Skh4rf/satNOGS/README.md

# satNOGS
Contains the project files of our diploma thesis on the development and implementation of a satellite ground station based on the satNOGS open source hardware platform.
