Skh4rf/satNOGS/doc/documentation-files/Hauptteil.tex

\chapter{Hauptteil}
\section{Antennen}
\subsection{1. Antenne: Dipol}

\subsection{2. Antenne: QFH (Quadrifilar Helical Antenna)}
Die Quadrifilar Helical Antenna ist eine zirkular polarisierte, omnidirektionale Antenne, welche oft für Satellitenanwendungen verwendet wird.\\

Anhand des Abstrahldiagramms lässt sich erkennen, dass diese 

\subsection{3. Antenne: Helix-Antenne}
Direktional, hoher Richtfaktor

\input{Hauptteil-CCSDS}
