Skh4rf/satNOGS/doc/documentation-files/frontbackmatter/abkürzungen+hinweise.tex

\section*{Abkürzungen \& Hinweise}
\begin{singlespace}
	\begin{tabular}{ll}
		DA     & Diplomarbeit \\
		CAD    & Computer-aided design \\
		SI     & Internationales Einheitensystem \\
		CCW	   & counter-clockwise \\
		CW     & clockwise \\
		ADC	   & Analog-Digital-Converter \\
		GPIO   & General-Purpose Input Output \\
		PCB	   & Printed Circuit Board \\
		DC     & Direct Current \\
		LNA    & Low Noise Amplifier \\
		Schuko & Schutzkontakt \\
		LED	   & Light Emitting Diodes \\
		SDR    & Software Defined Radio \\
		SSH    & Secure Shell oder auch Secure Socket Shell \\
		API    & Application Programming Interface \\
		HTL    & Höhere technische Bundeslehr- und Versuchsanstalt \\
		ID     & Identifier \\
		QHA    & Quadrifilare Helixantenne \\
		UV     & Ultraviolettstrahlung \\
		PVC    & Polyvinylchlorid \\
		UTC    & Universal Time Coordinated \\
		TU     & Technische Universität \\
		VGA    & Variable Gain Adjustment \\
		LEO:   & Low-Earth-Orbit \\
		AHS:   & Allgemeinbildende Höhere Schule \\
		BHS:   & Berufsbildende Höhere Schule \\
	\end{tabular}
\end{singlespace}

\pagebreak
