Skh4rf/satNOGS/doc/documentation-files/frontbackmatter/bibliography.tex

\chapter{Literaturverzeichnis}
\vspace{1cm}

\printbibliography[heading=none]
