Skh4rf/satNOGS/doc/documentation-files/frontbackmatter/documentation-de.tex

\addcontentsline{toc}{section}{Diplomarbeit Dokumentation}
\section *{Diplomarbeit Dokumentation}

\begin{tabular}{@{}p{5cm}p{8cm}}
	Name der Verfasser & Ritter Gabriel, Metzler Jakob \\ & \\
	
	Jahrgang ~\textbar~ Schuljahr & 5AHEL ~\textbar~ 2023/24\\ & \\
	
	Thema der Diplomarbeit & Empfangsstation für globales Satellitenbodenstationsnetzwerk SatNOGS \\ & \\
	
	Kooperationspartner & TU Wien Space Team \cite{noauthor_sts1_nodate} \\ & \\
	
	Aufgabenstellung & Ziel der Diplomarbeit ist das Errichten einer Empfangsstation für den Empfang von Daten wissenschaftlicher Satelliten, sowie die dafür notwendige Konstruktion zweier Antennen. \\ & \\
\end{tabular}

\pagebreak

\subsection *{Individuelle Themenstellung im Rahmen des Gesamtprojektes}
\begin{tabular}{@{}p{5cm}p{8cm}}
	
	Ritter Gabriel & Es soll die für das Verständnis der Diplomarbeit benötigte Antennentheorie dokumentiert werden. Es soll ein Helix-Antennenarray mit vier Elementen berechnet, konstruiert und real aufgebaut werden. \\ & \\
	
	Metzler Jakob & Entwicklung, Konstruktion und Aufbau einer quadrifilaren Helixantennen, der Empfangsstation, der Rotor-Steuerung für die Nachführung des Helix-Antennenarrays und die Durchführung des Projektmanagements.  \\ & \\
	
	Realisierung & Realisiert an einer im Rahmen der Diplomarbeit entwickelten Empfangsstation mithilfe des SatNOGS-Netzwerkes \cite{noauthor_satnogshomepage_nodate}. \\ & \\
	
	Ergebnisse & Empfang von Daten wissenschaftlicher Satelliten.\\ & \\
	
	Einsichtnahmen & Archiv der HTL Rankweil, \newline www.diplomarbeiten.berufsbildendeschulen.at \\
\end{tabular}
