Skh4rf/satNOGS/doc/documentation-files/mainmatter/introduction.tex

\chapter{Einführung}

\label{chap:Einführung}
In diesem Kapitel werden die theoretischen Grundlagen der Antennen-und Leitertheorie gelegt sowie das SatNOGS Netzwerk näher erläutert.

\input{mainmatter/Theory/satnogs.tex}
\input{mainmatter/Theory/antenna-theory.tex}
\input{mainmatter/Theory/qha-theory.tex}
\input{mainmatter/Theory/helix-theory.tex}
