Skh4rf/satNOGS/doc/documentation-files/frontbackmatter/quotes.tex

\vspace*{4cm}

\begin{figure}[H]
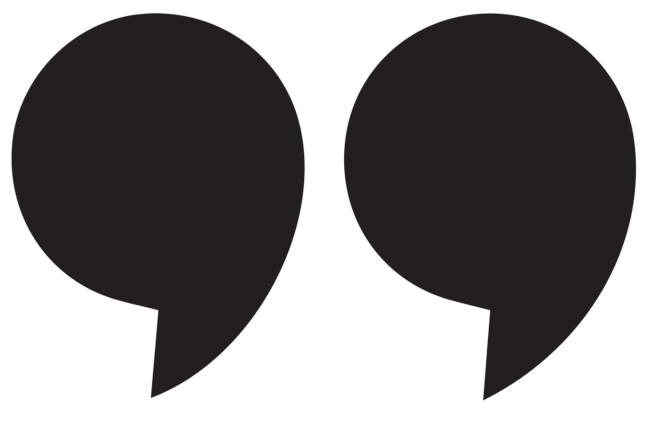
[picture p68: doc/documentation-files/figures/upper-quote-marks.png]
	
\end{figure}

\textit{$"$In der Welt der drahtlosen Kommunikation sind Antennen die Stimme, die ohne Worte spricht, aber dennoch eine universelle Sprache vermittelt."} \\

\rightline{Unbekannt}
\vspace{2cm}

\textit{"Von Anfang an übertraf Maxwells Theorie alle anderen an Eleganz und an der Vielzahl der Beziehungen zwischen den verschiedenen Phänomenen, die sie einschloss."}\\

\rightline{Heinrich Hertz}
\vspace{1cm}

\begin{figure}[H]
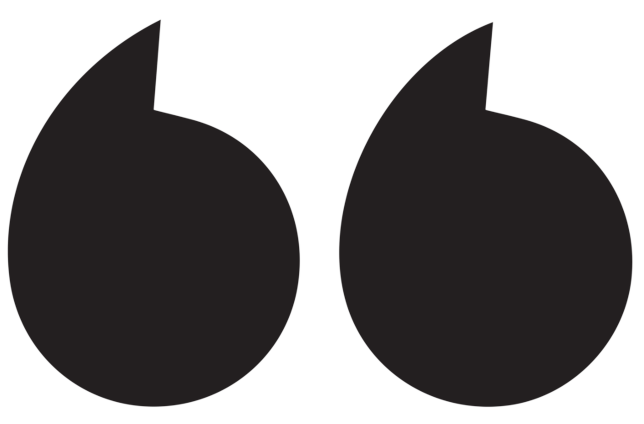
[picture p69: doc/documentation-files/figures/lower-quote-marks.png]
	
\end{figure}
