Skh4rf/satNOGS/doc/general-files/Ergebnisse der Anpassung.docx

# Antenne 3:

## SWR: 1.14

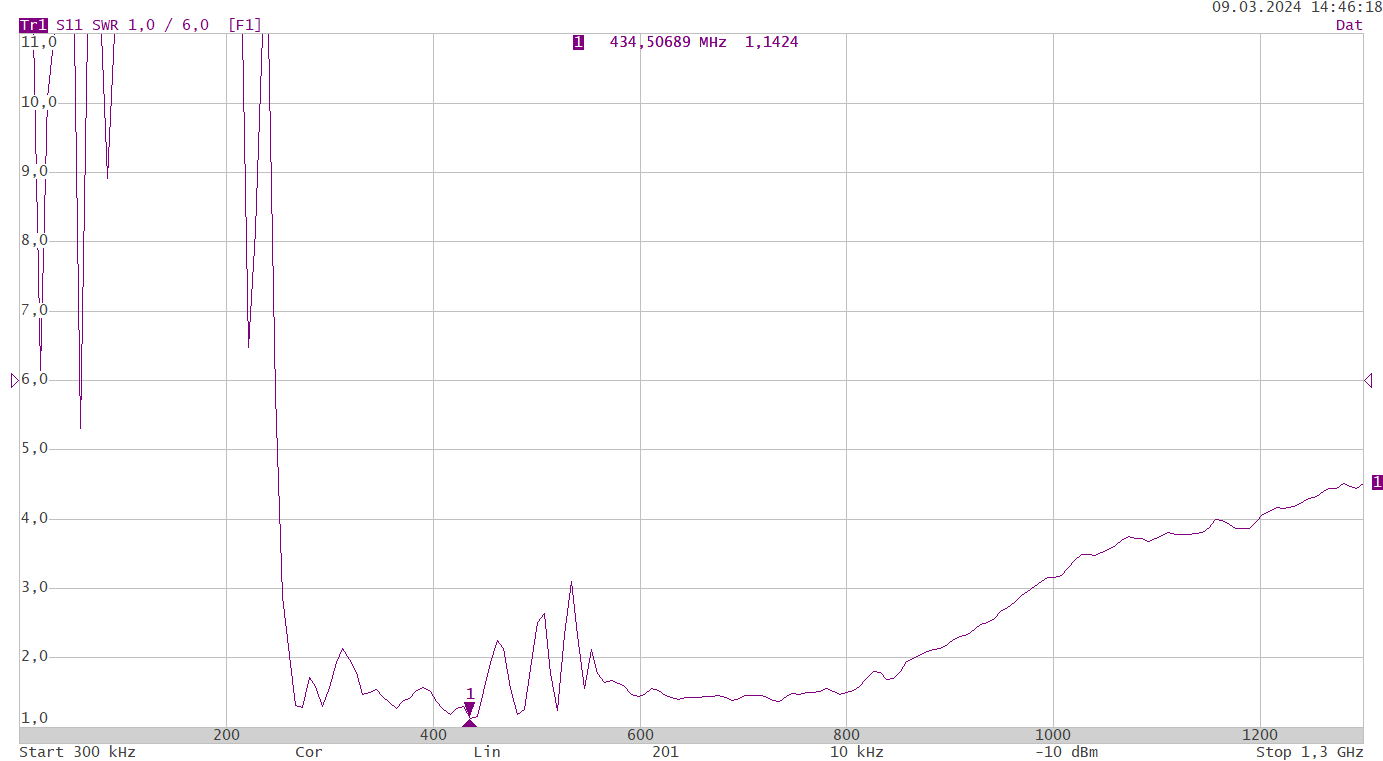
[picture p76: figure]

## S11: -24,6dB

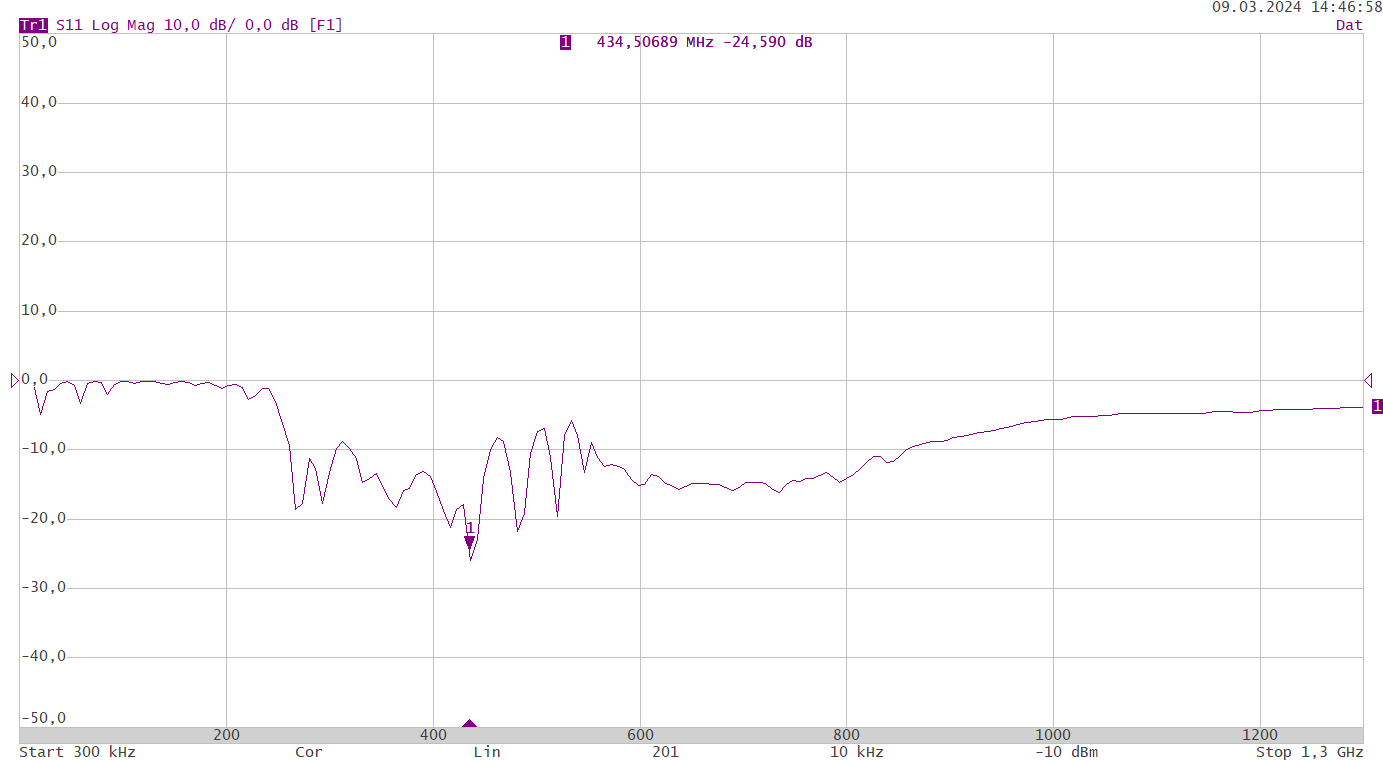
[picture p77: figure]

### Smith: 47, j*5,3Ohm

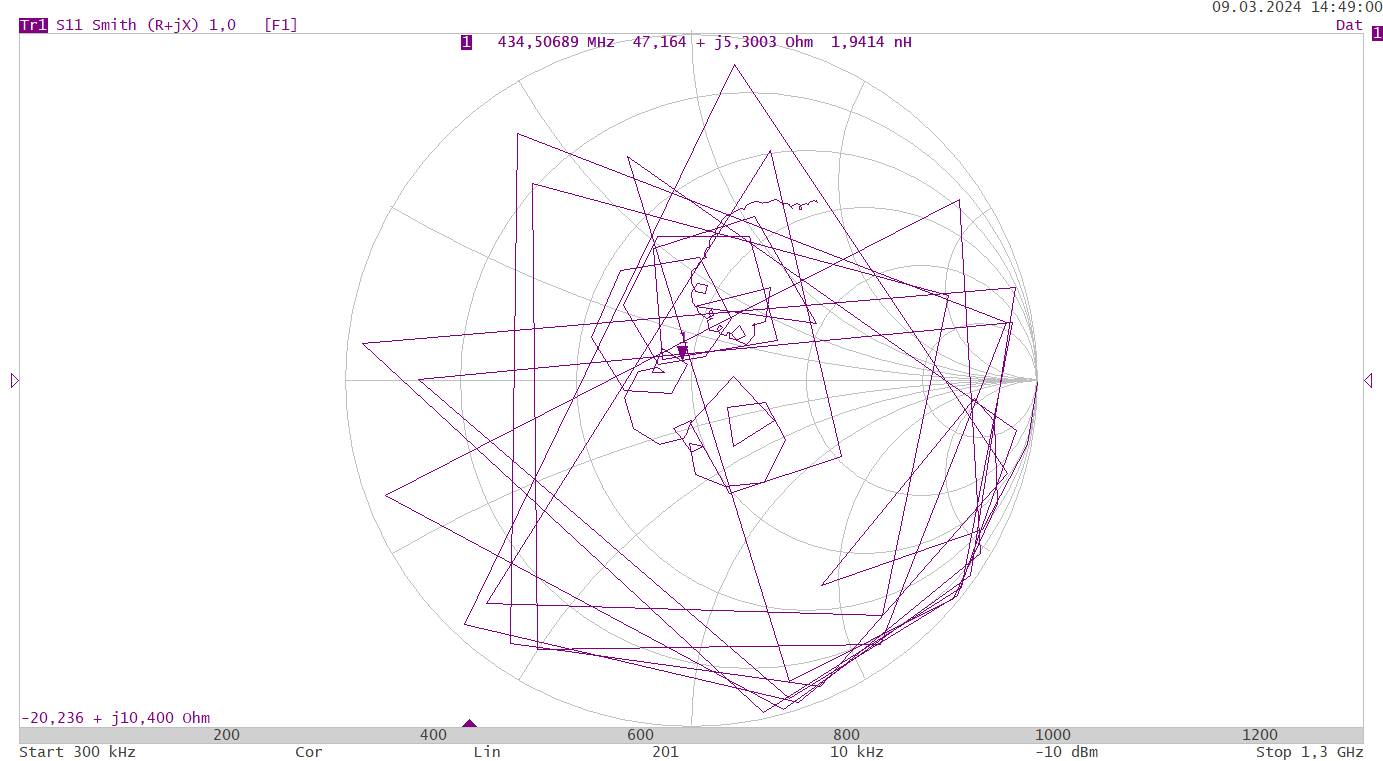
[picture p78: figure]

## Antenne 1

### S11: -21.5dB

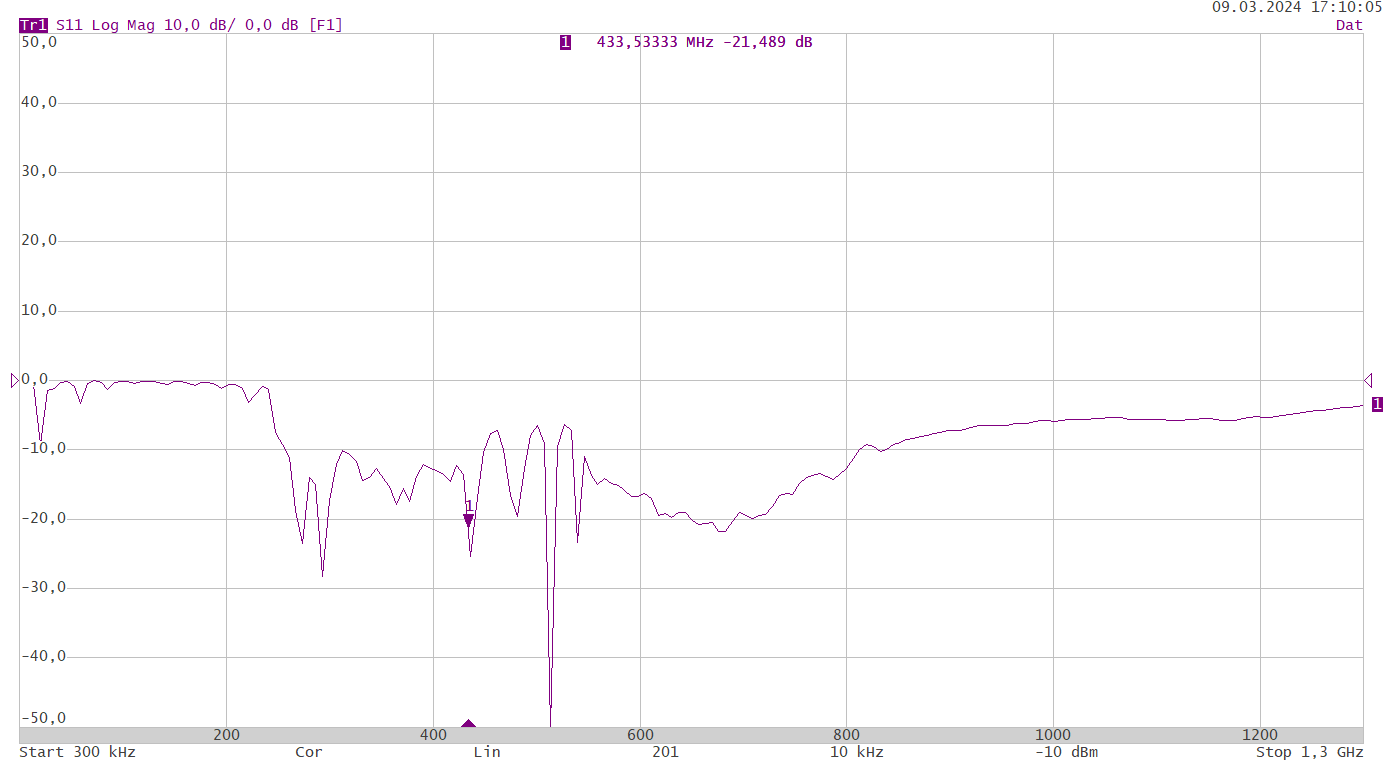
[picture p79: figure]

### SWR: 1.25

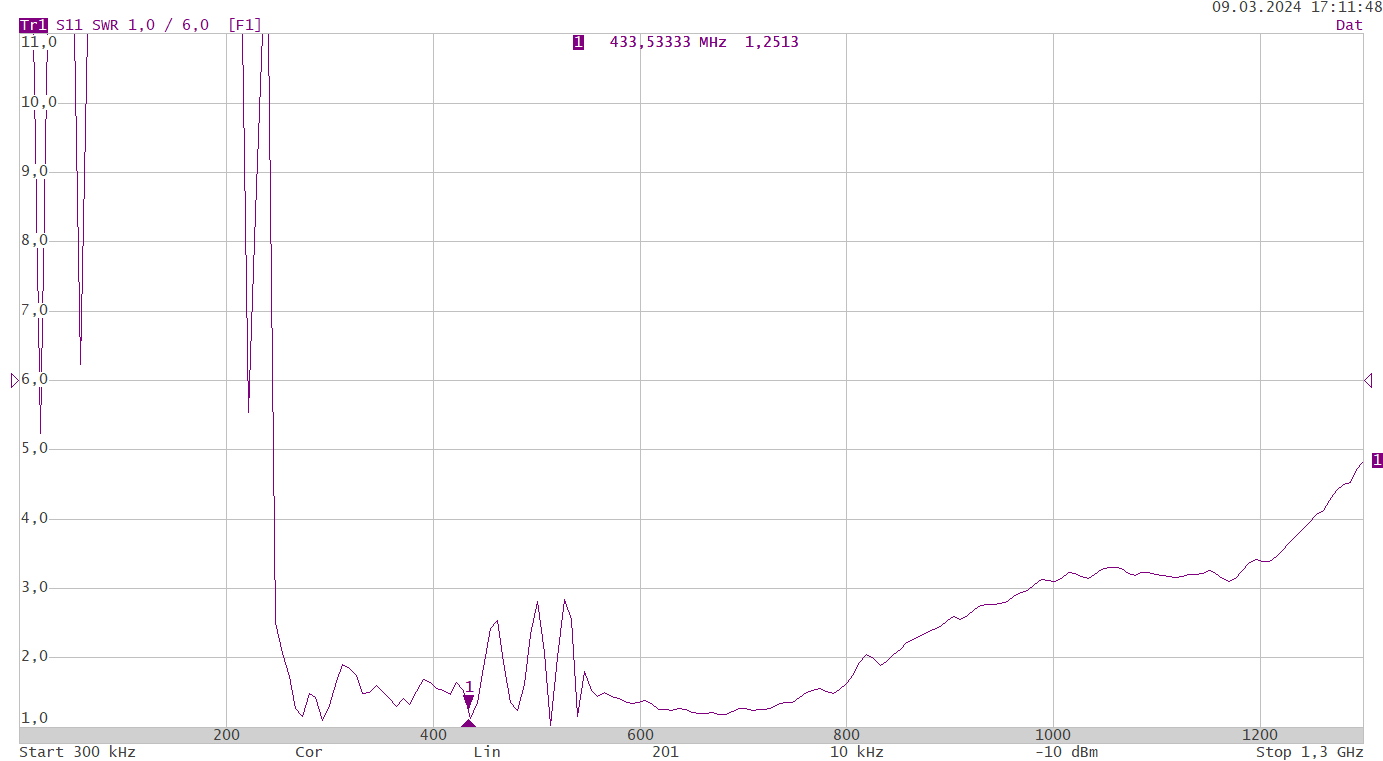
[picture p80: figure]

### Smith: 47.57 + j*10.031Ohm

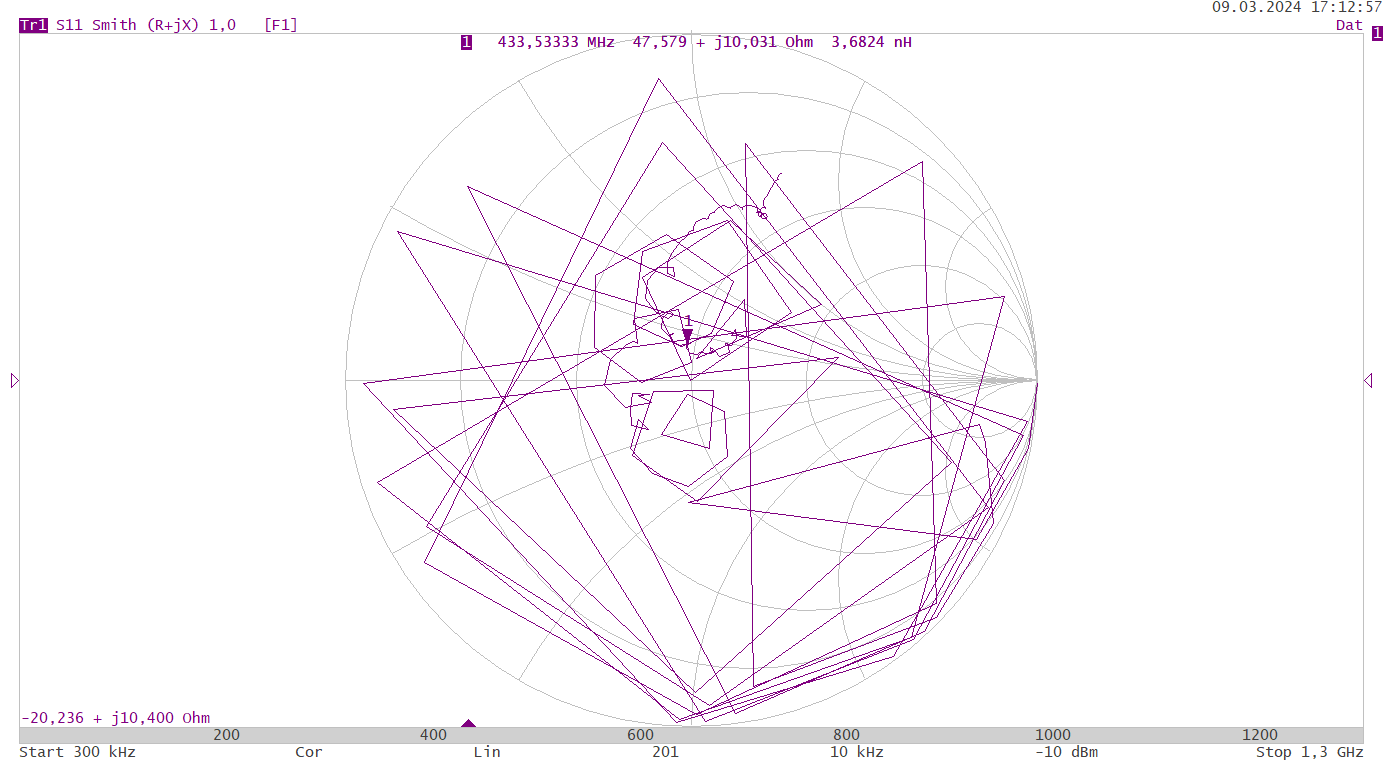
[picture p81: figure]

## Antenne 4

### SWR: 1.1

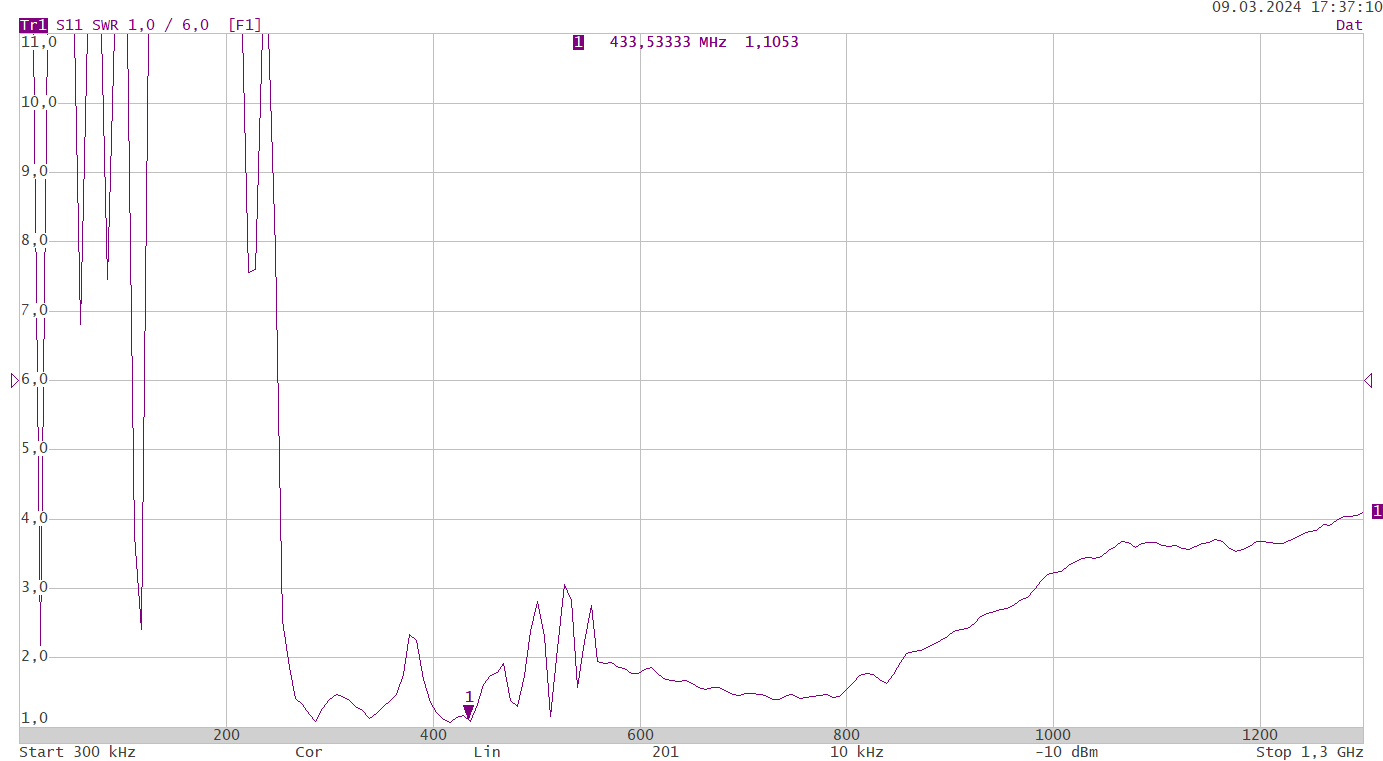
[picture p82: figure]

### S11: -26.7dB

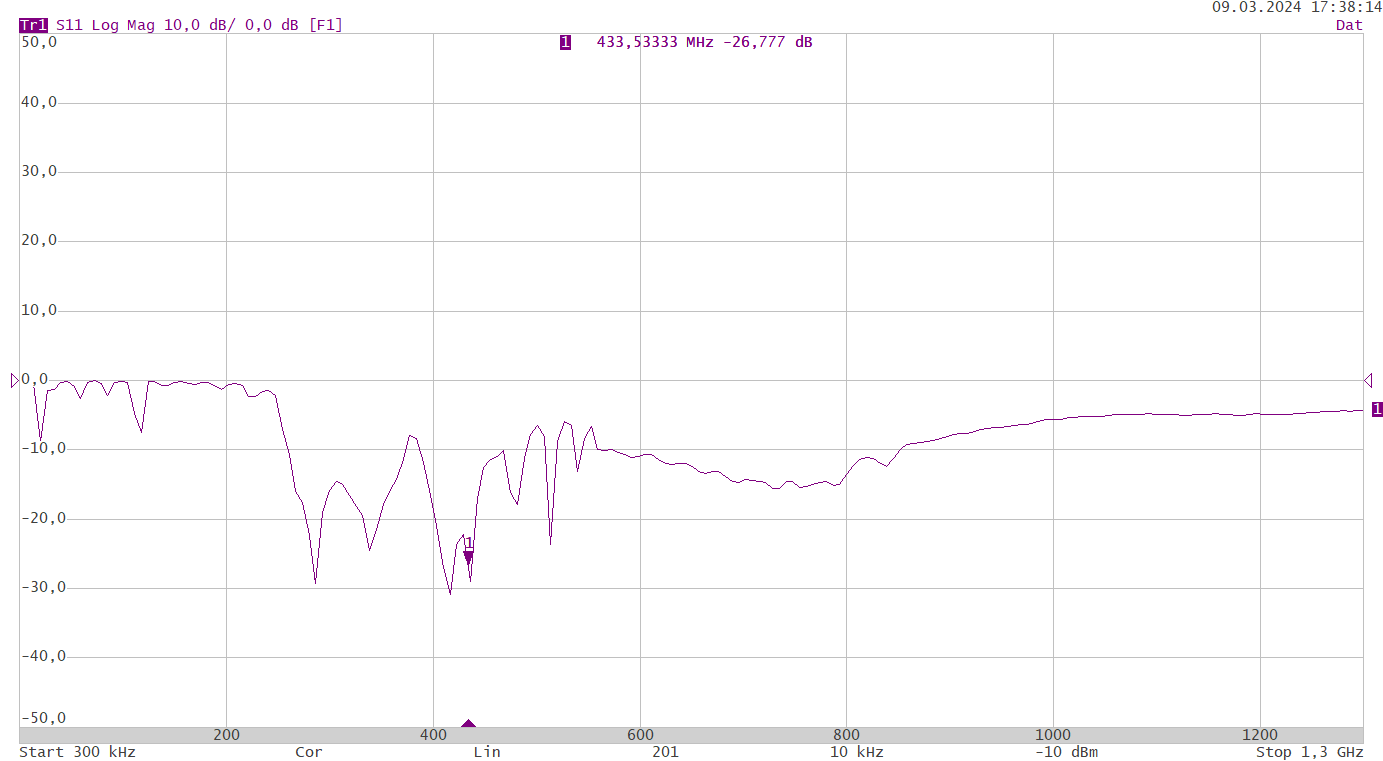
[picture p83: figure]

### Smith: 46 + 3.3Ohm

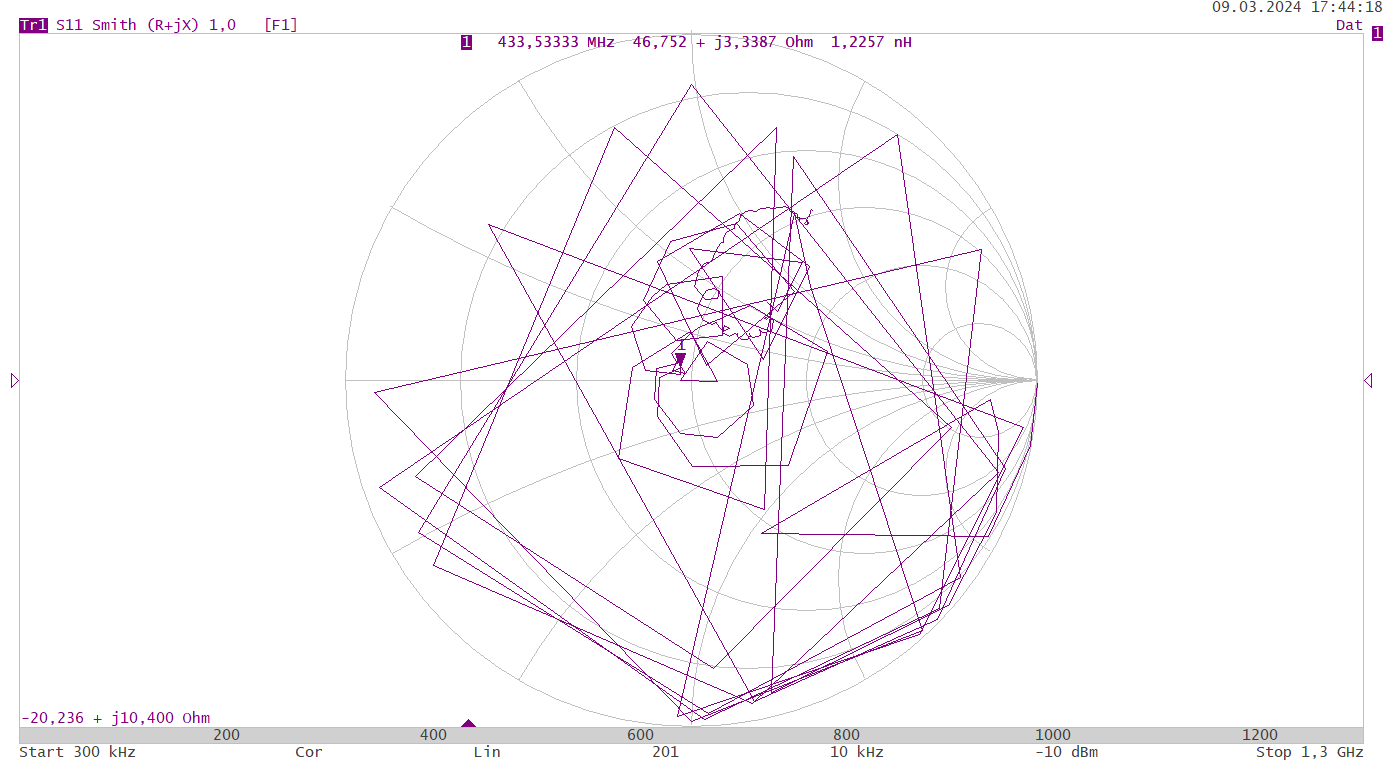
[picture p84: figure]
