Skh4rf/satNOGS/doc/general-files/Sts1PddSystemArchitecture_4.2.pdf

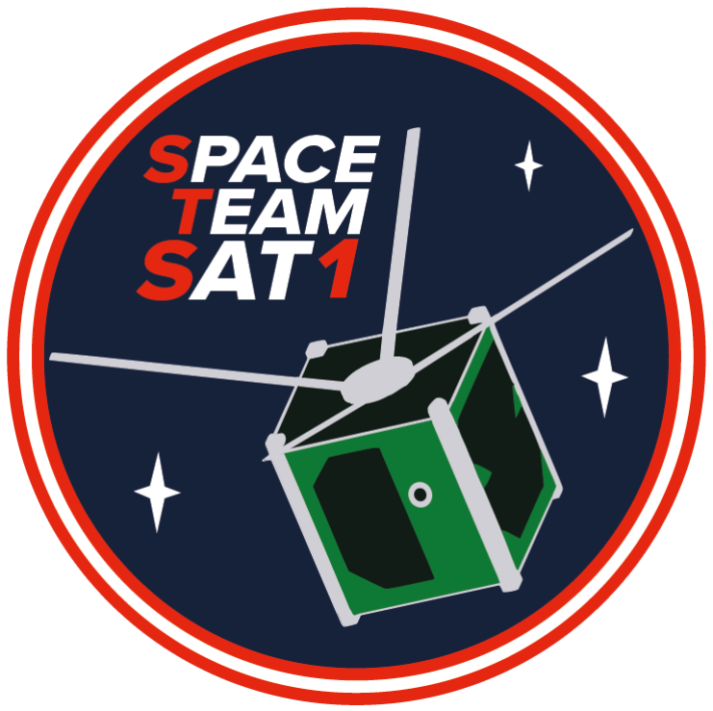
[picture p91: figure]

# SpaceTeamSat1 Preliminary Design Document System Architecture

03.04.2023

### Version 4.2

# Revision History

Revision | Date | Author(s) | Description
1.0 | 27.09.2020 | SpaceTeamSat1 | First draft: internal PDR
2.0 | 10.10.2020 | SpaceTeamSat1 | Implementations after internal PDR. Version sent to external reviewer.
2.1 | 17.10.2020 | SpaceTeamSat1 | Implementations before external PDR. EDU µC concept finished (but old EDU Reqs.). OBC not finished.
3.0 | 20.01.2021 | SpaceTeamSat1 | New mission design → Raspberry Pi approach.
3.1 | 07.02.2021 | SpaceTeamSat1 | Minor changes after PDR I: System Architecture.
4.0 | 21.08.2021 | SpaceTeamSat1 | Rework document in accordance to “Dataflow Game”.
4.1 | 14.04.2022 | SpaceTeamSat1 | Added system requirement 9.
4.2 | 03.04.2023 | SpaceTeamSat1 | Modify requirements 3.1, 5.3, 7.1, 7.2, 10.5 and 11.3 to fit with V1.0 of STS1 PDD: COBC SW. Improve citations.

ii

# Review History

The Preliminary Design Review (PDR) consists of two parts: First, this document itself and second, a review meeting in which the topics are discussed in person. In the following table the invited reviewers are listed. Additionally, it is stated if feedback to the document was received (DOC) as well as if the person participated in the PDR meeting (PDR).
Time and place of PDR: 28.01.2021 19:00 online
Contribution | Reviewer | Email | Justification
Current measurement is not use-ful. Always test like the CubeSat is in space. Antenna deployment shall not lead to a deadlock. | Dominik Kohl | dominik.kohl@schiebel.net | Pegasus/former TUST president
Prioritize on the first tasks. Al-ways have two firmware images on the CubeSat. | Lars Mehnen | lars.mehnen@technikum-wien.at | SSETI Ex-press/RF special-ist

iii

# Authors

Contribution | Name | Email
Project lead, COBC | Raphael Böckle | raphael.boeckle@spaceteam.at
Co-project lead, System Architecture | David Wagner | david.wagner@spaceteam.at
System Architecture, COBC | Jakob Riepler | jakob.riepler@spaceteam.at
System Architecture, COBC | Thomas Hirschbüchler | thomas.hirschbuechler@spaceteam.at
System Architecture | Patrick Kappl | patrick.kappl@spaceteam.at
System Architecture | Daniel Schloms | daniel.schloms@spaceteam.at
System Architecture | Paul Schmitt | paul.schmitt@spaceteam.at
EPS | David Freismuth | david.freismuth@spaceteam.at
EPS | Nikolas Thiel | nikolas.thiel@spaceteam.at
EDU | Jan Pac | jan.pac@spaceteam.at

iv

# Contents

1. Introduction | 1
2. System Requirements | 4
3. System Architecture | 12
A. Appendix | 34
Bibliography | 39

v

# List of Acronyms

1U | One-Unit CubeSat (10 × 10 × 10 cm³ and max. 1.33 kg)
ACK | Acknowledgment (signal)
ADCS | Attitude Determination and Control System
AHS | Allgemeinbildende Höhere Schule
ANT | Antenna System
AX.25 | A data link layer protocol
BHS | Berufsbildende Höhere Schule
CAM | Camera module
CCSDS A file transfer protocol
CDR | Critical Design Review
COM | Communication module
COTS | Commercial Off-The-Shelf
COBC | Communication Module and On-board Computer
CSI | Camera Serial Interface
DS | Deployment Switch
DT | Deployment Timer
EDU | Education module
eMMC | Embedded MultiMediaCard
EPS | Electrical Power System
ESA | European Space Agency
ESERO European Space Education
| Resource Office[1]
FEC | Forward Error Correction
FFG | Österreichische Forschungsförderungsgesellschaft (Austrian Research Promotion Agency) [2]
FRAM | Ferroelectric Random Access Memory
FRR | Flight Readiness Review
FX.25 | Protocol extension to AX.25
FYS | Fly Your Satellite! programme of ESA [3]
GNSS | Global Navigation Satellite System
GS | Ground Station
HAF | High-altitude flight
ISS | International Space Station
LEO | Low Earth Orbit
MCU | Microcontroller Unit
MOSFET Metal Oxide Semiconductor Field
| Effect Transistor
MPPT | Maximum Power Point Tracking
OBC | On-Board Computer
PCB | Printed Circuit Board
PD | Preliminary Design
PDR | Preliminary Design Review
SC | Solar Cells
RBF | Remove Before Flight pin
RF | Radio Frequency
RTC | Real-Time Clock
SatNOGS Satellite Networked Open Ground
| Station
SRAM | Static Random Access Memory
STS1 | SpaceTeamSat1 – name of CubeSat mission and CubeSat platform
SW | Software
UCI | Umbilical Cord Interface

vi

# 1. Introduction

This document serves as the system architecture Preliminary Design (PD) for the CubeSat mission SpaceTeamSat1 (STS1), which is designed by the TU Wien Space Team [4]. It describes the system architecture and presents the basic concepts of the key components of the CubeSat mission. From a functional point of view, the Electrical Power System (EPS) and the Communication Module and On-board Computer (COBC) are the most important components of the CubeSat. Therefore, the main focus lies on these components as well as the dataflow of the complete CubeSat mission – including the Ground Station (GS) infrastructure. More details regarding the dataflow were developed within the Dataflow Game, which is separately documented [5]. Since this document only serves as a PD for the system architecture, any solutions are subject to change once the design matures and test data is acquired. It needs to be considered that this CubeSat mission is divided into various milestones and that the space flight part is not defined in detail yet:
- Definition of System Architecture (PDR I)
- Definition of subsystems (EPS, COBC and EDU) (individual PDRs)
- Development of subsystems (individual Critical Design Reviews (CDRs))
- Definition of High-altitude flight (HAF) challenges
- HAF to verify CubeSat platform (Flight Readiness Review (FRR))
- Implementation of insights of high-altitude flight
- Preparation of the CubeSat mission for space flight
In Section 1.1 and Section 1.2, the mission statement and the main objectives, on which the CubeSat mission is based on, are presented. In Chapter 2, the top high-level requirements and most relevant system requirements of the mission are stated and described in more detail. These requirements are based on the mission objectives and build the base for the mission concept and the design of the CubeSat. In Chapter 3, an overview of the CubeSat system architecture and its subsystems is given. First, the dataflow from the Earth-based infrastructure to the CubeSat is evaluated for up- and down-link. This information is then used to derive the basic concepts of the subsystems. Note that a profound analysis of the dataflow was extracted by executing the Dataflow Game, which is documented in Ref. [5].

1. Introduction
Main properties of the CubeSat mission SpaceTeamSat1
- Mission and CubeSat name: SpaceTeamSat1 (short: STS1)
- 1U (10 × 10 × 10 cm³ and max. 1.33 kg) CubeSat platform
- STS1 shall operate in Low Earth Orbit (LEO) (350 km–500 km)
- STS1 shall be a lab for students of AHS and BHS
- STS1 shall enable access to the amateur radio community for students
- Educational mission objective:
– Student teams compete in a space-related coding competition.
– Python code which runs on the educational payload of the CubeSat (Raspberry Pi) platform. – Many possible software scenarios are possible. Therefore, various sensors are available for read-out.
– Gathered data is handed over to participating students for further evaluation of the received data.
– Student teams shall present their acquired results and therefore gain important insights into space-related technologies.
- The education module (EDU) with its sensors is the educational payload of the CubeSat:
– Temperature sensor
– Magnetometers
– Accelerometers
– Gyroscopes
– Dosimeter
– GNSS module
– Strain gauges
– Brightness sensors
– Cameras

1. Introduction

## 1.1. Mission Statement

Excitement and enthusiasm for engineering and science are important features of a progressive society. They are a consequence of the urge to explore the universe, which is deeply rooted in human nature. Nowadays, space technologies enable humankind to satisfy this urge and reach out further than ever before. However, even though space technologies are deeply ingrained within pop culture and organizations like NASA, ESA, or SpaceX successfully conduct widely publicized missions, a hands-on approach to these topics seems out of reach for most people. Therefore, we want to provide an entry point into space technologies for students of secondary schools by giving them the opportunity to run their own software experiments on our self-developed CubeSat platform, which is “Made in Austria”. We hope that this will broaden their educational horizon and thus inspire the next generation of space and science enthusiasts.

## 1.2. Mission Objectives

The mission objectives build the base for any space-related project as they give reasons why certain tasks need to be executed in space, which are mostly complex and costly. They state the relevance of the mission as well as its importance and allow the derivation of requirements and, later on, the design and operation of the CubeSat. The mission objectives for STS1 are separated into primary and secondary mission objectives, which indicate the relevance of the individual objectives.
Primary objectives:
1. To develop and build a working satellite
2. To operate our self-developed CubeSat
3. To give students a platform to run their self-developed software on a CubeSat
4. To inspire students to be part of a space project
Secondary objectives:
5. To take an image from space
6. To make the gathered data and insights available to the public and especially other CubeSat missions

# 2. System Requirements

The mission objectives build the base of any CubeSat mission, as described in Chapter 1, and are therefore used for the definition of the system requirements. The presented system requirements in this PD are high-level requirements with the goal of determining necessary subsystems which build the base of the CubeSat platform. All requirements shall be measurable and verifiable. Furthermore, requirements shall answer the “Why?” by specifying the “What?” and not addressing the “How?”. For nomenclature reasons, we use the same wording to formulate requirements as in the Fly Your Satellite! (FYS) design specification [3] by ESA:
- The word “shall” is used to express requirements that have to be met.
- The word “should” is used to express recommendations.
- The word “may” is used to express permissions.
Furthermore, we use the following to specify where a requirement is fulfilled:
- The quote “Fulfilled by” is used to express that a requirement is fulfilled by other sub requirements.
- The quote “Fulfilled in” is used to express that a requirement is fulfilled in a section within the same document.
The following mission requirements are derived from the mission objectives:
1 The CubeSat shall have a system to generate power and distribute it to all other subsystems. Note: It shall be possible that the CubeSat can be powered solely by the solar cells, solely by the batteries, respectively both. The power distribution is only active in the operation phase of the CubeSat mission.
Fulfilled: By 1.1, 1.2, 1.3, 1.4
2 The CubeSat shall automatically charge the batteries as long as there is excess energy available. Note: Excess energy is the difference between the power provided by the solar cells and the power needed to power the subsystems of the CubeSat.
Fulfilled: By 2.1
3 The CubeSat shall automatically transmit a beacon at least once every 30 seconds.
Note: Obviously, this can only be done if enough power is provided.
Fulfilled: By 3.1
4 The CubeSat shall be able to receive commands, when not transmitting data.
Note: The CubeSat shall portion large amounts of data before transmission. After a certain amount of transmitted data the CubeSat has a transmission dead-time, which can be used to receive commands.
Fulfilled: By 4.1

2. System Requirements
5 The CubeSat shall have a compact and interchangeable electronic stack.
Note: This should allow for easy interchangeability of different subsystems or a different payload in a possible future scenario.
Fulfilled: By 5.1, 5.2, 5.3, 5.4, 5.5
6 The CubeSat shall operate according to a predefined state chart.
Note: Special attention needs to be paid for the launch phase.
7 The CubeSat shall have a single master, which is the COBC.
Note: The master is the only subsystem that is able to initiate active communication with other subsystems on the CubeSat platform.
Fulfilled: By 7.1, 7.2
8 The primary ground station shall be able to send data and commands to the CubeSat. The primary ground station shall also be able to receive data from the CubeSat.
Note: The communication capabilities shall be verified by a HAF, where the CubeSat shall be placed in a weather balloon. Additional GSs should be able to receive data from the CubeSat. Fulfilled: By 8.1, 8.2, 8.3, 8.4, 8.5, 8.6
9 The EDU module shall be operable for at least 10 % of the mission duration. The maximum continuous uptime of the EDU shall be at least 3 h.
Fulfilled: By 9.1
10 The CubeSat shall be able to execute Python code, written by high school students. Fulfilled: By 10.1, 10.2, 10.3, 10.4, 10.5, 10.6, 10.7, 10.8, 10.9
11 STS1 shall comply with the FYS Requirements [3] where it makes sense.
Note: Where it makes sense and where it does not make sense will be noted in the lower level requirements.
Fulfilled: By 11.1, 11.2, 11.3 11.4

2. System Requirements
The following system requirements are deduced from mission requirement 1:
1.1 STS1 shall power all systems, via the CSBI, if enough energy comes from the SCs and once it reached the operational phase.
Fulfilled: By ?? [6]
1.2 STS1 shall have a mechanism in place to power all systems, via the CSBI, if there is enough energy in the batteries and once it reached the operational phase.
Fulfilled: By ?? [6]
1.3 Each Subsystem of STS1 shall be powered, via the CSBI, by a voltage level between 5 V and
8.4 V.
Note: This means that each subsystem is responsible for generating its own voltage levels, e.g. constant 5 V or 3.3 V.
Fulfilled: By 1.3.COBC.1 [7], 1.3.EPS.9 [6], 1.3.EDU.1 [8]
1.4 The power generating subsystem of STS1 shall provide a voltage level with a ripple lower than
100 mV.
Note: This means that each subsystem is responsible for generating its own voltage levels, e.g. constant 5 V or 3.3 V
Fulfilled: By 1.4.COBC.1 [7], 1.4.EPS.10 [6], 1.4.EDU.1 [8]
The following system requirements are deduced from mission requirement 2:
2.1 The CubeSat shall automatically recharge the batteries when there is spare energy. (TODO: make note)
Fulfilled: By ?? [6]
The following system requirements are deduced from mission requirement 3:
3.1 The CubeSat shall automatically send out a beacon at least once every 30 seconds, with a tolerance of ±5 s.
Note: Only if it has power.
Fulfilled: By 3.1.COBC.1 [7], 3.1.COBC_SW.1 [9]
The following system requirements are deduced from mission requirement 4:
4.1 The CubeSat shall always be able to receive a command in an acceptable amount of send time. Note: This means that the continuous sending is not allowed to take longer than about ten seconds. After this sending, the CubeSat must switch to a receive state where it waits for at least one second to receive a command.
Fulfilled: By 4.1.COBC_SW.1 [9]
The following system requirements are deduced from mission requirement 5:
5.1 The CubeSat shall have two bus connectors, which ensure communication between all the subsystems.
Note: Those bus connectors shall be located on opposite sides of the PCBs. This should allow for easier electric wiring on the PCBs.
Fulfilled: By 5.1.COBC.1 [7], ?? [6], 5.1.EDU.1 [8]

2. System Requirements
5.2 The CubeSat shall have a reusable satellite framework.
Note: This means that the hardware of the subsystems COM, EPS, and OBC shall work independently of the science payload (here: EDU module). However, software dependency is not prohibited.
Fulfilled: By 5.2.COBC.1 to 5.2.COBC.4 [7], ?? [6]
5.3 No subsystem that needs the CSBI X+ shall be located above the science payload PCB(s) (here: EDU module) in the electronic stack.
Fulfilled: In 3.1
5.4 The CubeSat shall have all subsystem PCBs which are not specifically needed for the science payload (here: EDU module) grouped together in the electronic stack.
Note: This does not include the possible side PCBs which are located on each side of STS1. Fulfilled: In ??
5.5 The CubeSat shall have an antenna release mechanism. The mechanism shall be controlled via the master and powered via the EPS.
Fulfilled: By 5.5.COBC.1 [7], ?? [6]
The following system requirements are deduced from mission requirement 7:
7.1 The CubeSat shall be able to deactivate all systems not necessary for communication once a command is received to do so.
Note: All subsystems for communication are EPS and COBC. (TODO: Communication –> GS to COM; Downstream/Upstream)
Fulfilled: In 3.1 and by 7.1.COBC_SW.1 to 7.1.COBC_SW.3[9], 7.1.EDU.1 [8]
7.2 The CubeSat should have a central processing unit (here: COBC) which deactivates the EDU, if it is not used in the next couple of minutes.
Fulfilled: In 3.1 and by 7.2.COBC_SW.1 to 7.2.COBC_SW.2[9]
The following system requirements are deduced from mission requirement 8:
8.1 The CubeSat shall be able to receive one full program code at least once every 24 hours. Note: One full program code stands for the maximum possible code size that can be flashed on the EDU µC, which is 1 MiB.
Fulfilled: By 8.1.COBC_SW.1 [9]
8.2 The GS shall be able to automatically send operation commands to the CubeSat.
Note: “Automatically” means that a program runs on a PC or µC.
Fulfilled: In ??
8.3 The GS shall be able to automatically upload data to the CubeSat.
Note: “Automatically” means that a program runs on a PC/µC. Fulfilled: In ??

2. System Requirements
8.4 The GS shall be able to automatically download data from the CubeSat and store it locally within the GS infrastructure.
Note: “Automatically” means that a program runs on a PC or µC.
Fulfilled: In ??
8.5 The GS shall be able to run autonomously for at least seven days.
Note: “Autonomously” means that it does not require any human action.
Fulfilled: In ??
8.6 STS1 shall be able to download the entire generated data of one student code at least once every 48 hours.
Note: The entire generated data is equivalent to the maximum data one student code generates during its whole run time, this is equivalent to the memory size in which the student code stores its data. This restricts the maximum amount of data and the number of photos a student code can produce, which is 1 MiB.
Fulfilled: In ?? and by 8.6.COBC.1 [7], ?? [6], 8.6.COBC_SW.1 [9]
The following system requirements are deduced from mission requirement 9:
9.1 The CubeSat shall have a higher average power input, measured over one full orbiting cycle, than the maximum average power drain from all the subsystems, also measured over one full orbiting cycle.
Note: For the rotation the worst expected rotation shall be used, after the detumbling phase. Maximum average refers to the maximum power drain a subsystem can have measured over one full orbiting cycle, e.g., the GS is below the CubeSat in the used cycle for the power drain calculation for the COM module. The detumbling phase ends when the change of rotation of the CubeSat falls below 1 %, measured over one orbiting cycle.
Fulfilled: By ?? [6]
The following system requirements are deduced from mission requirement 10:
10.1 The CubeSat shall have several sensors integrated within the CubeSat.
Note: This should attract more attention and make the mission more interesting for the students to participate in.
Fulfilled: By 10.1.EDU.1 [8]
10.2 The CubeSat shall have multiple cameras which are suitable for an operation in space.
Note: This shall allow the CubeSat to take images of Earth in all possible orientations. Fulfilled: By 10.2.EDU.1 [8]
10.3 The EDU should be able to recover from a small number of cosmic bit flips. Fulfilled: By ?? [8]
10.4 The EDU shall be able to gracefully handle errors.
Fulfilled: By ?? [8]
Note: Gracefully in this context means, that the system is able to forward recover from a wide range of errors and stay operational. In the worst case it may turn itself off and leave recovery to the COBC.

2. System Requirements
10.5 The EDU shall be controlled by commands from the COBC.
Note: When supplied with power, the EDU shall boot into an operational state and then wait for commands sent by the COBC. Communication follows a strict master–slave relationship between COBC and EDU.
Fulfilled: By 10.5.COBC_SW.1 to 10.5.COBC_SW.3 [9], ?? [8]
10.6 The EDU shall be able to deal with being turned off mid-operation.
Note: The EDU may be turned off any time if power gets low.
Fulfilled: By ?? [8]
10.7 The CubeSat team of the TU Wien Space Team shall be able to verify the student code, which was developed by the students on a Dev-Kit.
Note: This ensures that only fully functional code is executed on the CubeSat platform in Space. The Dev-Kit is a development environment, which contains the same sensors as mounted on the EDU module within the CubeSat. ”Same sensors” does not mean the same physical implementation. On the Dev-Kit, also virtual sensors can be used (e.g. libraries of the individual sensors, which behave equally). The Dev-Kit allows the student teams to develop and test their code on Earth.
Fulfilled: In ??
10.8 The student teams shall be tasked with one main objective, which their proposed code shall fulfill.

Note: By establishing co-operations with acknowledged institutions in Austria (e.g. ESERO) the school outreach is done to advertise the project so that student teams can participate in this space rallye.
Fulfilled: In ??
10.9 The CubeSat shall be in orbit for at least six months which include January 1st and June 30th, not dependent on the year and not dependent on the launch date.
Note: This range is chosen as it includes the second half of a school year in Austria. This allows us to gradually build up the knowledge of the students over the first half of a school year and run the student codes in the second half of the school year.
Fulfilled: In ??
The following system requirements are deduced from mission requirement 11:
11.1 The CubeSat shall comply with the mechanical FYS Requirements [3] where it makes sense. Note: Where it makes sense and where it does not make sense will be noted in the lower level requirements. This system requirements include
a) Physical Requirements,
b) Environmental Requirements
Fulfilled: By 11.1.COBC.1 to 11.1.COBC.2 [7], ?? [6], 11.1.EDU.1 to 11.1.EDU.2 [8]
11.2 The CubeSat shall comply with the electrical FYS Requirements [3] where it makes sense. Note: Where it makes sense and where it does not make sense will be noted in the lower-level requirements. This system requirements include
a) Subsystem Requirements

2. System Requirements
Fulfilled: In ?? and by ?? [6], 11.2.EDU.1 [8]
11.3 The CubeSat shall comply with the software and RF related FYS Requirements [3] where it makes sense.
Note: Where it makes sense and where it does not make sense will be noted in the lower-level requirements.
Fulfilled: By ?? [6], 11.3.COBC_SW.1 to 11.3.COBC_SW.2 [9]
11.4 The STS1 mission shall comply with the mission related FYS Requirements [3] where it makes sense.
Note: Where it makes sense and where it does not make sense will be noted in the lower level requirements. This system requirements include
a) Accessibility,
b) Configuration Control,
c) Operational Requirements,
d) Ground Processing Requirements,
e) Ground Support Equipment,
f) Space Debris Mitigation Requirements,
g) Regulatory Requirements,
h) Safety Requirements
Fulfilled: In ?? and by ?? [6], ?? [8]
See: Nextcloud/Literature/ESA FYS3/6. FYS CubeSat Requirements/FDSv3.0 - Compliance Matrix
- STS1.docx
FYS–subsystem requirements
1. During the operation phase the CubeSat should rotate slow enough, so that the cameras are able to capture sharp images of the Earth while flying over the side which gets sun exposure. Note: Sharp means that the rise distance between two distinct features (e.g. an edge between land and water) on the image shall be < 1 % of the image’s width and height resolution. EDU–subsystem requirements:
1. The evaluated data is processed by the student teams and a presentation is given. This allows to set up a space-themed competition for the participating student teams.
COBC SW–subsystem requirements:
1. The CubeSat shall be able to deactivate all systems not necessary for communication once a corresponding command is received.
Note: Relevant subsystems for communication are the EPS and the COBC.
2. The CubeSat shall be able to re-flash its own main processing unit (here: COBC). This shall be implemented without any instructions needed from the processor which gets re-flashed.
Note: This allows updating the main processing unit if the software gets destroyed in any reversible way, e.g. interference by high-energy particles.
EPS–subsystem requirements:

2. System Requirements
1. The power supply shall be able to power the CubeSat for at least 65 % of a full orbiting cycle without the need of charging, while all the subsystems consume the maximum allowed power. Note: This will provide enough power with a safety factor of roughly two. Maximum allowed power refers to the maximum expected power consumption of each subsystem, e.g., COM module flies over the GS and communicates with the GS as fast as possible.
2. The CubeSat RF design shall either have one RF inhibit and a RF power output no greater than 1.5W at the transmitter antenna’s RF input OR the CubeSat shall have a minimum of two independent RF inhibits [empty citation](CDS 3.3.9) [empty citation](ISO 5.5.6).
Note: An inhibit is considered to be a physical power interrupt device. A control for an inhibit (electrical or software) cannot be counted as an inhibit.
Note: The use of three RF independent inhibits is highly recommended as it may help to ease further discussions with the launch authority.
Note: RF inhibits may be combined with electrical inhibits.
Fulfilled: In ??

# 3. System Architecture

The following chapter discusses the basic concepts of the individual subsystems of STS1, namely the Electrical Power System (EPS), the Communication Module and On-board Computer (COBC) and the Education module (EDU). As the received and transmitted data build the base of the whole CubeSat platform, Section 3.3 describes the dataflow from the ground infrastructure to the CubeSat in more detail. In a next step the EPS – power generation and distribution – is investigated. Therefore, Section 3.4 discusses the conceptual design of the EPS in more detail. In a next step the COBC is presented in Section 3.5. The COBC is the main processing- and scheduling unit of the CubeSat and also handles the RF communication. Finally, Section 3.6 describes the concept of the EDU. This subsystem is the educational payload of the CubeSat mission and therefore executes the software experiments that are provided by the individual student teams. The EDU is equipped with multiple sensors, including two cameras (CAM), to perform various experiments.

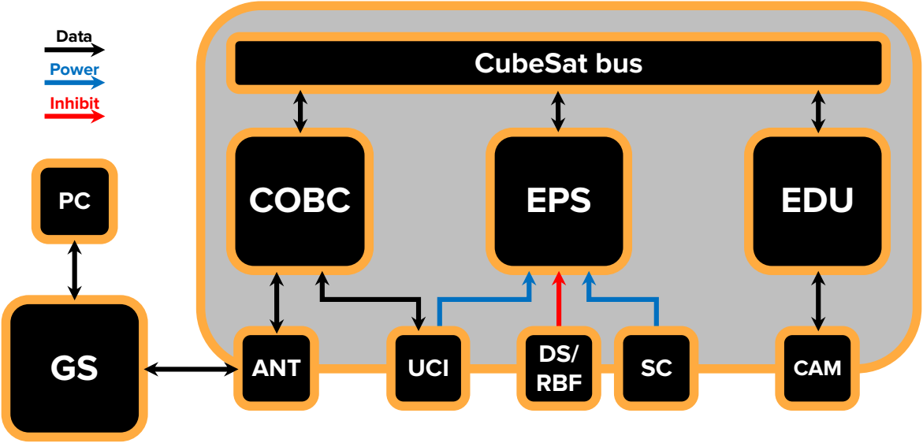
[picture p92: figure]
CubeSat bus; COBC; ANT; EPS; EDU; RBF GS; UCI; CAM; Inhibit; Power; Data

Figure 3.1.: Basic system architecture of STS1. The arrows determine the direction of data- (black), power- (blue) and inhibit-flow (red). Figure 3.1 shows the basic system architecture of the CubeSat and the associated ground infrastructure. The Antenna System (ANT) is used to communicate with the COBC, which contains the RF module for receiving and transmitting data. The Solar Cells (SC) are directly connected to the EPS and are used to harvest electrical energy. The main Ground Station (GS) can be accessed from any PC on Earth via Internet. The Umbilical Cord Interface (UCI) allows us to re-program the COBC and charge batteries, which are operated by the EPS, after assembling the CubeSat. The Deployment Switches (DS) and the Remove-Before-Flight pin (RBF) ensure that the CubeSat is not powered in the safely stored configuration (e.g. in the chassis of the carrier rocket or in the extractor of the International Space Station (ISS)). Within the EDU module, the Camera module (CAM) can receive image acquisition commands.

3. System Architecture

## 3.1. STS1 System Layout

This Chapter is still tbd, currently it contains raw information not polished in any way.
There is only one electronic stack in the CubeSat, which contains all the subsystem PCBs, excluding some special PCBs which need to be assembled to the mechanical structure and excluding the SidePCBs. Starting in positive direction of the Z-axis the stack is ordered as follows: COBC, EPS, EDU, additional PCBs for other sensors.
There is an ”EDU_EN” pin on the CSBI X- which is controlled by the COBC, this pin activates or cuts the power supply for the EDU. There is another pin ”Dosi_EN” which is on the CSBI X-, this pin activates or cuts the power supply for the Dosimeter.

## 3.2. DCDC

The dcdc converter shall convert the battery voltage to a voltage level usable for the electronics. The design of this dcdc converter is shared between the boards and each board that requires voltages other than the unregulated battery bus voltage has its own dcdc converter.

### 3.2.1. Requirements

Since the design is shared between the boards, the converter must handle all the requirements of all boards. The lowest possible battery bus voltage is given as 5V and the output voltage requirements are 5V with 3A output current.

### 3.2.2. Design

The chosen dcdc converter is the MP28167GQ by Monolithic Power Systems. This converter can supply up to 3A and has a fixed output voltage of 5V with a maximum input current of 4A. The converter is a buck boost converter so it can supply 5V even if the bus voltage drops slightly below 5V due to voltage losses in the supply lines.
The design implements a undervoltage lockout which is set to about 3.99V and a startup voltage of about 4.4V, this ensures that the input voltage is in an usable range for the converter to deliver 15W output power, however the EPS is considered to shutdown the systems on such a low bus voltage anyways. A overcurrent protection is also present which is set to 3.56A, this limits the bus and output current in case of a short circuit or other overcurrent fault and ensures that other components would still work if such a condition is present so that the other systems would be able to handle the fault. To handle spurious overvoltage situations, such as electrostatic discharges, a TVS diode is placed in the 5V rail as well as in the input rail of the dcdc converter, to protect the converter itself and also the electronic on the 5V rail. An optional snubber at the input voltage formed with a 1uF MLCC and a 100 milliohms resistor was also added to the design to suppress supply voltage ringing. This snubber is not populated in the current design, but could be populated if needed.

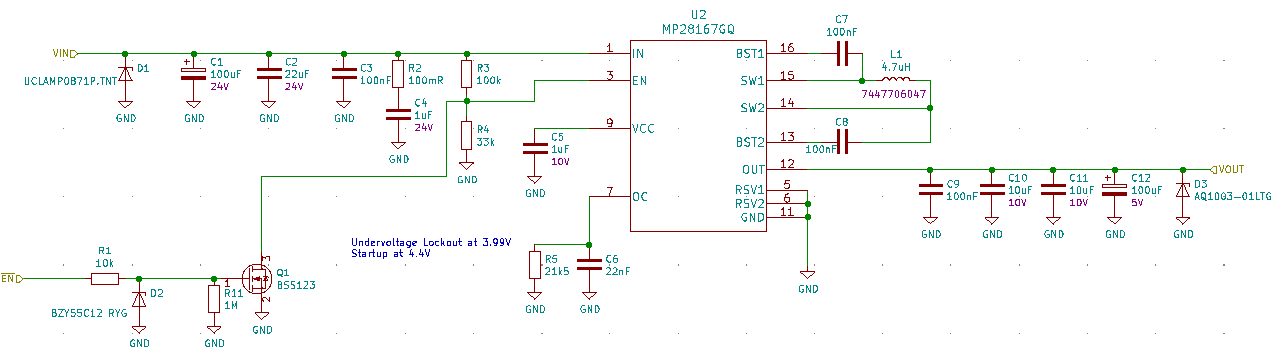
[picture p93: figure]

Figure 3.2.: Schematic of the dcdc converter

## 3.3. Dataflow

This section discusses the flow of data and commands from the ground infrastructure to the CubeSat and its internal subsystems. The main GS with the amateur radio call sign OE3HMW (operated by Dr. Lars Mehnen) is primarily used to communicate with STS1. On the GS runs CouchDB [10], which buffers all commands and data until the CubeSat can be reached and the relevant data can be transmitted to the CubeSat respectively received. Furthermore, the GS uses Gpredict [11] to determine the timeframe when a RF communication link to the CubeSat can be established.
The following subsections discuss the basic deliberations of the dataflow processes. It needs to be considered that this approach is a preliminary design and needs iterations as further definitions of the hardware and software design are done. Therefore, a dataflow scenario game will be implemented, which allows us to simulate the dataflow by a pen-and-paper game procedure. Such a tool helps us to investigate any circumstances at an early stage of the development of the mission. Note that the following subsections present a starting point for these considerations and further definitions will be implemented at upcoming stages of the mission.

### 3.3.1. Protocol

As the RF communication should attract the amateur radio community, AX.25 (FX.25) or CCSDS protocols are considered to be used for communicating with the CubeSat. Both protocols provide similar functionality and have different strengths. As both protocols do not provide an application layer protocol, custom software will be necessary for packet decoding anyways, which dampens the “well known protocol”-argument by a bit. Currently, we are still evaluating which of those two options (or a mix of them) is best suited for the STS1 mission. The final decision will be made as soon as the hardware and software topology of the COBC is defined in a more confident matter.

AX.25

The amateur radio “standard” AX.25 based protocol stack mainly provides a well-known protocol and will probably aid with adoption in the amateur radio community. However, it was not built with space links in mind, which requires special considerations to support this highly asymmetric link topology.

CCSDS

The CCSDS protocol stack on the other hand was built specifically with space links and their quirks in mind, providing convolutional channel coding and Forward Error Correction (FEC) for improved error immunity.

Interoperability, Security Measures

To prevent others from hijacking (taking control of) STS1, only packages signed by the TU Wien Space Team are accepted by the CubeSat. This means that other interested amateur radio operators could establish an uplink as well, if the signature is shared. To increase the downlink capabilities, it is considered to cooperate with SatNOGS [12]. If so, the SatNOGS stations would increase the reception area of STS1. An additional self-built SatNOGS station would furthermore allow to create an additional educational platform for students and the TU Wien Space Team. The downlink is neither signed nor encrypted¹
, enabling everyone in the amateur radio community to receive beacons and other data from STS1. This helps to increase the area of reception, which is especially useful when downloading big amounts of data. However, it needs to be considered that a proper management of the acquired data needs to be implemented.

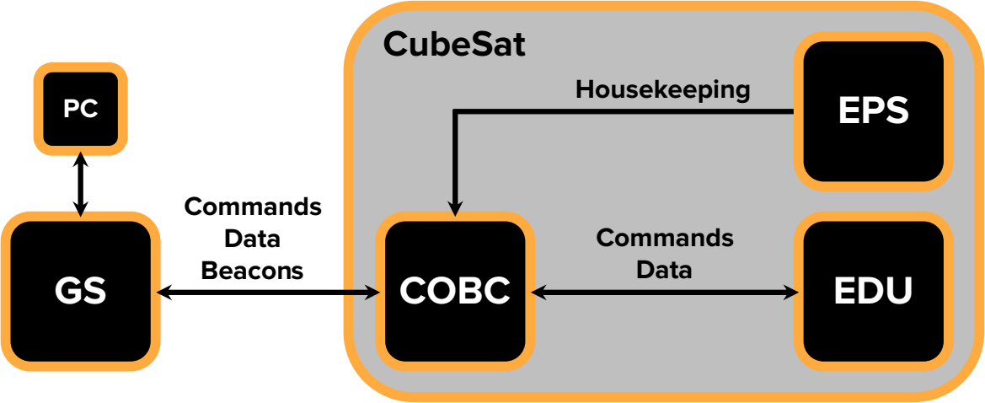
[picture p94: figure]
COBC; EDU; Commands Data Beacons; Commands Data; Housekeeping; CubeSat; EPS

Figure 3.3.: High-level dataflow diagram of STS1. Additionally, the relevant datatypes are mentioned for each data-link between subsystems.

### 3.3.2. Beacons

The CubeSat shall periodically broadcast housekeeping data (beacons) at least once a minute. However, it is targeted to increase the number of beacons per minute significantly. For this, the Microcontroller Unit (MCU) on the COBC gathers housekeeping data from sensors which are located on the EPS and on the COBC. The data is subsequently stored on the external COBC memory. Before a transmission to the GS, the COBC prepares the beacon for a broadcast by the RF module. Additionally, the beacon data will be stored in the external COBC memory over long periods of time, so that a history of beacon data can be requested by an appropriate command from the GS. Thus, history data can be obtained and evaluated easily.
These beacons can be received by any GS in range of the CubeSat at the broadcasting time. They include telemetry, housekeeping and operation status data.

### 3.3.3. Uplink

The GS can send signed commands and data via an RF uplink to the RF module of the COBC. The MCU on the COBC interprets these commands and data, and reacts accordingly. Commands will always rely on some sort of acknowledgment. Note that, e.g. CCSDS already has an ACK mechanism implemented.
In the following, the different data types which can be transmitted by the GS to the CubeSat are listed:

COBC firmware update

If a COBC firmware update is transmitted to the CubeSat, the MCU stores it in the external memory of the COBC. Afterwards, a command to the CubeSat is able to trigger a reset of the MCU and causes

1Encryption is neither necessary, nor permitted by amateur radio regulations.

it to flash the new firmware stored in the external memory. A detailed concept for managing the firmware versions on the COBC needs to be considered during the COBC development. An initial approach is described in Section 3.5.

EDU programs

If the uploaded data is a program for the EDU module (Raspberry Pi), the uploaded data is stored in the external COBC memory. Note that an additional memory block dedicated for unique program IDs is available as well. The program IDs enable us to implement a queuing mechanism, which lists the program IDs which are executed sequentially. To schedule the execution of a new EDU program, first, the EDU program file has to be transmitted to the CubeSat. Afterwards, the EDU execution queue – consisting of program IDs and additional (not yet defined) parameters (i.e. relative timing) – is transmitted to the CubeSat. As soon as a matching EDU program and program ID are available – and enough power can be provided by the EPS to run the EDU – the COBC initiates the execution of the EDU program. The program ID list is executed sequentially till there are no more operation commands available.

EDU execution queue

If the uploaded data is an execution queue for the EDU programs, this data is stored on the external memory of the COBC. As described in the previous paragraph, this execution queue contains the information in which order to execute the EDU programs. The only possibility to modify the EDU queue from the GS is to overwrite it. Additionally, commands will be implemented to delete this execution queue. More detailed information is given in Section 3.5.2.

### 3.3.4. Downlink

All data generated by the CubeSat is stored on the external memory managed by the COBC. As outlined in section 3.3.2, the MCU automatically downlinks beacon data periodically, which can be captured by the amateur radio community all over the globe. All other data, including data generated by the EDU module will merely be downlinked after an appropriate command is sent to the CubeSat. As no dedicated details regarding the communication link is defined yet, no further processing steps from the GS to an individual PC can be given. However, this topic needs to be considered in the further development of the COBC and the satellite communication.

### 3.3.5. Execution of EDU programs

As mentioned previously, the execution of EDU programs depend on the EDU execution queue. For the execution of a EDU program, the program ID of the execution queue and the EDU program need to be compatible, i.e. the unique program ID can be “1a” and “1b”, for example, to be able to execute EDU program “1” two times. Additionally, the EPS needs to be able to provide enough power, which is signaled to the COBC by the EPS itself.
As soon as the program ID within the EDU execution queue and the EDU program are compatible and the power level provided by the EPS is within limits, the COBC starts the Raspberry Pi and transfers the correct EDU program to the Raspberry Pi for execution. The Raspberry Pi on the EDU module will merely execute one EDU program at a time. Therefore, no parallel executions will be possible. While the code is running, the Raspberry Pi has access to several sensors and two cameras to gather data. This data can be processed on the Raspberry Pi’s CPU and GPU. The (processed) data is temporarily stored on the Raspberry Pi’s internal memory. Note that basic limitations within the EDU execution queue need to be set to prevent infinity runs of EDU programs.
For permanent storage and transmission to ground, the data on the Raspberry Pi is transmitted to the external memory of the COBC. Within this operation, it needs to be ensured that the COBC still remains the master of the CubeSat platform. Therefore, the Raspberry Pi shall not send any commands to the MCU, rather an approach to save data to the external memory could be (similar to) the following: After a certain time (parameter given in the EDU queue), the COBC directly pulls data from the Raspberry Pi to its external memory. As this document only acts as PD, no further details are given here. A dataflow scenario games, as mentioned in the introduction of this Section, will help to further develop a reliable saving mechanism. Details regarding this topic will be given in upcoming reviews.

## 3.4. EPS – Electrical Power System

The Electrical Power System (EPS) is responsible for the continuous generation and provision of electrical power at a single, unregulated voltage level. Energy is harvested solely through solar cells. Excess energy is stored in batteries, in order to continue to power the satellite in orbit sections without light incidence. The EPS also contains system level safety features, like the Remove-Before-Flight pin (RBF), the Deployment Switches (DS) and a Deployment Timer (DT). All of these features shall prevent a premature activation, while the CubeSat is still mounted onto the launch vehicle. Housekeeping data like battery voltage, battery temperature, etc. is collected by the EPS, and made available to the COBC subsystem through a housekeeping data interface.
The following sections lay out state of the art of commercial EPS’ (Section 3.4.1), the architecture of the proposed concept (Section 3.4.2) and the interfaces (Section 3.4.3) of the EPS.

### 3.4.1. State of the Art

As virtually any CubeSat hardware relies on electrical power, many commercial providers have gone through the effort of developing a ready-to-use Commercial Off-The-Shelf (COTS) EPS. In Table 3.1 a comparison of a selection of providers and the estimated STS1 requirements are listed. It can be seen that the commercial products are over-engineered in the majority of aspects. Especially when compared to the selection of available voltage rails and the capacity.
It has been decided to not implement a COTS EPS and rather develop the EPS in house for the following reasons:
1. Building and sharing of know-how
2. Reduction of mission cost
3. Experiences from previous CubeSat missions suggest, that the EPS should be as simple as possible, should contain as few features as possible and should not contain any microcontrollers. This circumstance is not applicable to most available COTS EPS.

3. System Architecture NanoAvionics[13] EnduroSat[14] ISISpace[15] Required for STS¹ Voltage Rails BAT,
Price On Request 2.500€ 3.300€ - Table 3.1.: Comparison of the EPS’ of a selection of providers and the estimated requirements of STS1. See Appendix A.1 for the source of the

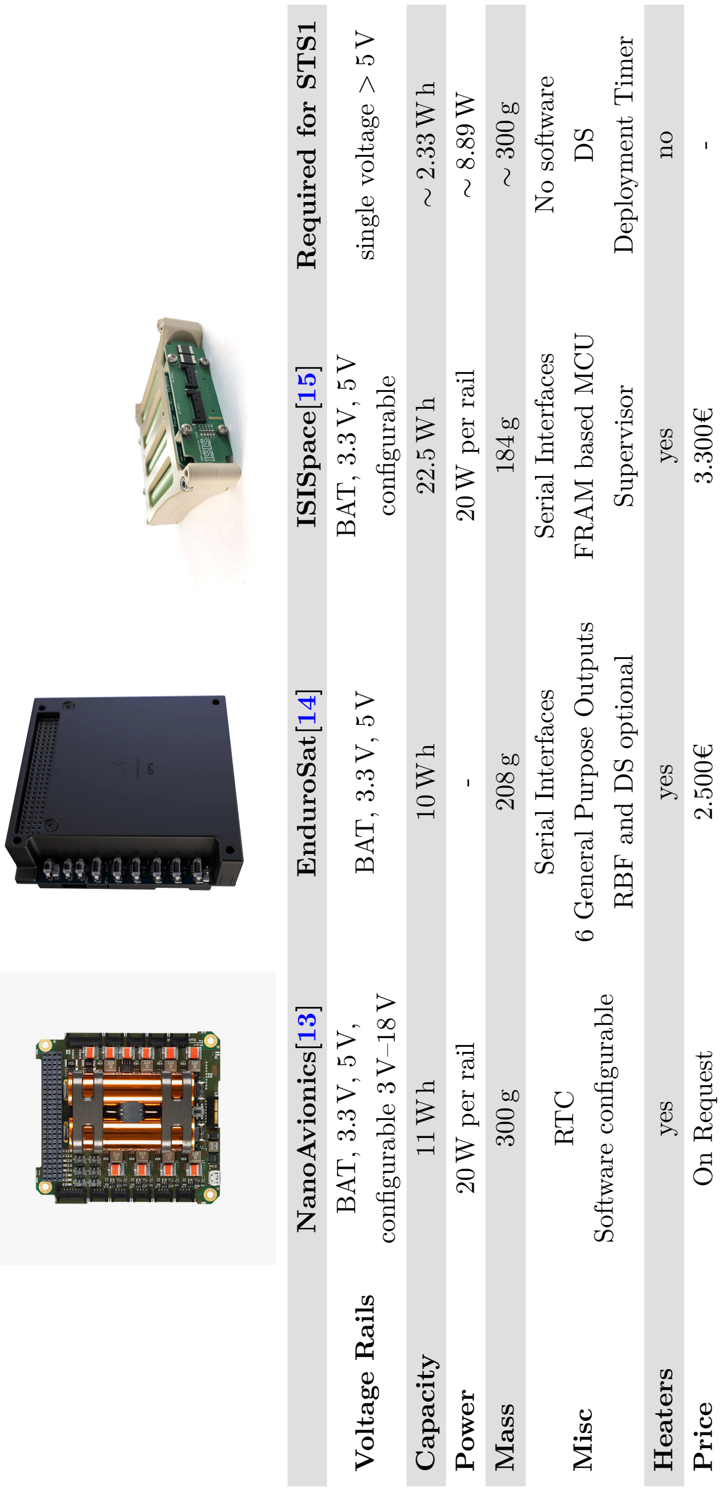
[picture p95: figure]
configurable; V BAT,; 3.3 V, 5 V BAT,; configurable single voltage; Capacity 11W h 10W h 22.5W h; Power 20W per rail - 20W per rail; Mass 300; Misc RTC; Software configurable; Serial Interfaces; 6 General Purpose Outputs; RBF and DS optional; FRAM based MCU; Supervisor; No software; Deployment Timer; Heaters yes yes yes no

estimations.

### 3.4.2. Architecture

The system requirements 1 and 2, stated in Chapter 2, allow the deduction of the architecture depicted in Figure 3.5. The components and their functions are elaborated upon in the following list:
1. External Charger: Connects to the Umbilical Cord Interface (UCI) of the satellite and allows charging of the CubeSat batteries on the ground. It is possible to charge the batteries, even when the safety features of the CubeSat (i.e. DS, DT and RBF) are in effect. However, it is not possible to power other satellite subsystems via the external charger, while the safety features are in effect.
2. Bus Gate: Switch, that permanently connects the EPS-internal power bus to the system bus interface, once the deployment timer signal has been received.
3. Battery Pack: Contains battery cells that store excess energy generated by the solar cells. Allows operation of the satellite, when no energy is harvested by the solar cells.
4. Temperature Sensor: Measures the temperature of the battery pack, and distributes this information to the housekeeping block and to the battery controller.
5. Solar Cell: Allows generation of electrical energy in orbit.
6. Deployment Switch: Switches that are actuated, when the satellite is inserted in the launch device. When actuated, the power flow of solar cells and battery is interrupted.
7. Remove Before Flight Pin: While this pin is inserted into the satellite, power flow of battery and solar cells is interrupted.
8. Voltage and Current Sensor: Measures voltage and current readings. This information is collected by the housekeeping block. During the development it will be evaluated in detail which parameters are required.
9. Battery Controller: Controls charge- and discharge-rate of the battery pack. Monitors battery voltage level and temperature. Provides the “Battery OK” signal to the CubeSat Bus Interface.
10. MPPT Controller: Keeps the connected solar cell at its maximum point of power by utilizing a Maximum Point of Power Tracking mechanism (MPPT), in order to optimize energy generation. Provides a regulated voltage at its output.
11. Deployment Timer: Timer that is started once all DS are no longer actuated and the RBF has been removed. After expiration of the timer, an electrical signal is emitted.
12. Housekeeping: Collects data of the sensors on the EPS and provides this data via an interface.
13. Umbilical Cord Interface (UCI): Interface to the umbilical cord connector. This connector allows ground based debugging and battery charging after assembly of the CubeSat.
14. CubeSat Bus Interface: Interface to the CubeSat system bus.
System requirement 1 demands, that either the solar cells or the battery must be able to drive the power bus, if the respective other part is currently not able to provide power. This circumstance implies four states of operation. These states and the respective conditions of battery and solar cells are depicted in Table 3.2. The battery state operable and not operable refer to the ability of the battery to provide electrical power. The state not operable could be caused by a low charge level. In this case, this state is temporary, until the charge level is high enough again. Another reason for the not operable state is an internal short of the battery. This fault implies, that the battery is stuck in the not operable state, and can not recover.

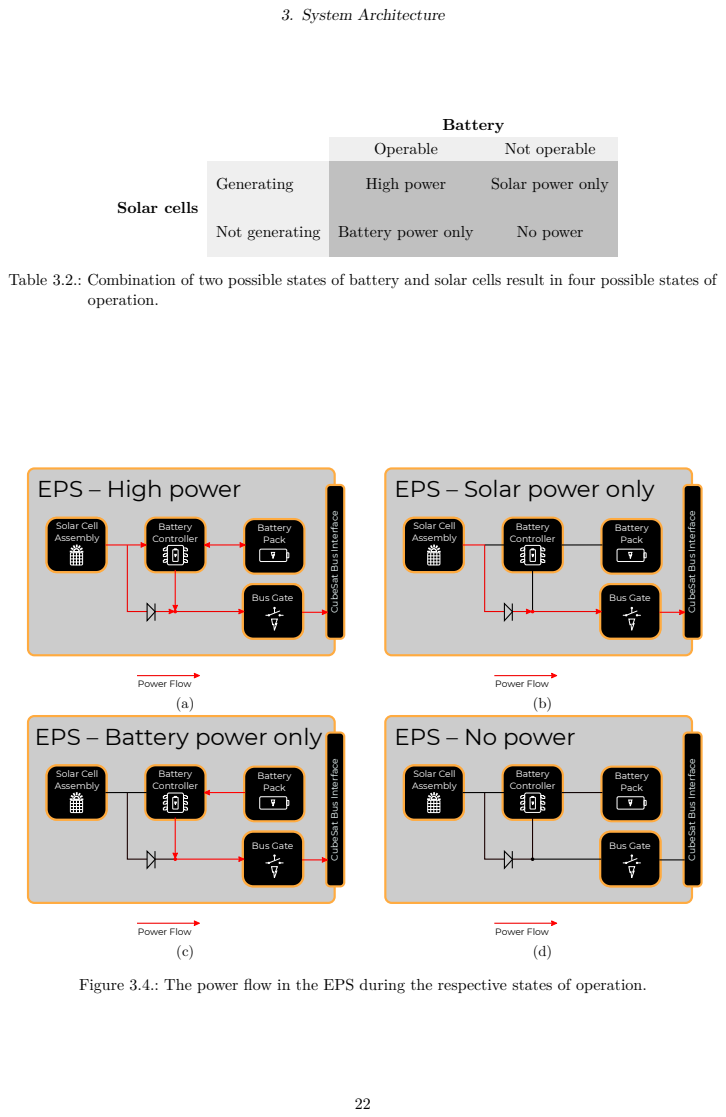
[picture p96: page 28]
Battery; Operable; Not operable; Generating; High power; Solar power only; Solar cells; Not generating Battery power only; No power; operation.; Battery Controller; Power Flow; Battery Pack

Table 3.2.: Combination of two possible states of battery and solar cells result in four possible states of

EPS – High power

EPS – Solar power only

CubeSat Bus Interface

Solar Cell Array Solar Cell
Assembly

Bus Gate

EPS – Battery power only

EPS – No power

Figure 3.4.: The power flow in the EPS during the respective states of operation.

The definition of the transition between these operation states is not within the scope of this document. It shall be specified latest in the upcoming EPS-PDR. The transition specification shall be verified by a “dataflow” game, where participants assume the role of a CubeSat subsystem. The operation of the CubeSat is then simulated by the participants (see Chapter 3 for details).

High power In this state, the solar cells generate power. The battery is operable and is being discharged or charged, depending on the current power demand of the subsystems and solar cell output. The power bus is driven by both, solar cells and battery. See Figure 3.4a for reference.

Solar power only Only the solar cells provide power. This may be caused by a low battery charge level, or a permanent battery fault. The power bus is only driven by the solar cells and the battery charger is bypassed over a diode. This means that the provided voltage on the bus may be volatile as the light incidence on the solar cells varies strongly over the orbit. The “Battery OK” signal issues this state to other systems, so they may act accordingly. See Figure 3.4b for reference.

Battery power only The solar cells do not provide any energy. This may be the case, if the CubeSat traverses the shade of the earth, or the solar cell contacts corrode. The power bus is driven by the battery charger, and in extension by the battery. This continues as long as there is charge left, or the solar cells provide power again. See Figure 3.4c for reference.

No power Solar cells and battery do not provide any power. In this state the power bus is not driven. The EPS does not provide any energy. This results in no operation of the CubeSat. See Figure 3.4d for reference.

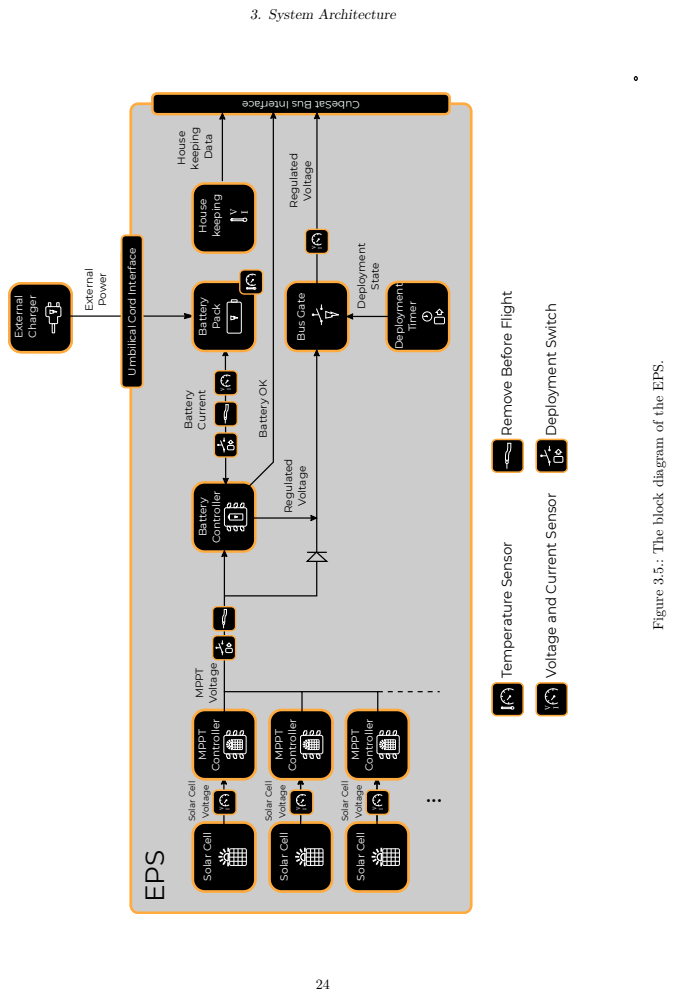
[picture p97: page 30]
Temperature Sensor; Deployment Switch; Battery; Voltage; Ground Charger; Post-Deployment; Timer; Bus Gate; Housekeeping Interface; Solar Cell; Output; Current; Regulated; Deployment State; Power; Housekeeping; Data; Controller; MPPT; Current Battery; External; Deployment; State; Charger; House; keeping; Pack; EPS

Umbilical Cord Interface

Controller Battery Pack Regulated

Remove Before Flight

Battery OK Figure 3.5.: The block diagram of the EPS.

Voltage and Current Sensor

Voltage MPPT Controller MPPT

Solar Cell Array Solar Cell

### 3.4.3. Interfaces

The EPS has an interface to the CubeSat system bus, where it provides a single power bus, a “Battery OK” signal and the housekeeping data. The EPS does not guarantee a fixed voltage level on the power bus. Other subsystems therefore have to implement additional voltage regulators to power its individual components. Furthermore, the EPS connects to the UCI. Here, the external charging port is connected. A listing of EPS in- and outputs (from an EPS point of view) can be seen in table 3.3 and table 3.4.
EPS System Bus Interface pins
| Name | Direction | Description
Power Bus | | Out | Provides power to other systems
Housekeeping data | | In/Out | Interface for a serial communication protocol that allows polling of housekeeping data
Battery OK | | Out | Signal, that indicates, whether the battery is currently able to provide power.

Table 3.3.: Pins which connect the EPS to the system bus.

EPS Umbilical Cord pins
| Name | Direction | Description
Cell X + | | In | Positive terminal of battery cell X
Cell X − | | In | Negative terminal of battery cell X
Table 3.4.: Pins which connect the EPS to the umbilical cord interface (UCI).

## 3.5. COBC – Communication Module and On-board Computer

The COBC of the CubeSat STS1 combines two classical subsystems which are key components in every satellite mission: the Communication module (COM) and the On-Board Computer (OBC). The COM is responsible for any received and transmitted data and the OBC mainly schedules any activities on the CubeSat. Additionally, the OBC acts as the master module of the CubeSat platform by managing memory access and operating the EDU. This also concludes that the COBC is always the first subsystem which is powered up if energy becomes available. Other CubeSat components (except the EPS) are then enabled sequentially by the COBC, this includes the power up of the EDU module. Figure 3.6 shows the main components of the COBC system.

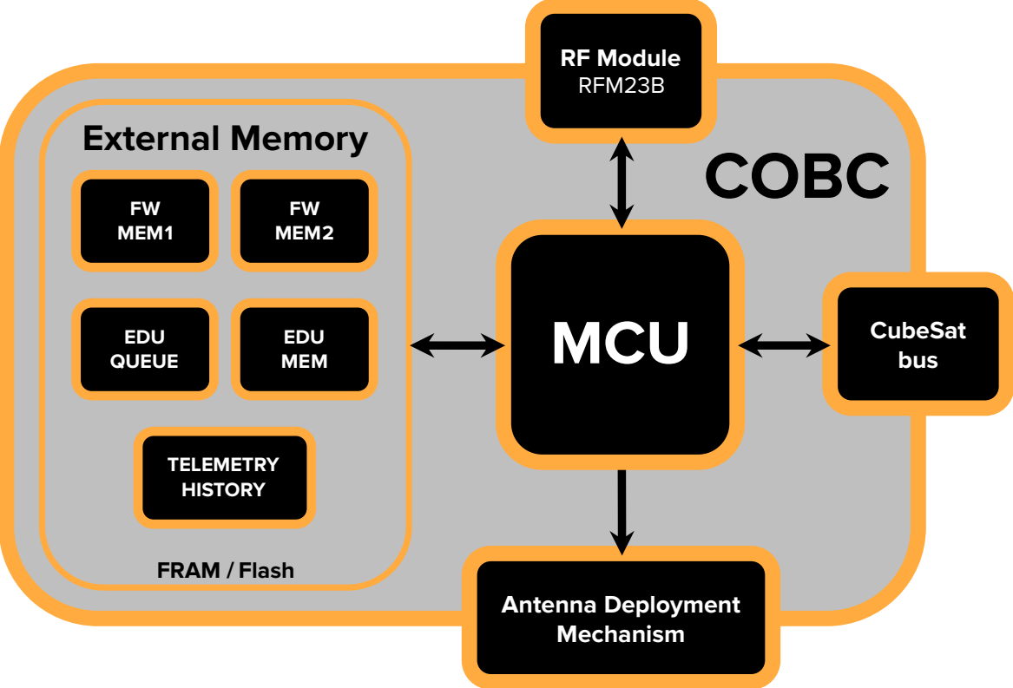
[picture p98: figure]
Antenna Deployment Mechanism; MCU; COBC; CubeSat bus; RF Module RFM23B; FRAM / Flash; External Memory; TELEMETRY HISTORY; FW MEM1; FW MEM2; EDU QUEUE; EDU MEM

Figure 3.6.: Block diagram of the COBC with its main components. Furthermore, communication links, external interfaces, and the structure of the external memory are shown.

The Microcontroller Unit (MCU) is the COBC’s core and handles the entire dataflow on board the CubeSat. This means analyzing incoming and preparing outgoing data from and to the RF module (presumably RFM23B [16]), managing all data access – read, write and erase – to the external memories – based on (proposed) FRAM and Flash – and handling data exchange with the EDU module. Details regarding the external memory on the COBC are given in Section 3.5.3. Note that the MCU also schedules the operation of the EDU module. Another important feature is that the antenna deployment mechanism is triggered by the MCU as well.
The proposed concept combines the approach of an individual COM and OBC subsystem. To determine if separate systems are necessary, the dataflow, which is described in section 3.3, was thoroughly discussed. The main argument is that the capabilities of this CubeSat mission do not require separate COM and OBC subsystems, as these functionalities can be combined on a single subsystem: the COBC. The COBC section is divided into four subsections: Section 3.5.1 describes the functionality of the RF module. Further, Section 3.5.2 gives an insight on the MCU itself, whereas the associated external memories are discussed in Section 3.5.3. Finally, Section 3.5.4 describes the concept of the antenna deployment mechanism.

### 3.5.1. RF Module

The RF module is the active part of the RF front end, which receives and transmits a binary stream from and to the GS via an RF link and forwards these data to the MCU for further processing. The RF stream is modulated onto an amateur radio frequency band (70 cm) carrier. Note that the RF link works in half-duplex operation to reduce complexity in hardware and management (software implementation). To be more explicit, this prevents any switching of antennas/transceivers and means that the CubeSat cannot receive and transmit data at the same time. A custom cross-dipole (made of metal ruler tape) will be built and tuned to catch both polarization directions (via a power combiner). Additionally, a robust impedance matching is considered between the antenna and the transceiver. As briefly introduced in Section 3.3, the whole RF link communication shall be amateur radio compliant. This means that the modulation scheme and filtering needs to be implemented according to amateur radio standards. Furthermore, it shall be possible to turn off the RF module by a command from the GS. This prevents the CubeSat from performing any further RF communication in the case that the used communication frequency is legally not usable anymore.
Although this document serves as a PD, it is considered to use the RFM23B [16], as this transceiver is already operational in Pegasus’ “Stacy” communication module, which is a part of a former CubeSat project of the TU Wien Space Team. Furthermore, another CubeSat mission [17] successfully used the proposed RFM23B module as well. Nevertheless, proper investigations are required to verify the RFM23B for the use case of this CubeSat mission.

### 3.5.2. MCU – Microcontroller Unit

The MCU is the brain of the CubeSat. It handles all telemetry and housekeeping tasks required to keep the satellite operational. The functionality can be divided into the following main categories:
- System startup/initialization
- Communication
- System health data collection
- Scheduling of the operation time of the EDU

System startup/initialization

The first task of the MCU after deployment and power recovery is to initialize the internal peripherals and all external components which are connected to the MCU. If not explicitly deactivated, the antenna deployment mechanism is triggered (details can be found in Section 3.5.4). After a successfully verified antenna deployment²
, a command can be transmitted to the CubeSat to disable the antenna deployment mechanism. This ensures reduced power consumption during the regular boot operation of the CubeSat infrastructure. The deactivation of the antenna deployment mechanism is stored as a magic value in the COBC’s external memory, including a checksum to prevent accidental deactivation due to random bit flips caused by radiation. Note that, any other execution of tasks (except the transmission of beacons) is triggered or managed from the GS, respectively. Since this document serves as a PD no dedicated assignment of data to FRAM or Flash is stated.

2Will be manually verified from the GS using metrics like signal strength.

Communication

The MCU also serves as the central communication hub of the CubeSat. It receives data from the RF and EDU modules and polls various sensor data – from sensors on the EPS and COBC – for the generation of the beacon data. The telemetry beacon is generated from said data in regular intervals (at least once a minute) and is sent to the RF module for transmission. It needs to be considered that the RF module merely receives packages and does not perform any integrity check. Therefore, the RF module just forwards the data to the COBC, where uplink data is first checked for data integrity and authenticity (Forward Error Correction (FEC) and signature) by the MCU. There are three possible types of uplink data: commands to be processed by the COBC, files (e.g. Python scripts or supporting data) meant for the EDU subsystem (including EDU execution queue files) and firmware updates for the COBC’s MCU.
Commands are processed directly on the MCU as soon as resources for processing are available and downlink data is scheduled as soon as a command is successfully received. The scheduled downlink data is either a simple ACK or a response which in turn can require an ACK from the ground station to signal successful reception depending on the exact type of command and data. As already described in Section 3.3 a mechanism needs to be implemented to prevent any loops, which might occur due to issues with any acknowledgment mechanisms.
Files for the EDU subsystem are stored on the external memory on the COBC. Note that the MCU is capable to transfer these files to the EDU for the execution on the Raspberry Pi. This also concludes that the MCU acts as master and the EDU as slave. This is of major importance to avoid any conflicts of interest between these two processing units.
Firmware updates ensure that the MCU on the COBC itself can be updated. Therefore, the firmware version on the MCU and the latest firmware version on the external memory are compared. It needs to be ensured that a reliable concept is developed to conduct these tasks. A promising procedure, which inspires us, is the implementation, which is done on the Mars Rover Curiosity [18]. If the firmware version on the MCU is not equal to the firmware version on the external memory and an according command is received, the firmware version on the external memory gets flashed onto the MCU by resetting the MCU itself. Afterwards the MCU reboots with the new firmware. The Mars Rover Curiosity has an additional firmware image of the old firmware version as a fallback. Details will be described as soon as the COBC development progresses further.
In the other direction, things work similarly as the COBC can pull data into the external memory from the Raspberry Pi memory. These data can then be transmitted to the GS via a command sent from the GS to the CubeSat. As the CubeSat does not send any data (except for beacons) without an explicit request from the GS, situations where no uplink is possible due to a saturated downlink can be avoided. Downlink packets are queued in a priority-based queue as to not block beacons and commands with less important file transfers. For further protocol information see Section 3.3.

System health data collection

The third task of the MCU is to collect and store sensor data related to overall system health. This primarily consists of data generated by the EPS (e.g. bus current and voltage, solar cell status, battery voltage, charge/discharge current, battery state, temperatures, etc.) but also locally generated statistics like uplink packet FEC and re-transmission counts as well as signal strength, to name a few examples. Depending on the historical importance of data, it is either stored in (volatile) SRAM or (nonvolatile) FRAM. Apart from the regular telemetry packets, it is possible to request current and historical data directly. Long term data can be down sampled automatically after a certain amount of time to not loose old but not yet retrieved data in case the GS is unable to reach the satellite for extended time periods.

Scheduling EDU programs by queuing

As described in Section 3.3, the external memory contains an execution queue, which determines the order of operation of individual student software experiments on the EDU module. This allows us to keep an overview of the planned and already executed Python scripts. Furthermore, an organized handling of scripts and data is ensured. In the case of a power outage, the Python script will be executed at a later time as the queue remains in the external memory until the COBC obtains data from the EDU module. A more detailed definition will be done as soon as the development of the COBC progresses further. Additionally, this ensures that the MCU does not get corrupted by any rescheduling. Note that this also increases the level of reliability by reducing the complexity of the scheduling in comparison to a time-based mechanism.

### 3.5.3. External Memory

As shown in Figure 3.6, the external memory is divided into six main blocks: The FW MEM1 and FW MEM2 contain firmware updates for the COBC itself. Two separate memory blocks are necessary to implement the proposed concept which contains new firmware updates as well as an initial firmware version as a fallback. The EDU-relevant memory cells are EDU QUEUE and EDU MEM. EDU MEM contains the uploaded EDU programs and (processed) data which was generated by the execution of EDU programs, whereas EDU QUEUE contains the queuing procedures for student software experiments stored in EDU MEM. Finally, TELEMETRY HISTORY stores the telemetry and housekeeping data which is necessary for the beacon generation. All mentioned memory blocks are realized as FRAM or Flash. Details regarding its implementation will be done as the development of the COBC progresses further.

### 3.5.4. Antenna Deployment Mechanism

In the very beginning of the mission the antennas are wrapped around the CubeSat and held in place by a plastic string. This string must be severed in order for the antennas to deploy, making the CubeSat ready for RF communication. The antenna deployment mechanism accomplishes this by running a current through a resister which heats up by resistive heating and melts the string. Supplying power from the EPS to the resistor is done by a MOSFET which was already used in previous CubeSat missions, e.g. Pegasus [19].
The detailed management – activation at startup and deactivation by a telecommand – is explained in more detail in Section 3.5.2.
The following list gives a brief overview of some relevant features of the antenna deployment mechanism:
- According to first tests – where PLA zipties were melted – approximately 8.5Ws–25Ws are required.
- MOSFET: triggered by COBC
- The Antennas will also be tested in the undeployed position. Electrically isolating them from the frame may help reduce losses in this case.

## 3.6. EDU – Education Module

The education module (EDU) is the platform on which students can run their software experiments. It consists of a Raspberry Pi which has access to various sensors, including two cameras. The generated (and processed) data will be transferred to the COBC and stored on its external memory where it can be downloaded via a command. After a successful download, the data will be processed and handed over to the student teams to analyze it. The CubeSat is designed such that the EDU module is an independent payload, i.e. the CubeSat is fully operational without the EDU module or in the case of a complete failure of the module.
The EDU section is divided into three subsections: Section 3.6.1 gives an outline how the educational aspect of the mission fits into the global and national educational landscape. In Section 3.6.2 the different components of the EDU module and the data flow between them is discussed. Finally, Section 3.6.3 gives insights into thoughts about a supporting Attitude Determination and Control System (ADCS) and any redundancy concepts of the EDU module.

### 3.6.1. Educational Importance

Due to the increasing popularity of Commercial Off-The-Shelf (COTS) components in space-related missions, the number of missions with an educational³ goal is steadily increasing. For example, in ESA’s Astro Pi Challenge [20], students are able to run their code on a Raspberry Pi computer on-board the ISS. Furthermore, several educational CubeSat missions are currently in development or already in orbit, such as SelfieSat [21] or ArduSat [22].
Even though there are already established space-related educational missions, a hands-on approach seems out of reach for most people and thus we want to further lower the entry barrier for students in Austria and offer an approachable space education mission which will hopefully inspire the next generation of space and science enthusiasts. In comparison to the above-mentioned missions, STS1 will offer students an opportunity to develop their own software in close guidance with the TU Wien Space Team and run their code on an independent spacecraft in orbit around Earth. Furthermore, their code will be able to gather data during a prolonged period of time which allows more sophisticated software experiments as in comparison to ESA’s Astro Pi Challenge where the runtime is limited to 3 hours. During the software development phase, students will be able to test their code on development kits which will further enhance their coding experience and give them the possibility of debugging their code. The supporting members of the TU Wien Space Team will be approachable during the whole development phase and can give valuable support to the students in their native language.
The EDU module of STS1 uses the popular Raspberry Pi platform [23]. This will further lower the entry barrier, both for teachers and students, as lots of resources about the platform are freely available on the Internet and some participants will already be familiar with the platform. In addition, we will try to keep the coding experience as accessible as possible by hosting workshops and providing libraries for the most common operations on the EDU module, i.e. for sensor readouts and standard commands for data processing. Furthermore, the Raspberry Pi platform will allow students to code their own software experiments in Python, which is nowadays one of the most popular [24] programming languages, especially for trending fields such as data science or machine learning. Thus, any familiarity with Python will greatly benefit the students in their later academic or professional careers.
Sensors under current consideration are: temperature sensor, magnetic field sensors, acceleration sensors, gyroscopes, GNSS receiver, cameras, strain gauges, brightness sensors and a radiation sensor. Possible student experiments with these sensors are for example mapping the radiation environment of low Earth orbit (LEO) or determining how fast the CubeSat is spinning. Students who will participate

3
In the following, every mission with a goal to spark interest in science and space is considered an ’educational’ mission.

in STS1’s educational mission will gain hands-on experience in writing actual space software, which will advance their problem solving and teamwork skills. The whole mission will be held in form of a competition, where we expect to gain the support of Austrian space companies and space celebrities for honouring the winning teams. However, we will ensure that all participating student teams, not only the winning teams, will reach their software development goals.
As our educational mission seems in line with already well-established educational organisations in Austria, such as the Österreichische Forschungsförderungsgesellschaft FFG (Austrian Research Promotion Agency) [2] or the European Space Education Resource Office (ESERO) [1], we will get in contact with these and try to establish suitable cooperations, similar to how the TU Wien Space Team is already supporting ESERO’s CanSat Challenge [25].

### 3.6.2. Architecture

Figure 3.7 shows the main components of the EDU module.

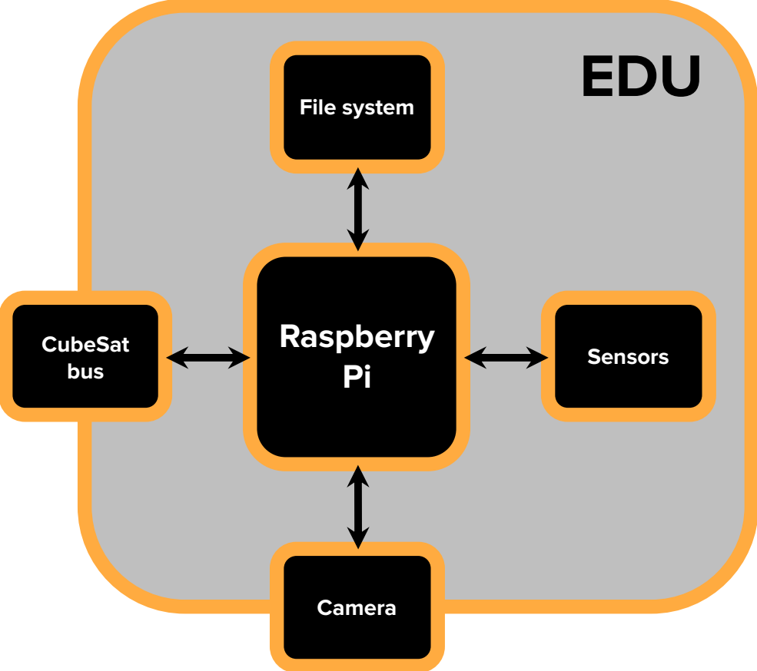
[picture p99: figure]
Camera; Raspberry Pi; EDU; Sensors; File system; CubeSat bus

Figure 3.7.: Block diagram of the EDU module with its main components. The black arrows mark data communication links.

A Raspberry Pi Compute Module 3 will be used as processing unit in the development phase due to its excellent compromise between performance, power consumption and heat generation. Moreover, the Raspberry Pi Compute Module 3 allows the connection of two Raspberry Pi camera modules V2 [26], which was already successfully used to capture images of Earth from space on-board SSTL’s DoT-1 satellite [27], via two distinct Camera Serial Interfaces (CSI). The Raspberry Pi will be equipped with an eMMC Flash memory where the operating system and the file system for storage of EDU programs and EDU data will be located. The EPS will provide power for the EDU module. The necessary voltage levels will be generated on the EDU module. The connection to various sensors and the voltage generation will be enabled by a custom-made breakout board which will host the Raspberry Pi Compute Module in the CubeSat PCB stack.
We are confident that the chosen Raspberry Pi platform will be able to successfully operate in LEO for two reasons. First, different Raspberry Pi models were already successfully operated in space [28, 29]. Second, several radiation tests [30, 31, 32] suggest that different Raspberry Pi models can operate in radiation environments similar to LEO. If problems regarding the heat generation of the Raspberry Pi Compute Module 3 occur in the development phase, a change to use a Compute Module 1 will be considered. This change should be easily implementable as the Compute Module 1 and 3 have the same form factor and connections (same pin-out).
The COBC is able to turn on/off the entire EDU module and schedule the execution of EDU programs. The uploaded EDU programs will be transferred to the file system of the Raspberry Pi where they await the execution command from the COBC. If the COBC starts the execution of an EDU program, the Raspberry Pi can gather data from the connected sensors and cameras. This data can be processed on the Raspberry Pi’s CPU and GPU. The (processed) data is temporarily stored on the Raspberry Pi’s file system. For a permanent storage, the EDU program code has to include certain save commands which will save the (processed) data on the COBC’s external memory⁴
. With this method, the EDU data downlink is independent of the operation status of the EDU module, i.e. the data can also be downlinked when the EDU module is completely turned off. For a more detailed discussion of the EDU data flow, see Section 3.3.5.

### 3.6.3. Supporting Systems and Redundancy

In the previous CubeSat project of the TU Wien Space Team, DISCO One [33], the use of an Attitude Determination and Control System (ADCS) was planned to ensure a proper orientation of the CubeSat for a stable optical communication link. The ADCS of DISCO One consisted of several magnetometers and gyroscopes to sense the orientation of the satellite and a magnetic torquer board to be able to slow down the spinning of the spacecraft after launch.
STS1 will not use an ADCS. This decision leads to less power consumption, complexity, and a shortened development and testing phase. The only component on board STS1 which would greatly benefit from an ADCS is the camera module. However, the operational CubeSat DAVE [34] was able to capture an image of Earth with a cell phone camera without the use of an ADCS. Thus, we strive to replicate this success with rigorous testing of STS1’s camera performance.
The use of two cameras, mounted on opposing sides of the CubeSat, with large field of views will give us the opportunity to image Earth in all possible orientations of the CubeSat. If STS1 is spinning after deployment, we will adjust the settings (brightness, exposure time,...) of the camera to be able to acquire a sharp image. This procedure will be extensively tested in the upcoming development phase. If the initial spinning of the CubeSat exceeds the capabilities of our camera module to acquire a sharp image, we will focus on the operation of the other systems and sensors until the satellite has slowed down its rotation by atmospheric drag. Even if the rotation speed of STS1 is too fast for a sharp image acquisition over the entire lifetime, no primary mission objective is compromised by the decision of not using an ADCS. Besides the camera, all other systems of STS1 (including the sensors of the EDU module) will be able to operate nominally without an ADCS.
Traditional space missions often use redundant components to lower the risk of failure of certain components or whole (sub)systems. However, the incorporation of redundancy always comes with

4The COBC is always the master system regarding COBC and EDU communication. This includes the above-mentioned saving operation.

an increased complexity of the entire system and thus needs significant development and testing time in order to be able to benefit from the incorporated redundancy. Thus, we decided to not integrate the EDU module in a redundant manner for two main reasons. First, STS1 is the first self-developed CubeSat mission of the TU Wien Space Team, which means that already a significant amount of development time is needed to establish a reliably working CubeSat platform – even without incorporating redundant systems. Second, in the former preliminary concept of STS1, the redundant systems were heavily criticized by external reviewers. Therefore, our goal is to develop a working CubeSat hardware early on and start with systematic (automatic) testing of the individual CubeSat subsystems and the whole CubeSat stack as early as possible.
Even though major systems will not be implemented in a redundant manner, we have concerns that the eMMC memory of the Raspberry Pi platform is vulnerable to the radiation environment in LEO. Thus, we are investigating the usage of a system that would allow the Raspberry Pi to boot from multiple eMMCs. The firmware that runs on the Raspberry Pi will not be able to receive a firmware update as the needed functionality is limited. Additionally, extensive testing of the used EDU platform will be performed on ground before launch. Therefore, the only critical error handling scheme of the EDU module is the restart via a command of the COBC and potentially a switchover to a redundant eMMC memory.

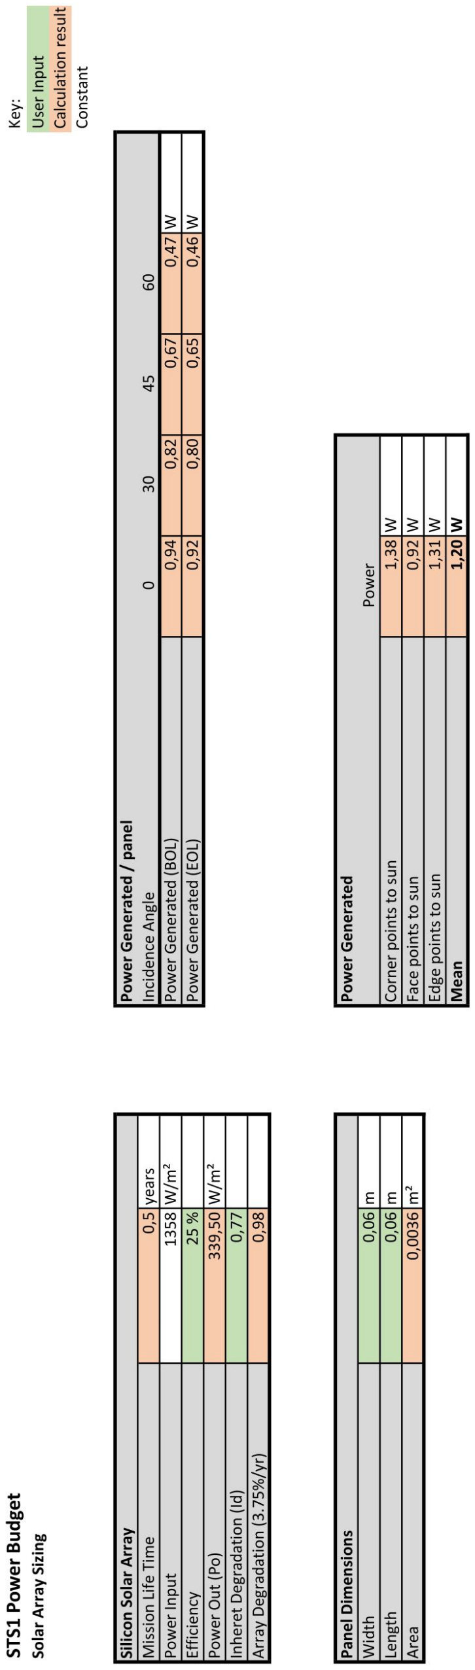
[picture p100: figure]

# A. Appendix

## A.1. Power Budget

A. Appendix

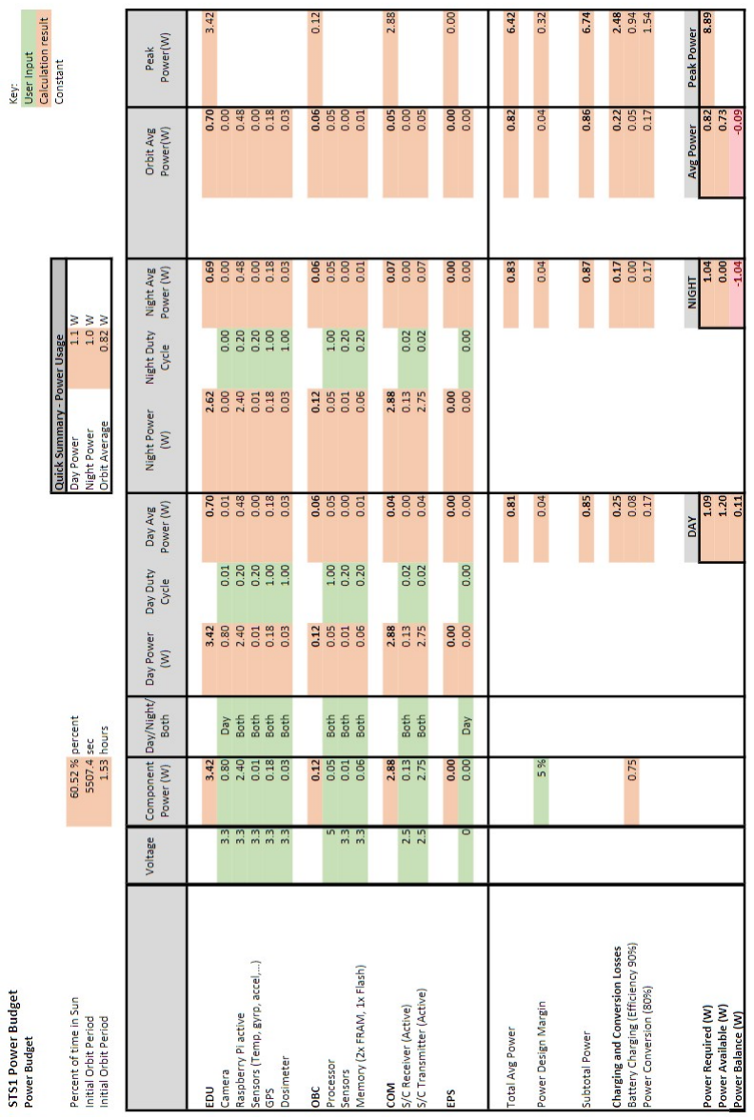
[picture p101: figure]

A. Appendix

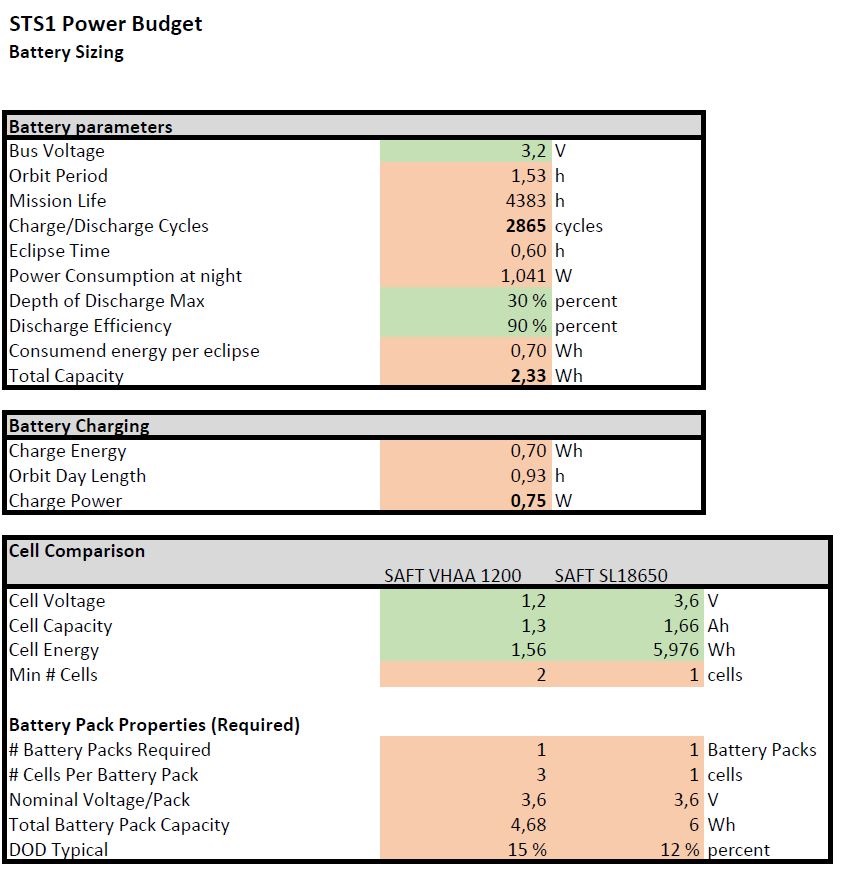
[picture p102: figure]

A. Appendix

## A.2. Project plan

Gantt
Phase 0: Mission analysis-need identification Phase A: Feasibility Phase B: Preliminary definition Phase C: FlatSat setup EPS & COBC Phase D: CubeSat field test Phase E: STS-1 High Altitude Flight | 2020 | 2021 | 2022 2023
Q1 | Q2 | Q3 | Q4 | Q1 | Q2 | Q3 | Q4 | Q1 | Q2 | Q3 | Q4 | Q1 | Q2 | Q3 | Q4

Idea creation process
State of the Art analysis
Mission Outline
Definition of Mission Objectives Review of Phase 0
Definition of primary Mission Objective Define System Requirements CubeSat structure definition (1U) Risk analysis
Review of Phase A
PDR-1
Subsystem definition
Define Subsystem Requirements Setup organizational structure Interface definitions, SatBus

PDR-2
Create budget of project
Re-Define System Requirements Re-Define Subsystem Requirements Ham Radio Requirementes Definition

Project support
Simulations subsystem support Legal clarification
AIV infrastructure setup

Groundstation
GS introcduction and checks GS SW spezification & design GS SW programming
GS Setup buildup
GS tests

FlatSat setup EPS & COM
EPS spezification & design
EPS mini-PDR
EPS manufacturing
EPS test & redesign & remanufacturing COBC spezification & design
COBC mini-PDR
COBC manufacturing
COBC SW design (exc. EDU SW)
COBC SW programming (exc. EDU SW) COBC test & redesign & remanufacturing Test sensors (inc. Camera)
EDU spezification & design
EDU SW design
EDU mini-PDR
Mechanical structure mockup spezification & design Mechanical structure mockup manufacturing

CubeSat field test
EDU manufacturing
EDU test & redesign & remanufacturing
COBC SW programming (inc. EDU SW)
COBC & EDU test & redesign & remanufacturing Mechanical structure spezification & design Mechanical structure build
Full CubeSat integration

STS-1 High Altitude Flight
Define program for schools
Students flight communication
Ham radio community flight communication Manage flight opportunity
Prepare testcode for High Altitude Flight

Data archiving

Version: 4

Figure A.1.: Gantt chart for the high-altitude flight (HAF) of STS1.

A. Appendix

## A.3. Financial budget

Name | Description | Price | Pieces | Costs
Engineering hardware | Electronic support equipment (Programmer, Debugging stuff, Analyzer) | 500.00 € | 1 | 500.00 €
| Spare/replacement components (Cables, Antennas, Connectors) | 650.00 € | 1 | 650.00 €
| | | | 1 150.00 €
EPS | Fully equipped PCBs | 500.00 € | 1 | 500.00 €
| Batteries | 250.00 € | 1 | 250.00 €
| Solar cells | 250.00 € | 8 | 2 000.00 €
| | | | 2 750.00 €
COBC | Fully equipped PCBs | 500.00 € | 1 | 500.00 €
| RF modules | 250.00 € | 1 | 250.00 €
| | | | 750.00 €
AIV | Fully equipped testing PCBs (Break-out boards for our CubeSat stack) | 500.00 € | 1 | 500.00 €
| | | | 500.00 €
| | | Sum | 5 150.00 €

CubeSat STS1 – Budget 2021

Figure A.2.: Financial budget for STS1 for 2021: HW development of the EPS, COBC and the FlatSat.

# Bibliography

[1] ESERO Austria – European Space Education Resource Office. url: https://ars.electronica.art/esero/de/ (https://ars.electronica.art/esero/de/) (visited on 16/01/2021).
[2] Österreichische Forschungsförderungsgesellschaft FFG (Austrian Research Promotion Agency). url: https://www.ffg.at/ (visited on 10/10/2020).
[3] ESA: Fly Your Satellite! programme. url: https://www.esa.int/Education/CubeSats_-_Fly_Your_Satellite/Fly_Your_Satellite!_programme (https://www.esa.int/Education/CubeSats_-_Fly_Your_Satellite/Fly_Your_Satellite!_programme) (visited on 24/09/2020).
[4] TU Wien Space Team. url: https://spaceteam.at/ (visited on 07/02/2021).
[5] Raphael Behrle et al. SpaceTeamSat1 Dataflow Game Document. Version 1.1. Apr. 2023. doi: 10.5281/zenodo.7791595. url: https://doi.org/10.5281/zenodo.7791595.
[6] David Freismuth and David Wagner. SpaceTeamSat1 Preliminary Design Document: Electric Power System. Version 0.2. Apr. 2023. doi: 10.5281/zenodo.7791655. (https://doi.org/10.5281/zenodo.7791655) url: https://doi.org/10.5281/zenodo.7791655. (https://doi.org/10.5281/zenodo.7791655)
[7] Raphael Behrle et al. SpaceTeamSat1 Preliminary Design Document: Communication and On-board Computer Hardware. Version 0.2. Apr. 2023. doi: 10.5281/zenodo.7792683. (https://doi.org/10.5281/zenodo.7792683) url: https://doi.org/10.5281/zenodo.7792683.
[8] Stefan Galavics, Florian Guggi and David Wagner. “SpaceTeamSat1 Preliminary Design Document: Educational Unit”. unpublished. doi: 10.5281/zenodo.7770145. (https://doi.org/10.5281/zenodo.7770145) url: https://doi.org/10.5281/zenodo.7770145. (https://doi.org/10.5281/zenodo.7770145)
[9] Patrick Kappl, Jerome Hue and David Wagner. SpaceTeamSat1 Preliminary Design Document: Communication and On-board Computer Software. Version 1.1. Apr. 2023. doi: 10.5281/zenodo. 7791621. url: https://doi.org/10.5281/zenodo.7791621.
[10] Apache CouchDB – A NoSQL database. url: https : / / couchdb . apache . org/ (https://couchdb.apache.org/) (visited on 18/01/2021).
[11] Gpredict – A real-time satellite tracking and orbit prediction application. url: http://gpredict.oz9aec.net/ (http://gpredict.oz9aec.net/) (visited on 15/01/2021).
[12] SatNOGS – Open Source global network of satellite ground-stations. url: https://satnogs.org/(visited on 18/01/2021).
[13] NanoAvionivcs CubeSat Electrical Power System EPS. url: https : / / nanoavionics . com / cubesat-components/cubesat-electrical-power-system-eps/ (https://nanoavionics.com/cubesat-components/cubesat-electrical-power-system-eps/) (visited on 20/01/2021).
[14] Endurosat EPS I PLUS. url: https://www.endurosat.com/cubesat-store/cubesat-power-modules/eps-power-module-i-plus/ (https://www.endurosat.com/cubesat-store/cubesat-power-modules/eps-power-module-i-plus/) (visited on 20/01/2021).
[15] ISISPACE iEPS Electrical Power System. url: https://www.isispace.nl/product/ieps-electrical-power-system/ (https://www.isispace.nl/product/ieps-electrical-power-system/) (visited on 20/01/2021).
[16] RFM23B RF module from HopeRF. url: http://www.hoperf.com/modules/rf_transceiver/RFM23BW.html (http://www.hoperf.com/modules/rf_transceiver/RFM23BW.html) (visited on 10/01/2021).
[17] S. Hansen et al. “Airglow-CubeSat with Orientation Control by Aerospike Puff-jets”. In: 2012. url: http : / / www . utahspacegrant . com / wordpress / wp - content / uploads / 2013 / 01 / 6. -Stewart-Hansen.pdf. (http://www.utahspacegrant.com/wordpress/wp-content/uploads/2013/01/6.-Stewart-Hansen.pdf)

Bibliography
[18] The Mars Rover On-board Computer. url: https://media.ccc.de/v/35c3-9783-the_mars_rover_on-board_computer (https://media.ccc.de/v/35c3-9783-the_mars_rover_on-board_computer) (visited on 05/02/2021).
[19] Pegasus – A CubeSat project by the TU Wien Space Team, FH Wiener Neustadt and the Space Tech Group. url: https://spaceteam.at/cubesats/cubesat/?lang=en (visited on 06/09/2020).
[20] Website of ESA’s Astro Pi Challenge. url: https://astro-pi.org/ (visited on 10/10/2020).
[21] The SelfieSat – Selfies From Space. A CubeSat project by students of the Norwegian University of Science and Technology (NTNU). url: https://www.orbitntnu.com/current_mission/(visited on 06/09/2020).
[22] ArduSat – Your Arduino Experiment in Space. url: https://www.kickstarter.com/projects/575960623/ardusat-your-arduino-experiment-in-space (https://www.kickstarter.com/projects/575960623/ardusat-your-arduino-experiment-in-space) (visited on 16/01/2021).
[23] Website of Raspberry Pi Computer. url: https : / / www . raspberrypi . org/ (https://www.raspberrypi.org/) (visited on 10/10/2020).
[24] TIOBE Programming Community Index. url: https://www.tiobe.com/tiobe-index// (visited on 16/01/2021).
[25] Website of ESERO’s CanSat Challenge. url: https://ars.electronica.art/esero/de/projects/cansat/ (https://ars.electronica.art/esero/de/projects/cansat/) (visited on 10/10/2020).
[26] Raspberry Pi Camera Module V2. url: https://www.raspberrypi.org/products/camera-module-v2/ (https://www.raspberrypi.org/products/camera-module-v2/) (visited on 06/09/2020).
[27] SSTL Releases Raspberry Pi Camera Image and Video. url: https://www.satellitetoday.com/imagery-and-sensing/2019/09/05/sstl-releases-raspberry-pi-camera-image-and-video/ (https://www.satellitetoday.com/imagery-and-sensing/2019/09/05/sstl-releases-raspberry-pi-camera-image-and-video/) (visited on 06/09/2020).
[28] Raspberry Pi in space! – Raspberry Pi Blog entry. url: https://www.raspberrypi.org/blog/raspberry-pi-in-space/ (https://www.raspberrypi.org/blog/raspberry-pi-in-space/) (visited on 16/01/2021).
[29] Compute Module CubeSats – Raspberry Pi Blog entry. url: https://www.raspberrypi.org/blog/compute-module-cubesats/ (https://www.raspberrypi.org/blog/compute-module-cubesats/) (visited on 16/01/2021).
[30] Decena et al. Radiation Damage Threshold of Satellite COTS Components: Raspberry Pi Zero for Opal CubeSat – Utah State University. url: https://digitalcommons.usu.edu/cgi/viewcontent.cgi?article=1851&context=researchweek (https://digitalcommons.usu.edu/cgi/viewcontent.cgi?article=1851&context=researchweek) (visited on 16/01/2021).
[31] Daniel P. Violette. Arduino/Raspberry Pi: Hobbyist Hardware and Radiation Total Dose Degrad-ation – NASA Goddard Space Flight Center (GSFC) and University of Connecticut (UCONN). url: https://nepp.nasa.gov/workshops/eeesmallmissions/talks/11%5C%20-%5C%20THUR/1430%5C%20-%5C%202014-561-%5C%20Violette-Final-Pres-EEE-TN17486%5C%20v2.pdf (https://nepp.nasa.gov/workshops/eeesmallmissions/talks/11%5C%20-%5C%20THUR/1430%5C%20-%5C%202014-561-%5C%20Violette-Final-Pres-EEE-TN17486%5C%20v2.pdf) (visited on 16/01/2021).
[32] Oscar Gutiérrez et al. “TID characterization of COTS parts using radiotherapy linear accelerators”. In: IEICE Electronics Express 16.7 (2019), pp. 20190077–20190077. doi: 10.1587/elex.16. 20190077. (https://doi.org/10.1587/elex.16.20190077)
[33] DISCO One – A CubeSat concept by the TU Wien Space Team. url: https://spaceteam.at/cubesats/disco-one-concept/?lang=en (https://spaceteam.at/cubesats/disco-one-concept/?lang=en) (visited on 06/09/2020).
[34] DAVE (Damping and Vibrations Experiment) by PolySat from California Polytechnic State University. https://calpolynews.calpoly.edu/news_releases/2018/November/CubeSat_Earth_Image (https://calpolynews.calpoly.edu/news_releases/2018/November/CubeSat_Earth_Image) and https://mustangnews.net/cubesat-dave-sends-back-first-high-res-photo-of-earth/. (https://mustangnews.net/cubesat-dave-sends-back-first-high-res-photo-of-earth/) (Visited on 02/09/2020).
