Skh4rf/satNOGS/doc/ref/PrinzipschaltbildEmpfangsstation.pdf

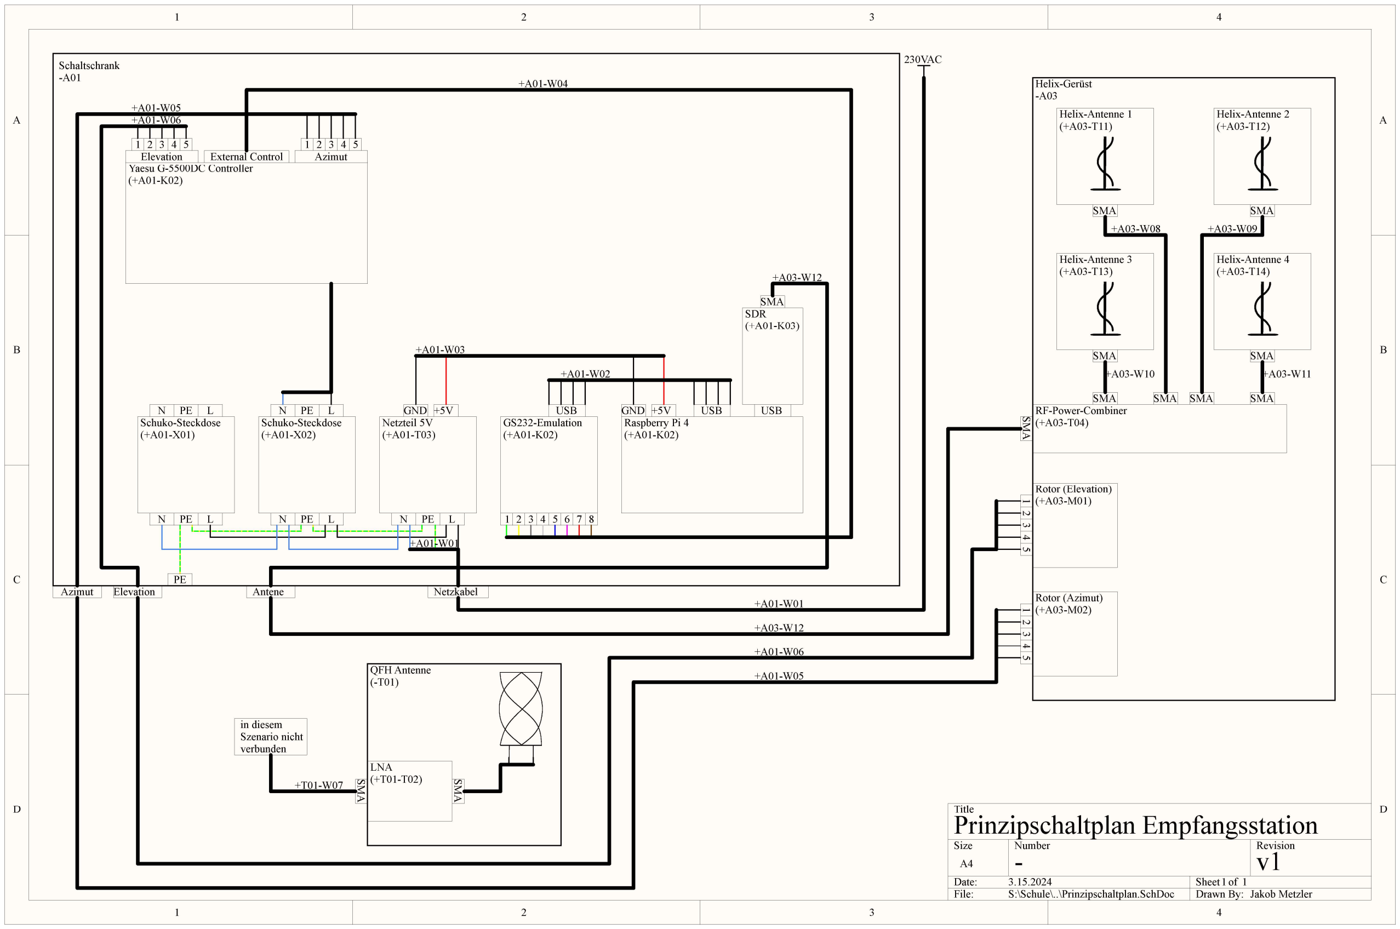
[picture p108: page 1]

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
Title

Size | Number | Revision
A4
Date: | 3.15.2024 | Sheet of
File: | S:\Schule\..\Prinzipschaltplan.SchDoc | Drawn By:

Yaesu G-5500DC Controller

Schuko-Steckdose | Schuko-Steckdose | Netzteil 5V
(+A01-X01)

(+A01-K02)

(+A01-X02) | (+A01-T03)

GS232-Emulation
(+A01-K02)

Raspberry Pi 4
(+A01-K02)

SDR
(+A01-K03)

+A01-W03

USB | USB | USB

+A01-W02

GND +5V | GND +5V

1 2 3 4 5 6 7 8

External Control

+A01-W04

N | L | N | L | N | L

230VAC Schaltschrank
-A01

Netzkabel
+A01-W01

QFH Antenne
(-T01)

LNA
(+T01-T02) SMA | SMA

Antene

SMA

+T01-W07

Helix-Antenne 1
(+A03-T11)

Helix-Antenne 2
(+A03-T12)

Helix-Antenne 4
(+A03-T14)

Helix-Antenne 3
(+A03-T13)
SMA | SMA
SMA | SMA

RF-Power-Combiner
(+A03-T04) SMA

Rotor (Elevation)
(+A03-M01)

Rotor (Azimut)
(+A03-M02)
SMA | SMA SMA | SMA
+A03-W10 | +A03-W11
+A03-W08 | +A03-W09 1 2 3 4 5 1 2 3 4 5

in diesem
Szenario nicht
verbunden
1 2 3 4 5 | 1 2 3 4 5
Elevation | Azimut
Azimut | Elevation

+A01-W06

+A01-W05

+A01-W06

+A01-W05

+A03-W12

Helix-Gerüst
-A03

+A03-W12

# Prinzipschaltplan Empfangsstation

- v1

1
Jakob Metzler

1

PE | PE | PE

PE

+A01-W01

N | L PE | N | L PE
