Skh4rf/satNOGS/doc/documentation-files/thesis.tex

%% LLT: Turn off some annoying warnings...
\RequirePackage{silence}
\RequirePackage{fancyhdr}
\WarningFilter{titlesec}{Non standard sectioning command}
\WarningFilter{scrreprt}{Usage of package}
\WarningFilter{scrreprt}{Activating an ugly workaround}

% *********************************************************
% CHOOSE THEME (ucph, sund, science, hum, samf, jura, teo)
% *********************************************************
\newcommand{\thesisTheme}{HTLR-Elektronik} % to colortheme and titlepage image

\documentclass[hidelinks,12pt,a4paper,twoside]{report}
\usepackage{Rusch-Vorlage}
\usepackage{pdfpages}

\bibliography{references.bib} %mehrsprachiges Bibliotheks(Literatur-)verzeichnis

\counterwithout{figure}{chapter} 
\counterwithout{equation}{chapter}
\counterwithout{table}{chapter}
\counterwithout{table}{section}
%TITELBLATT FÜR RUSCH
%---------------------------------------------------------
\pagestyle{fancy}
% Kopf- und Fußzeile
% ------------------
% Kopfzeile: links: Logo HTL Rankweil; mitte: Schulbezeichnung; rechts: Logo HTL
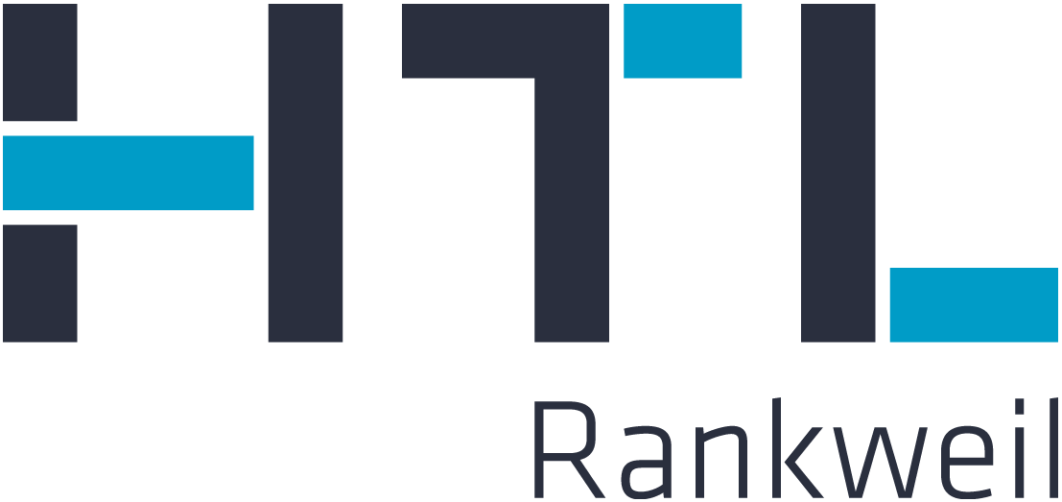
[picture p122: doc/ref/HTL_Rankweil_logo.png]
\lhead{\hspace{0.2cm} }
\chead{\textbf{HTBLuVA  Rankweil} 
	\\[0.05in]
	\footnotesize{\textit{Höhere Lehranstalt für Elektronik und Technische Informatik}}}
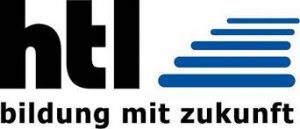
[picture p123: doc/ref/htl-logo-verdammt-alt.jpg]
\rhead{ \hspace{0.2cm}}

% Fußzeile
\fancyfoot{}
\usepackage{listings}
\usepackage{geometry}
\usepackage{listings}
\usepackage{color}
\usepackage{lscape}
\usepackage{hhline}
\usepackage{longtable}

\begin{document}

	% Titelseite
	\begin{center}
		\textbf {\huge {\uppercase {Diplomarbeit}}}
		\par \large {Gesamtprojekt}
		\par \textbf {\huge {\uppercase {Empfangsstation für globales Satellitenbodenstationsnetzwerk SatNOGS}}}
		\vspace{0.3cm}
		\linebreak
		
	\end{center}
	
	\vfill % damit der folgende am Blattende positioniert wird

	\begin{minipage}[t] {0.4\textwidth}
		\textbf{Teammitglieder:} \\
		Metzler Jakob \textbar{} 5AHEL \\
		Ritter Gabriel \textbar{} 5AHEL \\
	\end{minipage}
	\begin{minipage}[t] {0.4\textwidth}
		\textbf{Betreuer:} \\		
		\supervisor \\
	\end{minipage}
	
	\par Rankweil, am \PrintDate \\		
	
	\noindent\rule{\textwidth}{0.4pt}
	Abgabevermerk:
	\linebreak
	
	\begin{tabular}{p{7cm}C{6cm}}
		\hspace{1cm} DA original, am 28.05.2024 & ........................................ \\ 
		& \supervisor \\ [2.5em]
		
		\hspace{1cm} DA digital, am 28.05.2024 & ........................................ \\ 
		& AV Dipl.-Ing. Leopold Moosbrugger \\
	\end{tabular}

	% Leere Seite
	\newpage
	
	% ab jetzt andere Fußzeile
	%\fancyhead{}
	%\renewcommand{\headrulewidth}{0.0pt}
	\SecAuth{\emplLastA, \emplLastB} % festlegen der Verfasser dieses Kapitels
	
	\pagenumbering{Roman}
	\fancyfoot[LE,RO]{\thepage}
	\fancyfoot[LO,RE]{\DADate~\textbar~SatNOGS-Empfangsstation~\textbar ~\@SecAuth}
	\renewcommand{\footrulewidth}{0.4pt} % anzeigen Separator-Strich in der Fußzeile (standardmäßig deaktiviert)
	
	\setcounter{tocdepth}{2}		% define depth of toc

	%\AddToShipoutPicture*{\TitleBackground}     % adding background picture
	%\maketitle                                  % making the title
	%\input{frontbackmatter/titlepage.tex}
	%\clearpage
	\newpage
	
	\fancypagestyle{plain}{...} 
	\input{frontbackmatter/eidesstattliche_erklärung.tex}
	\input{frontbackmatter/abkürzungen+hinweise.tex}
	\tableofcontents				% display table of contents
	\newpage
	\pagenumbering{arabic}
	\input{frontbackmatter/documentation-de.tex}
	\newpage
	\input{frontbackmatter/documentation-en.tex}
	\newpage
	\SecAuth{\emplLastA}
	\fancyfoot[LO,RE]{\DADate~\textbar~SatNOGS-Empfangsstation~\textbar ~\@SecAuth}
	\input{frontbackmatter/summary.tex}
	\SecAuth{\emplLastA}
	\fancyfoot[LO,RE]{\DADate~\textbar~SatNOGS-Empfangsstation~\textbar ~\@SecAuth}
	\newpage
	\input{frontbackmatter/abstract.tex}      % INCLUDE Abstract
	\newpage
	
	\SecAuth{\emplLastA}
	\fancyfoot[LO,RE]{\DADate~\textbar~SatNOGS-Empfangsstation~\textbar ~\@SecAuth}
	\input{frontbackmatter/pflichtenheft.tex}
	\newpage
	
	\SecAuth{\emplLastA, \emplLastB}
	\fancyfoot[LO,RE]{\DADate~\textbar~SatNOGS-Empfangsstation~\textbar ~\@SecAuth}
	
	\input{frontbackmatter/quotes.tex}        % INCLUDE Quotes
	\newpage
	\input{frontbackmatter/utilized_software}
	\newpage
	
	% -------------------------- 
	% Main matter
	% --------------------------
	\setcounter{page}{1}			% set page counter
	%\pagestyle{maincontentstyle} 	% fancy header and footer

	\SecAuth{\emplLastB}
	\fancyfoot[LO,RE]{\DADate~\textbar~SatNOGS-Empfangsstation~\textbar ~\@SecAuth}
	\input{mainmatter/introduction.tex} % INCLUDE Introduction
	\newpage
	\SecAuth{\emplLastA}
	\fancyfoot[LO,RE]{\DADate~\textbar~SatNOGS-Empfangsstation~\textbar ~\@SecAuth}
	\input{mainmatter/gs-setup.tex}		% INCLUDE Groundstation setup
	\newpage
	\SecAuth{\emplLastA}
	\fancyfoot[LO,RE]{\DADate~\textbar~SatNOGS-Empfangsstation~\textbar ~\@SecAuth}
	\input{mainmatter/rotor.tex}
	\newpage
	\SecAuth{\emplLastA}
	\fancyfoot[LO,RE]{\DADate~\textbar~SatNOGS-Empfangsstation~\textbar ~\@SecAuth}
	\input{mainmatter/qfh-antenna.tex}
	\newpage
	\SecAuth{\emplLastB}
	\fancyfoot[LO,RE]{\DADate~\textbar~SatNOGS-Empfangsstation~\textbar ~\@SecAuth}
	\input{mainmatter/helixantenna.tex}
	\newpage
	\SecAuth{\emplLastA}
	\fancyfoot[LO,RE]{\DADate~\textbar~SatNOGS-Empfangsstation~\textbar ~\@SecAuth}
	\input{mainmatter/mechanics.tex}
	\newpage
	\SecAuth{\emplLastA}
	\fancyfoot[LO,RE]{\DADate~\textbar~SatNOGS-Empfangsstation~\textbar ~\@SecAuth}
	\input{mainmatter/projectmanagement.tex}
	\newpage
	\SecAuth{\emplLastA}
	\fancyfoot[LO,RE]{\DADate~\textbar~SatNOGS-Empfangsstation~\textbar ~\@SecAuth}
	\input{mainmatter/conclusion.tex}
	\newpage
	
	% -------------------------- 
	% Back matter
	% --------------------------
	\SecAuth{\emplLastA, \emplLastB}
	\fancyfoot[LO,RE]{\DADate~\textbar~SatNOGS-Empfangsstation~\textbar ~\@SecAuth}
	
	\input{frontbackmatter/preface.tex}
	\newpage
	\addcontentsline{toc}{chapter}{10 Abbildungsverzeichnis}
	\listoffigures
	\setcounter{chapter}{10}
	\newpage
	\input{frontbackmatter/bibliography.tex}
	\newpage
	\SecAuth{\emplLastA}
	\fancyfoot[LO,RE]{\DADate~\textbar~SatNOGS-Empfangsstation~\textbar ~\@SecAuth}
	\input{frontbackmatter/Fortschrittsbericht.tex}
	\newpage
	\SecAuth{\emplLastA, \emplLastB}
	\fancyfoot[LO,RE]{\DADate~\textbar~SatNOGS-Empfangsstation~\textbar ~\@SecAuth}
	\input{frontbackmatter/Anhang.tex}
	\input{frontbackmatter/group-protocol.tex}
	\input{frontbackmatter/project-structure.tex}
	\input{frontbackmatter/anmeldung.tex}
	
%---------------------------------------------------------

% *********************************************************
% DOCUMENT CLASS
% *********************************************************

%DOCUMENT CLASS CURRENTLY DISABLED FOR RUSCH VORLAGE
%\documentclass[%
%	paper=A4,					% paper size
%	12pt,						% font size
%	twoside=true,				% two-sided printing
%	openright,					% doublepage cleaning ends up right side
%	parskip=full,				% spacing value / method for paragraphs
%	chapterprefix=true,			% prefix for chapter marks
%	headings=normal,			% size of headings
%	bibliography=totoc,			% include bib in toc
%	listof=totoc,				% include listof entries in toc
%	titlepage=on,				% own page for each title page
%	captions=tableabove,		% display table captions above the float env
%	draft=false,				% value for draft version
%	abstract=on,                % abstract title on/off
%]{scrreprt}

\setlist{nosep}

% **************************************************
% COMMANDS FOR REUSE
% **************************************************

% Thesis
\newcommand{\thesisTitle}{Empfangsstation für globales Satellitenbodenstationsnetzwerk SatNOGS}
\newcommand{\thesisSubtitle}{}
\newcommand{\thesisName}{Ritter Gabriel und Metzler Jakob}
\newcommand{\thesisSubject}{Diplomarbeit}
\newcommand{\thesisDate}{2024}
\newcommand{\thesisVersion}{}

% Supervisors & Collaborators
\newcommand{\thesisExternalSupervisor}{}
\newcommand{\thesisInternalSupervisor}{König Christian}
\newcommand{\thesisCollab}{Technische Universität Wien}

% University of Copenhagen
\newcommand{\thesisUniversity}{\protect{Höhere Technische Bundeslehr- und Versuchsanstalt Rankweil}}
\newcommand{\thesisFaculty}{Elektronik und technische Informatik}
\newcommand{\thesisInstitute}{}
\newcommand{\thesisCity}{Rankweil}
\newcommand{\thesisAddress}{Negrellistraße 50}
\newcommand{\thesisPostal}{6830}

% External institution: University of Sussex
\newcommand{\thesisUniSus}{\protect{Technische Universität Wien}}
\newcommand{\thesisUniSusDep}{Space Team}

% *********************************************************
% PACKAGES
% *********************************************************

%modernes Layout

%\usepackage[					% UCPH thesis style
%    figuresep=colon,        
%    sansserif=false,        
%    hangfigurecaption=false,
%    hangsection=true,       
%    hangsubsection=true,    
%    colorize=full,          
%    colortheme={\thesisTheme},  % ucph, sund, science, hum, etc.?
%    
%sys=bibtex,
%    bibfile=references,       % defines your .bib file
%    bibstyle=authoryear,        % refer to https://bit.ly/2YsvIJz
%]{ucphthesis}

%\hypersetup{					% setup the hyperref-package options
%	pdftitle={\thesisTitle},	% 	- title (PDF meta)
%	pdfsubject={\thesisSubject},% 	- subject (PDF meta)
%	pdfauthor={\thesisName},	% 	- author (PDF meta)
%	plainpages=false,			% 	-
%	colorlinks=false,			% 	- colorize links
%	pdfborder={0 0 0},			% 	-
%	breaklinks=true,			% 	- allow line break inside links
%	bookmarksnumbered=true,		%
%	bookmarksopen=true			%
 %   }
    
%\addbibresource{references.bib} %Imports bibliography file

% *********************************************************
% Cover page content
% *********************************************************
%\subject{\vspace{4.5cm} \thesisSubject}
%\title{\thesisTitle}
%\subtitle{\thesisSubtitle}
%\author{\thesisName \\
%        \small{Betreuer: {\thesisInternalSupervisor}}
%    }
%\date{\thesisDate}

% ********************************************************* 
% THESIS CONTENT
% *********************************************************
%\begin{document}
% -------------------------- 
% Front matter
% --------------------------

% ********************************************************* 
% END OF THESIS
% *********************************************************
\end{document}
