Skh4rf/satNOGS/doc/documentation-files/frontbackmatter/Fortschrittsbericht.tex

\chapter{Fortschrittsbericht}

\section{Ritter Gabriel}

\begin{longtable}{|l|c|c|}
	\hline
	\textbf{Tätigkeit} & \textbf{Datum} & \textbf{Dauer} \\
	\hline
	Besprechen Diplomarbeitsantrag & 18.09.2023 & 03:40:00 \\
	\hline
	Dokumentation Grundstruktur erstellt & 25.09.2023 & 02:00:00 \\
	\hline
	Recherche QHA & 02.10.2023 & 03:40:00 \\
	\hline
	Firmenpartner anschreiben & 04.10.2023 & 01:40:00 \\
	\hline
	SatNOGS Netzwerk beschreiben & 09.10.2023 & 03:40:00 \\
	\hline
	SatNOGS Netzwerk beschreiben & 10.10.2023 & 01:00:00 \\
	\hline
	Recherche Baluns & 06.10.2023 & 01:00:00 \\
	\hline
	Antennen Funktionsweise beschreiben & 16.10.2023 & 03:40:00 \\
	\hline
	Fortführung Dokumentation & 18.12.2023 & 02:40:00 \\
	\hline
	Antennen Funktionsweise beschreiben & 23.10.2023 & 03:40:00 \\
	\hline
	Berechnung QHA & 01.11.2023 & 03:40:00 \\
	\hline
	Sponsorengespräch \& Messkammer organisieren (Omicron) & 08.11.2023 & 02:00:00 \\
	\hline
	Firmenpartner anschreiben & 23.11.2023 & 01:00:00 \\
	\hline
	Wellentheorie beschreiben & 04.12.2023 & 01:57:00 \\
	\hline
	Recherche CCSDS-Protokoll & 08.12.2023 & 01:00:00 \\
	\hline
	Recherche CCSDS-Protokoll & 09.12.2023 & 01:00:00 \\
	\hline
	Modellierung Schutzabdeckung Rotorsteuerung & 18.12.2023 & 01:00:00 \\
	\hline
	Dokumentation Vorlage erstellt & 29.12.2023 & 01:00:00 \\
	\hline
	Dokumentation Vorlage erstellt & 31.12.2023 & 01:45:00 \\
	\hline
	Dokumentation Vorlage erstellt & 01.01.2024 & 01:45:00 \\
	\hline
	Dokumentation Vorlage erstellt & 02.01.2024 & 00:55:00 \\
	\hline
	Vorwort erstellt \& Design sowie Struktur überarbeitet & 03.01.2024 & 01:00:00 \\
	\hline
	3D-Modell der Helix Antenne designt & 06.01.2024 & 04:00:00 \\
	\hline
	3d-Modell der Helix Antenne überarbeitet & 08.01.2024 & 01:30:00 \\
	\hline
	Helix-Antenne Theorie besprochen & 08.01.2024 & 03:40:00 \\
	\hline
	Schrack Vertrag ausgedruckt \& weitere Sponsoren geklärt & 12.01.2024 & 01:00:00 \\
	\hline
	Helix-Antenne überarbeitet (Aluminium + keine Kollisionen) & 13.01.2024 & 01:00:00 \\
	\hline
	Vorlage-Emails verfasst & 13.01.2024 & 01:55:00 \\
	\hline
	Präsentation SatNOGS + Helix-Antenne bearbeitet & 15.01.2024 & 04:05:00 \\
	\hline
	Präsi + Modifikationen an Helix-Antenne & 16.01.2024 & 01:00:00 \\
	\hline
	Präsentation weiter bearbeitet & 20.01.2024 & 01:00:00 \\
	\hline
	Präsentation fertiggestellt + Stichwortzettel & 21.01.2024 & 01:00:00 \\
	\hline
	Weitere Sponsoren angefragt & 23.01.2024 & 00:30:00 \\
	\hline
	Konstruktion für Helix-Antennen-Array & 23.01.2024 & 03:30:00 \\
	\hline
	Yaesu-G5500DC STL Modell zusammengefügt & 24.01.2024 & 00:30:00 \\
	\hline
	Helix-Strukturbolzen weitergearbeitet & 24.01.2024 & 01:00:00 \\
	\hline
	Helix finalisiert & 24.01.2024 & 03:30:00 \\
	\hline
	Helix Montageplatte modelliert & 25.01.2024 & 01:30:00 \\
	\hline
	QHA getestet & 25.01.2024 & 03:00:00 \\
	\hline
	Bauteile für Helix-Antenne herausgesucht & 26.01.2024 & 01:00:00 \\
	\hline
	Bauteile für Helix-Antenne herausgesucht & 26.01.2024 & 01:00:00 \\
	\hline
	Bauteile für Helix-Antenne herausgesucht & 27.01.2024 & 01:00:00 \\
	\hline
	Bauteile für Helix-Antenne herausgesucht & 27.01.2024 & 00:30:00 \\
	\hline
	Helix-Antenne weiter bearbeitet + Bauteile herausgesucht & 28.01.2024 & 02:30:00 \\
	\hline
	Weitere Sponsoren angefragt & 29.01.2024 & 01:00:00 \\
	\hline
	Helix-Antennen-Array bearbeitet & 29.01.2024 & 01:00:00 \\
	\hline
	Helix Antenne ideal rekonstruiert & 29.01.2024 & 04:12:00 \\
	\hline
	Helix-Antenne neu konstruiert & 30.01.2024 & 01:00:00 \\
	\hline
	Helix-Antenne neu konstruiert & 30.01.2024 & 01:00:00 \\
	\hline
	Helix-Antenne neu konstruiert + Leistungsanpassung informiert & 31.01.2024 & 00:45:00 \\
	\hline
	Helix-Antenne neu konstruiert & 04.02.2024 & 00:10:00 \\
	\hline
	Dokumentation weitergeführt & 10.02.2024 & 01:30:00 \\
	\hline
	Informationsbeschaffung + Materialbeschaffung & 11.02.2024 & 01:15:00 \\
	\hline
	Dokumentation weitergeführt & 11.02.2024 & 00:30:00 \\
	\hline
	Dokumentation weitergeführt & 11.02.2024 & 01:00:00 \\
	\hline
	Informationsbeschaffung zu Antennentheorie & 12.02.2024 & 00:30:00 \\
	\hline
	Informationsbeschaffung zu Antennentheorie & 15.02.2024 & 01:00:00 \\
	\hline
	Informationsbeschaffung zu Helix-Antennen & 18.02.2024 & 01:00:00 \\
	\hline
	Sponsoren vorbereitet & 19.02.2024 & 01:15:00 \\
	\hline
	QHA getestet & 19.02.2024 & 02:45:00 \\
	\hline
	Kunststoff bei SenTech für Helix-Antenne abholen & 19.02.2024 & 01:20:00 \\
	\hline
	Referenzen in Latex repariert & 19.02.2024 & 01:00:00 \\
	\hline
	Dokumentation zur Helix fertiggestellt & 20.02.2024 & 00:30:00 \\
	\hline
	Dokumentation zur Helix fertiggestellt & 20.02.2024 & 01:27:00 \\
	\hline
	Seitenelement erstellt & 21.02.2024 & 00:30:00 \\
	\hline
	Seitenelement erstellt & 21.02.2024 & 00:45:00 \\
	\hline
	Dokumentation zur Helix weitergeführt & 21.02.2024 & 00:55:00 \\
	\hline
	Dokumentation zur Helix weitergeführt & 22.02.2024 & 00:20:00 \\
	\hline
	Theorie Helix weitergeführt & 22.02.2024 & 01:00:00 \\
	\hline
	Theorie Helix weitergeführt & 22.02.2024 & 02:00:00 \\
	\hline
	Recherche Impedanzanpassung Helix & 22.02.2024 & 01:00:00 \\
	\hline
	Dokumentation weitergeführt & 23.02.2024 & 00:30:00 \\
	\hline
	Dokumentation weitergeführt & 24.02.2024 & 01:05:00 \\
	\hline
	Dokumentation weitergeführt & 24.02.2024 & 01:06:00 \\
	\hline
	Dokumentation weitergeführt & 24.02.2024 & 01:06:00 \\
	\hline
	Dokumentation weitergeführt & 25.02.2024 & 01:05:00 \\
	\hline
	Dokumentation weitergeführt & 25.02.2024 & 01:17:00 \\
	\hline
	Dokumentation weitergeführt & 25.02.2024 & 01:15:00 \\
	\hline
	Seitenelemente zugeschnitten + gedreht & 26.02.2024 & 04:00:00 \\
	\hline
	Dokumentation weitergeführt & 27.02.2024 & 01:00:00 \\
	\hline
	Dokumentation weitergeführt & 27.02.2024 & 00:30:00 \\
	\hline
	Informationssammlung Selbstphasenmodulation & 29.02.2024 & 00:30:00 \\
	\hline
	Dokumentation Theorie QHA & 01.03.2024 & 01:00:00 \\
	\hline
	Dokumentation Theorie QHA & 01.03.2024 & 00:26:00 \\
	\hline
	Informationssammlung Montage Helicalantenne & 02.03.2024 & 01:00:00 \\
	\hline
	Helixantennen-Array Montage & 02.03.2024 & 08:00:00 \\
	\hline
	Dokumentation & 03.03.2024 & 00:30:00 \\
	\hline
	Helixantennen-Array Messung und Tests & 04.03.2024 & 04:40:00 \\
	\hline
	Dokumentation & 04.03.2024 & 02:20:00 \\
	\hline
	Dokumentation & 05.03.2024 & 00:30:00 \\
	\hline
	Dokumentation & 05.03.2024 & 01:00:00 \\
	\hline
	Dokumentation & 05.03.2024 & 01:30:00 \\
	\hline
	Dokumentation + PVC Abdeckung designt & 05.03.2024 & 03:00:00 \\
	\hline
	Deckel neu designt + Dokumentation & 06.03.2024 & 00:30:00 \\
	\hline
	Helixantennen gemessen + Anpassstreifen neu dimensioniert & 06.03.2024 & 02:00:00 \\
	\hline
	Dokumentation & 06.03.2024 & 01:54:00 \\
	\hline
	Dokumentation & 07.03.2024 & 00:30:00 \\
	\hline
	Dokumentation & 07.03.2024 & 04:05:00 \\
	\hline
	Dokumentation & 08.03.2024 & 01:00:00 \\
	\hline
	Anpassung der Helix-Antennen & 09.03.2024 & 07:30:00 \\
	\hline
	Messung und finale Anpassung der Helix-Antennen & 11.03.2024 & 04:00:00 \\
	\hline
	Doku & 12.03.2024 & 01:00:00 \\
	\hline
	Dokumentation Helix & 13.03.2024 & 00:30:00 \\
	\hline
	Dokumentation Helix & 13.03.2024 & 01:40:00 \\
	\hline
	Dokumentation Helix & 14.03.2024 & 00:30:00 \\
	\hline
	Konstruktion Anpasstopf & 14.03.2024 & 03:00:00 \\
	\hline
	Konstruktion Anpasstopf + Deckeldruck + Dokumentation & 14.03.2024 & 03:04:00 \\
	\hline
	Test des Anpasstopfes & 15.03.2024 & 01:00:00 \\
	\hline
	Test des Antennenarrays & 16.03.2024 & 07:00:00 \\
	\hline
	Dokumentation & 17.03.2024 & 02:21:00 \\
	\hline
	Dokumentation & 17.03.2024 & 04:45:00 \\
	\hline
	Dokumentation & 18.03.2024 & 03:00:00 \\
	\hline
	Dokumentation & 18.03.2024 & 03:45:00 \\
	\hline
	Dokumentation & 18.03.2024 & 01:00:00 \\
	\hhline{|===|}
	\textbf{Gesamt} & \multicolumn{2}{c|}{207.42 Stunden} \\
	\hline
\end{longtable}

\section{Metzler Jakob}

\begin{longtable}{|l|c|c|}
	\hline
	\textbf{Tätigkeit} & \textbf{Datum} & \textbf{Dauer} \\
	\hline
	Besprechen Diplomarbeitsantrag & 18.09.2023 & 03:40:00 \\
	\hline
	Github Repository erstellen \& einrichten & 25.09.2023 & 00:14:00 \\
	\hline
	Kontaktieren möglicher Partner & 02.10.2023 & 00:30:00 \\
	\hline
	Monday.com einrichten & 03.10.2023 & 00:45:00 \\
	\hline
	Recherche Antennentypen & 04.10.2023 & 00:16:00 \\
	\hline
	Arbeitspakete erstellen & 04.10.2023 & 00:24:00 \\
	\hline
	Pflichtenheft erstellen & 02.10.2023 & 02:55:00 \\
	\hline
	Arbeitspakete erstellen & 06.10.2023 & 01:00:00 \\
	\hline
	Meilensteine definieren & 06.10.2023 & 00:30:00 \\
	\hline
	Arbeitspakete erstellen & 06.10.2023 & 00:28:00 \\
	\hline
	Arbeitspakete zuweisen & 06.10.2023 & 00:11:00 \\
	\hline
	Risikoplanung erstellen & 06.10.2023 & 00:25:00 \\
	\hline
	Pflichtenheft erstellen & 07.10.2023 & 00:20:00 \\
	\hline
	Pflichtenheft erstellen & 07.10.2023 & 00:55:00 \\
	\hline
	Recherche Antennentypen & 09.10.2023 & 00:46:00 \\
	\hline
	Recherche Baluns & 09.10.2023 & 02:54:00 \\
	\hline
	Recherche Baluns & 16.10.2023 & 01:30:00 \\
	\hline
	Pflichtenheft erstellen & 16.10.2023 & 01:31:00 \\
	\hline
	Recherche Antennentypen & 16.10.2023 & 00:29:00 \\
	\hline
	Recherche Baluns & 23.10.2023 & 03:25:00 \\
	\hline
	Registrierung im SatNOGS Netzwerk & 28.10.2023 & 03:41:00 \\
	\hline
	Sponsorengespräch \& Messkammer organisieren (Omicron) & 08.11.2023 & 02:00:00 \\
	\hline
	Fertigung der Antenne & 13.11.2023 & 03:40:00 \\
	\hline
	CAD-Plan für Antenne erstellen & 23.11.2023 & 01:45:00 \\
	\hline
	CAD-Plan für Antenne erstellen & 27.11.2023 & 03:40:00 \\
	\hline
	Sponsorengespräch \& Messkammer organisieren (Bachmann) & 28.11.2023 & 01:00:00 \\
	\hline
	Materialbeschaffung für Antenne & 30.11.2023 & 00:29:00 \\
	\hline
	Konzept Empfangsmodulhardware & 01.12.2023 & 01:51:00 \\
	\hline
	Materialbeschaffung für Empfangsmodulhardware & 04.12.2023 & 00:45:00 \\
	\hline
	CAD-Plan für Antenne erstellen & 04.12.2023 & 03:40:00 \\
	\hline
	Simulation \& Entwicklung QHA & 10.12.2023 & 07:08:00 \\
	\hline
	Simulation \& Entwicklung QHA & 17.12.2023 & 04:00:00 \\
	\hline
	Simulation \& Entwicklung QHA & 18.12.2023 & 02:35:00 \\
	\hline
	Materialbeschaffung für Antenne & 18.12.2023 & 01:05:00 \\
	\hline
	Assemblierung der Empfangsmodul-Hardware & 18.12.2023 & 02:20:00 \\
	\hline
	Fehlersuche Rotator & 26.12.2023 & 06:27:59 \\
	\hline
	Fehlersuche Rotator & 27.12.2023 & 01:30:00 \\
	\hline
	Fehlerbehebung Rotator \& Konfiguration & 27.12.2023 & 08:25:00 \\
	\hline
	Konfiguration Rotator & 28.12.2023 & 00:08:00 \\
	\hline
	Simulation \& Entwicklung QHA & 28.12.2023 & 02:45:00 \\
	\hline
	Assemblierung und Testen der Empfangsmodul-Hardware & 29.12.2023 & 01:33:00 \\
	\hline
	Bau der Antenne (QHA) & 07.01.2024 & 01:15:00 \\
	\hline
	Bau der Antenne (QHA) & 07.01.2024 & 04:17:00 \\
	\hline
	Bau der Antenne (QHA) & 08.01.2024 & 04:00:00 \\
	\hline
	Simulation der Helicoidal Antenne & 08.01.2024 & 01:31:00 \\
	\hline
	Bau der Antenne (QHA) & 09.01.2024 & 03:35:00 \\
	\hline
	Informations- und Teilbeschaffung für Antenna Array & 13.01.2024 & 02:44:00 \\
	\hline
	Konstruktion der Antenne + Planung Helicoidal Antenne & 15.01.2024 & 03:40:00 \\
	\hline
	Assemblierung der Hardware & 20.01.2024 & 05:15:00 \\
	\hline
	Zwischenpräsentation der Diplomarbeit & 22.01.2024 & 02:50:00 \\
	\hline
	Ausmessen der QHA & 25.01.2024 & 01:55:00 \\
	\hline
	Simulieren der Helix-Antenne & 28.01.2024 & 02:30:00 \\
	\hline
	Simlieren der Helix-Antenne & 28.01.2024 & 01:50:00 \\
	\hline
	QHA anpassen & 29.01.2024 & 04:15:00 \\
	\hline
	QHA anpassen & 05.02.2024 & 04:15:00 \\
	\hline
	Helix-Antenne simulieren & 08.02.2024 & 00:30:00 \\
	\hline
	QHA Reflexionsmessungen + Anpassen & 08.02.2024 & 05:25:00 \\
	\hline
	QHA Abdeckkappe zeichnen & 12.02.2024 & 01:00:00 \\
	\hline
	QHA Signal-Analyzer Messungen & 19.02.2024 & 02:20:00 \\
	\hline
	Kunststoff bei SenTech für Helix-Antenne abholen & 19.02.2024 & 01:20:00 \\
	\hline
	Kunstoff für Helix-Antenne bearbeiten & 27.02.2024 & 03:40:00 \\
	\hline
	Kunstoff für Helix-Antenne bearbeiten & 27.02.2024 & 01:40:00 \\
	\hline
	Dokumentation Rotor & 27.02.2024 & 01:59:59 \\
	\hline
	Dokumentation Rotor & 28.02.2024 & 00:01:00 \\
	\hline
	Dokumentation Rotor  & 28.02.2024 & 02:05:00 \\
	\hline
	Dokumentation Rotor & 29.02.2024 & 02:00:00 \\
	\hline
	Rohrklemmen bearbeiten & 29.02.2024 & 03:30:00 \\
	\hline
	Helix-Antennen Array Montage & 02.03.2024 & 09:00:00 \\
	\hline
	LNA-Gehäuse fertigen & 03.03.2024 & 00:45:00 \\
	\hline
	Helix-Antennen Array  in Transportfahrzeug laden & 03.03.2024 & 00:15:00 \\
	\hline
	Dokumentation Rotor & 03.03.2024 & 02:30:00 \\
	\hline
	Anpassung Helix-Antennen, Assemblierung Antennenmast & 04.03.2024 & 03:40:00 \\
	\hline
	Dokumentation Rotor & 04.03.2024 & 01:29:59 \\
	\hline
	Dokumentation Rotor & 05.03.2024 & 01:14:00 \\
	\hline
	Schaltung für diskreten RF-Combiner entwickeln  & 06.03.2024 & 01:35:00 \\
	\hline
	PCB für diskreten RF-Combiner erstellen \& Bauteile bestellen & 06.03.2024 & 01:14:59 \\
	\hline
	PCB für diskreten RF-Combiner erstellen \& Bauteile bestellen & 07.03.2024 & 02:20:00 \\
	\hline
	RF-Combiner bestücken & 07.03.2024 & 01:00:00 \\
	\hline
	Kabel konfektionieren, RF-Combiner testen & 11.03.2024 & 03:40:00 \\
	\hline
	Observationen mit QHA durchführen & 11.03.2024 & 03:45:00 \\
	\hline
	Dokumentation schreiben und Observationen durchführen & 12.03.2024 & 01:15:00 \\
	\hline
	Dokumentation schreiben & 12.03.2024 & 05:36:00 \\
	\hline
	Dokumentation schreiben & 12.03.2024 & 02:28:00 \\
	\hline
	Observationen planen (QHA) & 12.03.2024 & 00:20:00 \\
	\hline
	Dokumentation schreiben & 13.03.2024 & 07:23:00 \\
	\hline
	Feldmessung QHA & 14.03.2024 & 01:00:00 \\
	\hline
	Feldmessung QHA & 14.03.2024 & 03:45:00 \\
	\hline
	Dokumentation schreiben & 14.03.2024 & 05:29:59 \\
	\hline
	Dokumentation schreiben & 15.03.2024 & 03:21:00 \\
	\hline
	Dokumentation schreiben & 15.03.2024 & 04:10:00 \\
	\hline
	Dokumentation schreiben & 15.03.2024 & 04:59:59 \\
	\hline
	Dokumentation schreiben & 16.03.2024 & 03:14:00 \\
	\hline
	Helix-Array Observationen durchführen & 16.03.2024 & 07:00:00 \\
	\hline
	Dokumentation schreiben & 17.03.2024 & 03:20:00 \\
	\hline
	Dokumentation schreiben & 17.03.2024 & 07:49:59 \\
	\hline
	Dokumentation schreiben & 18.03.2024 & 02:09:00 \\
	\hline
	Dokumentation schreiben & 18.03.2024 & 08:14:59 \\
	\hline
	Dokumentation schreiben & 19.03.2024 & 03:20:00 \\
	\hline
	Dokumentation schreiben & 19.03.2024 & 09:29:59 \\
	\hline
	Dokumentation schreiben & 20.03.2024 & 04:00:00 \\
	\hhline{|===|}
	\textbf{Gesamt} & \multicolumn{2}{c|}{273.9 Stunden} \\
	\hline
\end{longtable}
