Skh4rf/satNOGS/doc/documentation-files/frontbackmatter/utilized_software.tex

\chapter{Verwendete Software und Tools}

\begin{tabular}{|c|c|}
	\hline
	\textbf{Name} & \textbf{Verwendungszweck} \\
	\hline
	Monday.com & Projektmanagement \\
	\hline
	Microsoft Excel & Stundenerfassung \\
	\hline
	GitHub Desktop & Zusammenarbeit an einem Projekt\\
	\hline
	Autodesk Fusion 360 & Konstruktion der monofilaren Helixantenne\\
	\hline
	SOLIDWORKS 2022 & Konstruktion der QHA-Antenne\\
	\hline
	Prusa Slicer & Umwandlung von Konstruktionen in g-Code\\
	\hline
	CENOS Radio Frequency & Simulation der Antennen\\
	\hline
	GeoGebra & Darstellung mathematischer Funktionen\\
	\hline
	TexStudio & Verfassung der schriftlichen Diplomarbeit\\
	\hline
	Altium Designer Professional & Design eines Arduino-Shields\\
	\hline
\end{tabular}
