Skh4rf/satNOGS/doc/documentation-files/frontbackmatter/anhang.tex

\chapter{Anhang}
\label{chap:Anhang}
	\begin{figure}[h!]
	\centering
	
	\caption{Der Bohrplan des PVC-Rohres}
	\label{fig:PVCU-Rohr-Bohrplan}
\end{figure}

	\begin{figure}[h!]
	\centering
	
	\caption{Zeichnung des Abstandhalters}
	\label{fig:Abstandhalter-Zeichnung}
\end{figure}

	\begin{figure}[h!]
	
	\caption{Zeichnung der Teflonplatte}
	\label{fig:Teflonplatte-Zeichnung}
\end{figure}

\begin{figure}[h!]
	
	\caption{Zeichnung des oberen Helixdeckels}
	\label{fig:Spirale-Deckel-oben}
\end{figure}

	\begin{figure}[h!]
	
	\caption{Zeichnung des unteren Helixdeckels}
	\label{fig:Spirale-Deckel-unten}
\end{figure}

	\begin{figure}[h!]
	
	\caption{Zeichnung der Spirale der Helixantenne}
	\label{fig:Spirale-Antenne}
\end{figure}

	\begin{figure}[h!]
	
	\caption{Zeichnung des Reflektors}
	\label{fig:Reflektor-Zeichnung}
\end{figure}

	\begin{figure}[h!]
	
	\caption{Zeichnung des Rohrschnitts des Antennen-Rohrflansches}
	\label{fig:Rohrschnitt-Rohrflansch-Antenne}
\end{figure}

\begin{figure}[h!]
	
	\caption{Zeichnung der Grundplatte des Antennen-Rohrflansches}
	\label{fig:Grundplattelatte-Rohrflansch-Antenne}
\end{figure}

\begin{figure}[h!]
	
	\caption{Zeichnung des Antennen-Rohrflansches}
	\label{fig:Rohrflansch-Antenne}
\end{figure}

\begin{figure}[h!]
	
	\caption{Zeichnung der Helixantennen Baugruppe}
	\label{fig:Zeichnung der Helixantenne}
\end{figure}

\begin{figure}[h!]
	
	\caption{Zeichnung des Antennen Booms}
	\label{fig:Zeichnung-Antennenboom}
\end{figure}

\begin{figure}[h!]
	
	\caption{Zeichnung des Vierkantrohres}
	\label{fig:Zeichnung-Vierkantrohr}
\end{figure}

\begin{figure}[h!]
	
	\caption{Zeichnung der Abdeckung des Vierkantrohres}
	\label{fig:Zeichnung-Vierkantrohr-Abdeckung}
\end{figure}

\begin{figure}[h!]
	
	\caption{Zeichnung des Rohrschnitts des Struktur-Rohrflansches}
	\label{fig:Zeichnung-Strukturrohrflansch-Rohrschnitt}
\end{figure}

\begin{figure}[h!]
	
	\caption{Zeichnung der Grundplatte des Struktur-Rohrflansches}
	\label{fig:Zeichnung-Strukturrohrflansch-Grundplatte}
\end{figure}

\begin{figure}[h!]
	
	\caption{Zeichnung des Struktur-Rohrflansches}
	\label{fig:Zeichnung-Strukturrohrflansch}
\end{figure}

\begin{figure}[h!]
	
	\caption{Zeichnung des Gerüsts}
	\label{fig:Zeichnung-Gerüst}
\end{figure}

\begin{figure}[h!]
	
	\caption{Zeichnung des Antennenarrays}
	\label{fig:Zeichnung-Antennenarray}
\end{figure}

\begin{figure}[h!]
	
	\caption{Zeichnung des Außenleiters des Anpasstopfes}
	\label{fig:Zeichnung-anpasstopf-vierkantrohr}
\end{figure}

\begin{figure}[h!]
	
	\caption{Zeichnung des Innenleiters des Anpasstopfes}
	\label{fig:Zeichnung-anpasstopf-innenleiter}
\end{figure}

\begin{figure}[h!]
	
	\caption{Zeichnung der Abdeckung des Anpasstopfes}
	\label{fig:Zeichnung-anpasstopf-Abdeckung}
\end{figure}

\begin{figure}[h!]
	
	\caption{Zeichnung des Anpasstopfes}
	\label{fig:Zeichnung-anpasstopf}
\end{figure}
