Skh4rf/satNOGS/doc/documentation-files/frontbackmatter/anmeldung.tex

\chapter{Anmeldung}
\begin{figure} [H]
	\centering
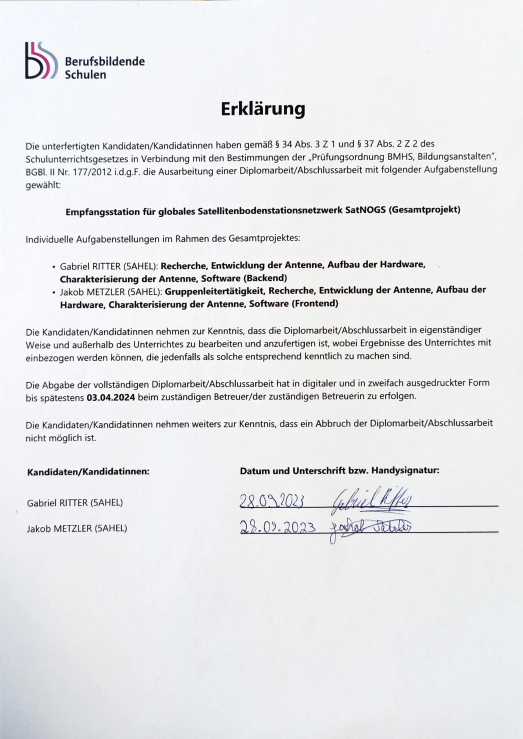
[picture p139: doc/ref/anmeldung.png]
	
	\label{fig:anmeldung}
\end{figure}
