Skh4rf/satNOGS/doc/documentation-files/frontbackmatter/group-protocol.tex

\chapter{Gruppenprotokoll}

\section*{Protokoll 1}
\begin{tabular}{p{.30\textwidth} p{.70\textwidth}}
	Datum: 18.09.2023 \\
	Gesprächspartner: & Christian König, Gabriel Ritter, Jakob Metzler \\
	Behandelter Inhalt: & Erstellung des Diplomarbeitsantrags \newline
	Gabriel Ritter: Erstellung des Diplomarbeitsantrags \newline
	Jakob Metzler: Erstellung des Diplomarbeitsantrags \newline
\end{tabular}

\section*{Protokoll 2}
\begin{tabular}{p{.30\textwidth} p{.70\textwidth}}
	Datum: 08.11.2023 \\
	Gesprächspartner: & Wilfried Häusle, Gabriel Ritter, Jakob Metzler \\
	Behandelter Inhalt: & Vorstellung des Projektes, Messzelle besprochen \newline
	Gabriel Ritter: Vorstellung der Diplomarbeit \newline
	Jakob Metzler: Vorstellung der Diplomarbeit \newline
\end{tabular}

\section*{Protokoll 3}
\begin{tabular}{p{.30\textwidth} p{.70\textwidth}}
	Datum: 07.12.2023 \\
	Gesprächspartner: & Gabriel Ritter, Raphael Behrle (TU Wien) \\
	Behandelter Inhalt: & aktueller Stand der Diplomarbeit, Fragen zum Satellit \newline
	Gabriel Ritter: Vorstellung der Diplomarbeit \newline
\end{tabular}

\section*{Protokoll 4}

\begin{tabular}{p{.30\textwidth} p{.70\textwidth}}
	Datum: 07.02.2024 \\
	Gesprächspartner: & Herr Staudinger, Gabriel Ritter, Jakob Metzler \\
	Behandelter Inhalt: & Gespräch Unterstützung Peak Technology \newline
	Gabriel Ritter: Vorstellung der Diplomarbeit \newline
	Jakob Metzler: Vorstellung der Diplomarbeit \newline
\end{tabular}
