Skh4rf/satNOGS/doc/documentation-files/frontbackmatter/eidesstattliche_erklärung.tex

\section*{Eidesstattliche Erklärung}
Ich erkläre an Eides statt, dass ich die vorliegende Diplomarbeit selbständig und ohne fremde
Hilfe verfasst, andere als die angegebenen Quellen und Hilfsmittel nicht benutzt und die den
benutzten Quellen wörtlich und inhaltlich entnommenen Stellen als solche erkenntlich
gemacht habe.

\vspace{0.3cm}
Rankweil, am 
\linebreak
\linebreak

\begin{tabular}{ll}
	& ........................................ \\
	& Gabriel Ritter  \\ [2.5em]
	& ........................................ \\
	& Jakob Metzler  \\ [2.5em]
\end{tabular}
