Skh4rf/satNOGS/doc/general-files/Infotag_SatNOGS-Netzwerk_Ritter_Metzler.pptx

Diplomarbeit

2023/24/Wintersemester/13. Schulstufe

Bau einer Empfangsstation für das SatNOGS-Netzwerk

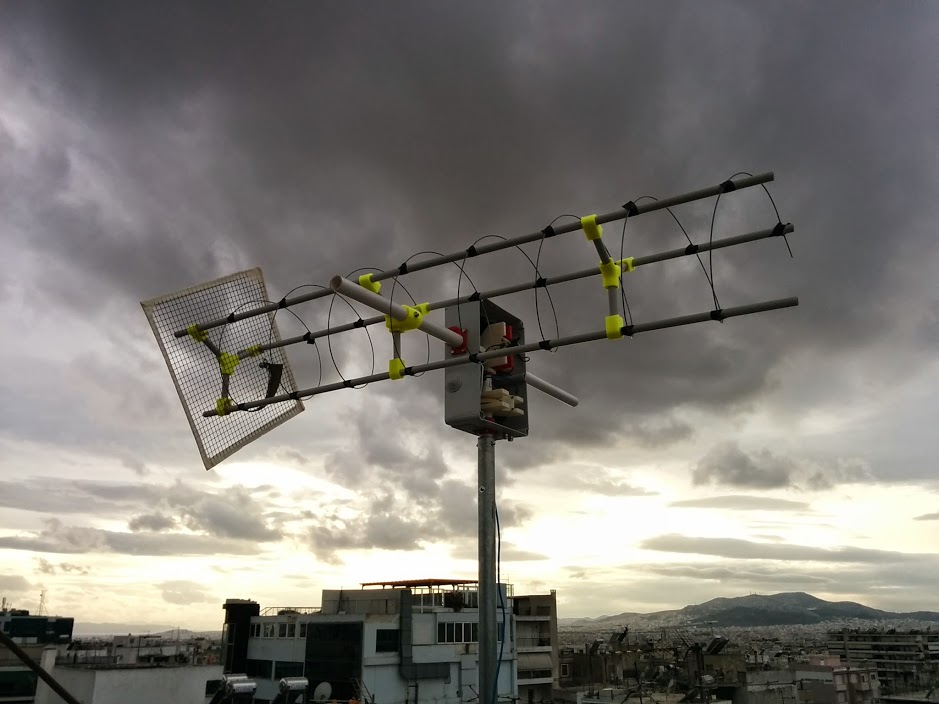
[picture p140: figure]
Projects – SatNOGS

Durch diese Bodenstationen können von vielen Satelliten Daten rund um die Uhr empfangen werden, da jeder Zugriff auf sie hat.

Das SatNOGS Netzwerk

Das SatNOGS-Netzwerk ist eine Ansammlung an freiwillig betriebenen Satelliten-Empfangsstationen um den gesamten Globus.


Links ist eine Weltkarte mit den Bodenstationen zu sehen.
grün: online
orange: wird getestet

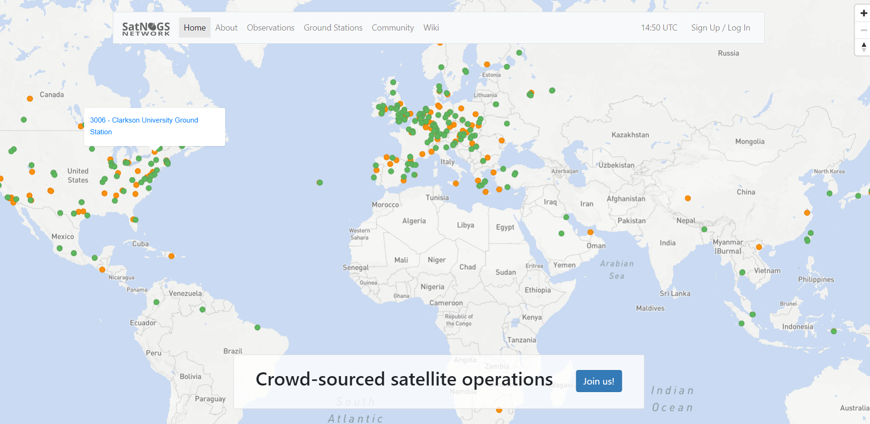
[picture p141: figure]
