Skh4rf/satNOGS/doc/documentation-files/figures/theme/HTLR-Elektronik.pdf

Höhere Technische Bundeslehr- und Versuchsanstalt Rankweil

Elektronik und technische Informatik
