Skh4rf/satNOGS/doc/documentation-files/figures/theme/HTLR_watermark.pdf

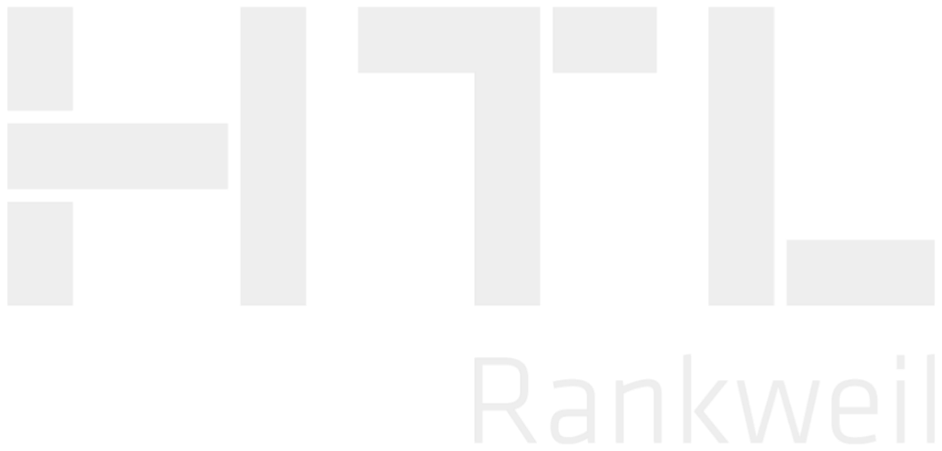
[picture p150: figure]
