Skh4rf/satNOGS/doc/documentation-files/figures/Quote-Marks.png

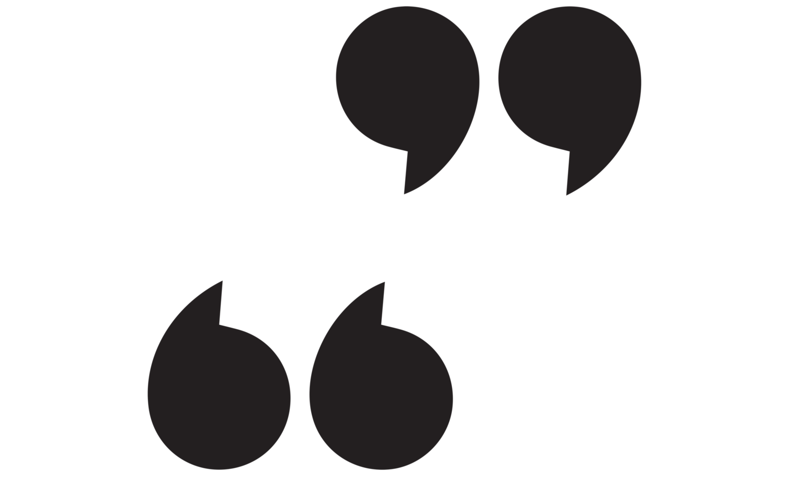
doc/documentation-files/figures/Quote-Marks.png
