Skh4rf/satNOGS/doc/ref/Abstandhalter Render.png

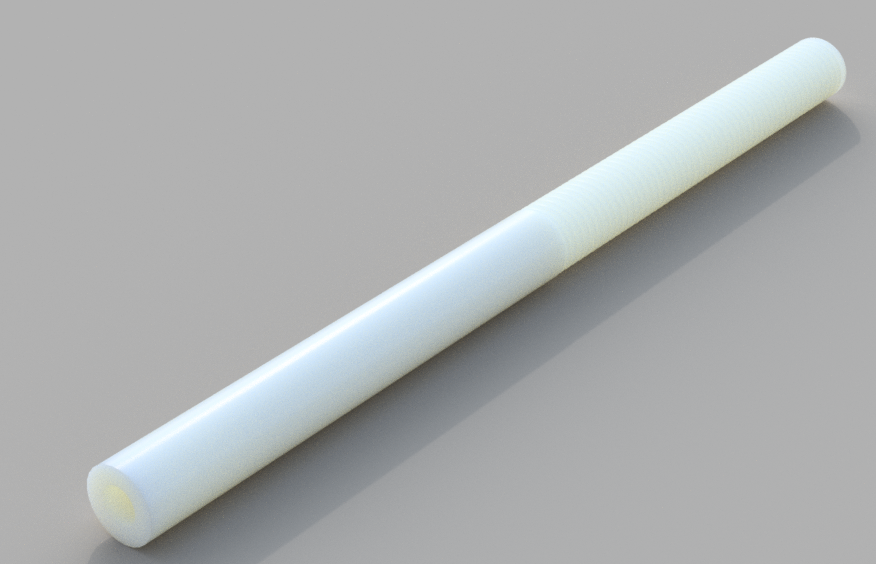
doc/ref/Abstandhalter Render.png
