Skh4rf/satNOGS/doc/ref/Antenne-Rohrflansch.jpg

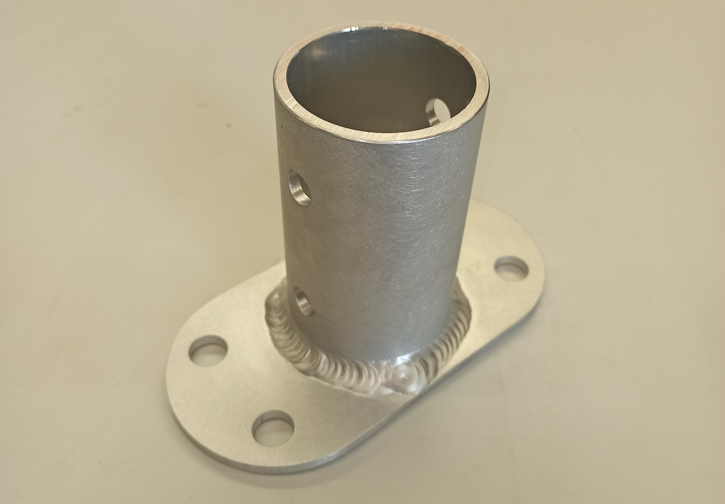
doc/ref/Antenne-Rohrflansch.jpg
