Skh4rf/satNOGS/doc/ref/Azimuth-Altitude_schematic.png

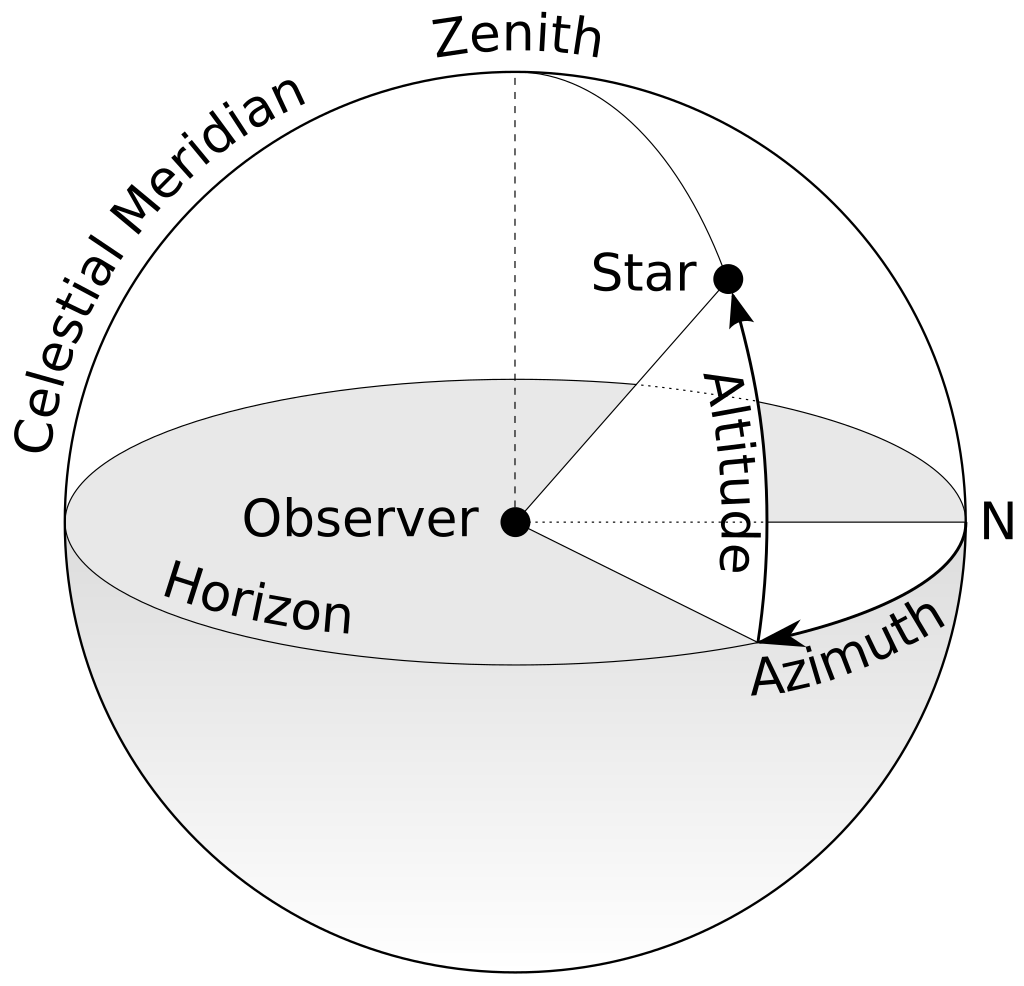
doc/ref/Azimuth-Altitude_schematic.png
