Skh4rf/satNOGS/doc/ref/Bohrungen-PVC.jpg

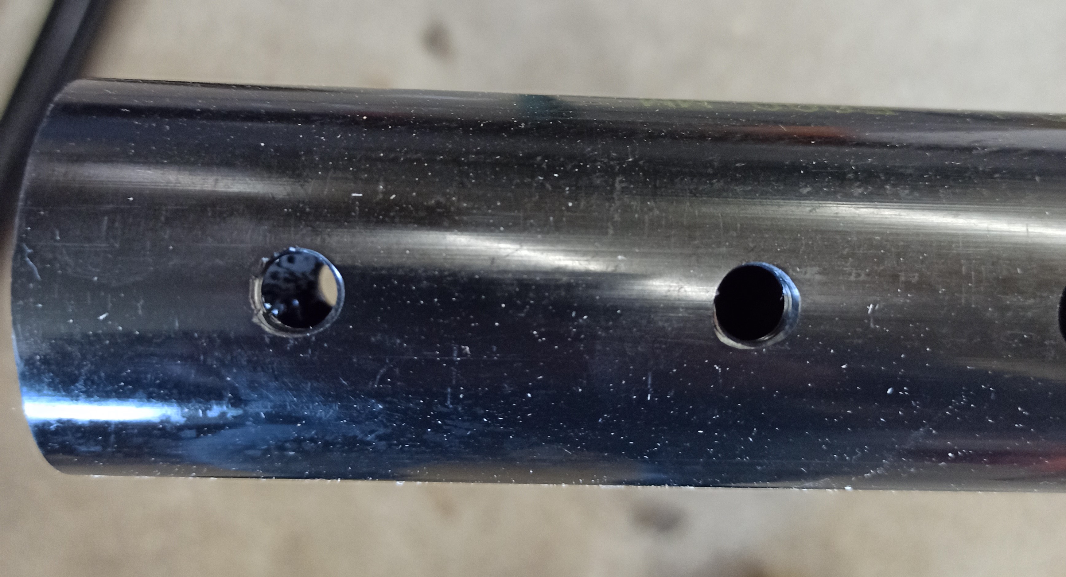
doc/ref/Bohrungen-PVC.jpg
