Skh4rf/satNOGS/doc/ref/Helix_symbol.png

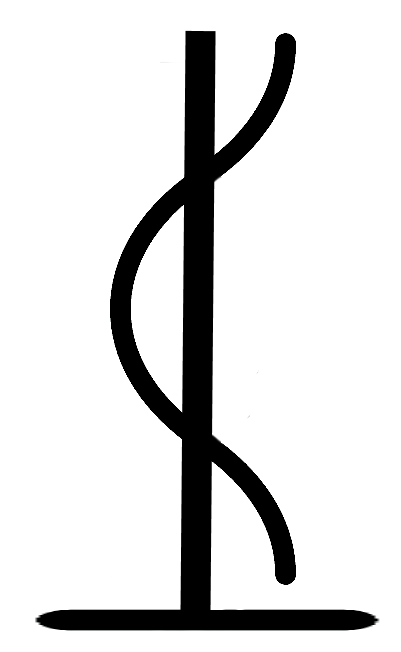
doc/ref/Helix_symbol.png
