Skh4rf/satNOGS/doc/ref/Jcoppens-helix.png

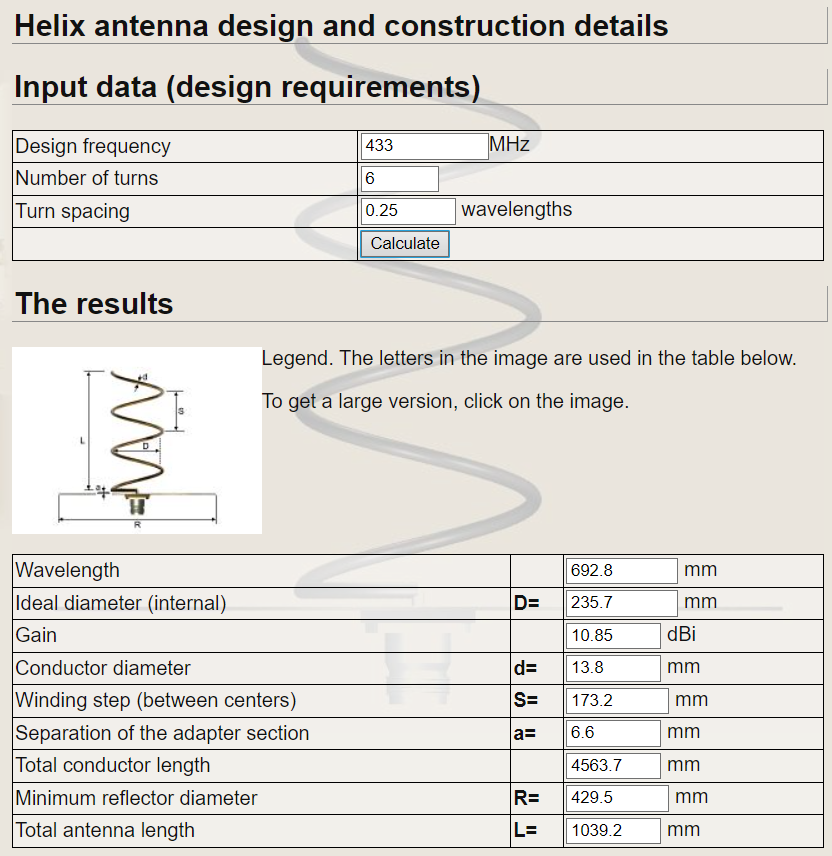
doc/ref/Jcoppens-helix.png
