Skh4rf/satNOGS/doc/ref/LNA02.jpeg

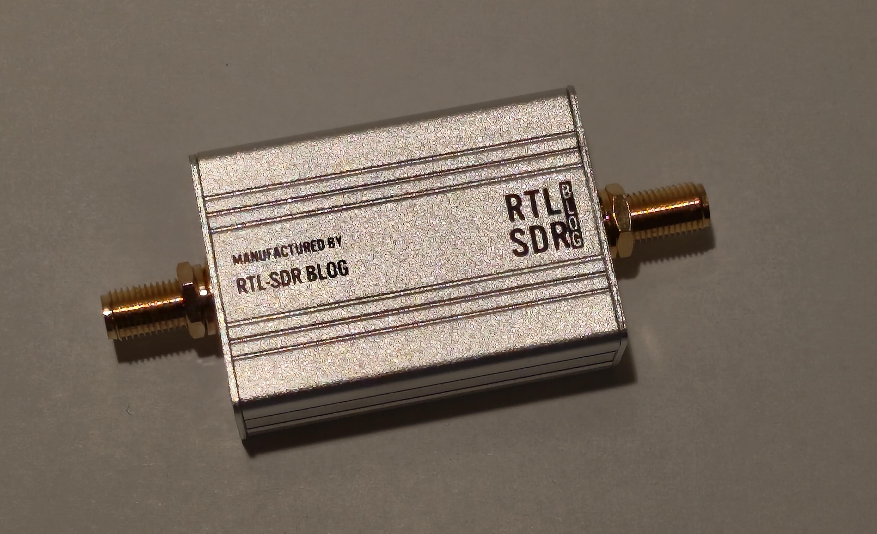
doc/ref/LNA02.jpeg
