Skh4rf/satNOGS/doc/ref/LNA03.jpeg

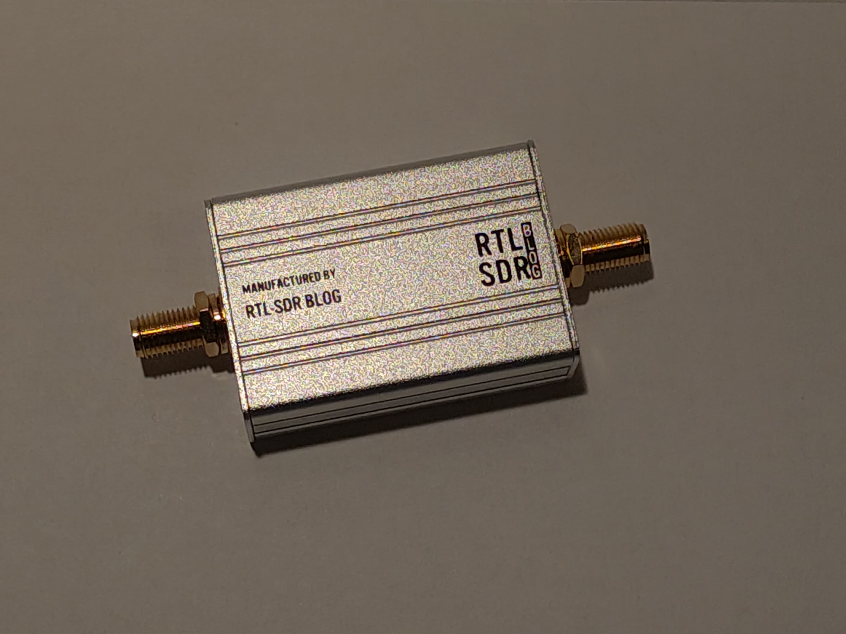
doc/ref/LNA03.jpeg
