Skh4rf/satNOGS/doc/ref/LNA_Box_Deckel.jpeg

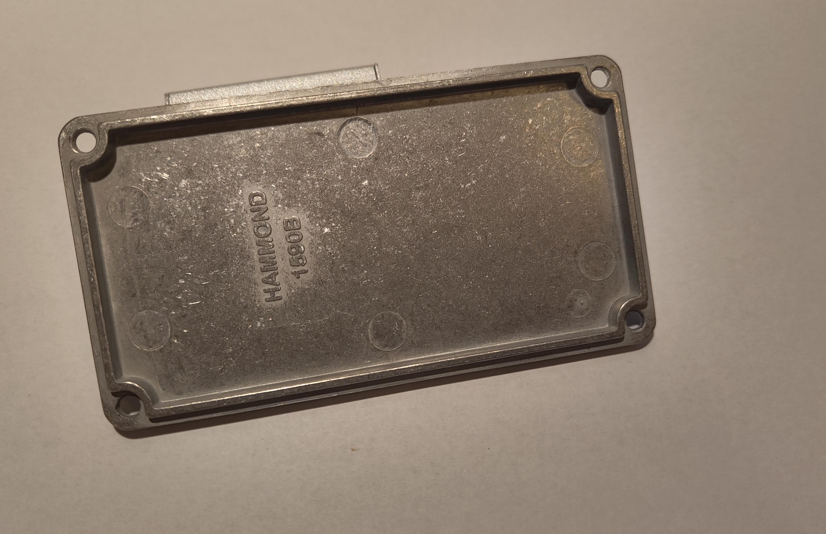
doc/ref/LNA_Box_Deckel.jpeg
