Skh4rf/satNOGS/doc/ref/LNA_Box_Dichtung.jpeg

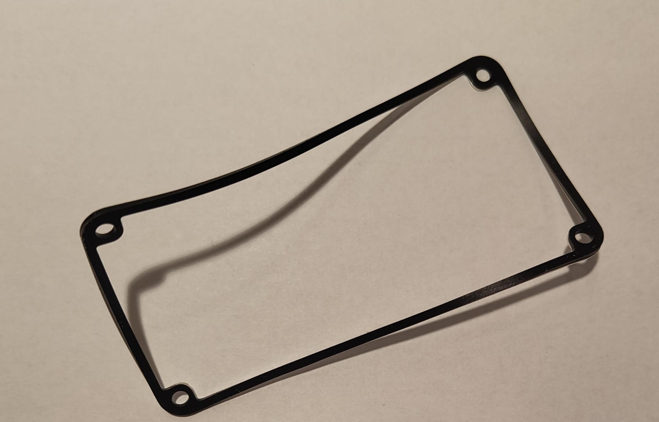
doc/ref/LNA_Box_Dichtung.jpeg
