Skh4rf/satNOGS/doc/ref/LNA_Box_offen.jpeg

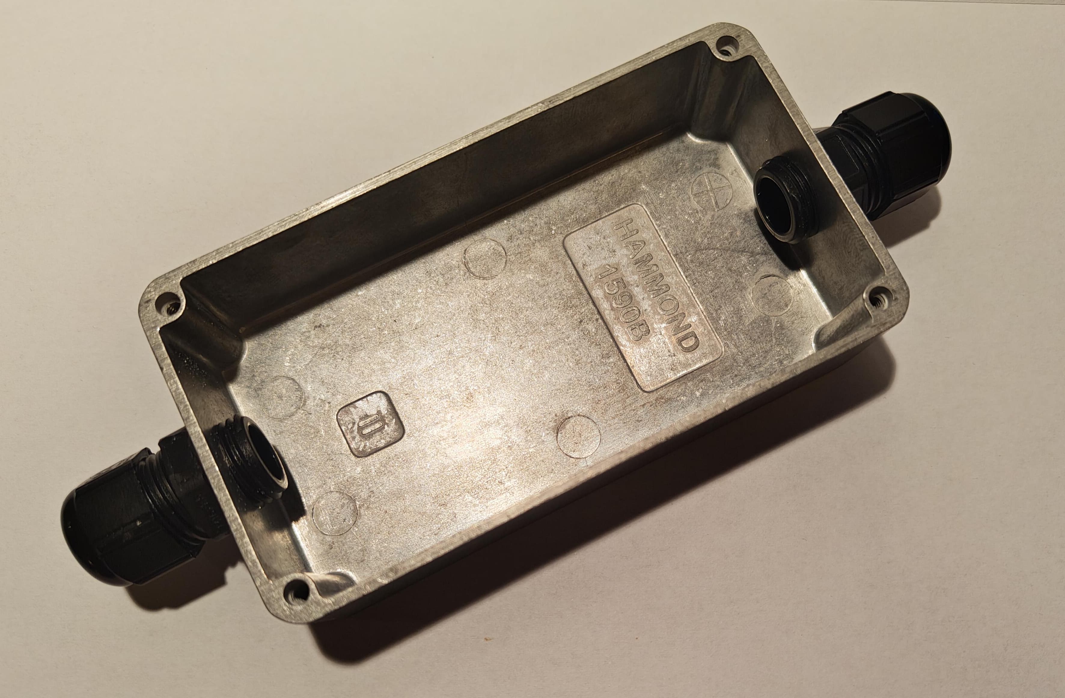
doc/ref/LNA_Box_offen.jpeg
