Skh4rf/satNOGS/doc/ref/LNA_Box_Schraube.jpeg

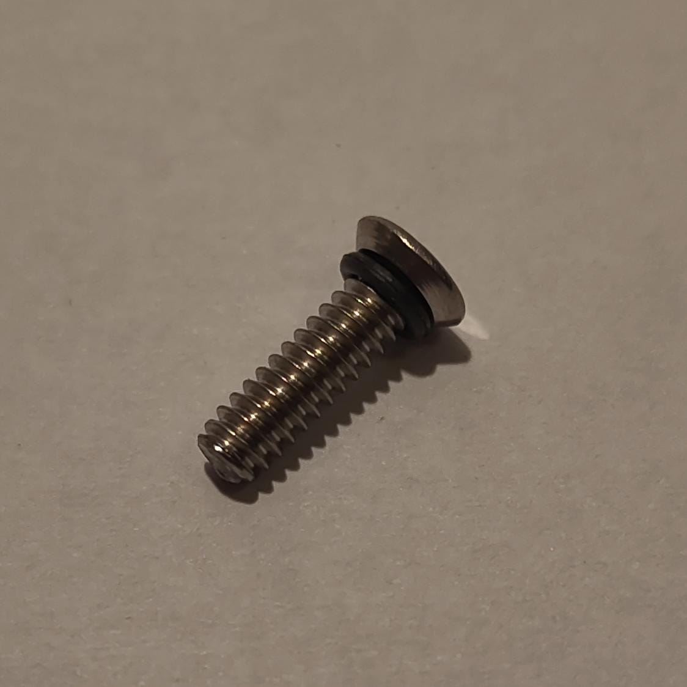
doc/ref/LNA_Box_Schraube.jpeg
