Skh4rf/satNOGS/doc/ref/LNA_Box_Schraube_02.jpeg

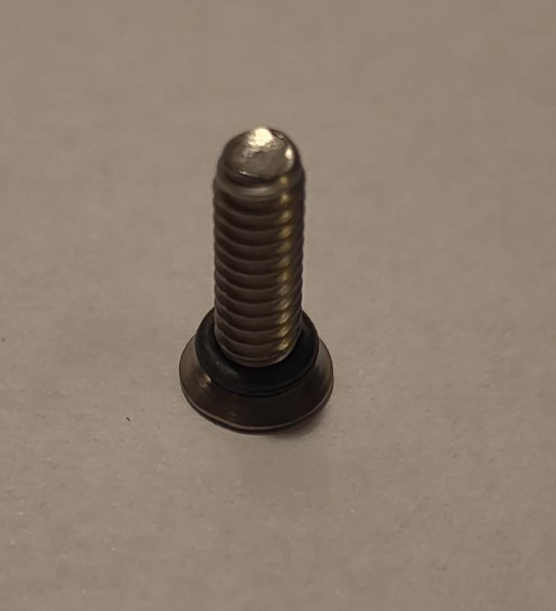
doc/ref/LNA_Box_Schraube_02.jpeg
