Skh4rf/satNOGS/doc/ref/PCB_Oben_01_GS232.jpeg

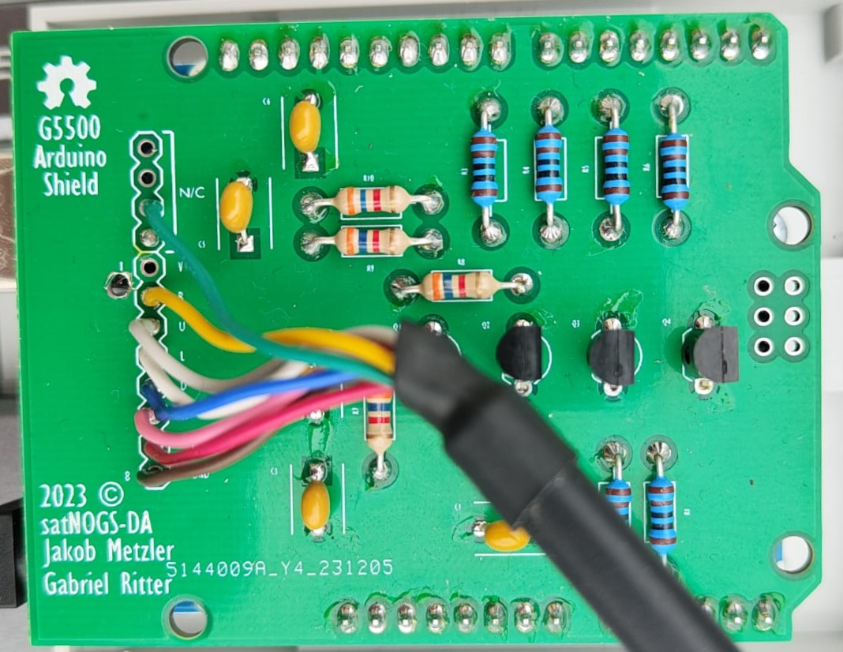
doc/ref/PCB_Oben_01_GS232.jpeg
