Skh4rf/satNOGS/doc/ref/PVC-Rohr.jpg

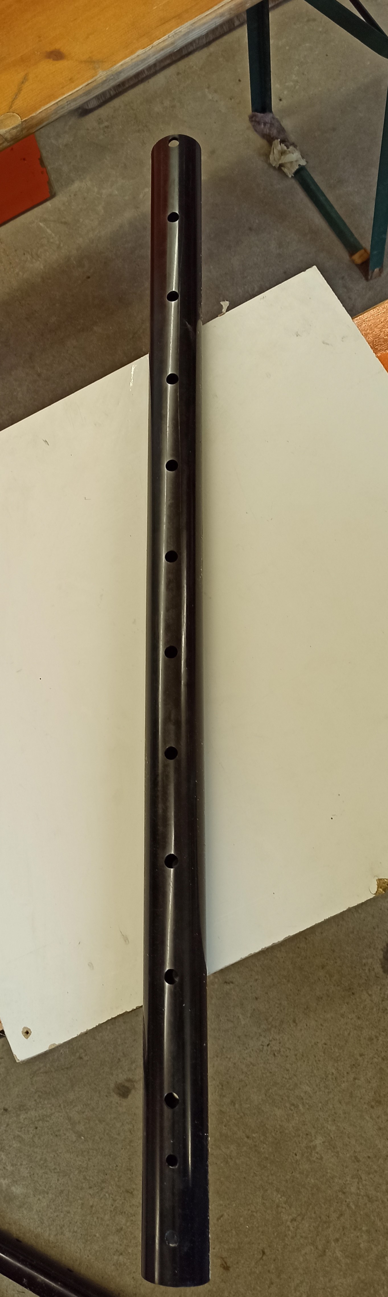
doc/ref/PVC-Rohr.jpg
