Skh4rf/satNOGS/doc/ref/QFH.jpg

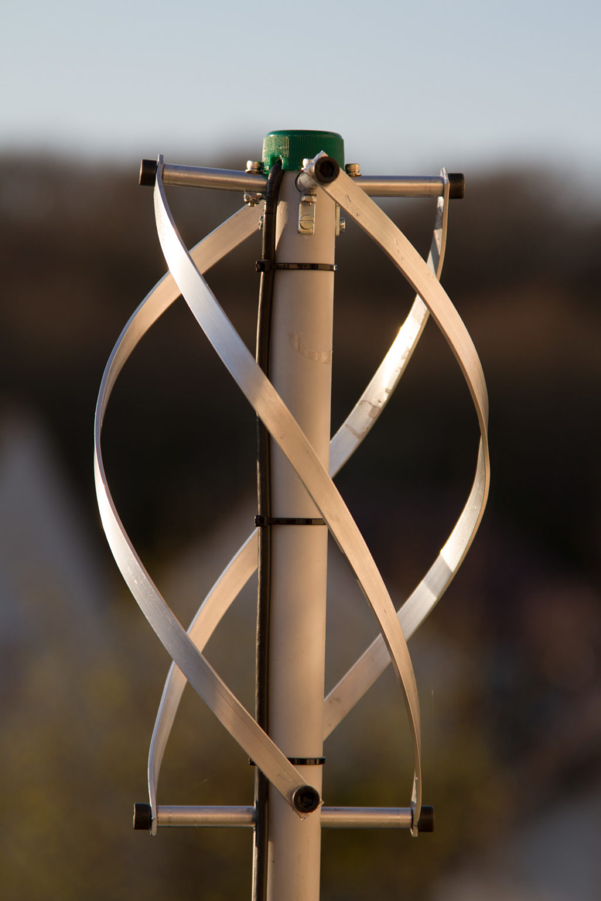
doc/ref/QFH.jpg
