Skh4rf/satNOGS/doc/ref/QFH_symbol.png

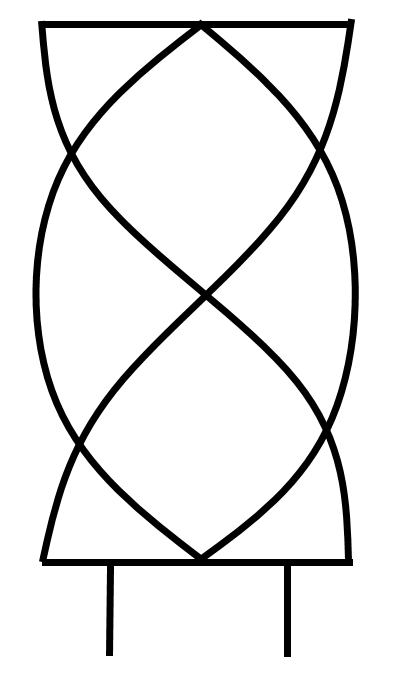
doc/ref/QFH_symbol.png
