Skh4rf/satNOGS/doc/ref/QFHHelix_vIZY67y.png

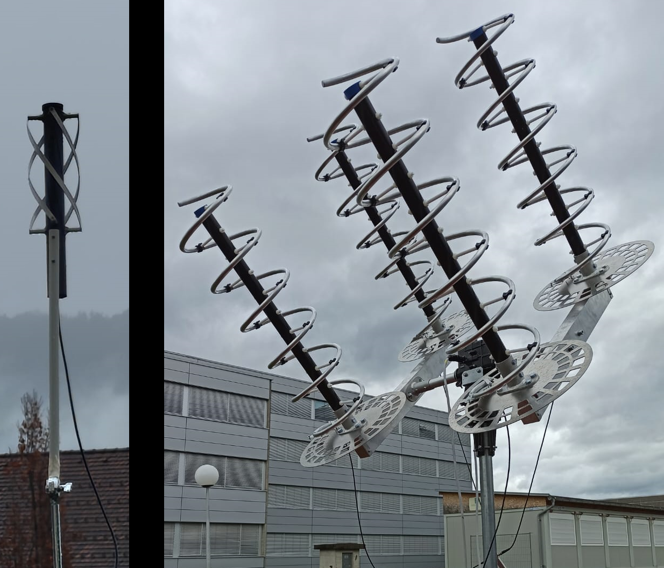
doc/ref/QFHHelix_vIZY67y.png
