Skh4rf/satNOGS/doc/ref/Rohrschelle.jpg

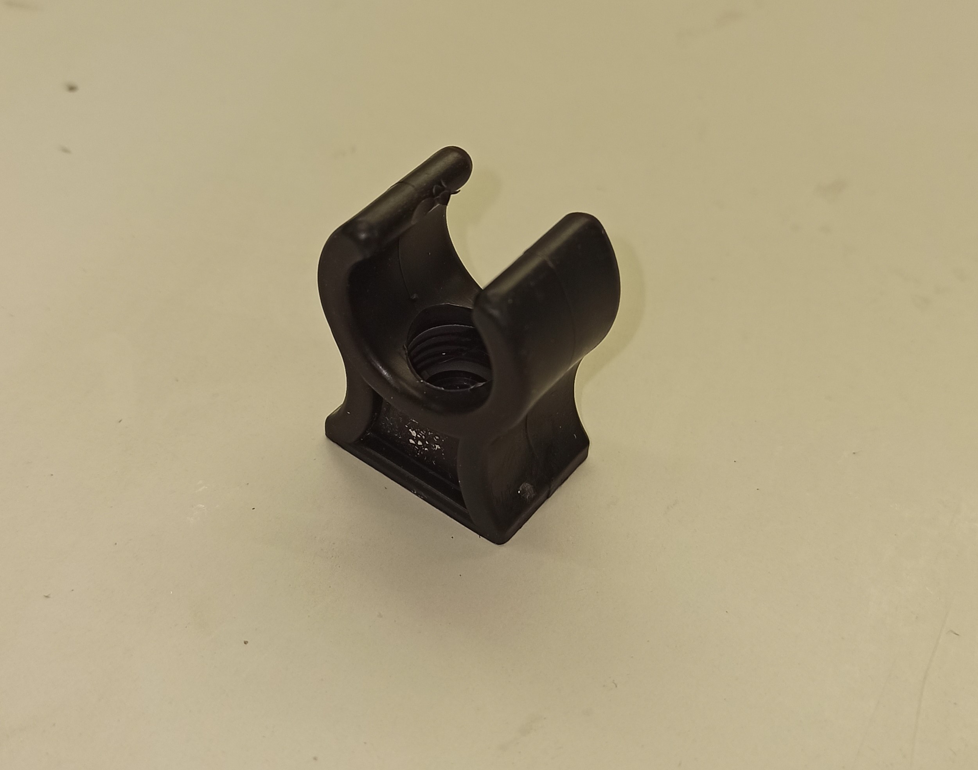
doc/ref/Rohrschelle.jpg
