Skh4rf/satNOGS/doc/ref/Spirale_Doku.png

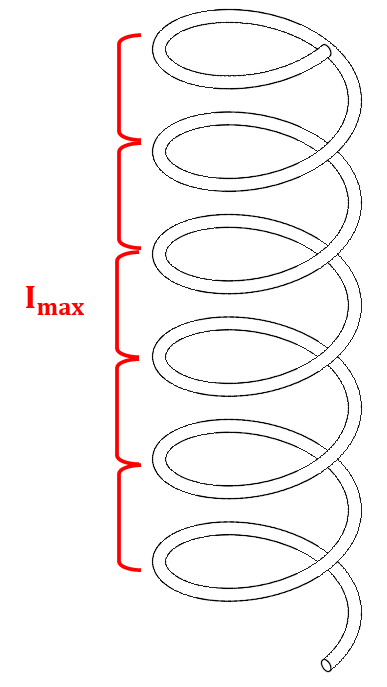
doc/ref/Spirale_Doku.png
