Skh4rf/satNOGS/doc/ref/Struktur-Rohrflansch.jpg

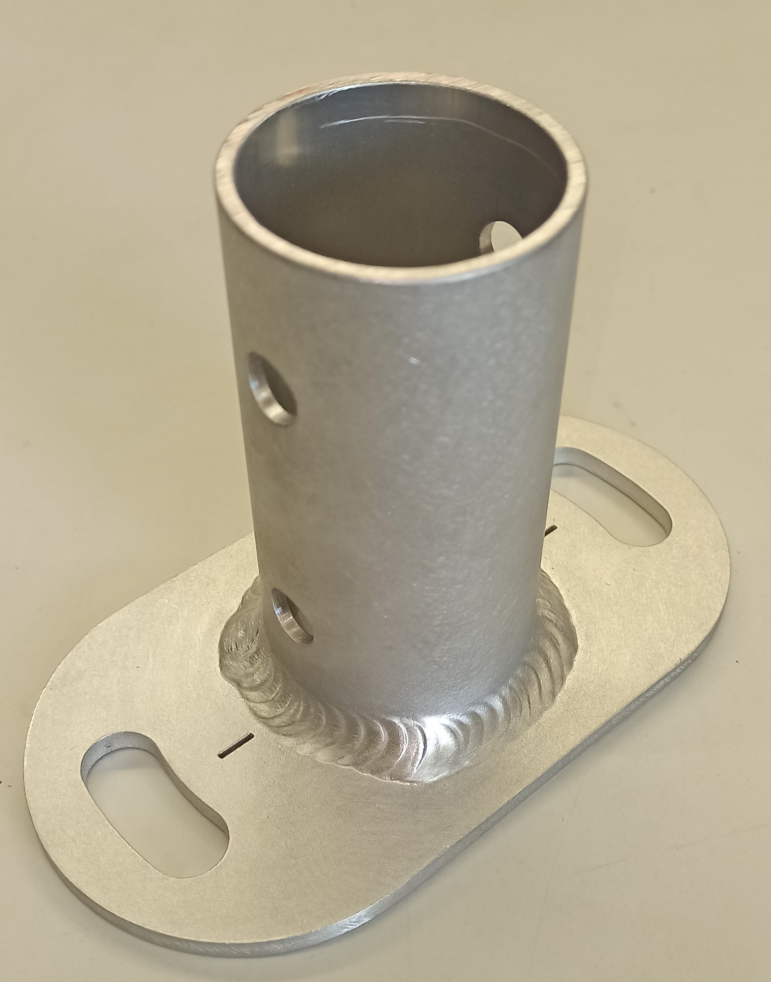
doc/ref/Struktur-Rohrflansch.jpg
