Skh4rf/satNOGS/Stückliste.docx

- Raspberry version 3 / 4
- LNA
- RTL-SDR v3 dongle
- Antennen/Antennenstrukturteile
- Koax Kabel
- Konnektoren
- Schrittmotoren, Lager, Steuerelektronik

Antennentypen:

- Dipol (isotrop)
