Skh4rf/satNOGS/doc/general-files/Diplomprojekt_Fertigungsunterlagen_Vollständig/Diplomprojekt_Fertigungsunterlagen/0000-Gesamtbaugruppe.stp

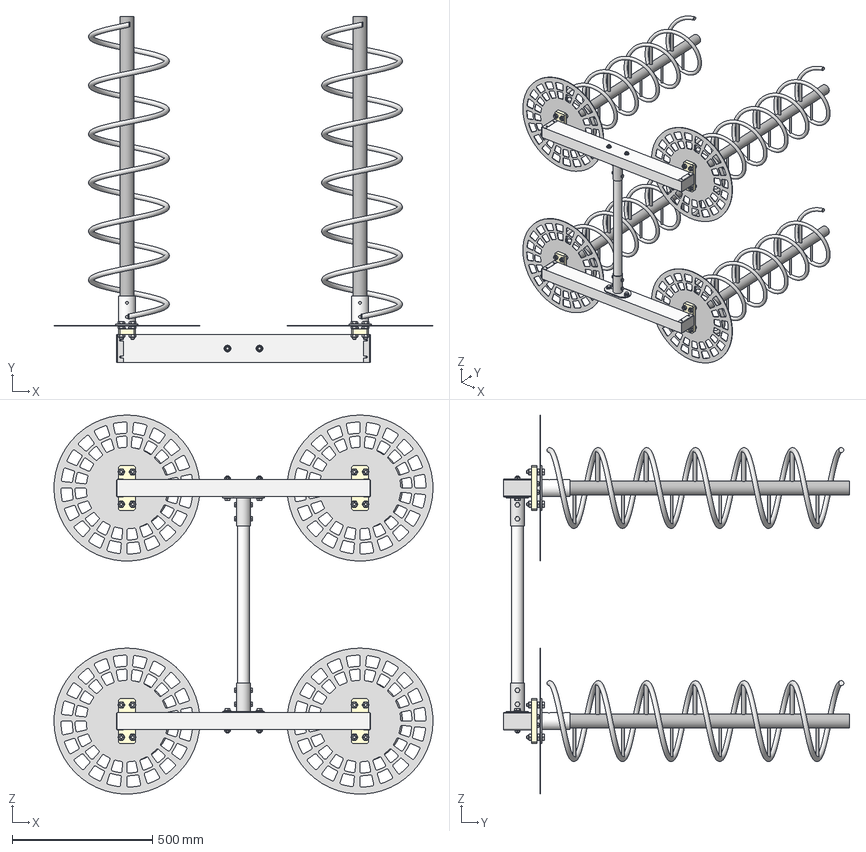
[picture p173: CAD file, 2024-02-16]
doc/general-files/Diplomprojekt_Fertigungsunterlagen_Vollständig/Diplomprojekt_Fertigungsunterlagen/0000-Gesamtbaugruppe.stp
1349.8 x 1233.0 x 1349.5 mm
0011-Strukturrohr-Grundplatte x 2
0012-Struktrurohr-Rohrschnitt x 2
0015-Strukturrohr
0016-Vierkantprofil x 2
ISO 4017 - M10 x 20 x 8
ISO 4014 - M12 x 80 x 4
DIN 125 - A 13 x 8
ISO 4035 - M12 x 4
0018-Vierkantprofil_Abdeckung x 4
Isolierplatte x 4
0013-Antennenrohr-Grundplatte x 4
0014-Antennenrohr-Rohrschnitt x 4
0020-Spiral-Antenne x 4
0022-Spiral-Antenne_Deckel x 4
0023-Spiral-Antenne_Anschluss x 4
0017-Reflektor x 4
0024-Spiral-Antenne_Stützrohr x 4
DIN 6915 - M12 x 32
ISO 8765 - M10 x 1 x 45 x 16
DIN 6914 - M12 x 55 x 16
ISO 4036 - M10 x 16
