Skh4rf/satNOGS/doc/general-files/Diplomprojekt_Fertigungsunterlagen_Vollständig/Diplomprojekt_Fertigungsunterlagen/0004-Spiral-Antenne_Gesamtbaugruppe.stp

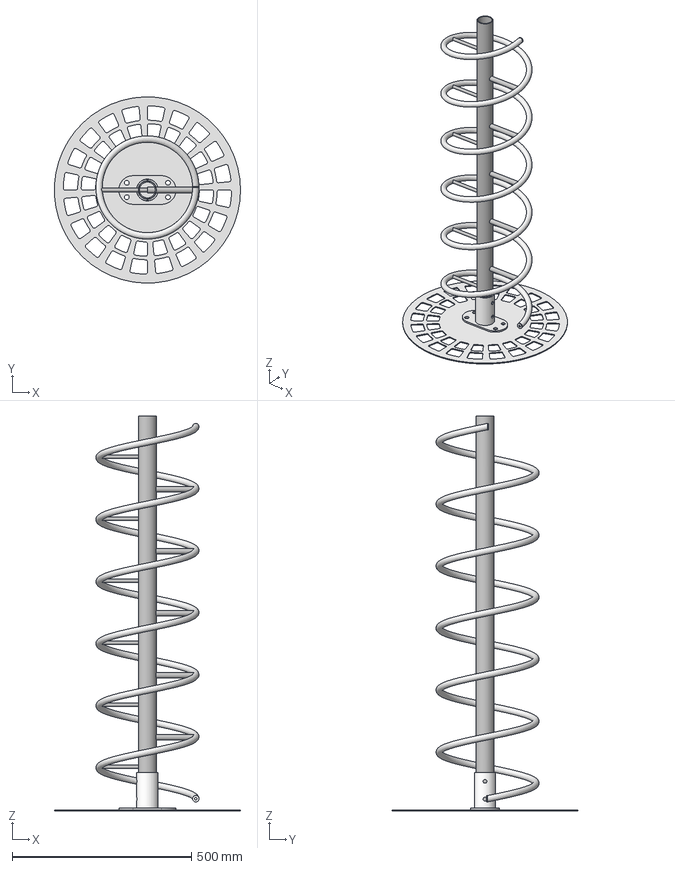
[picture p174: CAD file, 2024-02-16]
doc/general-files/Diplomprojekt_Fertigungsunterlagen_Vollständig/Diplomprojekt_Fertigungsunterlagen/0004-Spiral-Antenne_Gesamtbaugruppe.stp
519.5 x 519.8 x 1103.0 mm
0013-Antennenrohr-Grundplatte
0014-Antennenrohr-Rohrschnitt
0020-Spiral-Antenne
0022-Spiral-Antenne_Deckel
0023-Spiral-Antenne_Anschluss
0017-Reflektor
0024-Spiral-Antenne_Stützrohr
