Skh4rf/satNOGS/doc/general-files/Diplomprojekt_Fertigungsunterlagen_Vollständig/Diplomprojekt_Fertigungsunterlagen/0000-Gesamtbaugruppe_Rahmen.dxf

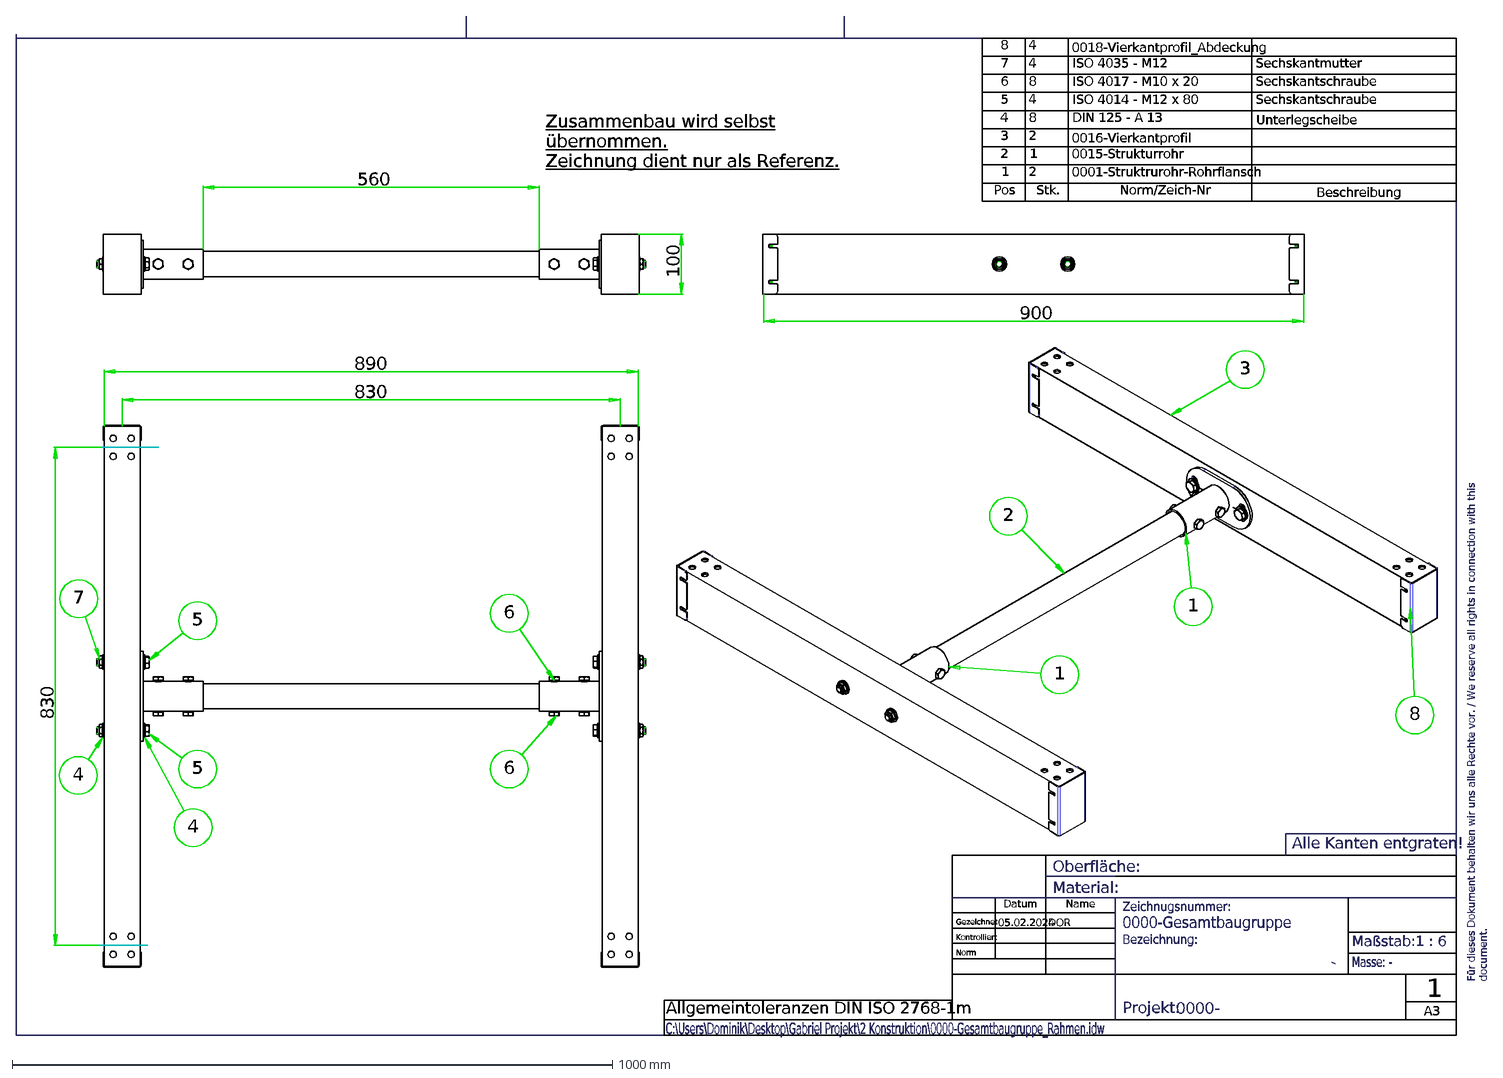
[picture p175: CAD file, 2024-02-16]
doc/general-files/Diplomprojekt_Fertigungsunterlagen_Vollständig/Diplomprojekt_Fertigungsunterlagen/0000-Gesamtbaugruppe_Rahmen.dxf
Für dieses Dokument behalten wir uns alle Rechte vor. / We reserve all rights in connection with this document.
1
A3
05.02.2024
DOR
0000-
C:\Users\Dominik\Desktop\Gabriel Projekt\2 Konstruktion\0000-Gesamtbaugruppe_Rahmen.idw
Gezeichnet
Kontrolliert
Norm
Datum
Name
Maßstab:1 : 6
Material:
Alle Kanten entgraten!
Projekt:
Oberfläche:
Masse: -
Zeichnugsnummer: 0000-Gesamtbaugruppe Bezeichnung:
Allgemeintoleranzen DIN ISO 2768-1m
0018-Vierkantprofil_Abdeckung
4
8
Sechskantmutter
ISO 4035 - M12
7
Sechskantschraube
ISO 4017 - M10 x 20
6
ISO 4014 - M12 x 80
5
Unterlegscheibe
DIN 125 - A 13
0016-Vierkantprofil
2
3
0015-Strukturrohr
0001-Struktrurohr-Rohrflansch
Beschreibung
Norm/Zeich-Nr
Stk.
Pos
890
830
100
560
900
Zusammenbau wird selbst übernommen. Zeichnung dient nur als Referenz.
