Skh4rf/satNOGS/doc/general-files/Diplomprojekt_Fertigungsunterlagen_Vollständig/Diplomprojekt_Fertigungsunterlagen/G-5500DC v4.step

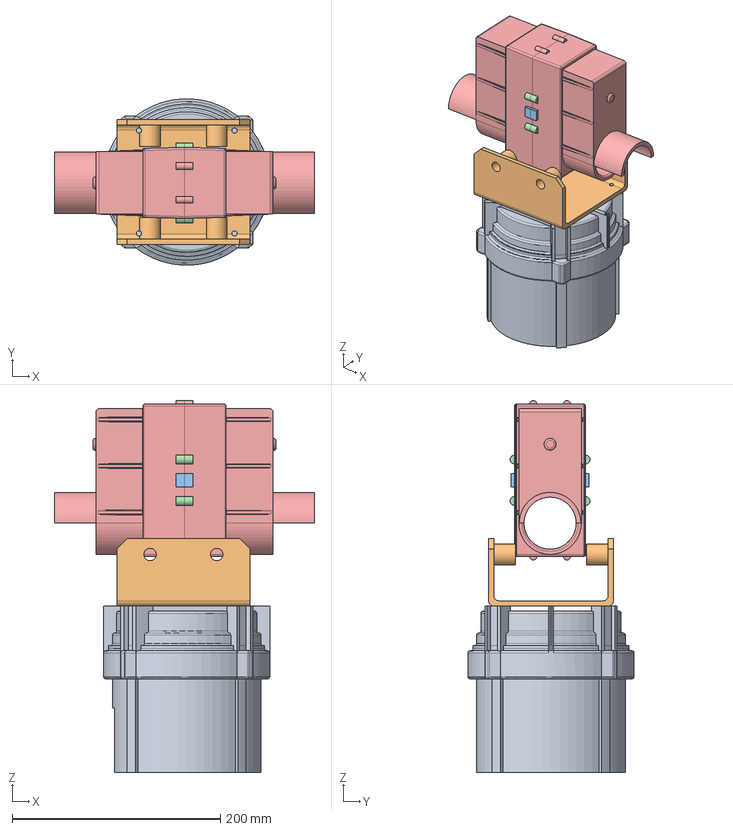
[picture p176: CAD file, 2024-03-05]
doc/general-files/Diplomprojekt_Fertigungsunterlagen_Vollständig/Diplomprojekt_Fertigungsunterlagen/G-5500DC v4.step
250.0 x 159.7 x 357.5 mm
Azimuth_Rotator_Unit
U-bracket
Elevation_Rotator_Unit x 2
