Skh4rf/satNOGS/doc/general-files/Rotor-Abdeckung/Abdeckung+Rotor+Steuerung.3mf

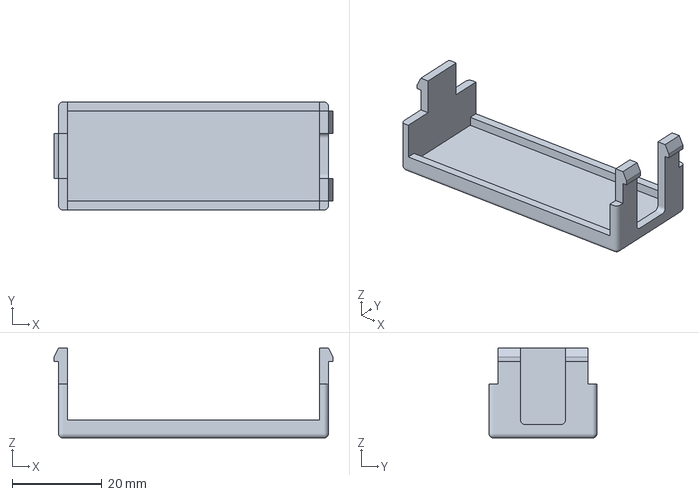
[picture p177: CAD file, 2023-12-18]
doc/general-files/Rotor-Abdeckung/Abdeckung+Rotor+Steuerung.3mf
62.0 x 24.0 x 20.0 mm
