Skh4rf/satNOGS/doc/general-files/Diplomprojekt_Fertigungsunterlagen_Vollständig/Diplomprojekt_Fertigungsunterlagen/0012-Struktrurohr-Rohrschnitt.stl

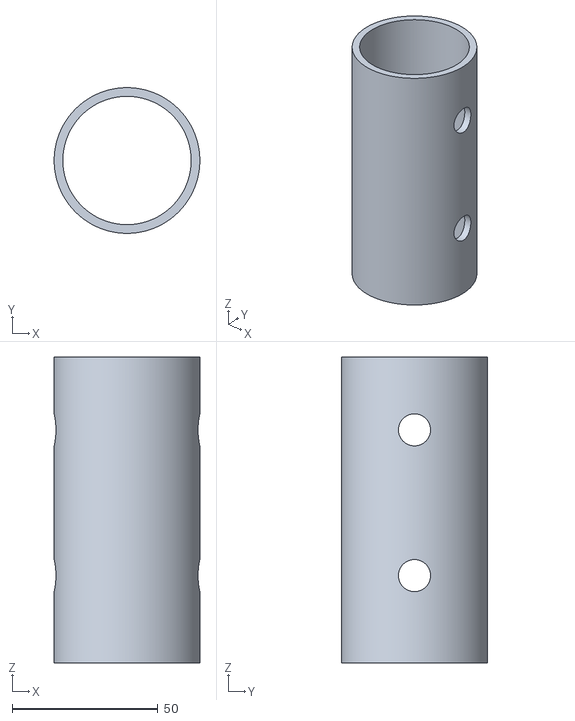
[picture p178: CAD file, 2024-02-16]
doc/general-files/Diplomprojekt_Fertigungsunterlagen_Vollständig/Diplomprojekt_Fertigungsunterlagen/0012-Struktrurohr-Rohrschnitt.stl
50.0 x 50.0 x 105.0
