Skh4rf/satNOGS/doc/general-files/Diplomprojekt_Fertigungsunterlagen_Vollständig/Diplomprojekt_Fertigungsunterlagen/0003-Spiral-Antenne.stp

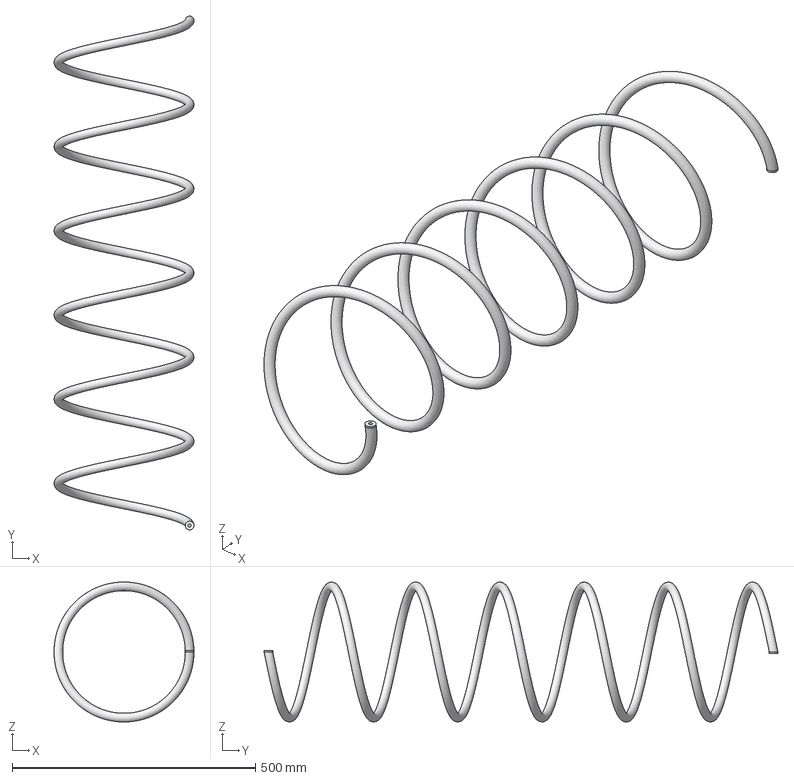
[picture p179: CAD file, 2024-02-16]
doc/general-files/Diplomprojekt_Fertigungsunterlagen_Vollständig/Diplomprojekt_Fertigungsunterlagen/0003-Spiral-Antenne.stp
288.0 x 1057.2 x 288.0 mm
0020-Spiral-Antenne
0022-Spiral-Antenne_Deckel
0023-Spiral-Antenne_Anschluss
