Skh4rf/satNOGS/doc/general-files/Diplomprojekt_Fertigungsunterlagen_Vollständig/Diplomprojekt_Fertigungsunterlagen/0018-Vierkantprofil_Abdeckung.dxf

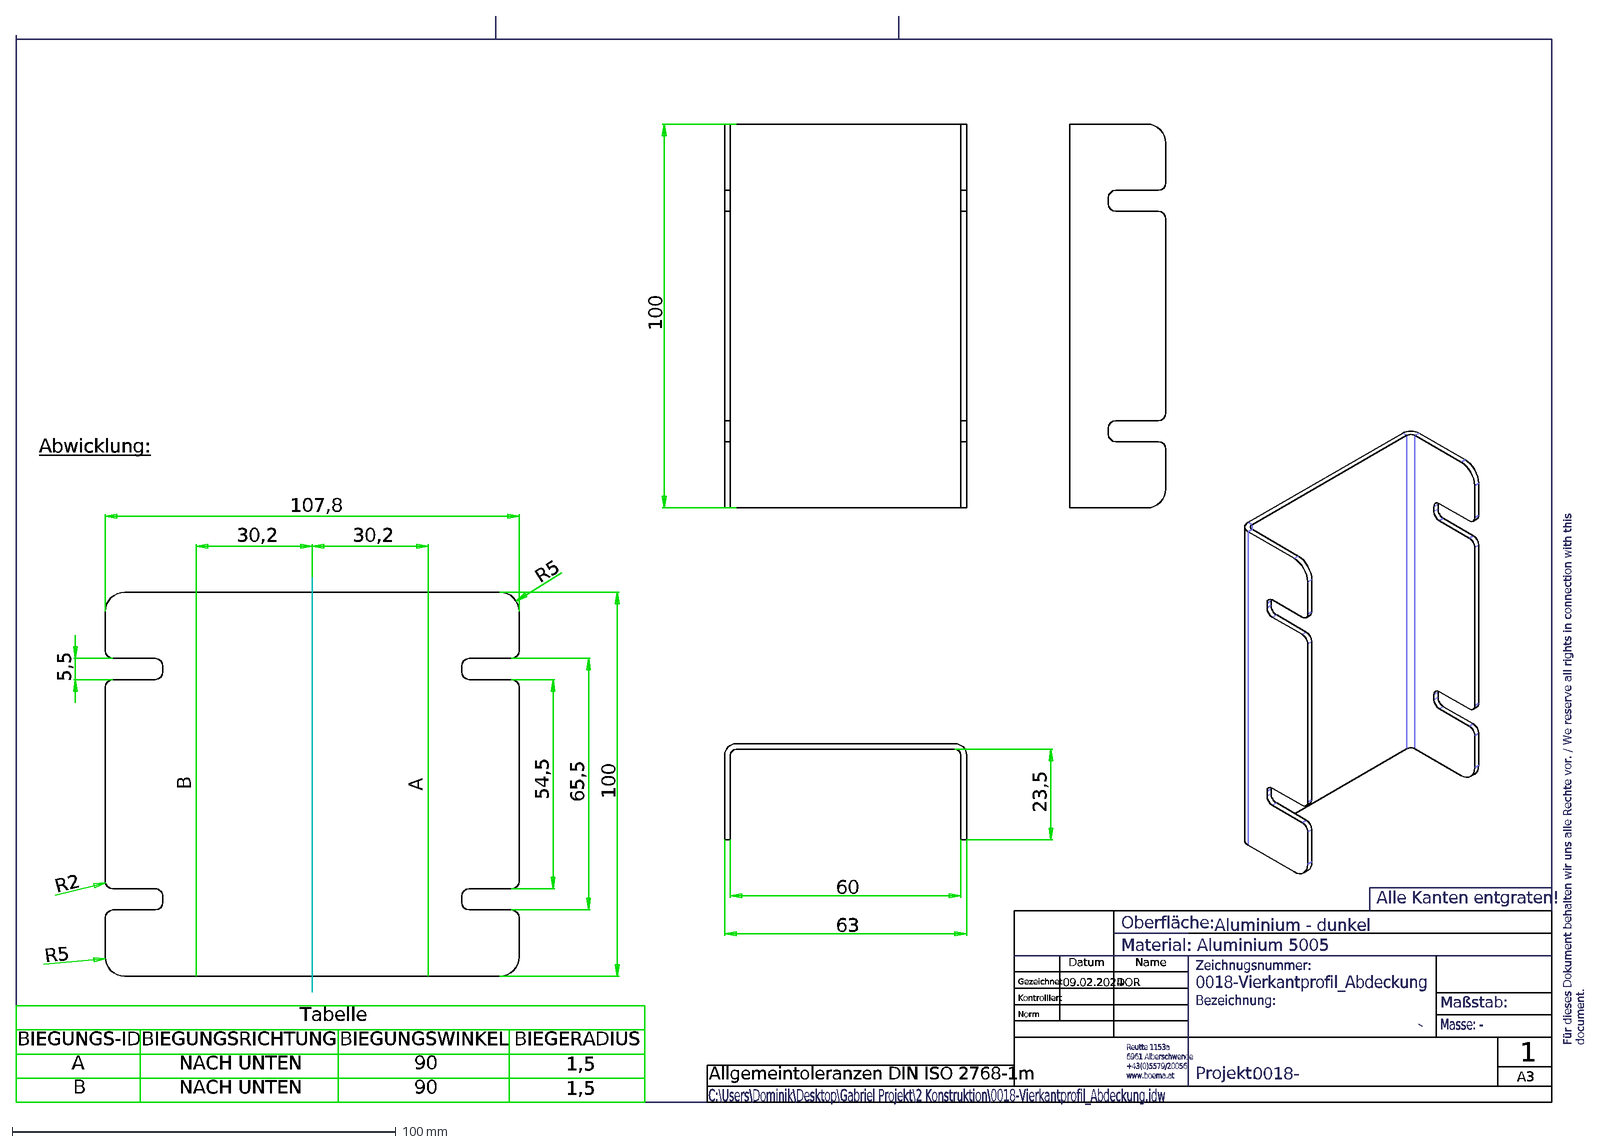
[picture p180: CAD file, 2024-02-16]
doc/general-files/Diplomprojekt_Fertigungsunterlagen_Vollständig/Diplomprojekt_Fertigungsunterlagen/0018-Vierkantprofil_Abdeckung.dxf
Für dieses Dokument behalten wir uns alle Rechte vor. / We reserve all rights in connection with this document.
1
A3
09.02.2024
DOR
0018-
Aluminium - dunkel
C:\Users\Dominik\Desktop\Gabriel Projekt\2 Konstruktion\0018-Vierkantprofil_Abdeckung.idw
Gezeichnet
Kontrolliert
Norm
Datum
Name
Maßstab:
Material: Aluminium 5005
Reutte 1153a 6961 Alberschwende +43(0)5579/20056 www.boema.at
Alle Kanten entgraten!
Projekt:
Oberfläche:
Masse: -
Zeichnugsnummer: 0018-Vierkantprofil_Abdeckung Bezeichnung:
Allgemeintoleranzen DIN ISO 2768-1m
Abwicklung:
Tabelle
BIEGUNGS-ID
BIEGUNGSRICHTUNG
BIEGUNGSWINKEL
BIEGERADIUS
A
NACH UNTEN
90
1,5
B
30,2
107,8
5,5
R5
65,5
54,5
100
R2
60
23,5
63
