Skh4rf/satNOGS/doc/general-files/Diplomprojekt_Fertigungsunterlagen_Vollständig/Diplomprojekt_Fertigungsunterlagen/0013-Antennenrohr-Grundplatte.stl

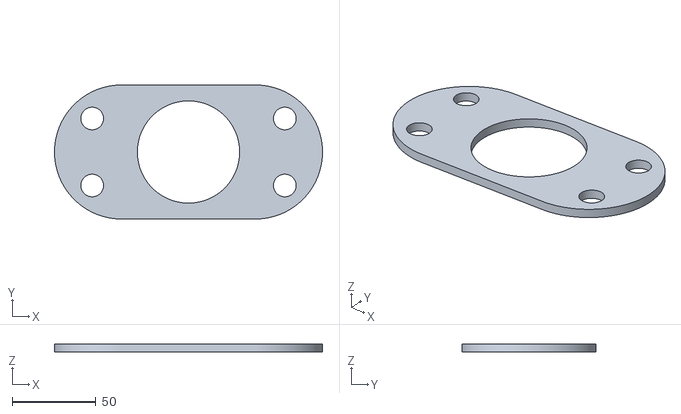
[picture p181: CAD file, 2024-02-16]
doc/general-files/Diplomprojekt_Fertigungsunterlagen_Vollständig/Diplomprojekt_Fertigungsunterlagen/0013-Antennenrohr-Grundplatte.stl
160.0 x 80.0 x 5.00
