Skh4rf/satNOGS/doc/general-files/Diplomprojekt_Fertigungsunterlagen_Vollständig/Diplomprojekt_Fertigungsunterlagen/0017-Reflektor.dxf

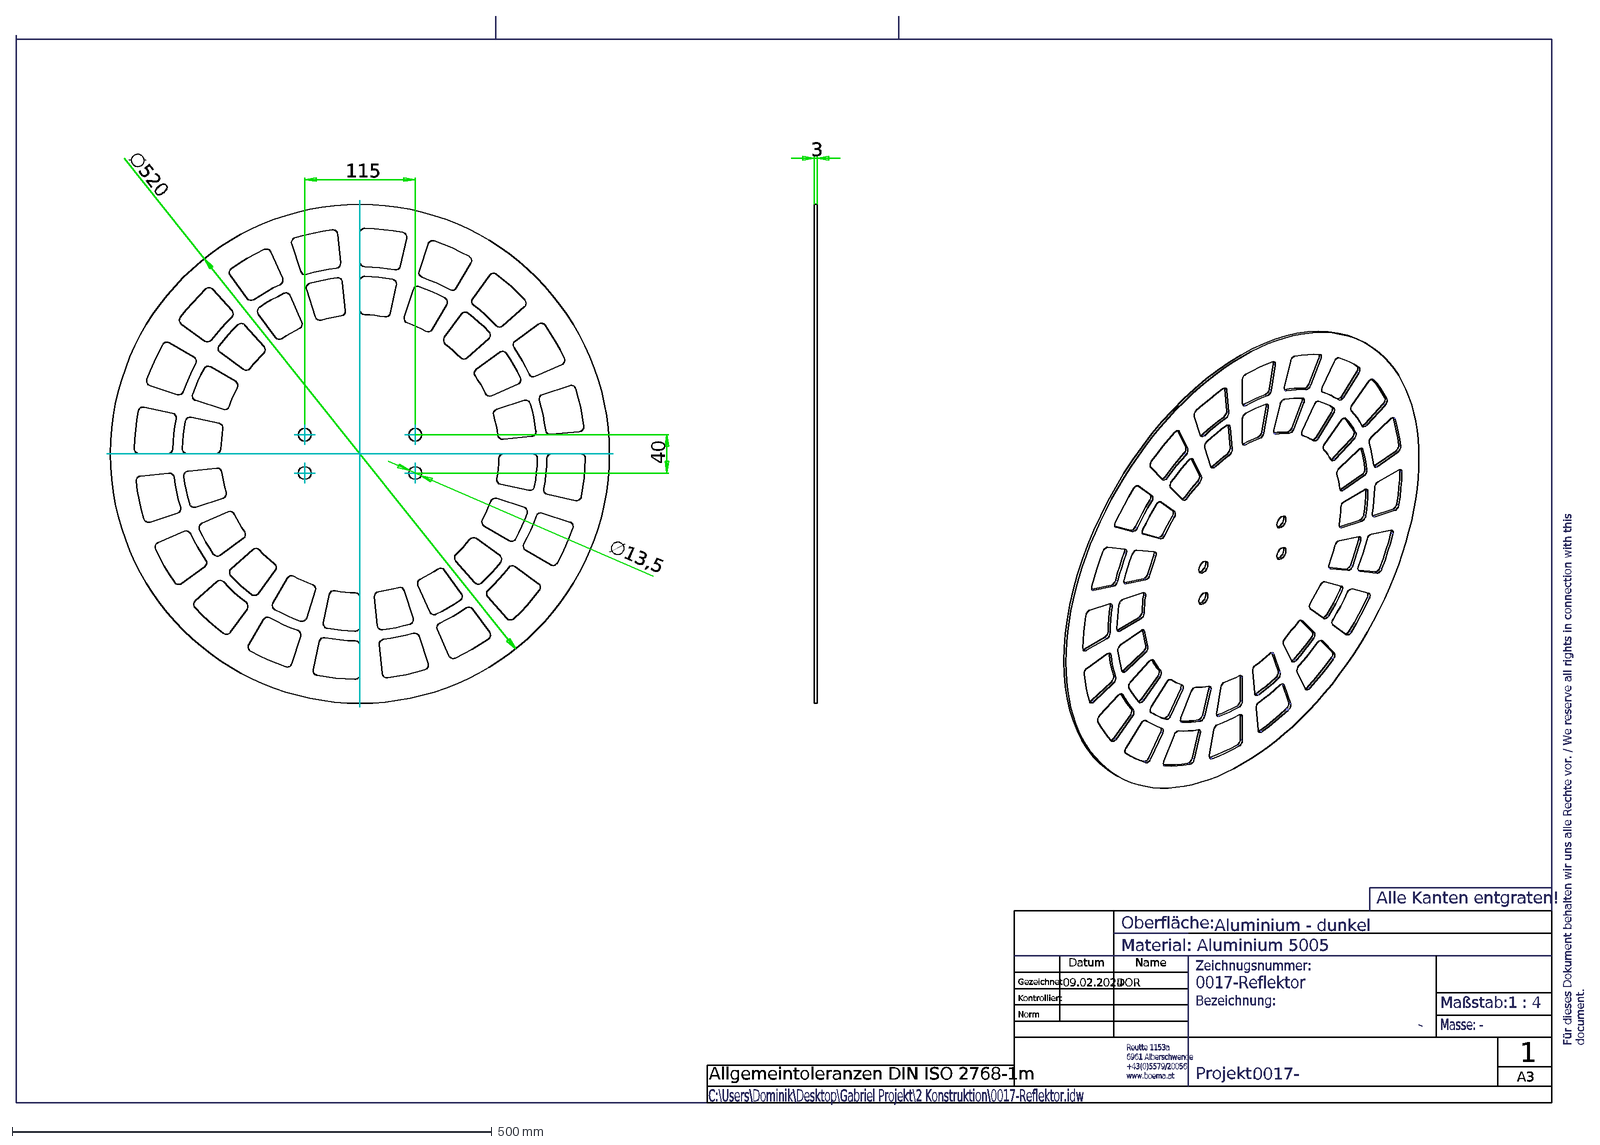
[picture p182: CAD file, 2024-02-16]
doc/general-files/Diplomprojekt_Fertigungsunterlagen_Vollständig/Diplomprojekt_Fertigungsunterlagen/0017-Reflektor.dxf
Für dieses Dokument behalten wir uns alle Rechte vor. / We reserve all rights in connection with this document.
1
A3
09.02.2024
DOR
0017-
Aluminium - dunkel
C:\Users\Dominik\Desktop\Gabriel Projekt\2 Konstruktion\0017-Reflektor.idw
Gezeichnet
Kontrolliert
Norm
Datum
Name
Maßstab:1 : 4
Material: Aluminium 5005
Reutte 1153a 6961 Alberschwende +43(0)5579/20056 www.boema.at
Alle Kanten entgraten!
Projekt:
Oberfläche:
Masse: -
Zeichnugsnummer: 0017-Reflektor Bezeichnung:
Allgemeintoleranzen DIN ISO 2768-1m
∅520
3
115
40
∅13,5
