Skh4rf/satNOGS/doc/general-files/Diplomprojekt_Fertigungsunterlagen_Vollständig/Diplomprojekt_Fertigungsunterlagen/0023-Spiral-Antenne_Anschluss.stl

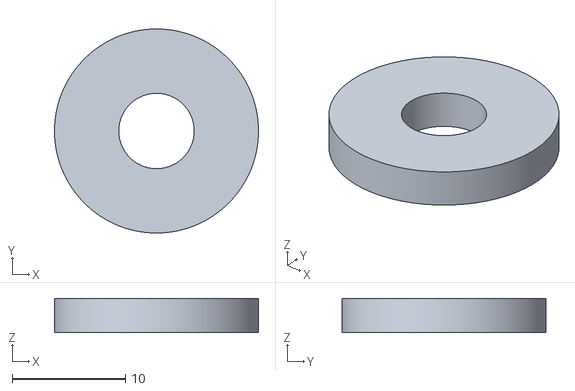
[picture p183: CAD file, 2024-02-16]
doc/general-files/Diplomprojekt_Fertigungsunterlagen_Vollständig/Diplomprojekt_Fertigungsunterlagen/0023-Spiral-Antenne_Anschluss.stl
18.0 x 18.0 x 3.00
