Skh4rf/satNOGS/doc/general-files/Diplomprojekt_Fertigungsunterlagen_Vollständig/Diplomprojekt_Fertigungsunterlagen/0015-Strukturrohr.dxf

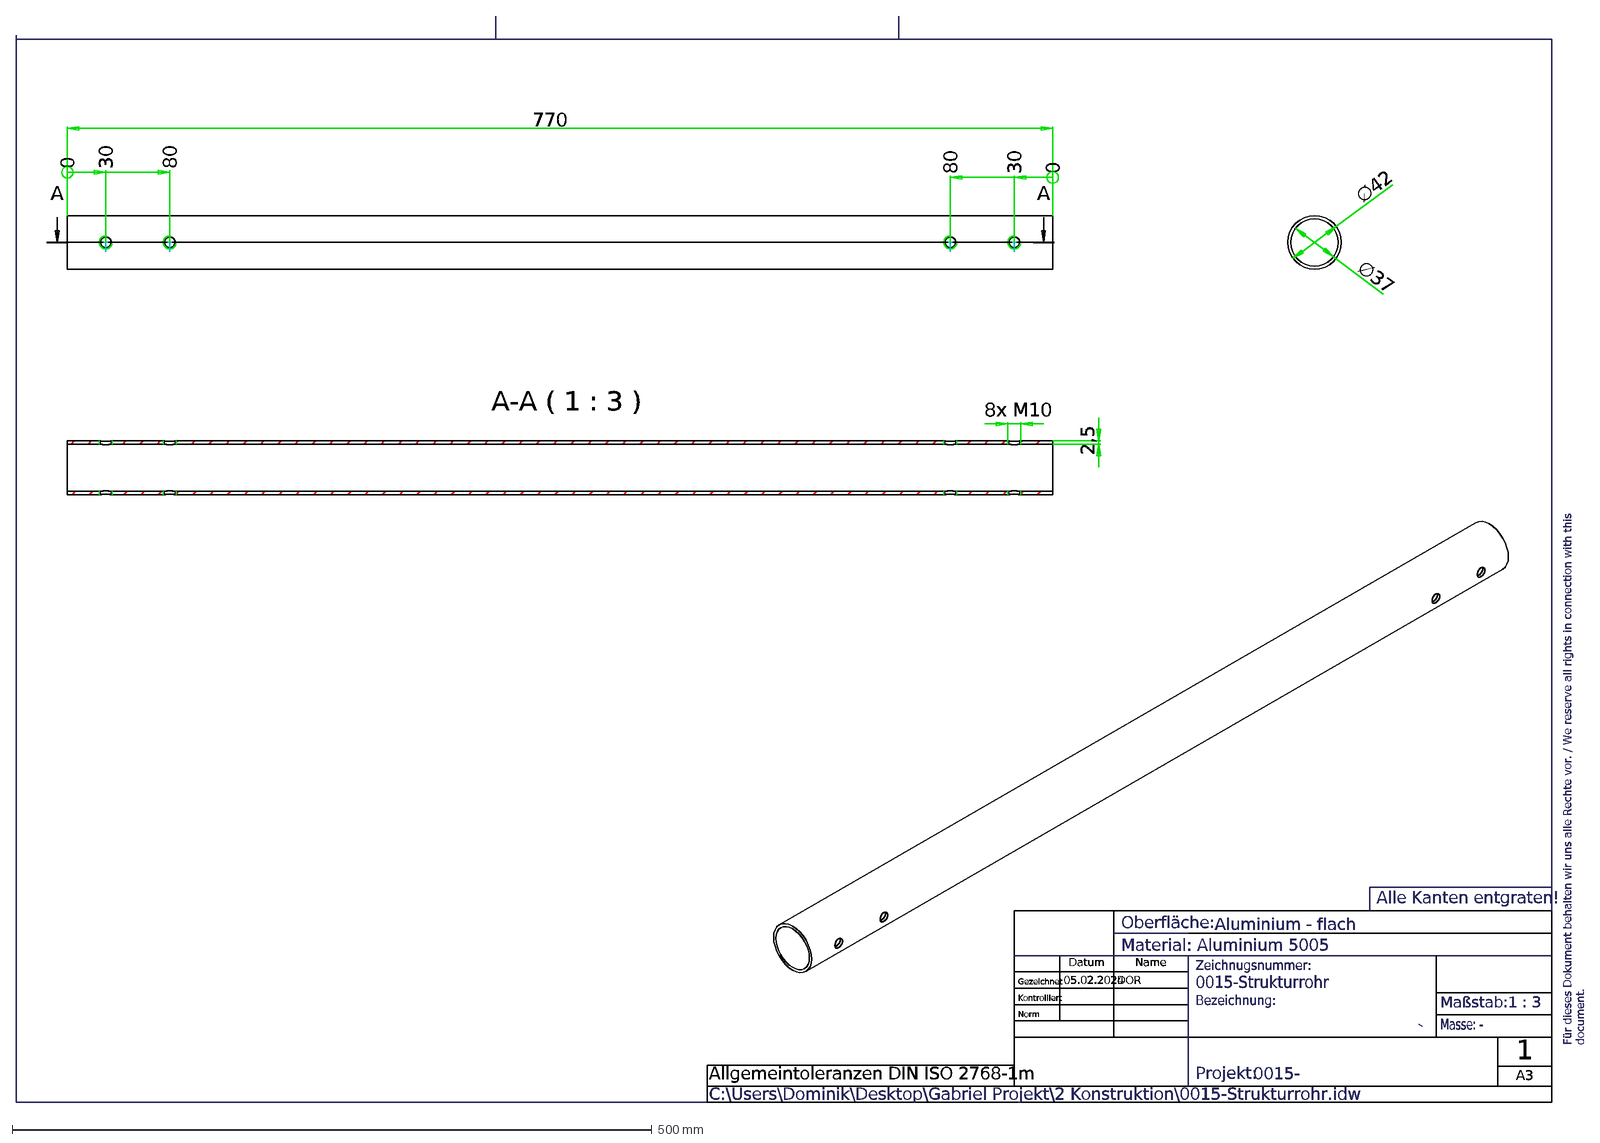
[picture p185: CAD file, 2024-02-16]
doc/general-files/Diplomprojekt_Fertigungsunterlagen_Vollständig/Diplomprojekt_Fertigungsunterlagen/0015-Strukturrohr.dxf
Für dieses Dokument behalten wir uns alle Rechte vor. / We reserve all rights in connection with this document.
1
A3
05.02.2024
DOR
0015-
Aluminium - flach
C:\Users\Dominik\Desktop\Gabriel Projekt\2 Konstruktion\0015-Strukturrohr.idw
Gezeichnet
Kontrolliert
Norm
Datum
Name
Maßstab:1 : 3
Material: Aluminium 5005
Alle Kanten entgraten!
Projekt:
Oberfläche:
Masse: -
Zeichnugsnummer: 0015-Strukturrohr Bezeichnung:
Allgemeintoleranzen DIN ISO 2768-1m
A
A-A ( 1 : 3 )
∅42
∅37
770
0
30
80
2,5
8x M10
