Skh4rf/satNOGS/doc/general-files/Diplomprojekt_Fertigungsunterlagen_Vollständig/Diplomprojekt_Fertigungsunterlagen/0001-Struktrurohr-Rohrflansch.stl

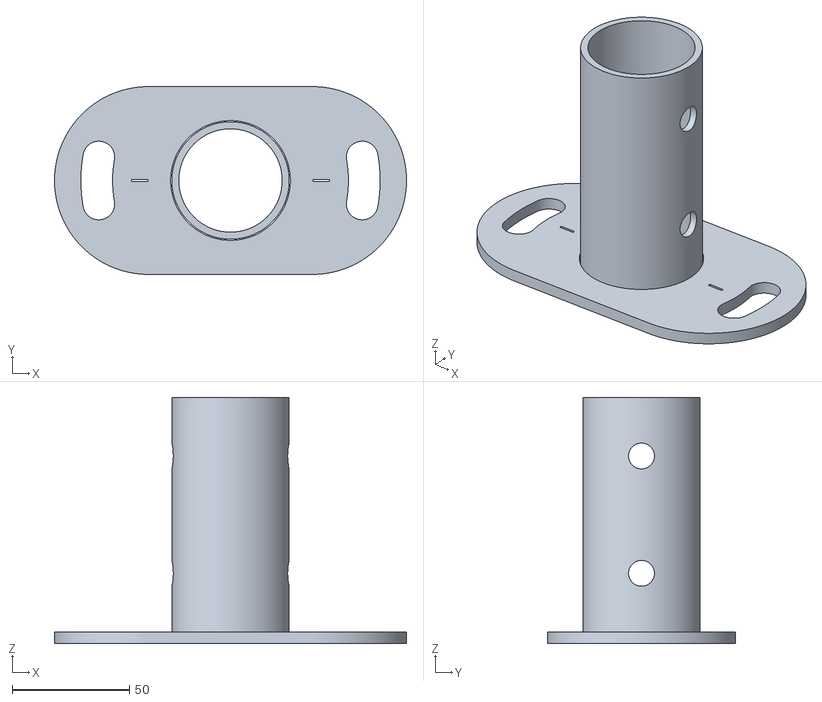
[picture p186: CAD file, 2024-02-16]
doc/general-files/Diplomprojekt_Fertigungsunterlagen_Vollständig/Diplomprojekt_Fertigungsunterlagen/0001-Struktrurohr-Rohrflansch.stl
150.0 x 80.0 x 105.0
