Skh4rf/satNOGS/doc/general-files/Diplomprojekt_Fertigungsunterlagen_Vollständig/Diplomprojekt_Fertigungsunterlagen/0011-Strukturrohr-Grundplatte.stl

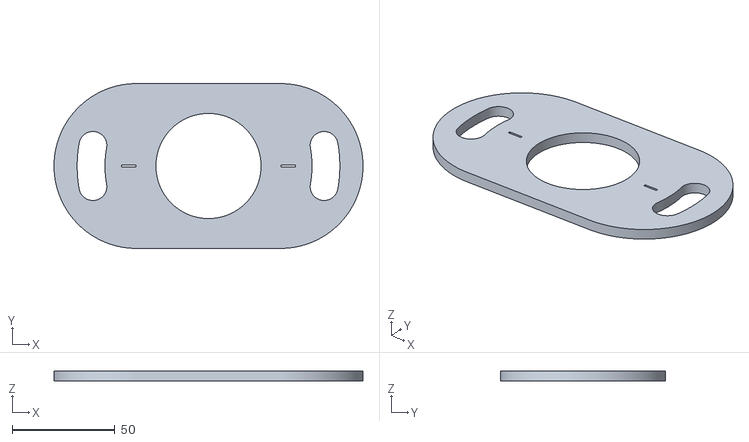
[picture p188: CAD file, 2024-02-16]
doc/general-files/Diplomprojekt_Fertigungsunterlagen_Vollständig/Diplomprojekt_Fertigungsunterlagen/0011-Strukturrohr-Grundplatte.stl
150.0 x 80.0 x 5.00
