Skh4rf/satNOGS/doc/general-files/Diplomprojekt_Fertigungsunterlagen_Vollständig/Diplomprojekt_Fertigungsunterlagen/0014-Antennenrohr-Rohrschnitt.stl

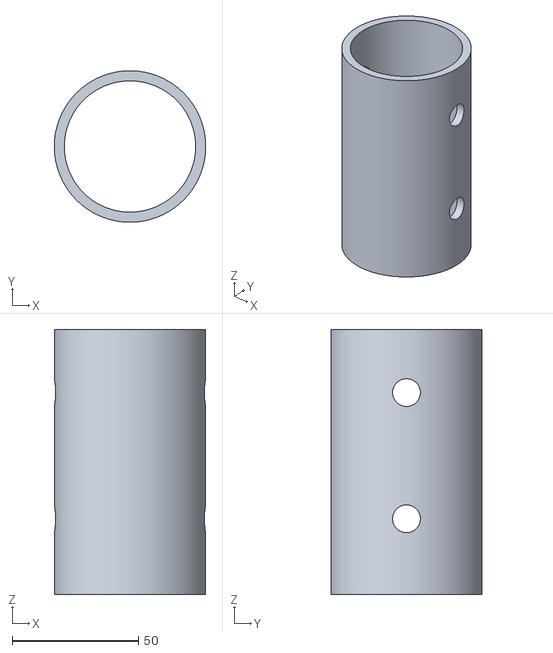
[picture p189: CAD file, 2024-02-16]
doc/general-files/Diplomprojekt_Fertigungsunterlagen_Vollständig/Diplomprojekt_Fertigungsunterlagen/0014-Antennenrohr-Rohrschnitt.stl
60.0 x 60.0 x 105.0
