Skh4rf/satNOGS/doc/general-files/Diplomprojekt_Fertigungsunterlagen_Vollständig/Diplomprojekt_Fertigungsunterlagen/0022-Spiral-Antenne_Deckel.stl

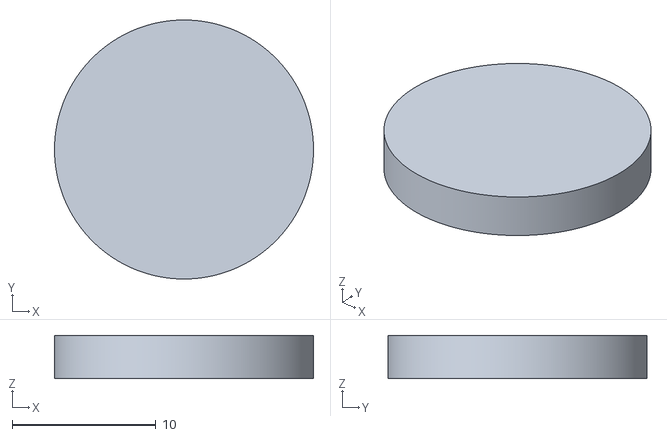
[picture p191: CAD file, 2024-02-16]
doc/general-files/Diplomprojekt_Fertigungsunterlagen_Vollständig/Diplomprojekt_Fertigungsunterlagen/0022-Spiral-Antenne_Deckel.stl
18.0 x 18.0 x 3.00
