Skh4rf/satNOGS/(list of files, cad)

Other CAD files:
doc/general-files/Diplomprojekt_Fertigungsunterlagen_Vollständig/Diplomprojekt_Fertigungsunterlagen/0000-Gesamtbaugruppe.dxf
doc/general-files/Diplomprojekt_Fertigungsunterlagen_Vollständig/Diplomprojekt_Fertigungsunterlagen/0001-Struktrurohr-Rohrflansch.dxf
doc/general-files/Diplomprojekt_Fertigungsunterlagen_Vollständig/Diplomprojekt_Fertigungsunterlagen/0002-Antenne-Rohrflansch.dxf
doc/general-files/Diplomprojekt_Fertigungsunterlagen_Vollständig/Diplomprojekt_Fertigungsunterlagen/0003-Spiral-Antenne.dxf
doc/general-files/Diplomprojekt_Fertigungsunterlagen_Vollständig/Diplomprojekt_Fertigungsunterlagen/0004-Spiral-Antenne_Gesamtbaugruppe.dxf
doc/general-files/Diplomprojekt_Fertigungsunterlagen_Vollständig/Diplomprojekt_Fertigungsunterlagen/0011-Strukturrohr-Grundplatte.dxf
doc/general-files/Diplomprojekt_Fertigungsunterlagen_Vollständig/Diplomprojekt_Fertigungsunterlagen/0012-Struktrurohr-Rohrschnitt.dxf
doc/general-files/Diplomprojekt_Fertigungsunterlagen_Vollständig/Diplomprojekt_Fertigungsunterlagen/0013-Antennenrohr-Grundplatte.dxf
doc/general-files/Diplomprojekt_Fertigungsunterlagen_Vollständig/Diplomprojekt_Fertigungsunterlagen/0014-Antennenrohr-Rohrschnitt.dxf
doc/general-files/Diplomprojekt_Fertigungsunterlagen_Vollständig/Diplomprojekt_Fertigungsunterlagen/0016-Vierkantprofil.dxf
doc/general-files/Diplomprojekt_Fertigungsunterlagen_Vollständig/Diplomprojekt_Fertigungsunterlagen/0020-Spiral-Antenne.dxf
doc/general-files/Diplomprojekt_Fertigungsunterlagen_Vollständig/Diplomprojekt_Fertigungsunterlagen/0022-Spiral-Antenne_Deckel.dxf
doc/general-files/Diplomprojekt_Fertigungsunterlagen_Vollständig/Diplomprojekt_Fertigungsunterlagen/0023-Spiral-Antenne_Anschluss.dxf
doc/general-files/Rotor-Abdeckung/Abdeckung+Rotor+Steuerung.stl
