Skh4rf/satNOGS/doc/ref/0004-Spiral-Antenne_Gesamtbaugruppe.pdf

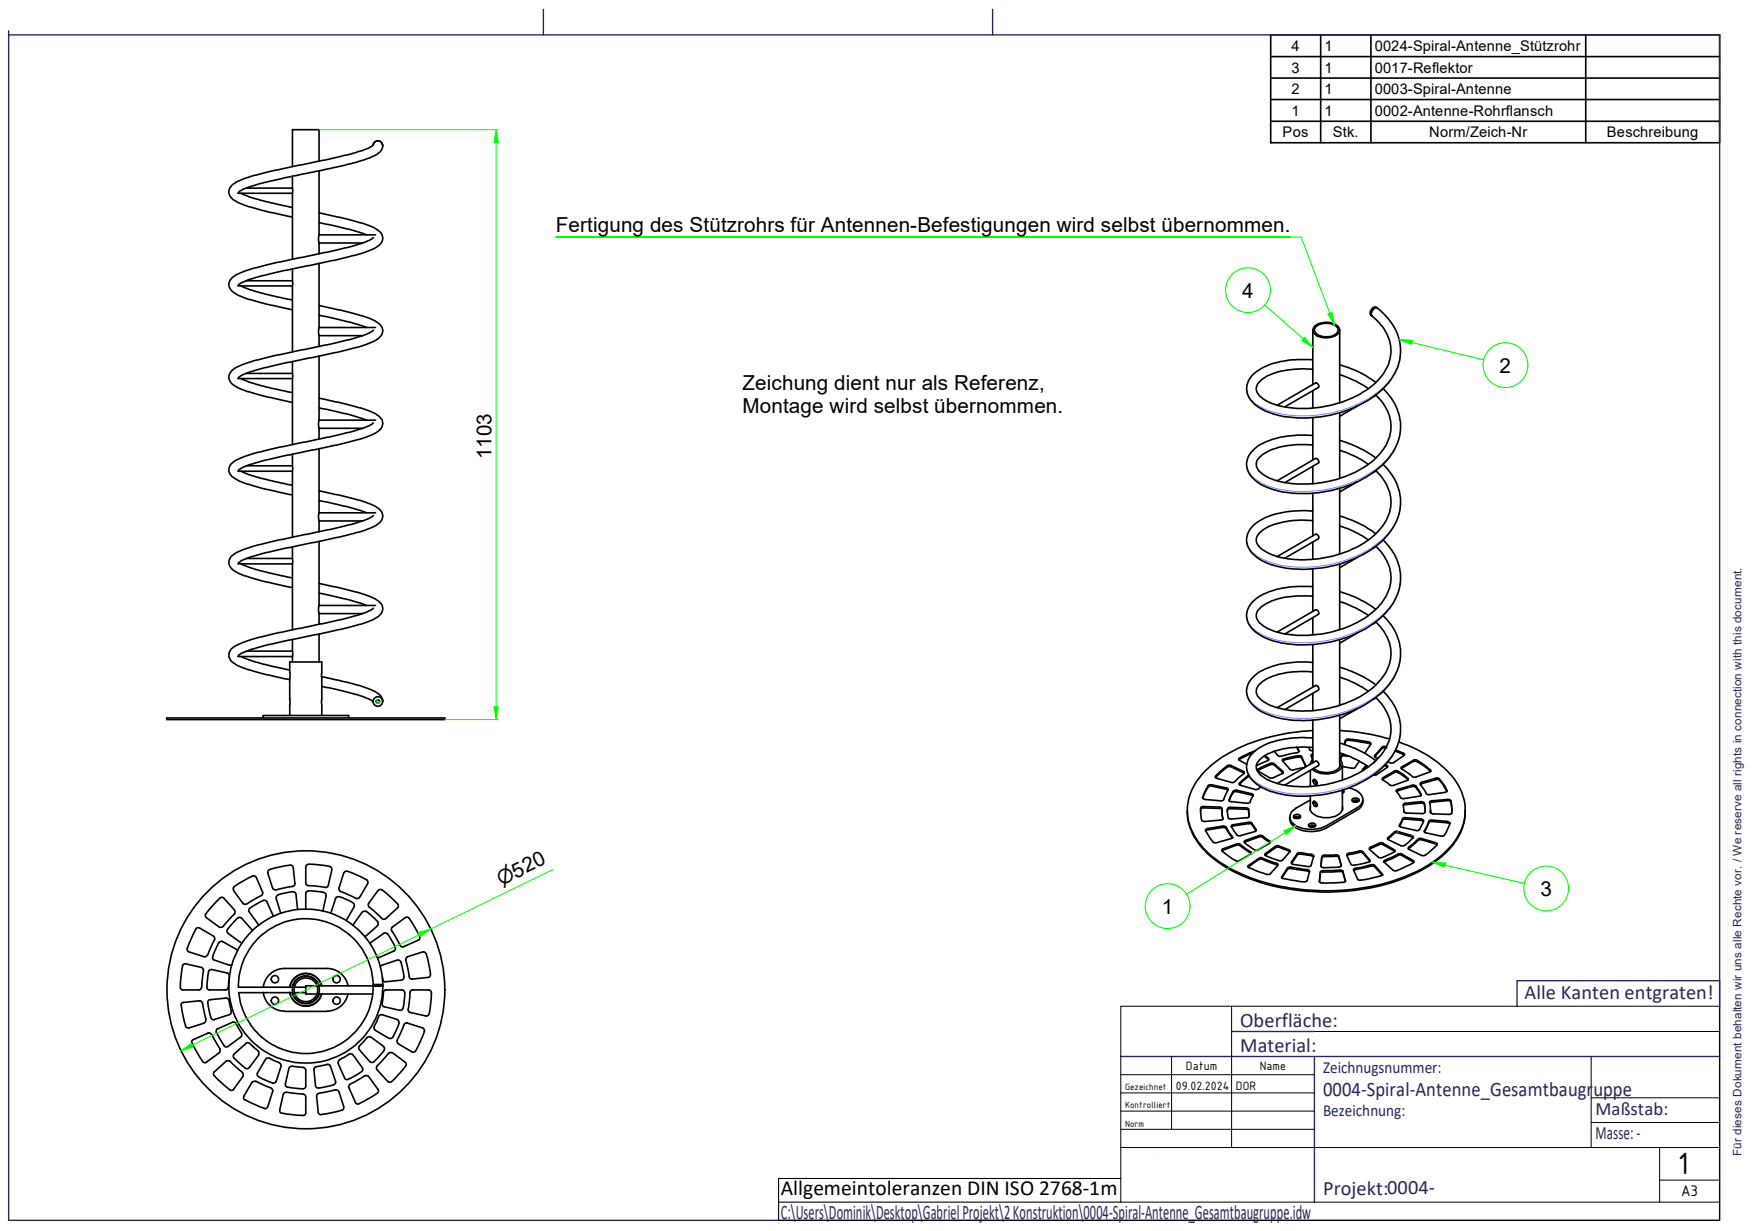
[picture p199: page 1]
Masse: -

4 | 1 | 0024-Spiral-Antenne_Stützrohr
3 | 1 | 0017-Reflektor
2 | 1 | 0003-Spiral-Antenne
1 | 1 | 0002-Antenne-Rohrflansch
Pos | Stk. | Norm/Zeich-Nr | Beschreibung

Fertigung des Stützrohrs für Antennen-Befestigungen wird selbst übernommen.

Zeichung dient nur als Referenz,
Montage wird selbst übernommen.

Für dieses Dokument behalten wir uns alle Rechte vor. / We reserve all rights in connection with this document.

Alle Kanten entgraten!

Datum | Name | Zeichnugsnummer: 0004-Spiral-Antenne_Gesamtbaugruppe Bezeichnung:

Gezeichnet | 09.02.2024 | DOR

Kontrolliert

Norm

Reutte 1153a 6961 Alberschwende +43(0)5579/20056 www.boema.at | Projekt:0004- | 1

Allgemeintoleranzen DIN ISO 2768-1m | | | A3
C:\Users\Dominik\Desktop\Gabriel Projekt\2 Konstruktion\0004-Spiral-Antenne_Gesamtbaugruppe.idw
