Skh4rf/satNOGS/doc/ref/0017-Reflektor.pdf

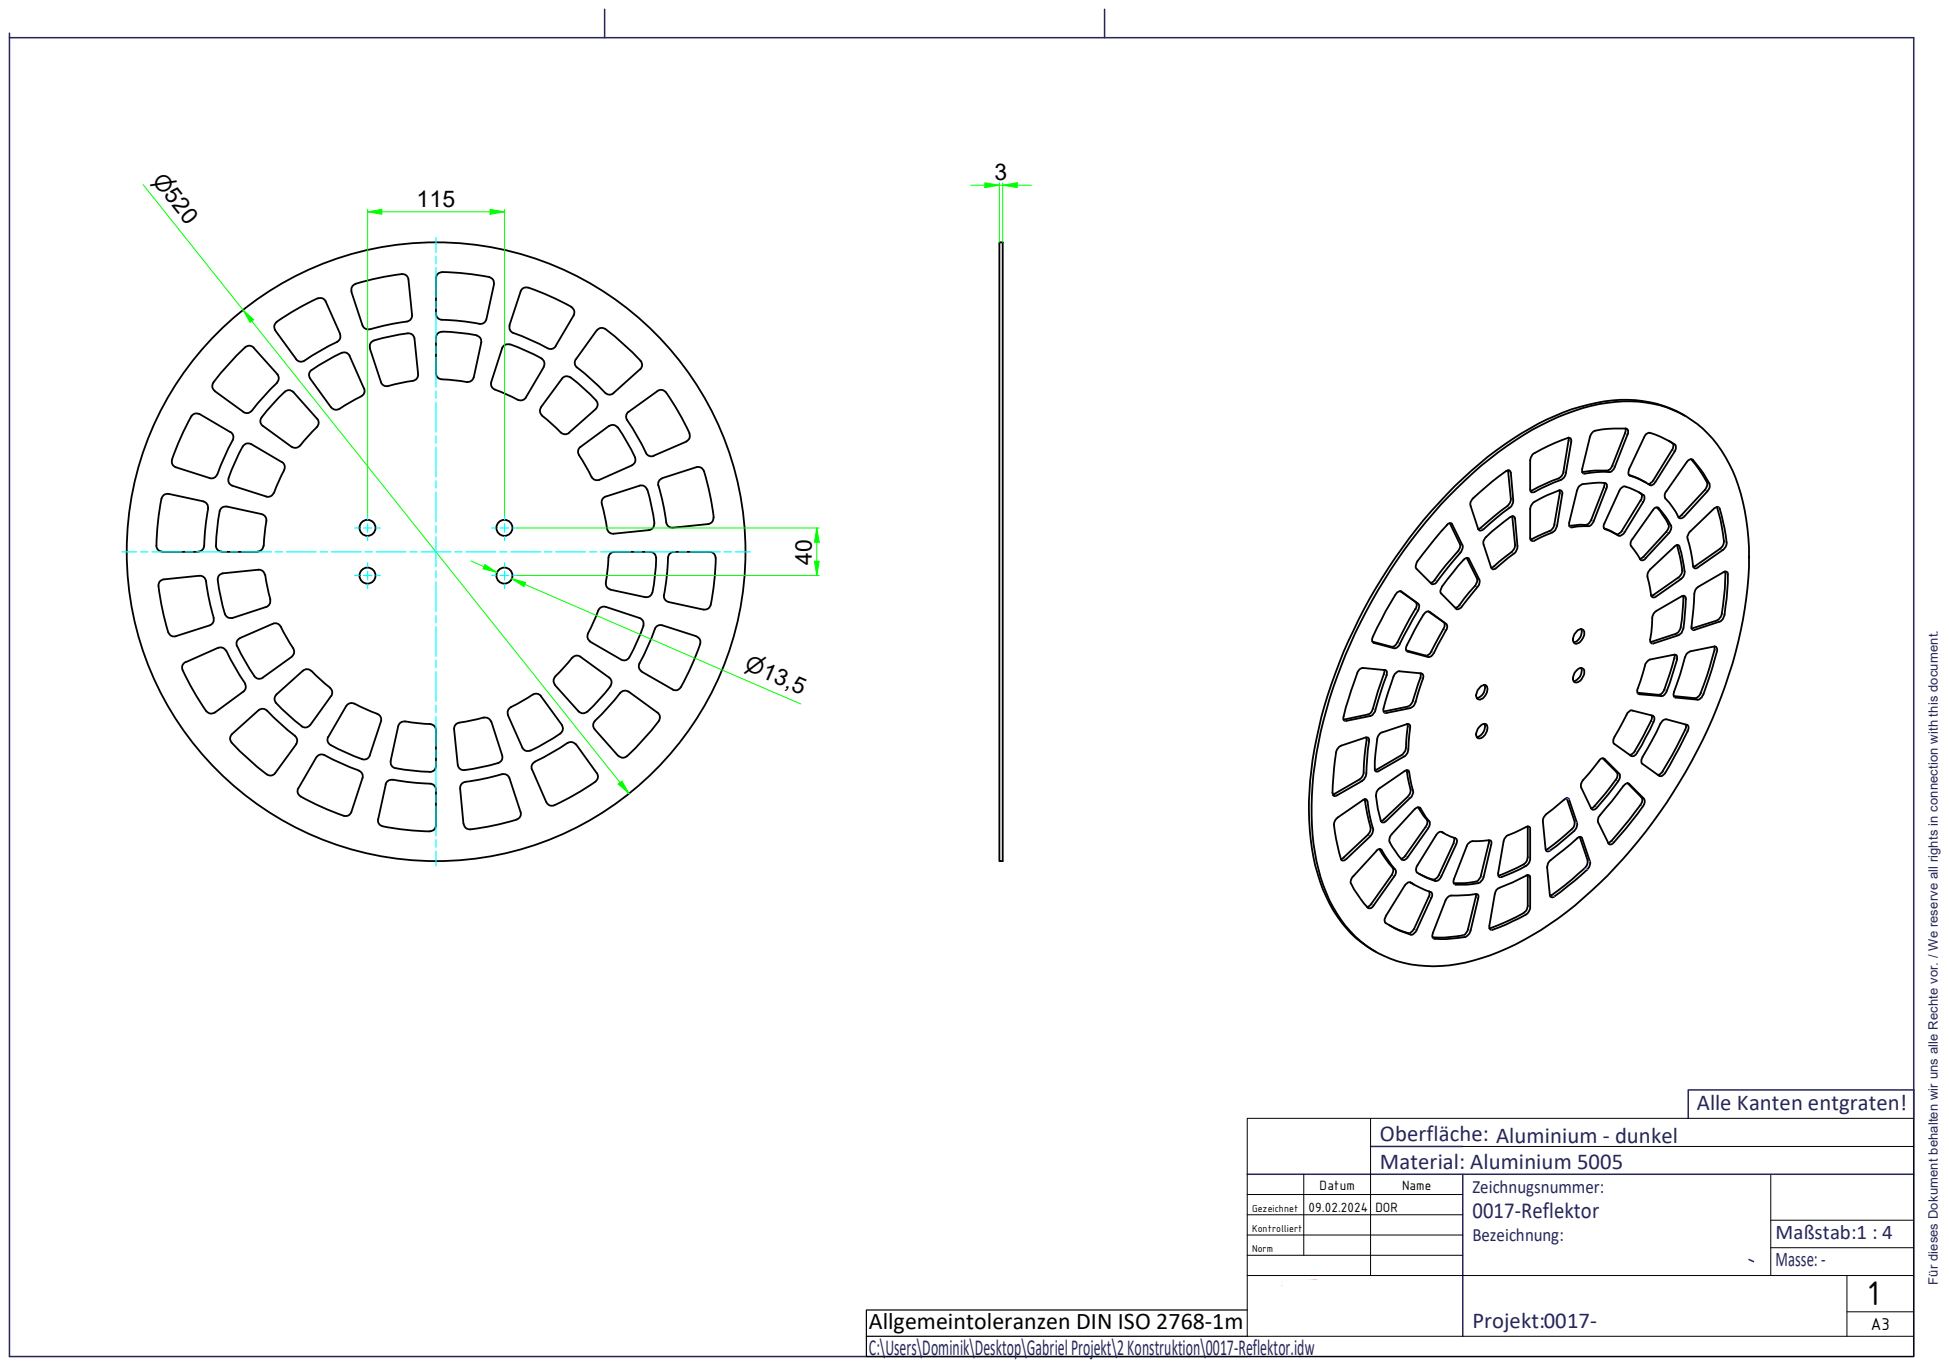
[picture p200: page 1]
Maßstab:1 : 4 Masse: -

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

Alle Kanten entgraten!

Oberfläche: Aluminium - dunkel
Material: Aluminium 5005

Datum | Name | Zeichnugsnummer: 0017-Reflektor Bezeichnung:

Gezeichnet | 09.02.2024 | DOR

Kontrolliert

Norm

Reutte 1153a 6961 Alberschwende +43(0)5579/20056 www.boema.at | Projekt:0017- | 1

Allgemeintoleranzen DIN ISO 2768-1m | | | A3
C:\Users\Dominik\Desktop\Gabriel Projekt\2 Konstruktion\0017-Reflektor.idw
