Skh4rf/satNOGS/doc/ref/0025-Spiral-Antenne_St_tzrohr_Bohrungen.pdf

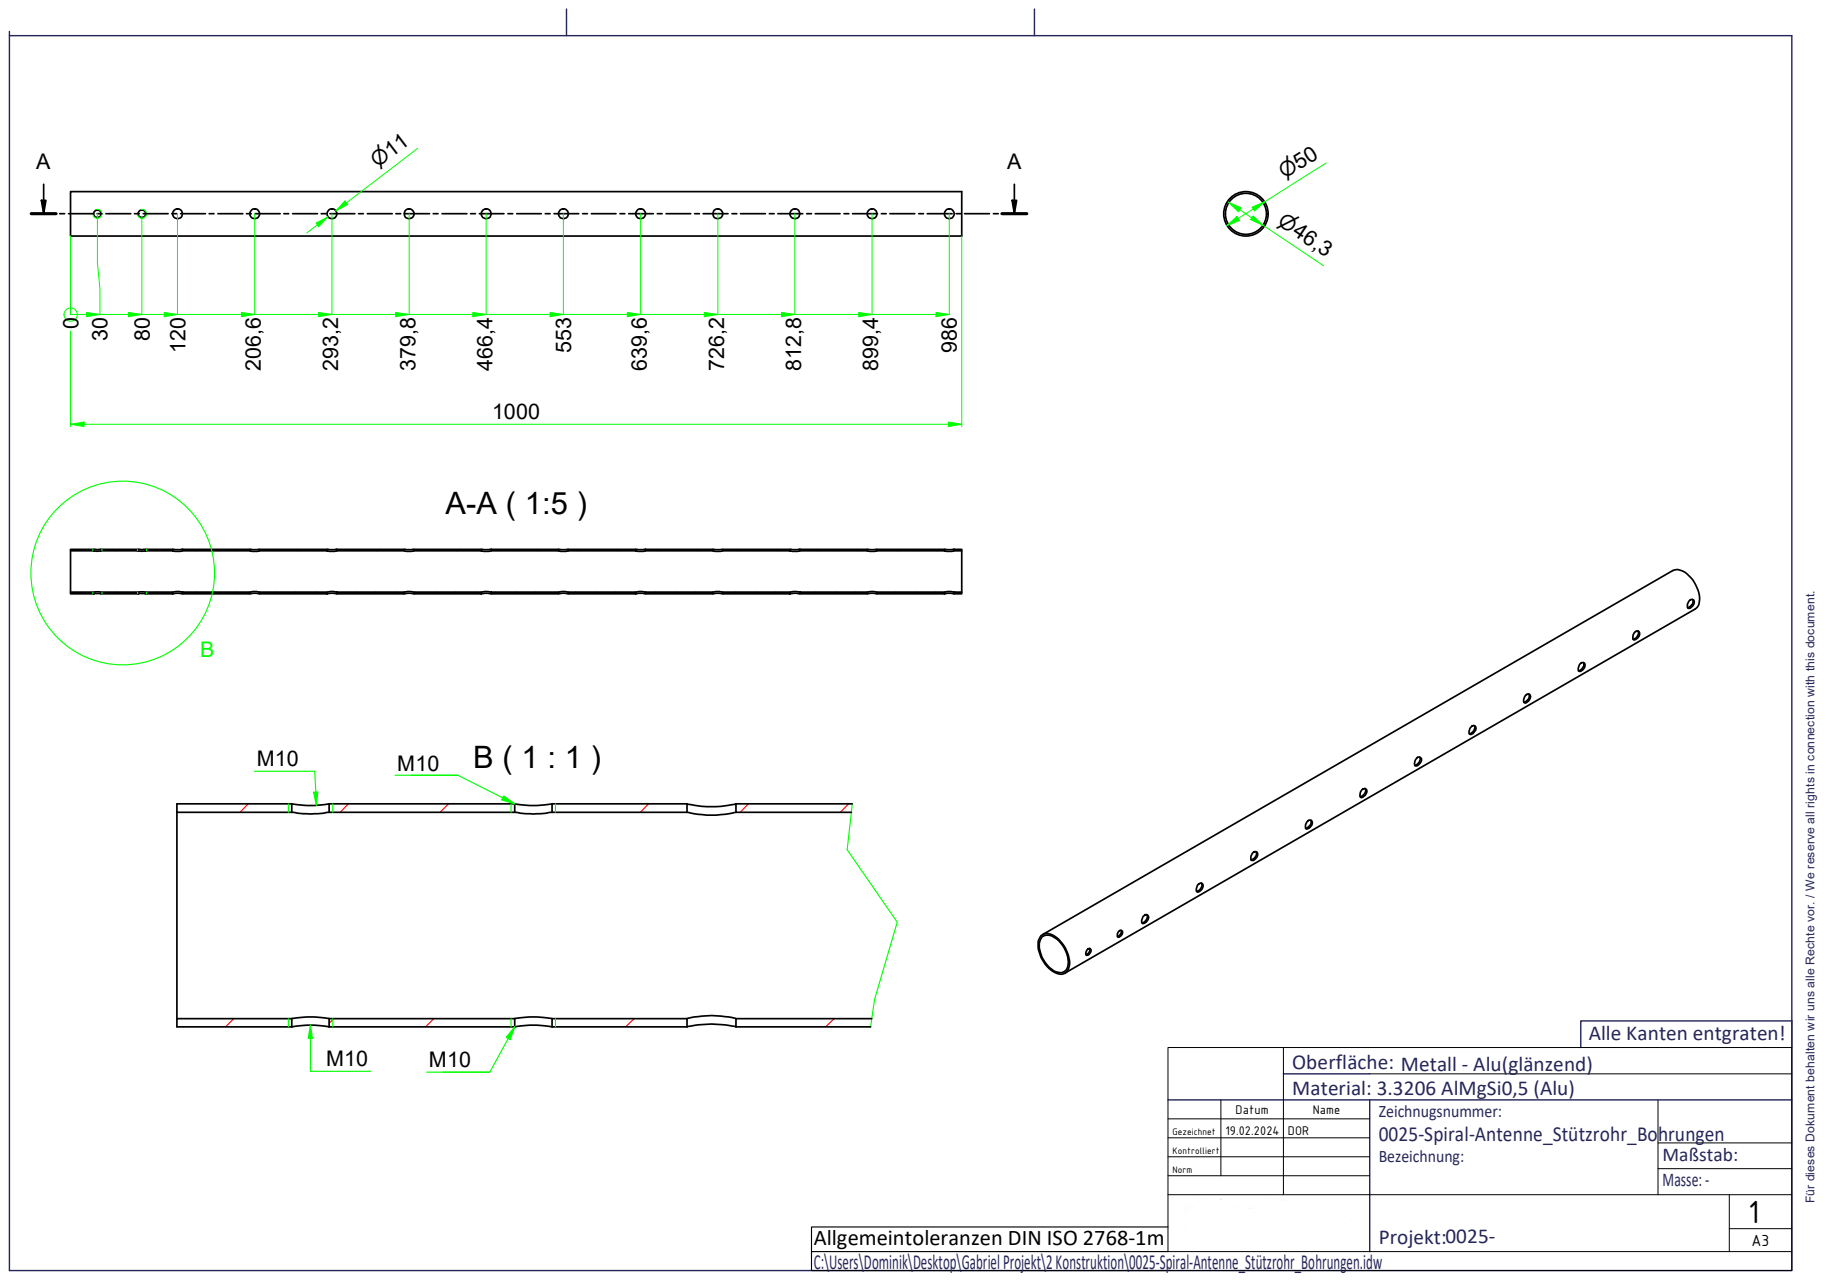
[picture p201: page 1]
Masse: -

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

Alle Kanten entgraten!

Oberfläche: Metall - Alu(glänzend)
Material: 3.3206 AlMgSi0,5 (Alu)

Datum | Name | Zeichnugsnummer: 0025-Spiral-Antenne_Stützrohr_Bohrungen Bezeichnung:

Gezeichnet | 19.02.2024 | DOR

Kontrolliert

Norm

Reutte 1153a 6961 Alberschwende +43(0)5579/20056 www.boema.at | Projekt:0025- | 1

Allgemeintoleranzen DIN ISO 2768-1m | | | A3
C:\Users\Dominik\Desktop\Gabriel Projekt\2 Konstruktion\0025-Spiral-Antenne_Stützrohr_Bohrungen.idw
