Skh4rf/satNOGS/doc/ref/Anpasstopf-Vierkantrohr.pdf

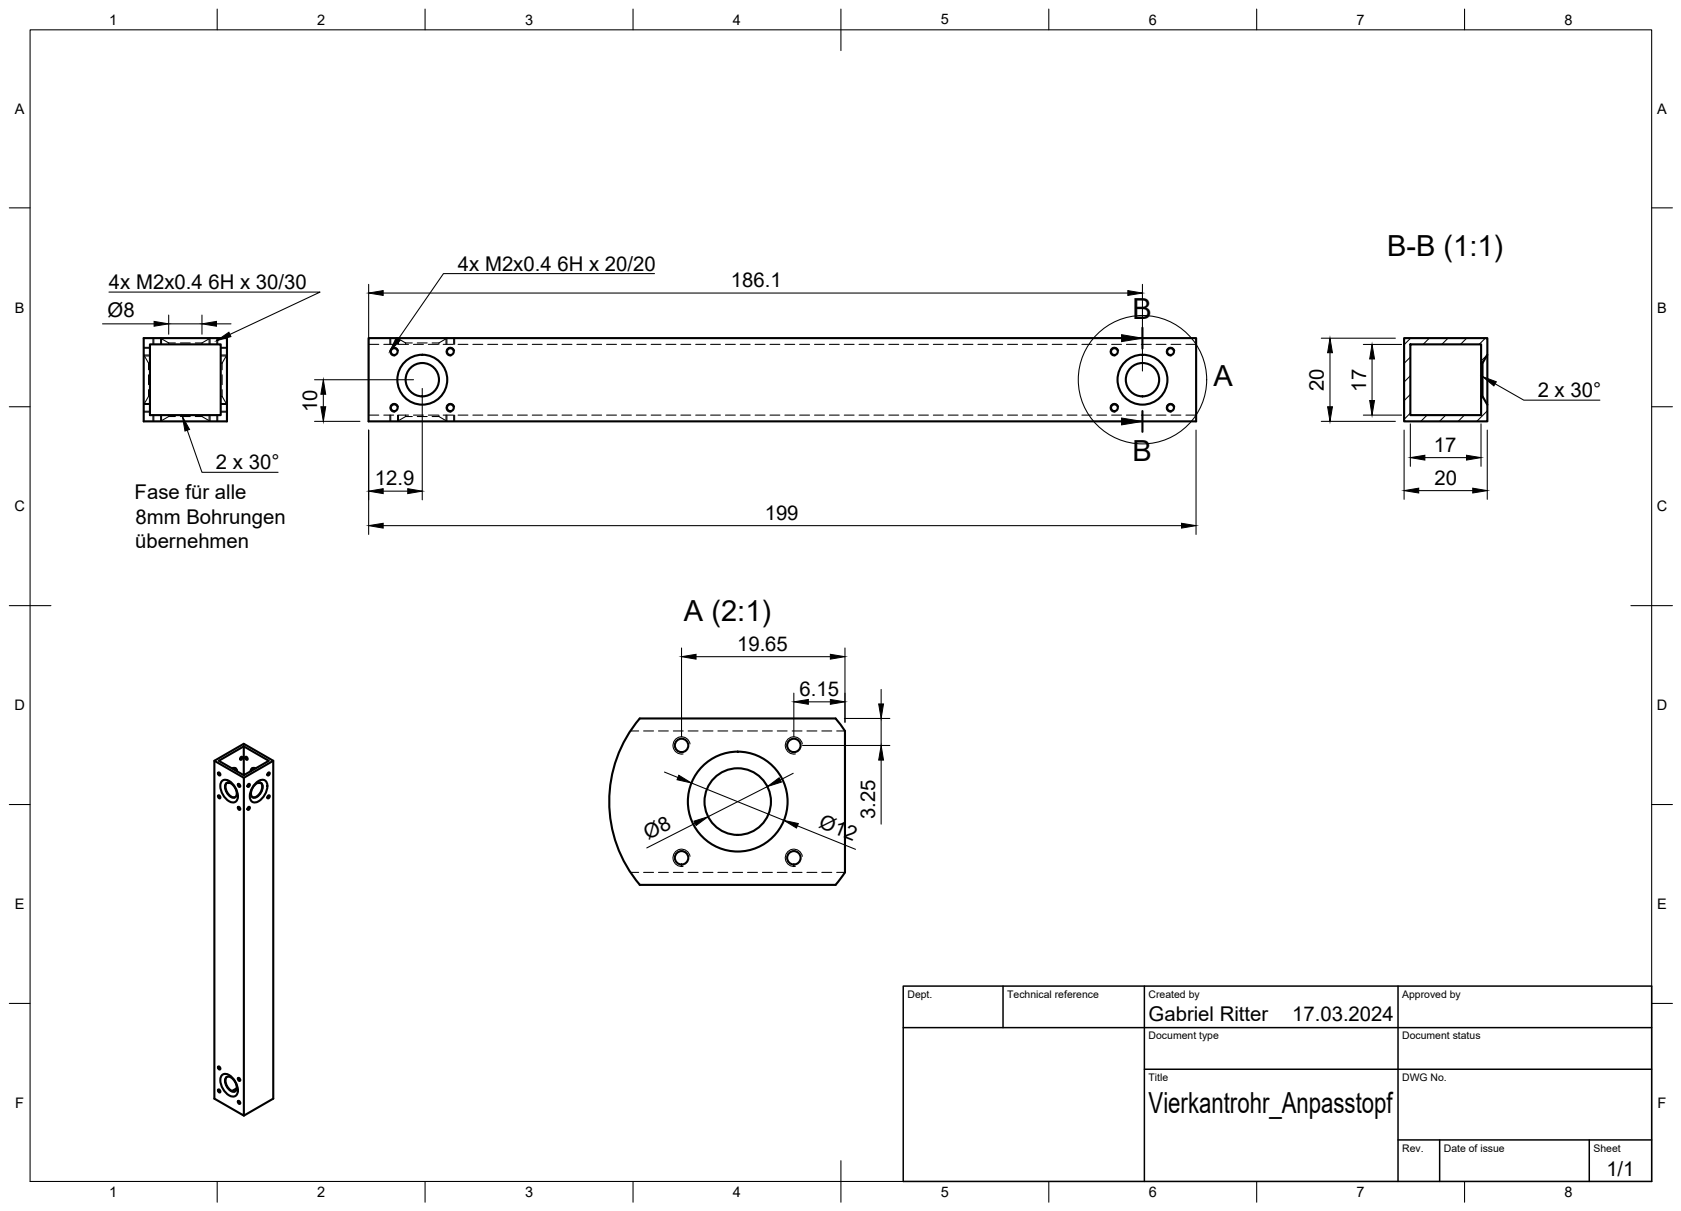
[picture p202: page 1]
Title; DWG No.; Rev.; Date of issue; Sheet

Fase für alle
8mm Bohrungen
übernehmen

Dept. | Technical reference | Created by Gabriel Ritter 17.03.2024 | Approved by

Document type | Document status
