Skh4rf/satNOGS/doc/ref/Lambda_4-Anpasstopf Zeichnung v0.pdf

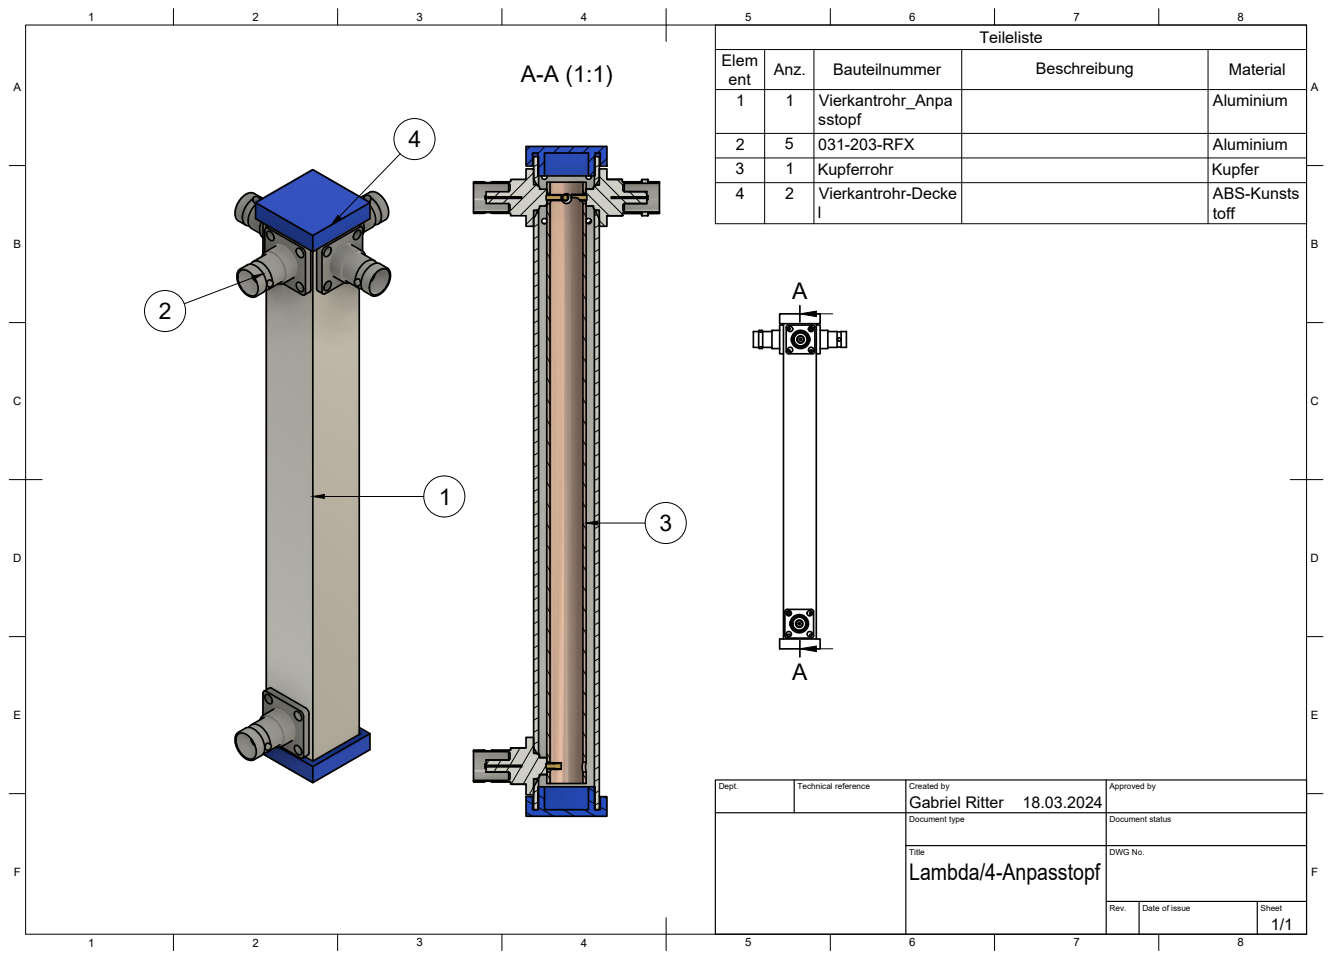
[picture p203: page 1]
Title; DWG No.; Rev.; Date of issue; Sheet

Elem ent | Anz. | Bauteilnummer | Beschreibung | Material

1 | 1 | Vierkantrohr_Anpa sstopf | | Aluminium

2 | 5 | 031-203-RFX | | Aluminium
3 | 1 | Kupferrohr | | Kupfer
4 | 2 | Vierkantrohr-Decke l | | ABS-Kunsts toff

Dept. | Technical reference | Created by Gabriel Ritter 18.03.2024 | Approved by

Document type | Document status
