Skh4rf/satNOGS/doc/ref/Vierkantrohr-Deckel Zeichnung v4.pdf

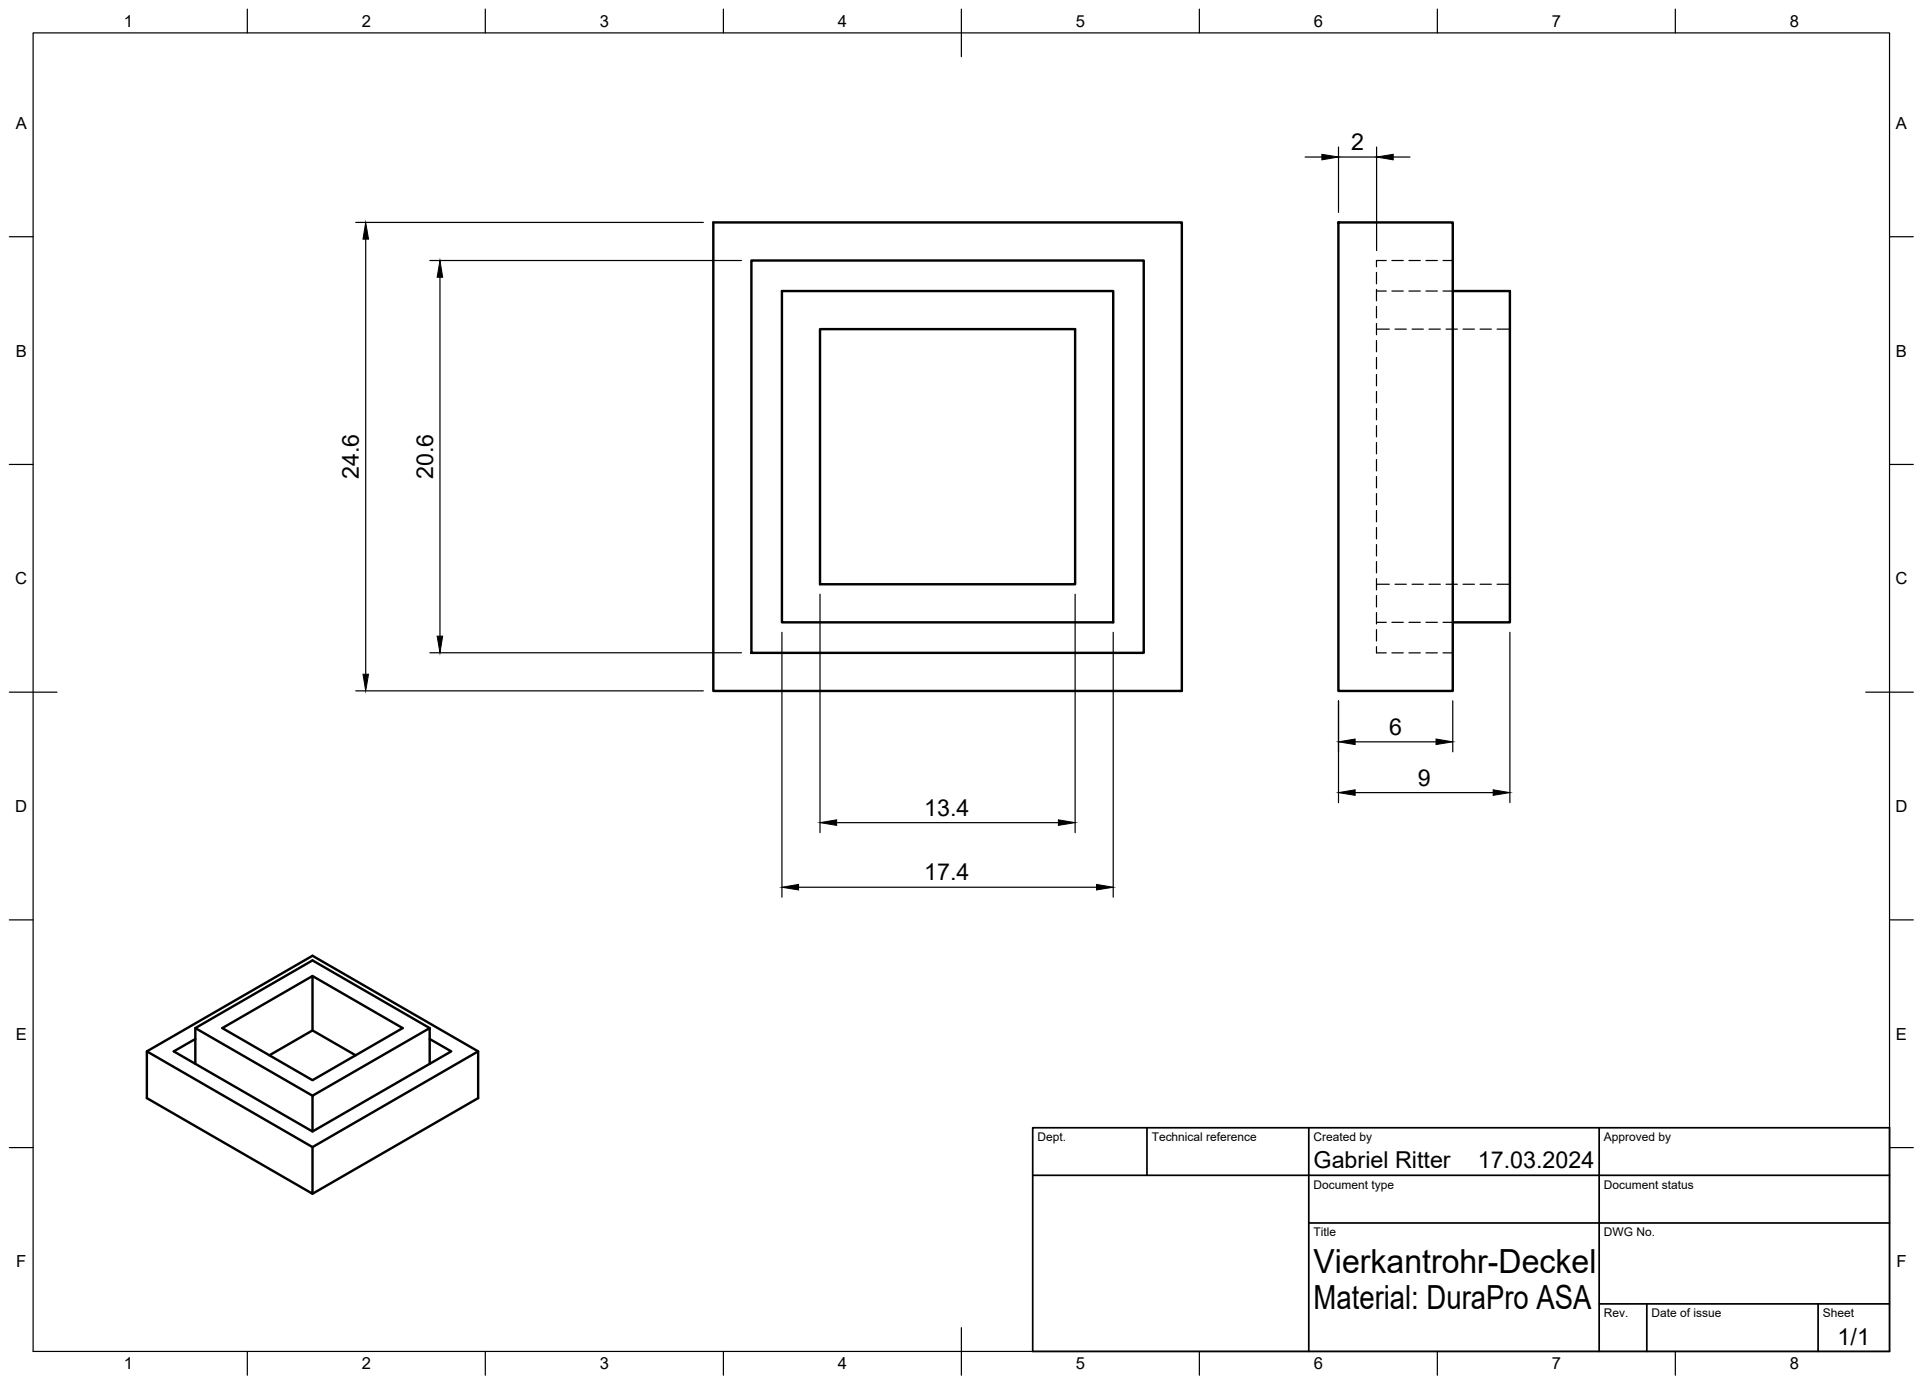
[picture p204: page 1]
Title; DWG No.; Rev.; Date of issue; Sheet; Gabriel Ritter 24.6

Dept. | Technical reference | Created by 17.03.2024 | Approved by

Document type | Document status

Vierkantrohr-Deckel
Material: DuraPro ASA
