Skh4rf/satNOGS/doc/ref/0000-Gesamtbaugruppe.pdf

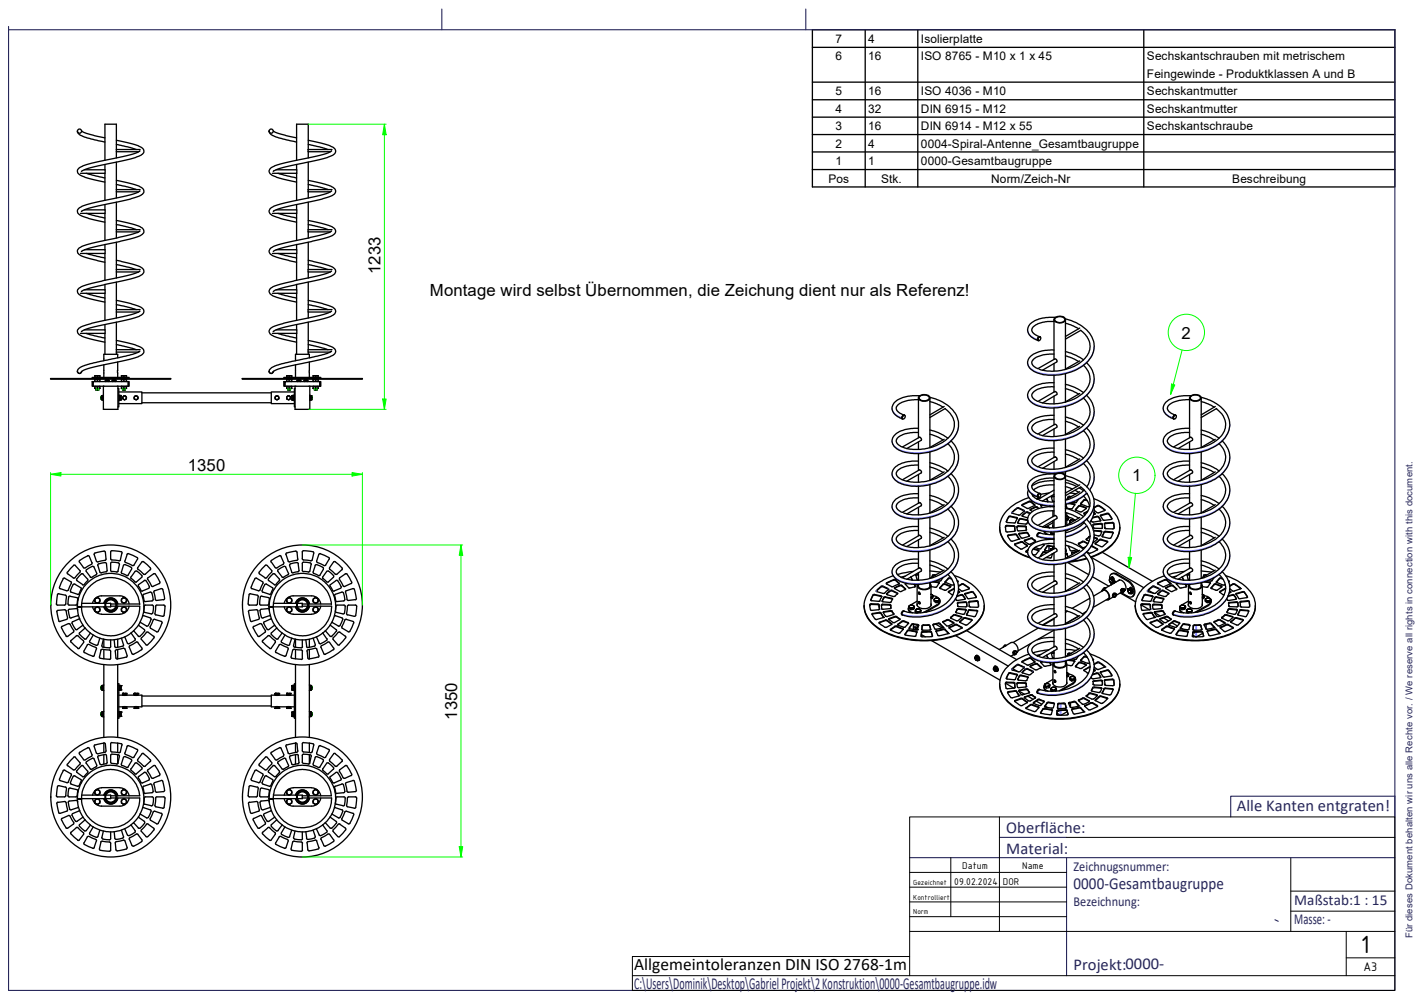
[picture p205: page 1]
ISO 8765 - M10 x 1 x 45; ISO 4036 - M10; Sechskantmutter; DIN 6915 - M12; DIN 6914 - M12 x 55; Sechskantschraube; 09.02.2024 DOR; Maßstab:1 : 15 Masse: -

Sechskantschrauben mit metrischem
Feingewinde - Produktklassen A und B

Montage wird selbst Übernommen, die Zeichung dient nur als Referenz!

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

Alle Kanten entgraten!

Allgemeintoleranzen DIN ISO 2768-1m
C:\Users\Dominik\Desktop\Gabriel Projekt\2 Konstruktion\0000-Gesamtbaugruppe.idw
