Skh4rf/satNOGS/doc/ref/0003-Spiral-Antenne.pdf

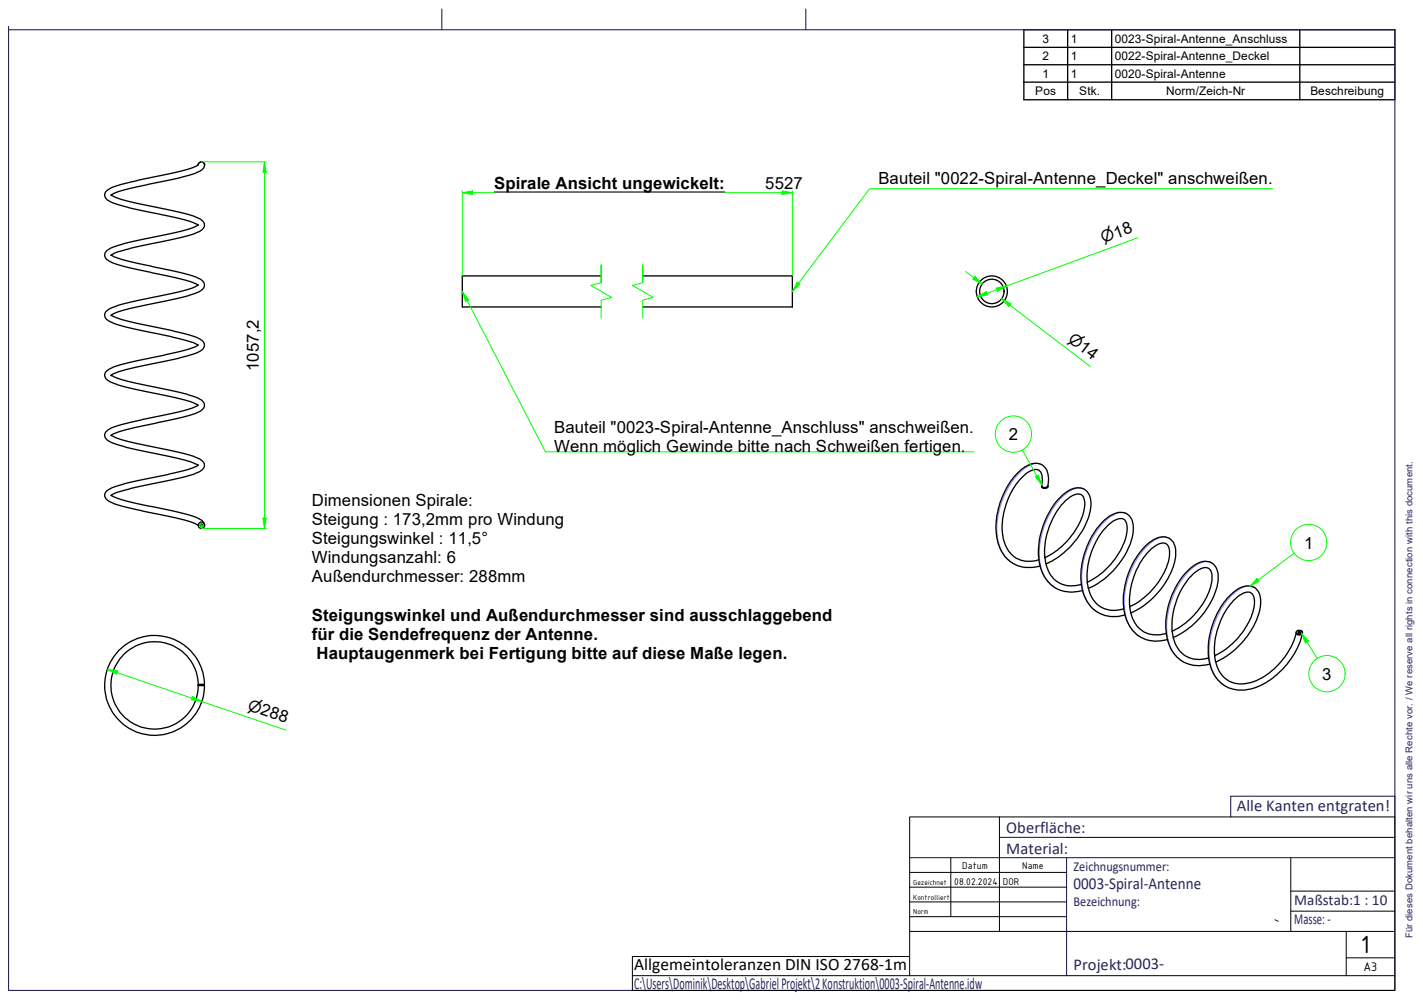
[picture p206: page 1]
Maßstab:1 : 10 Masse: -; Bauteil "0022-Spiral-Antenne_Deckel" anschweißen.

3 | 1 | 0023-Spiral-Antenne_Anschluss
2 | 1 | 0022-Spiral-Antenne_Deckel
1 | 1 | 0020-Spiral-Antenne
Pos | Stk. | Norm/Zeich-Nr | Beschreibung

Spirale Ansicht ungewickelt:

Bauteil "0023-Spiral-Antenne_Anschluss" anschweißen.
Wenn möglich Gewinde bitte nach Schweißen fertigen.

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

Dimensionen Spirale:
Steigung : 173,2mm pro Windung
Steigungswinkel : 11,5°
Windungsanzahl: 6
Außendurchmesser: 288mm

Steigungswinkel und Außendurchmesser sind ausschlaggebend
für die Sendefrequenz der Antenne.
Hauptaugenmerk bei Fertigung bitte auf diese Maße legen.

Alle Kanten entgraten!

Datum | Name | Zeichnugsnummer: 0003-Spiral-Antenne Bezeichnung:

Gezeichnet | 08.02.2024 | DOR

Kontrolliert

Norm

Projekt:0003- | 1

Allgemeintoleranzen DIN ISO 2768-1m | | | A3
C:\Users\Dominik\Desktop\Gabriel Projekt\2 Konstruktion\0003-Spiral-Antenne.idw
