Skh4rf/satNOGS/doc/ref/0012-Struktrurohr-Rohrschnitt.pdf

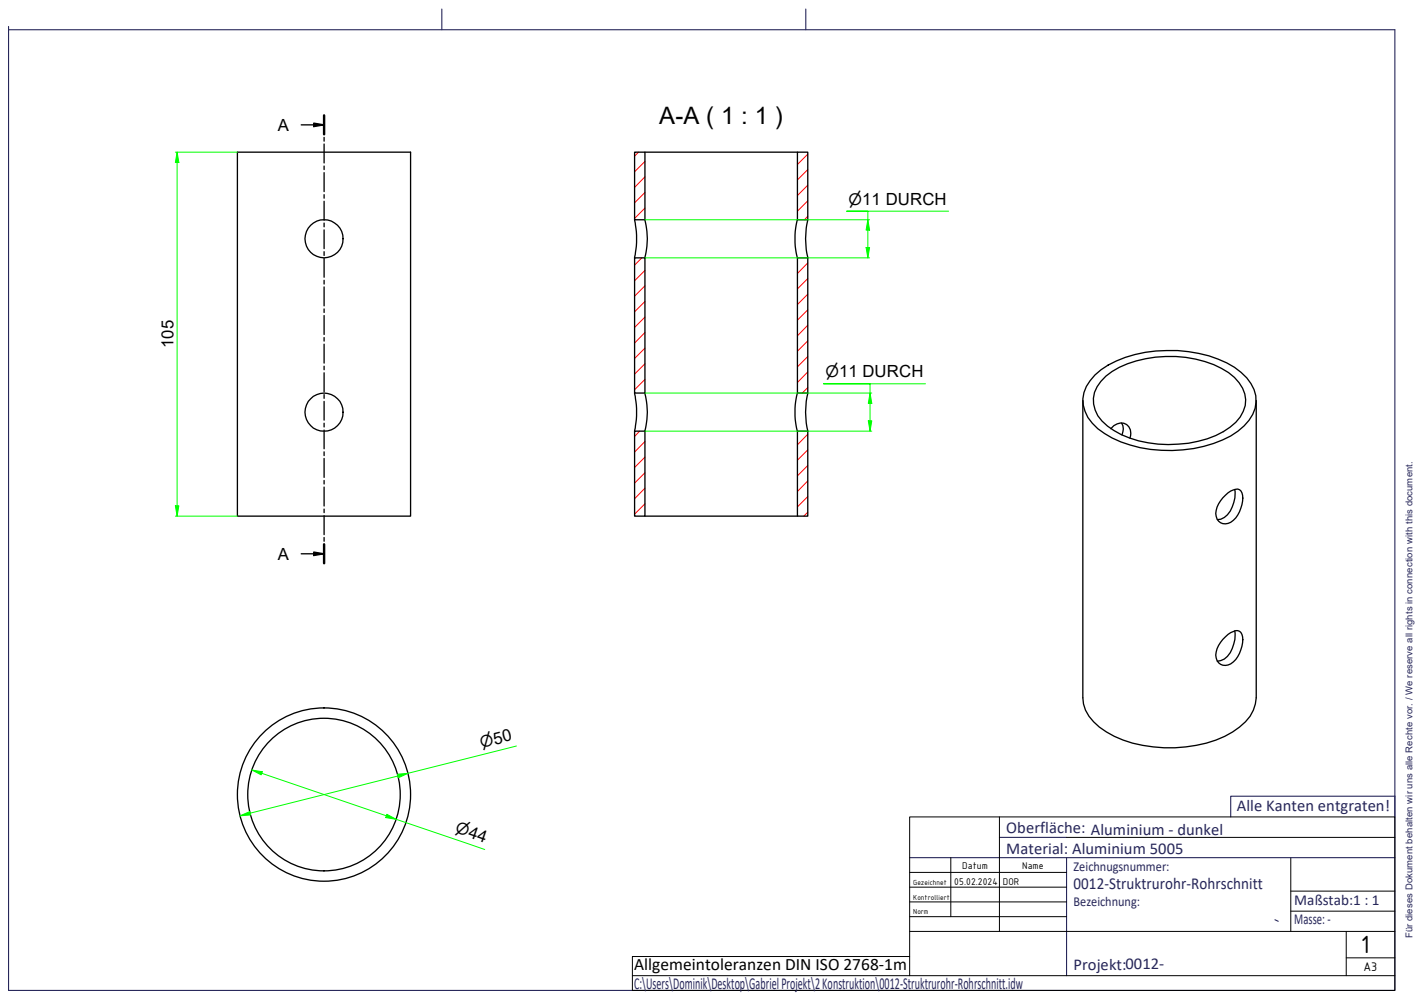
[picture p208: page 1]
Maßstab:1 : 1 Masse: -; ⌀11 DURCH

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

Alle Kanten entgraten!

Oberfläche: Aluminium - dunkel
Material: Aluminium 5005

Datum | Name | Zeichnugsnummer: 0012-Struktrurohr-Rohrschnitt Bezeichnung:

Gezeichnet | 05.02.2024 | DOR

Kontrolliert

Norm

Projekt:0012- | 1

Allgemeintoleranzen DIN ISO 2768-1m | | | A3
C:\Users\Dominik\Desktop\Gabriel Projekt\2 Konstruktion\0012-Struktrurohr-Rohrschnitt.idw
