Skh4rf/satNOGS/doc/ref/0013-Antennenrohr-Grundplatte.pdf

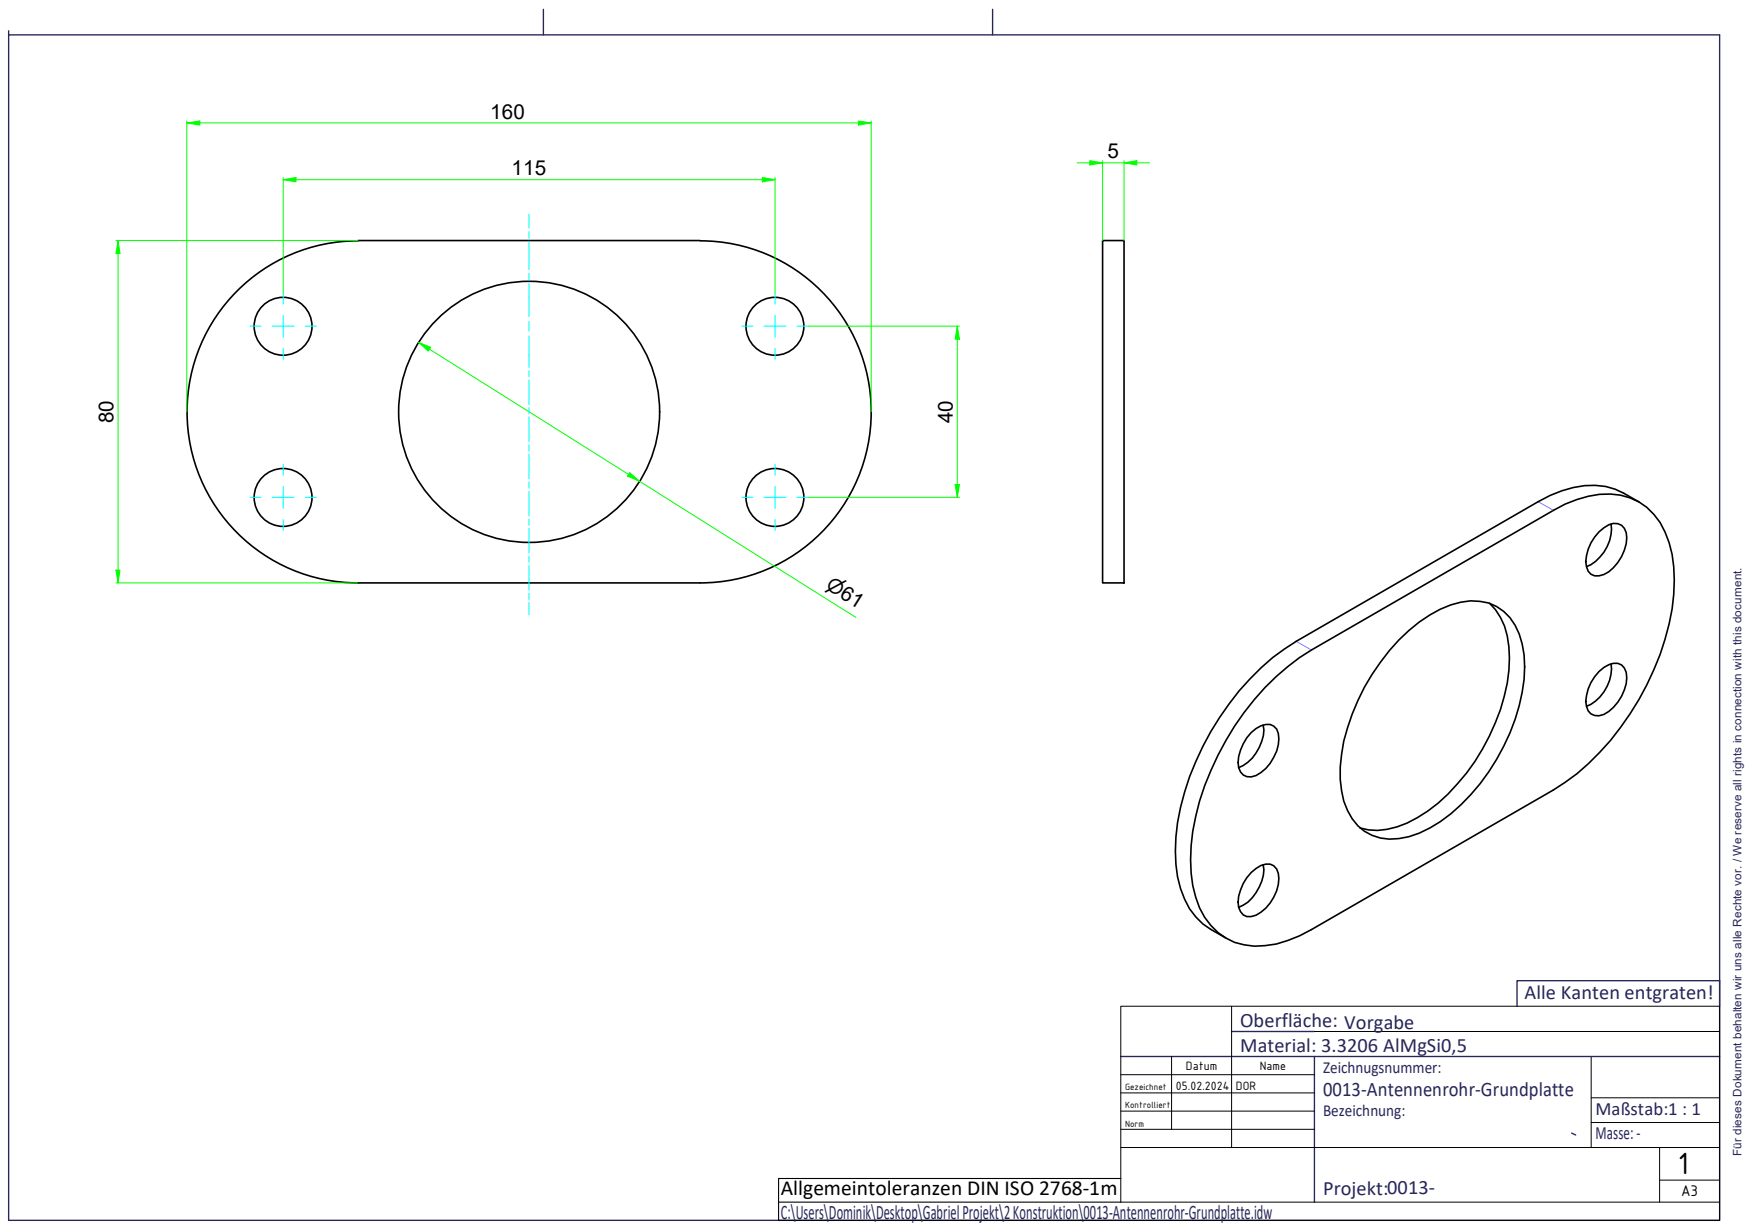
[picture p209: page 1]
Maßstab:1 : 1; Material: 3.3206 AlMgSi0,5; Oberfläche: Vorgabe; Masse: -

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

Alle Kanten entgraten!

Datum | Name | Zeichnugsnummer: 0013-Antennenrohr-Grundplatte Bezeichnung:

Gezeichnet | 05.02.2024 | DOR

Kontrolliert

Norm

Projekt:0013- | 1

Allgemeintoleranzen DIN ISO 2768-1m | | | A3
C:\Users\Dominik\Desktop\Gabriel Projekt\2 Konstruktion\0013-Antennenrohr-Grundplatte.idw
