Skh4rf/satNOGS/doc/ref/0014-Antennenrohr-Rohrschnitt.pdf

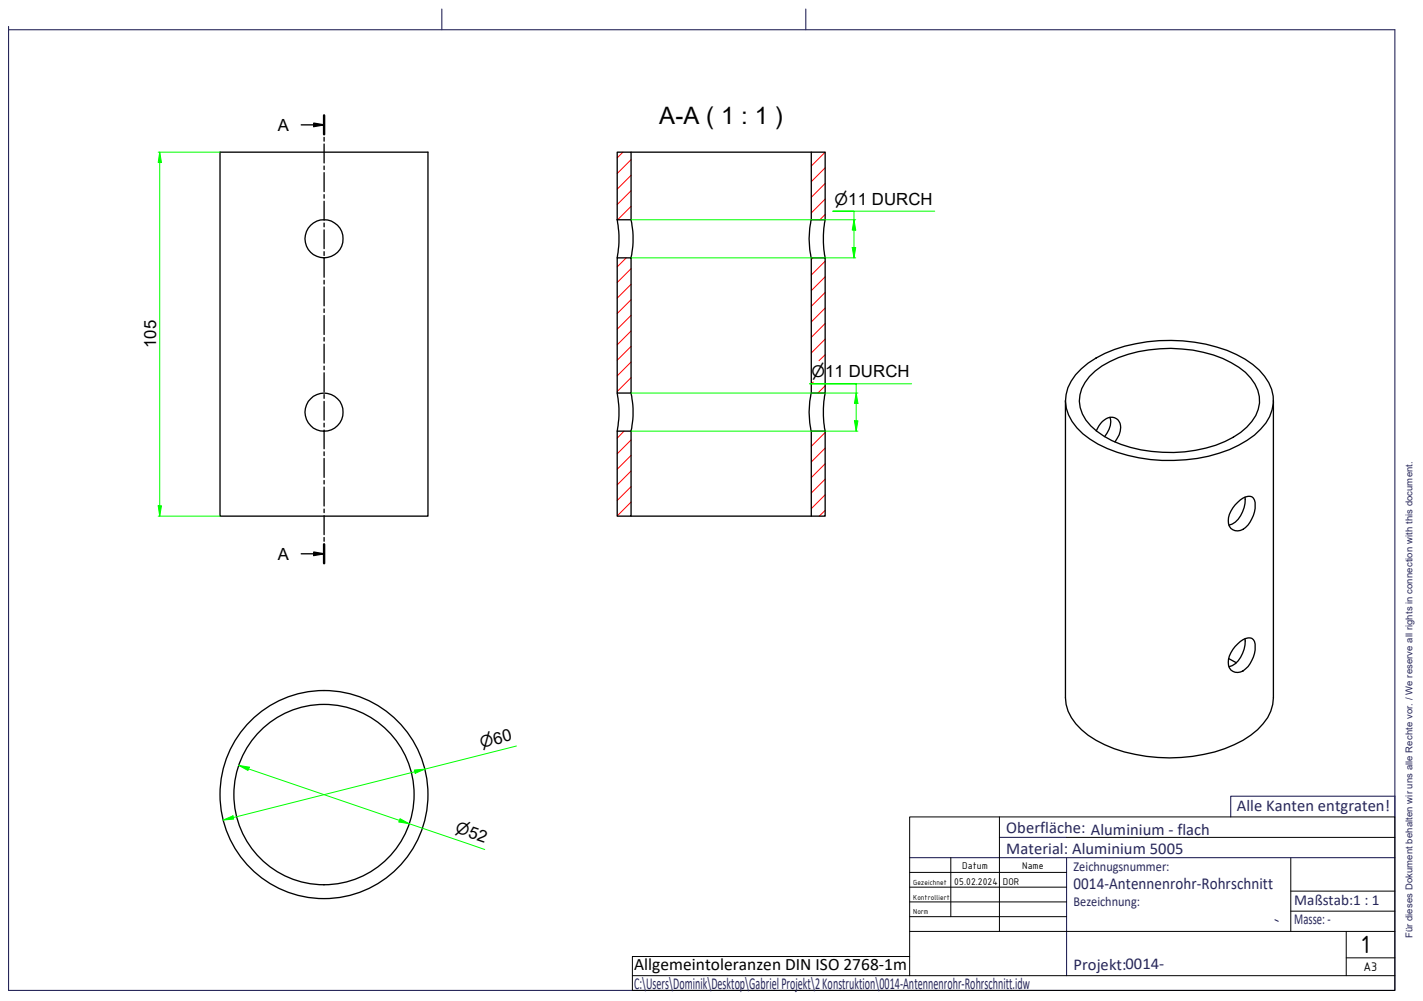
[picture p210: page 1]
Maßstab:1 : 1 Masse: -; ⌀11 DURCH

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

Alle Kanten entgraten!

Oberfläche: Aluminium - flach
Material: Aluminium 5005

Datum | Name | Zeichnugsnummer: 0014-Antennenrohr-Rohrschnitt Bezeichnung:

Gezeichnet | 05.02.2024 | DOR

Kontrolliert

Norm

Projekt:0014- | 1

Allgemeintoleranzen DIN ISO 2768-1m | | | A3
C:\Users\Dominik\Desktop\Gabriel Projekt\2 Konstruktion\0014-Antennenrohr-Rohrschnitt.idw
