Skh4rf/satNOGS/doc/ref/0016-Vierkantprofil.pdf

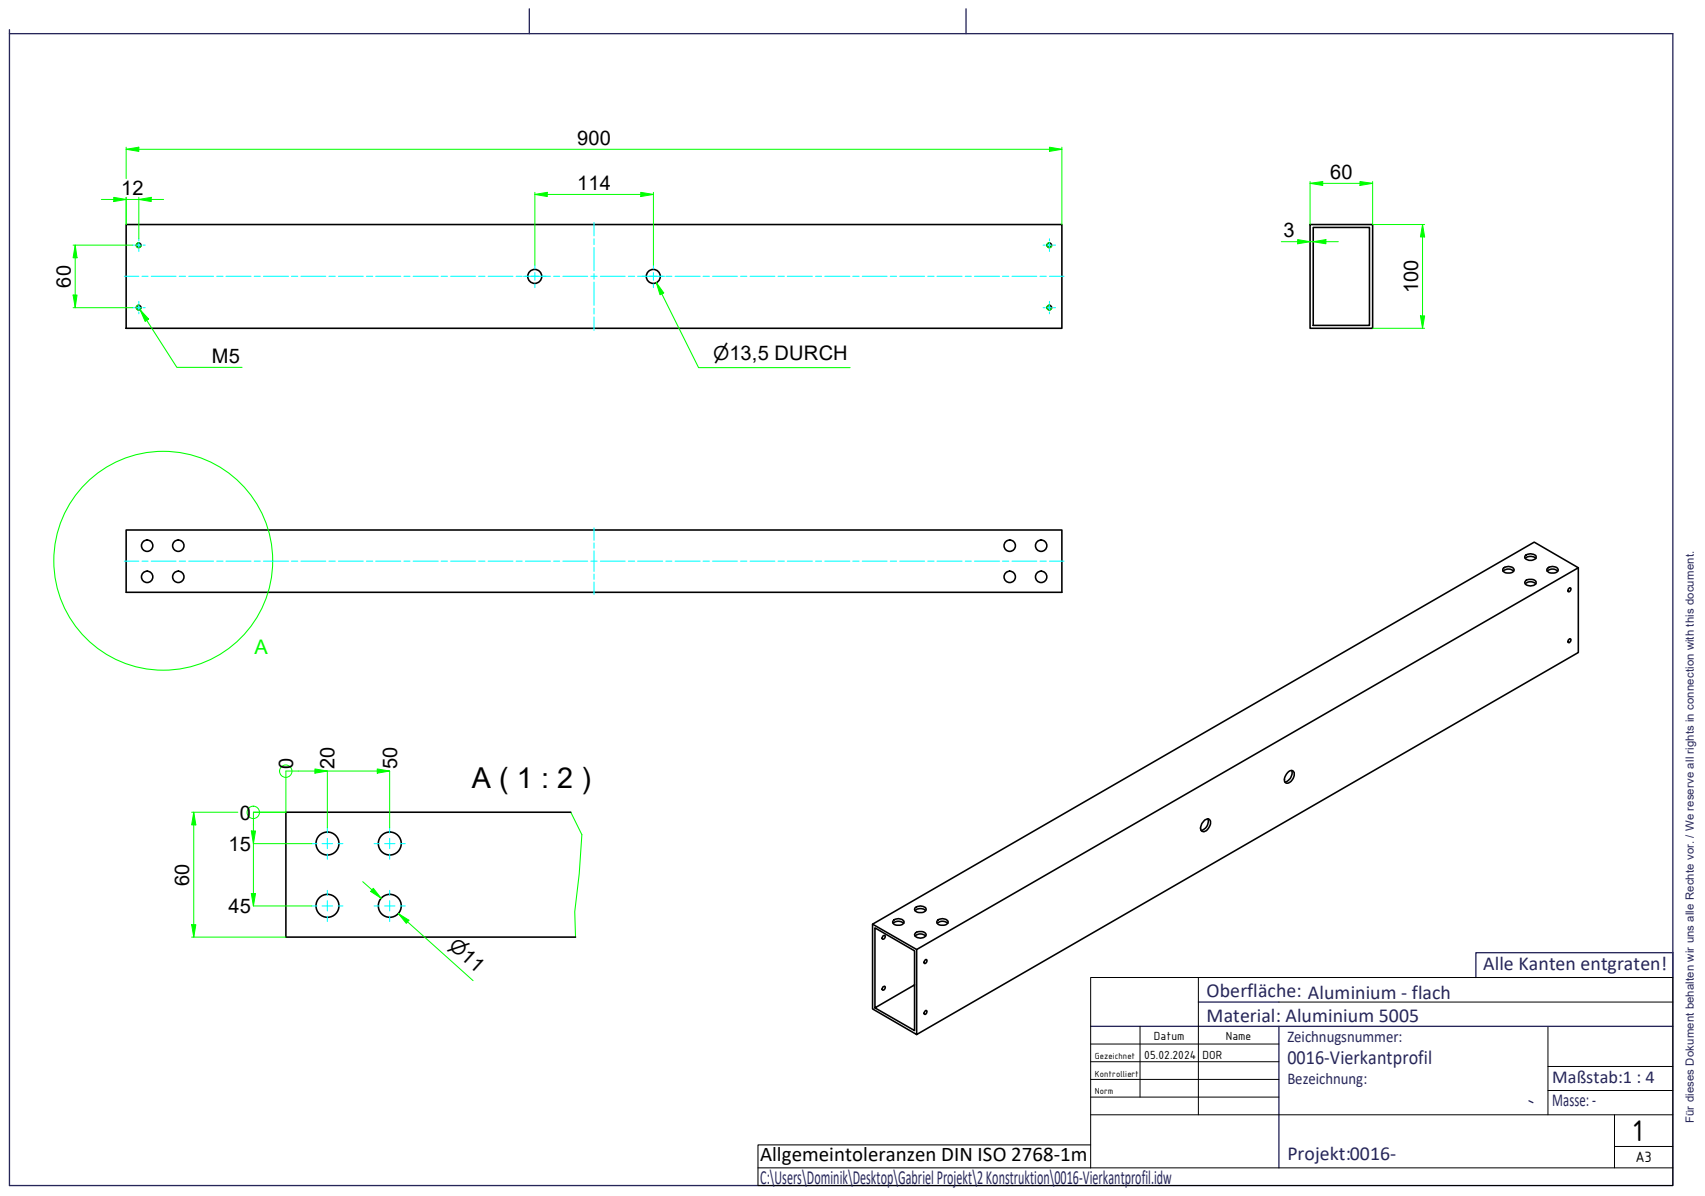
[picture p211: page 1]
Maßstab:1 : 4 Masse: -; ⌀13,5 DURCH

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

Alle Kanten entgraten!

Oberfläche: Aluminium - flach
Material: Aluminium 5005

Datum | Name | Zeichnugsnummer: 0016-Vierkantprofil Bezeichnung:

Gezeichnet | 05.02.2024 | DOR

Kontrolliert

Norm

Projekt:0016- | 1

Allgemeintoleranzen DIN ISO 2768-1m | | | A3
C:\Users\Dominik\Desktop\Gabriel Projekt\2 Konstruktion\0016-Vierkantprofil.idw
