Skh4rf/satNOGS/doc/ref/0018-Vierkantprofil_Abdeckung.pdf

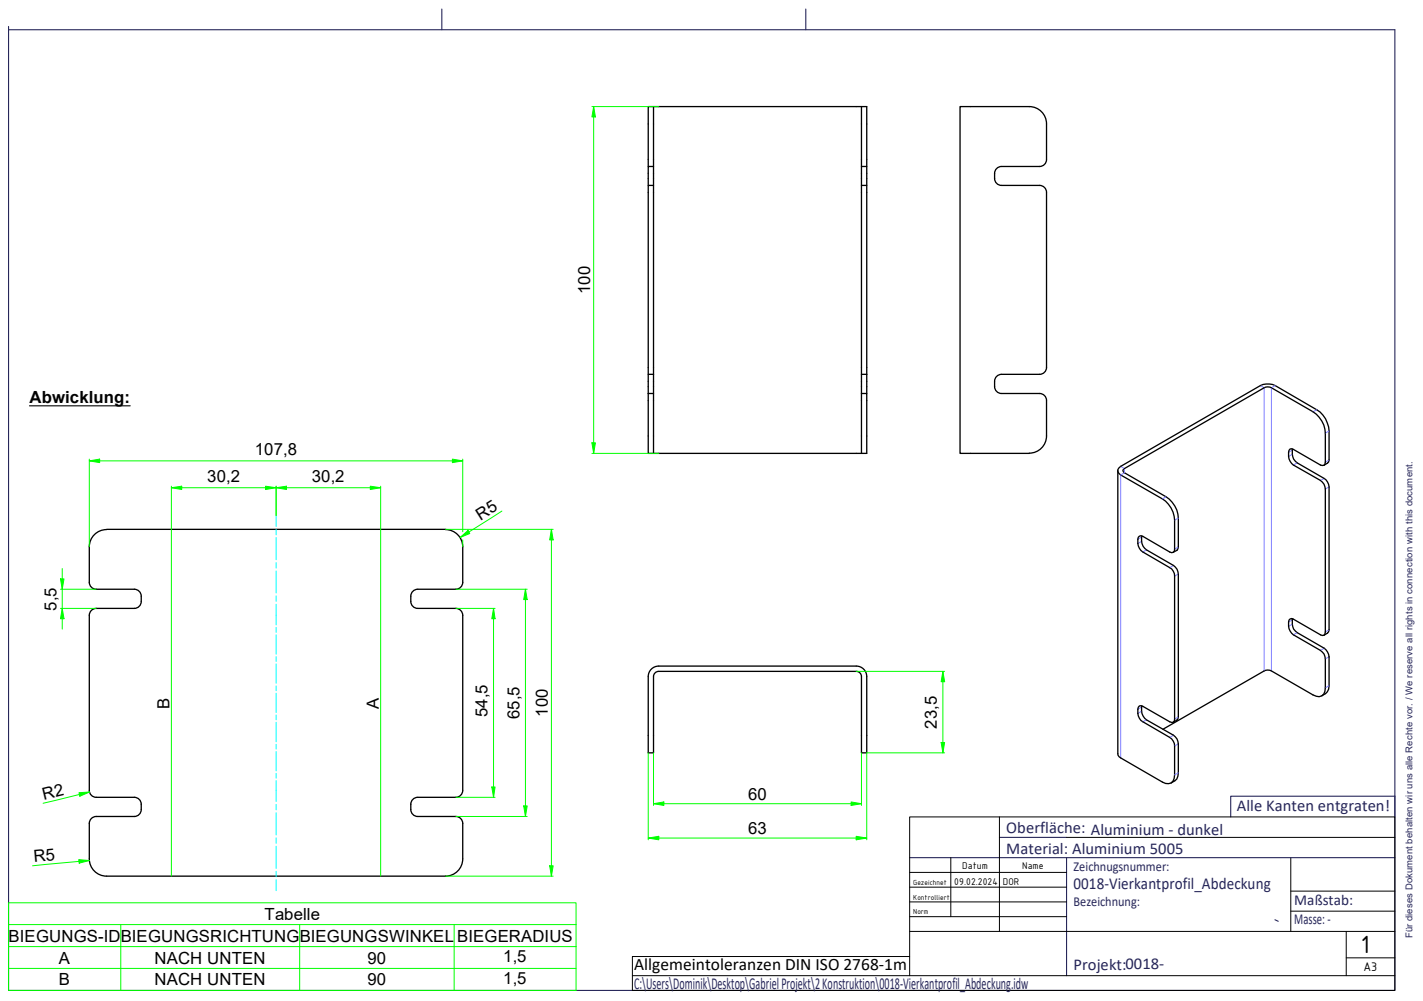
[picture p212: page 1]
Masse: -

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

Alle Kanten entgraten!

Oberfläche: Aluminium - dunkel
Material: Aluminium 5005

Datum | Name | Zeichnugsnummer: 0018-Vierkantprofil_Abdeckung Bezeichnung:

Gezeichnet | 09.02.2024 | DOR

Kontrolliert

BIEGUNGS-IDBIEGUNGSRICHTUNGBIEGUNGSWINKEL BIEGERADIUS

Projekt:0018- | 1

A | NACH UNTEN | 90 | 1,5
B | NACH UNTEN | 90 | 1,5

Allgemeintoleranzen DIN ISO 2768-1m | | | A3
C:\Users\Dominik\Desktop\Gabriel Projekt\2 Konstruktion\0018-Vierkantprofil_Abdeckung.idw
