Skh4rf/satNOGS/doc/ref/0022-Spiral-Antenne_Deckel.pdf

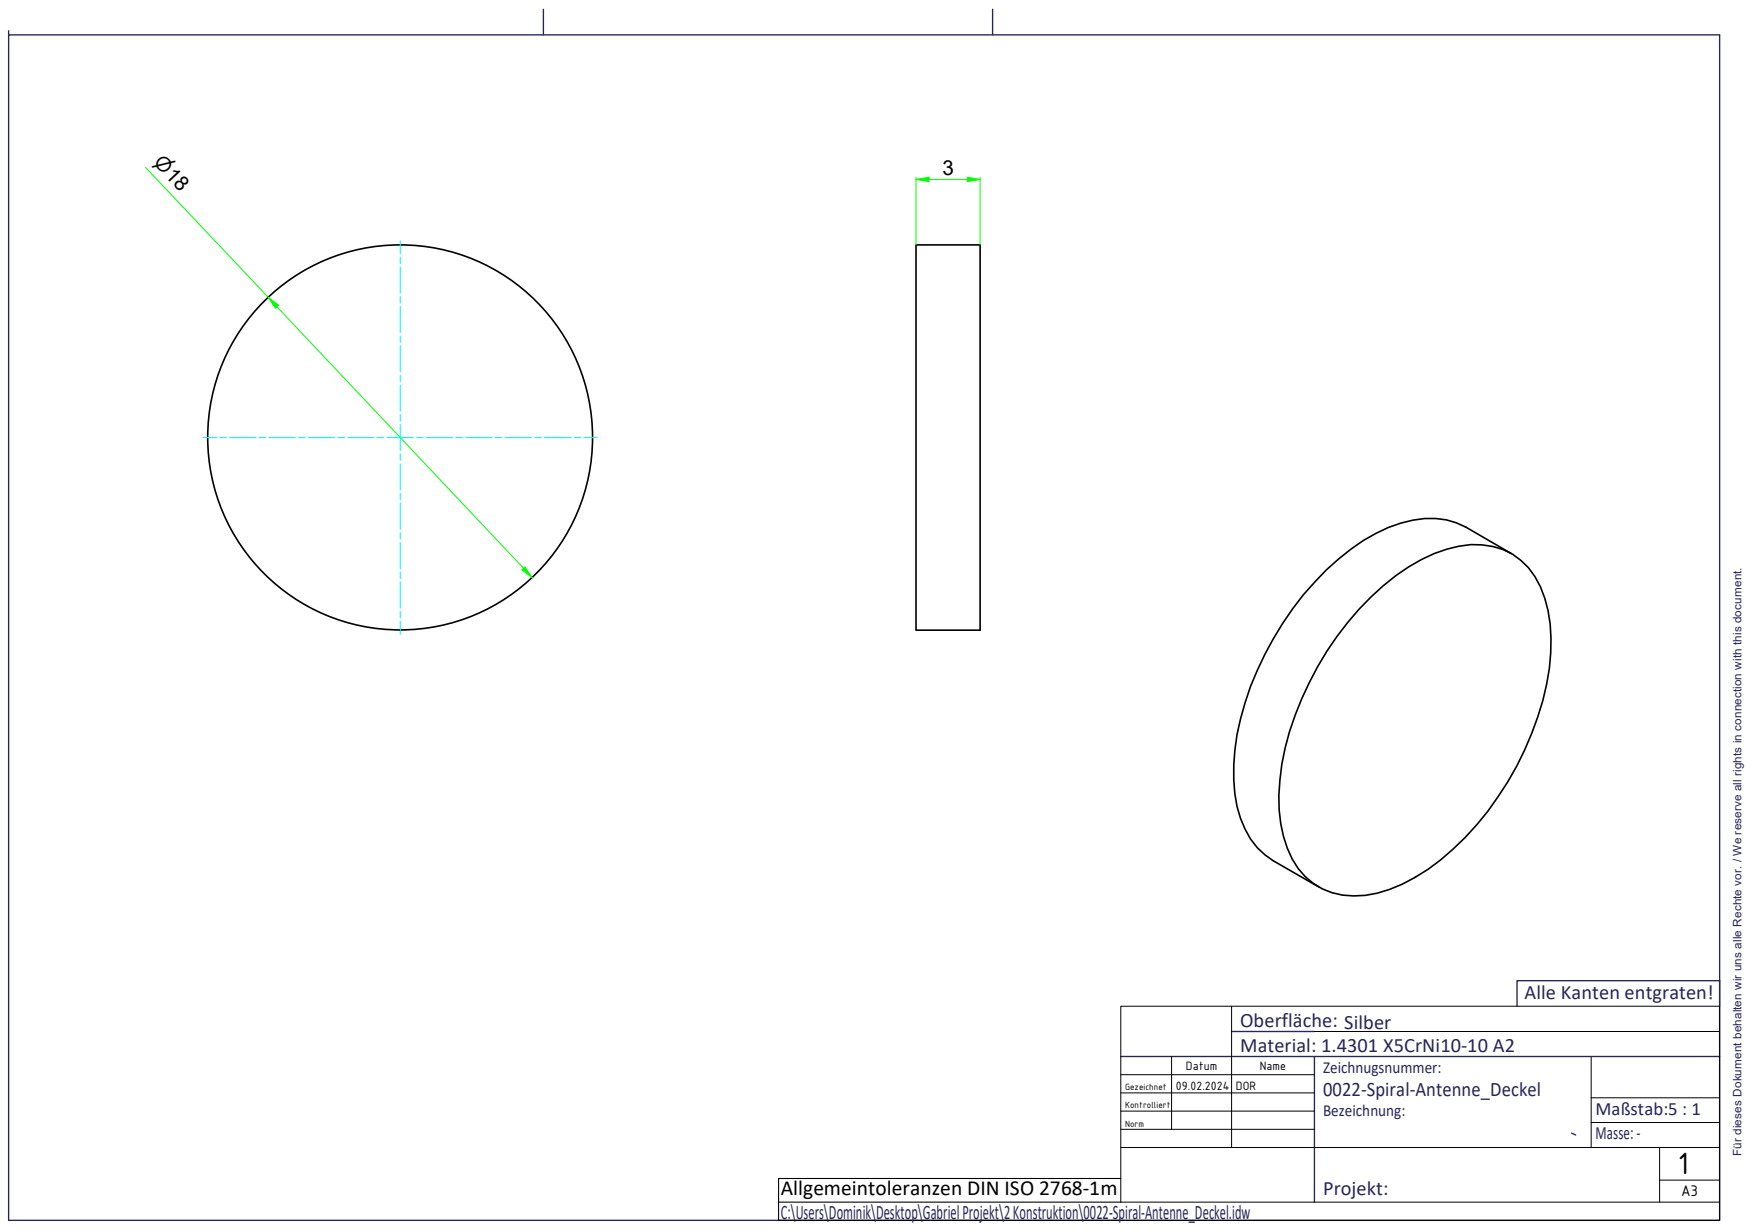
[picture p213: page 1]
Maßstab:5 : 1; Material: 1.4301 X5CrNi10-10 A2; Oberfläche: Silber; Masse: -

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

Alle Kanten entgraten!

Datum | Name | Zeichnugsnummer: 0022-Spiral-Antenne_Deckel Bezeichnung:

Gezeichnet | 09.02.2024 | DOR

Kontrolliert

Norm

Projekt: | 1

Allgemeintoleranzen DIN ISO 2768-1m | | | A3
C:\Users\Dominik\Desktop\Gabriel Projekt\2 Konstruktion\0022-Spiral-Antenne_Deckel.idw
