Skh4rf/satNOGS/doc/ref/0023-Spiral-Antenne_Anschluss.pdf

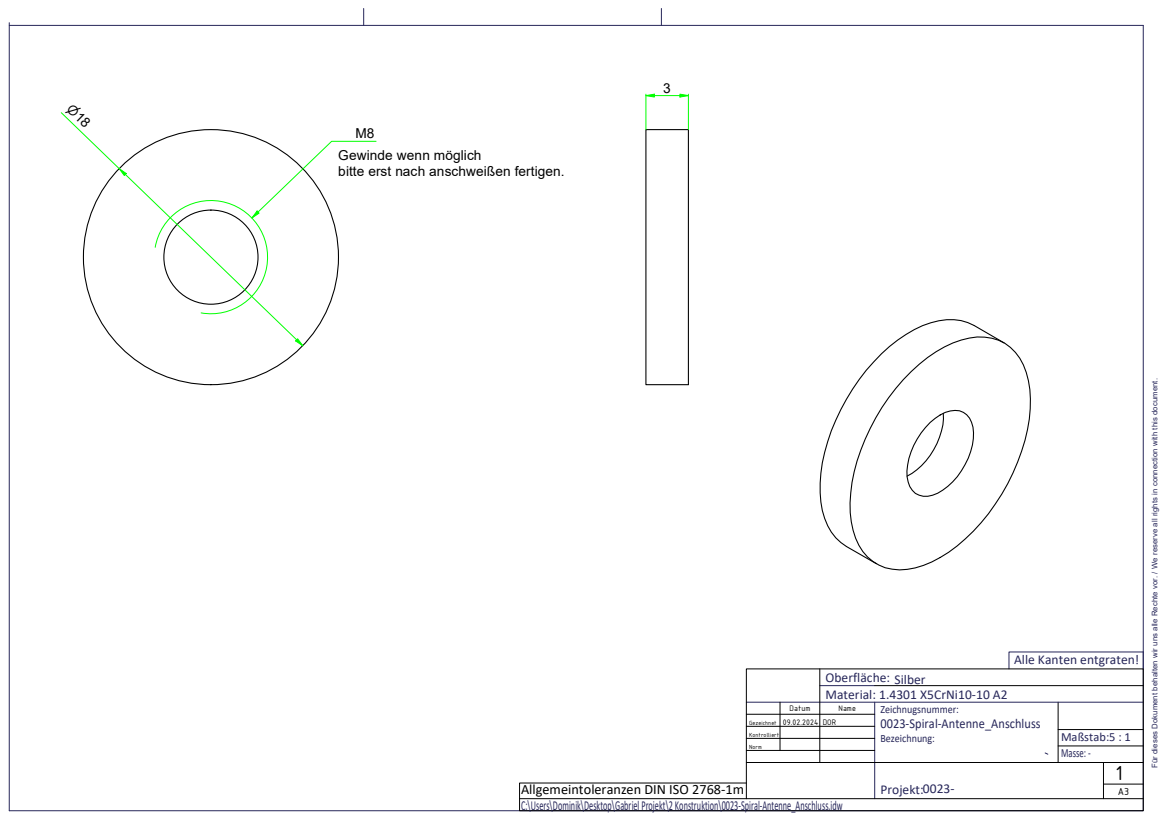
[picture p214: page 1]
Maßstab:5 : 1; Material: 1.4301 X5CrNi10-10 A2; Oberfläche: Silber; Masse: -

Gewinde wenn möglich
bitte erst nach anschweißen fertigen.

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

Alle Kanten entgraten!

Datum | Name | Zeichnugsnummer: 0023-Spiral-Antenne_Anschluss Bezeichnung:

Gezeichnet | 09.02.2024 | DOR

Kontrolliert

Norm

Projekt:0023- | 1

Allgemeintoleranzen DIN ISO 2768-1m | | | A3
C:\Users\Dominik\Desktop\Gabriel Projekt\2 Konstruktion\0023-Spiral-Antenne_Anschluss.idw
