Skh4rf/satNOGS/doc/general-files/Diplomprojekt_Fertigungsunterlagen_Vollständig/Diplomprojekt_Fertigungsunterlagen/0020-Spiral-Antenne.pdf

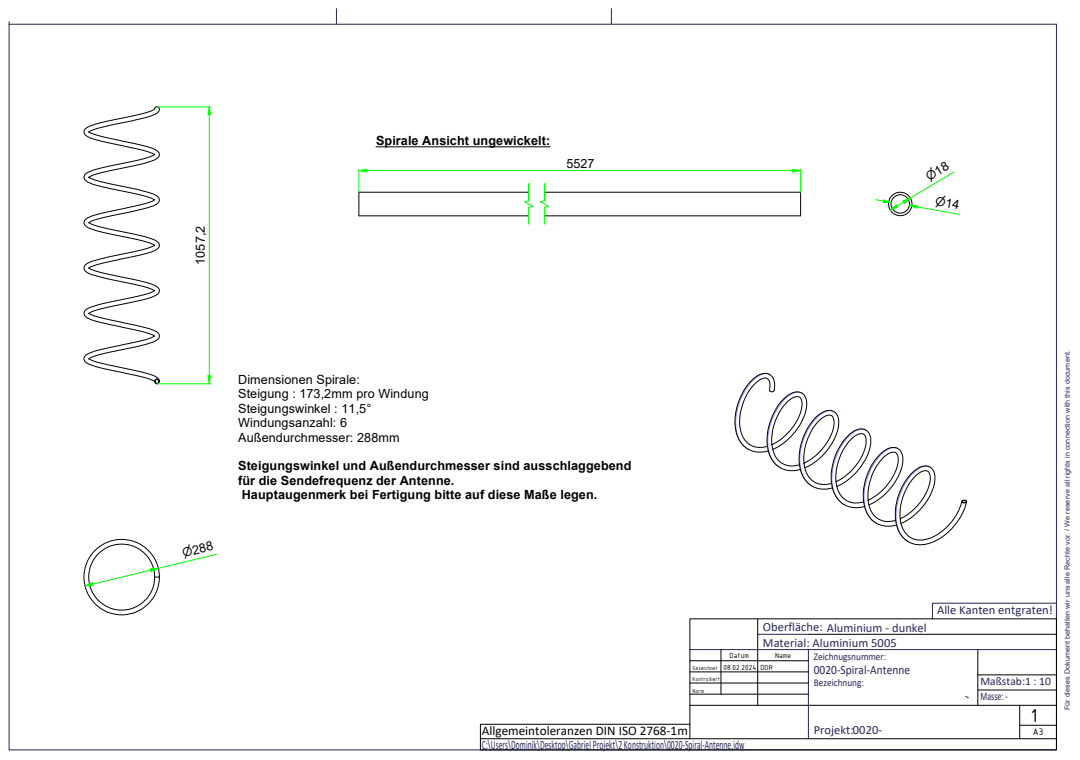
[picture p215: page 1]
Maßstab:1 : 10 Masse: -

Spirale Ansicht ungewickelt:

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

Dimensionen Spirale:
Steigung : 173,2mm pro Windung
Steigungswinkel : 11,5°
Windungsanzahl: 6
Außendurchmesser: 288mm

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

Alle Kanten entgraten!

Oberfläche: Aluminium - dunkel
Material: Aluminium 5005

Datum | Name | Zeichnugsnummer: 0020-Spiral-Antenne Bezeichnung:

Gezeichnet | 08.02.2024 | DOR

Kontrolliert

Norm

Projekt:0020- | 1

Allgemeintoleranzen DIN ISO 2768-1m | | | A3
C:\Users\Dominik\Desktop\Gabriel Projekt\2 Konstruktion\0020-Spiral-Antenne.idw
