Skh4rf/satNOGS/doc/ref/Anpasstopf-Innenleiter.pdf

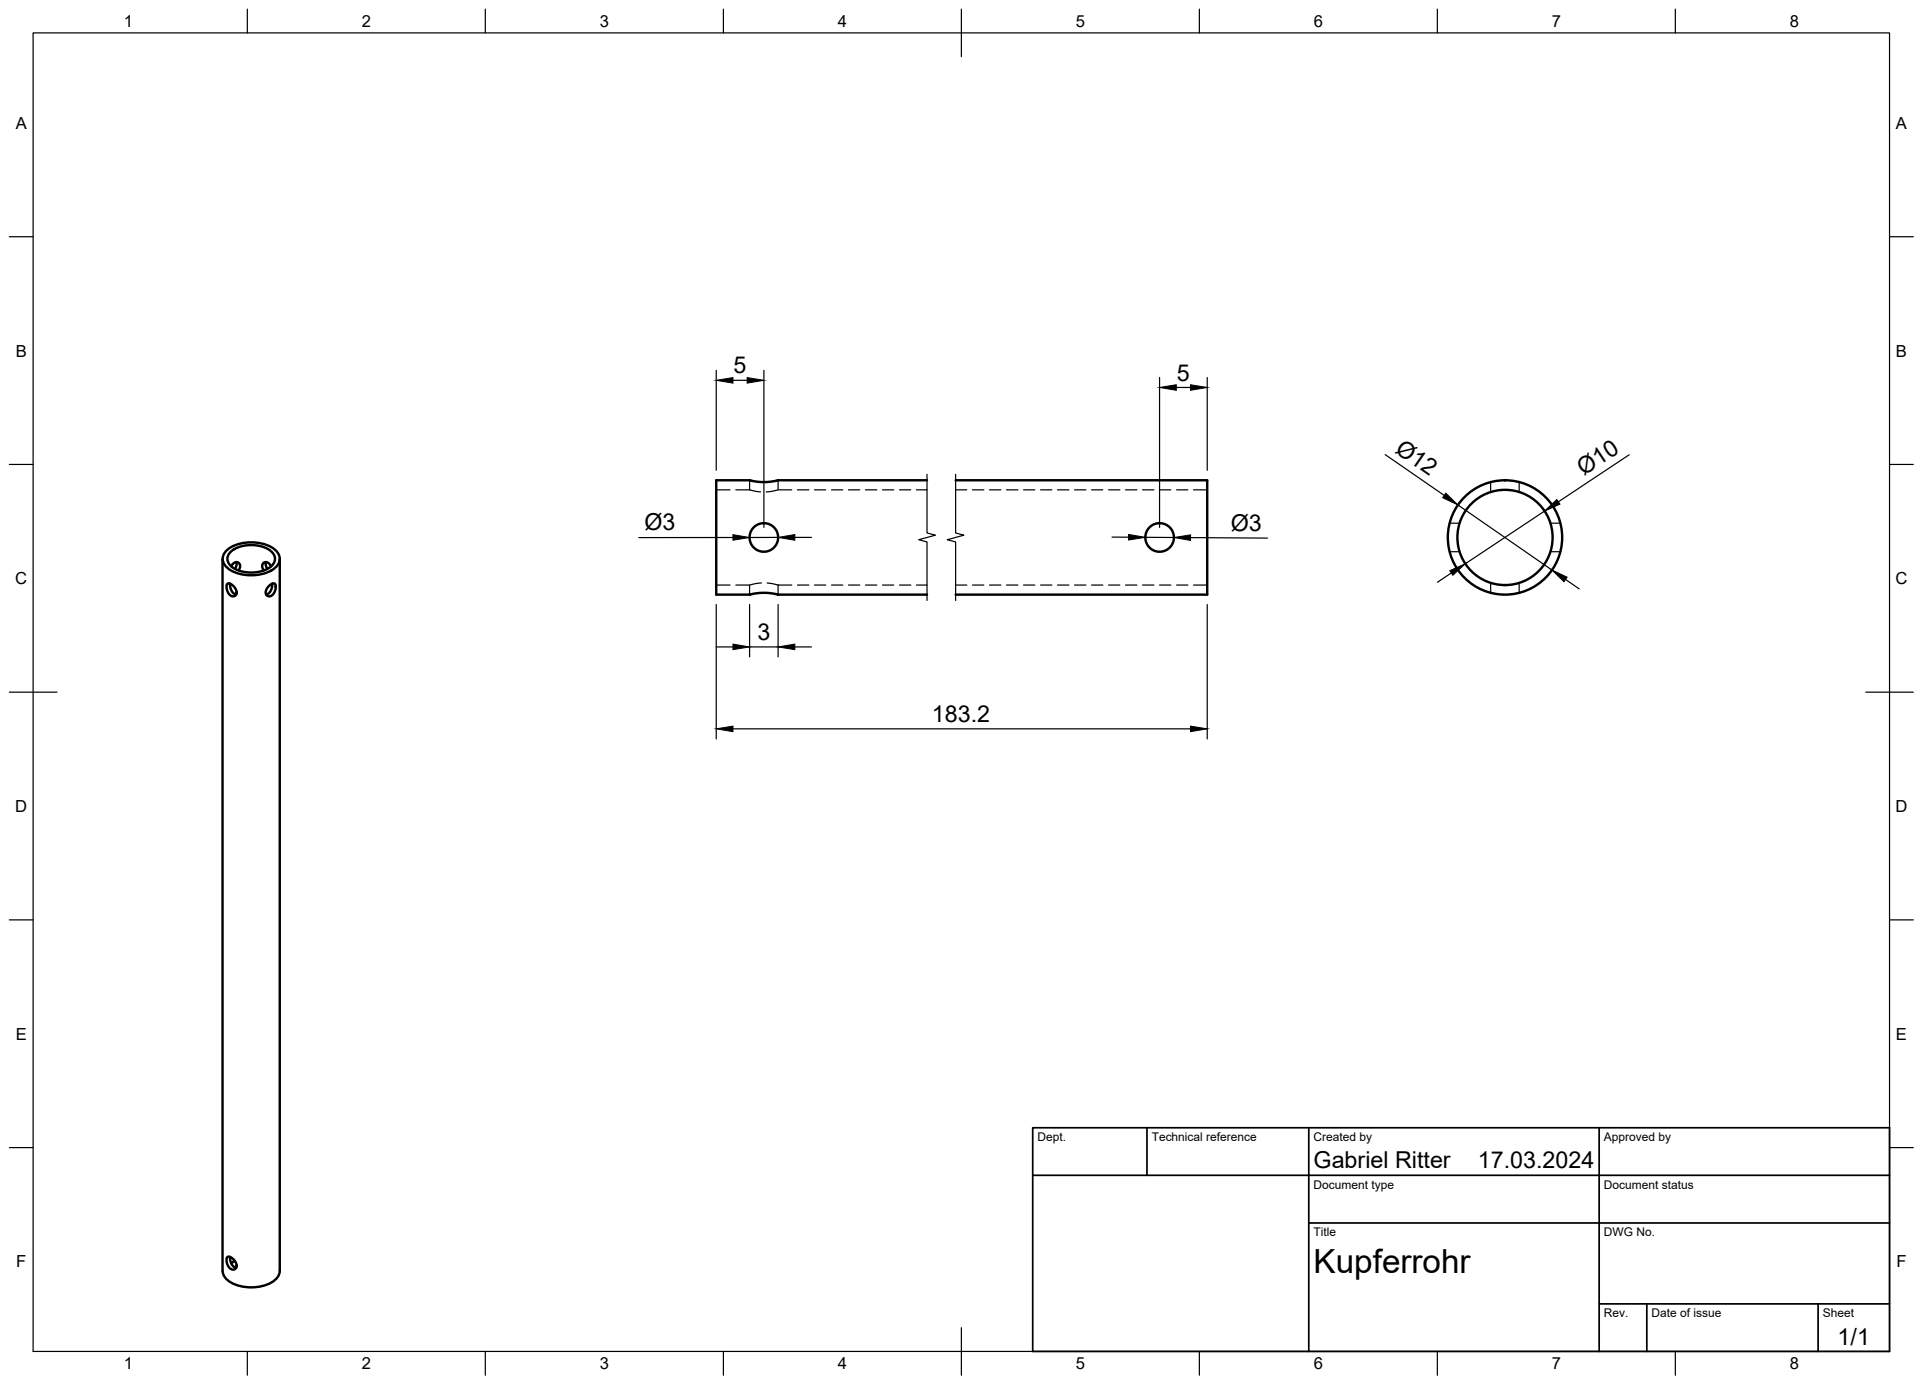
[picture p216: page 1]
Title; DWG No.; Rev.; Date of issue; Sheet

Dept. | Technical reference | Created by Gabriel Ritter 17.03.2024 | Approved by

Document type | Document status
