Skh4rf/satNOGS/doc/ref/Abstandhalter final Zeichnung v2.pdf

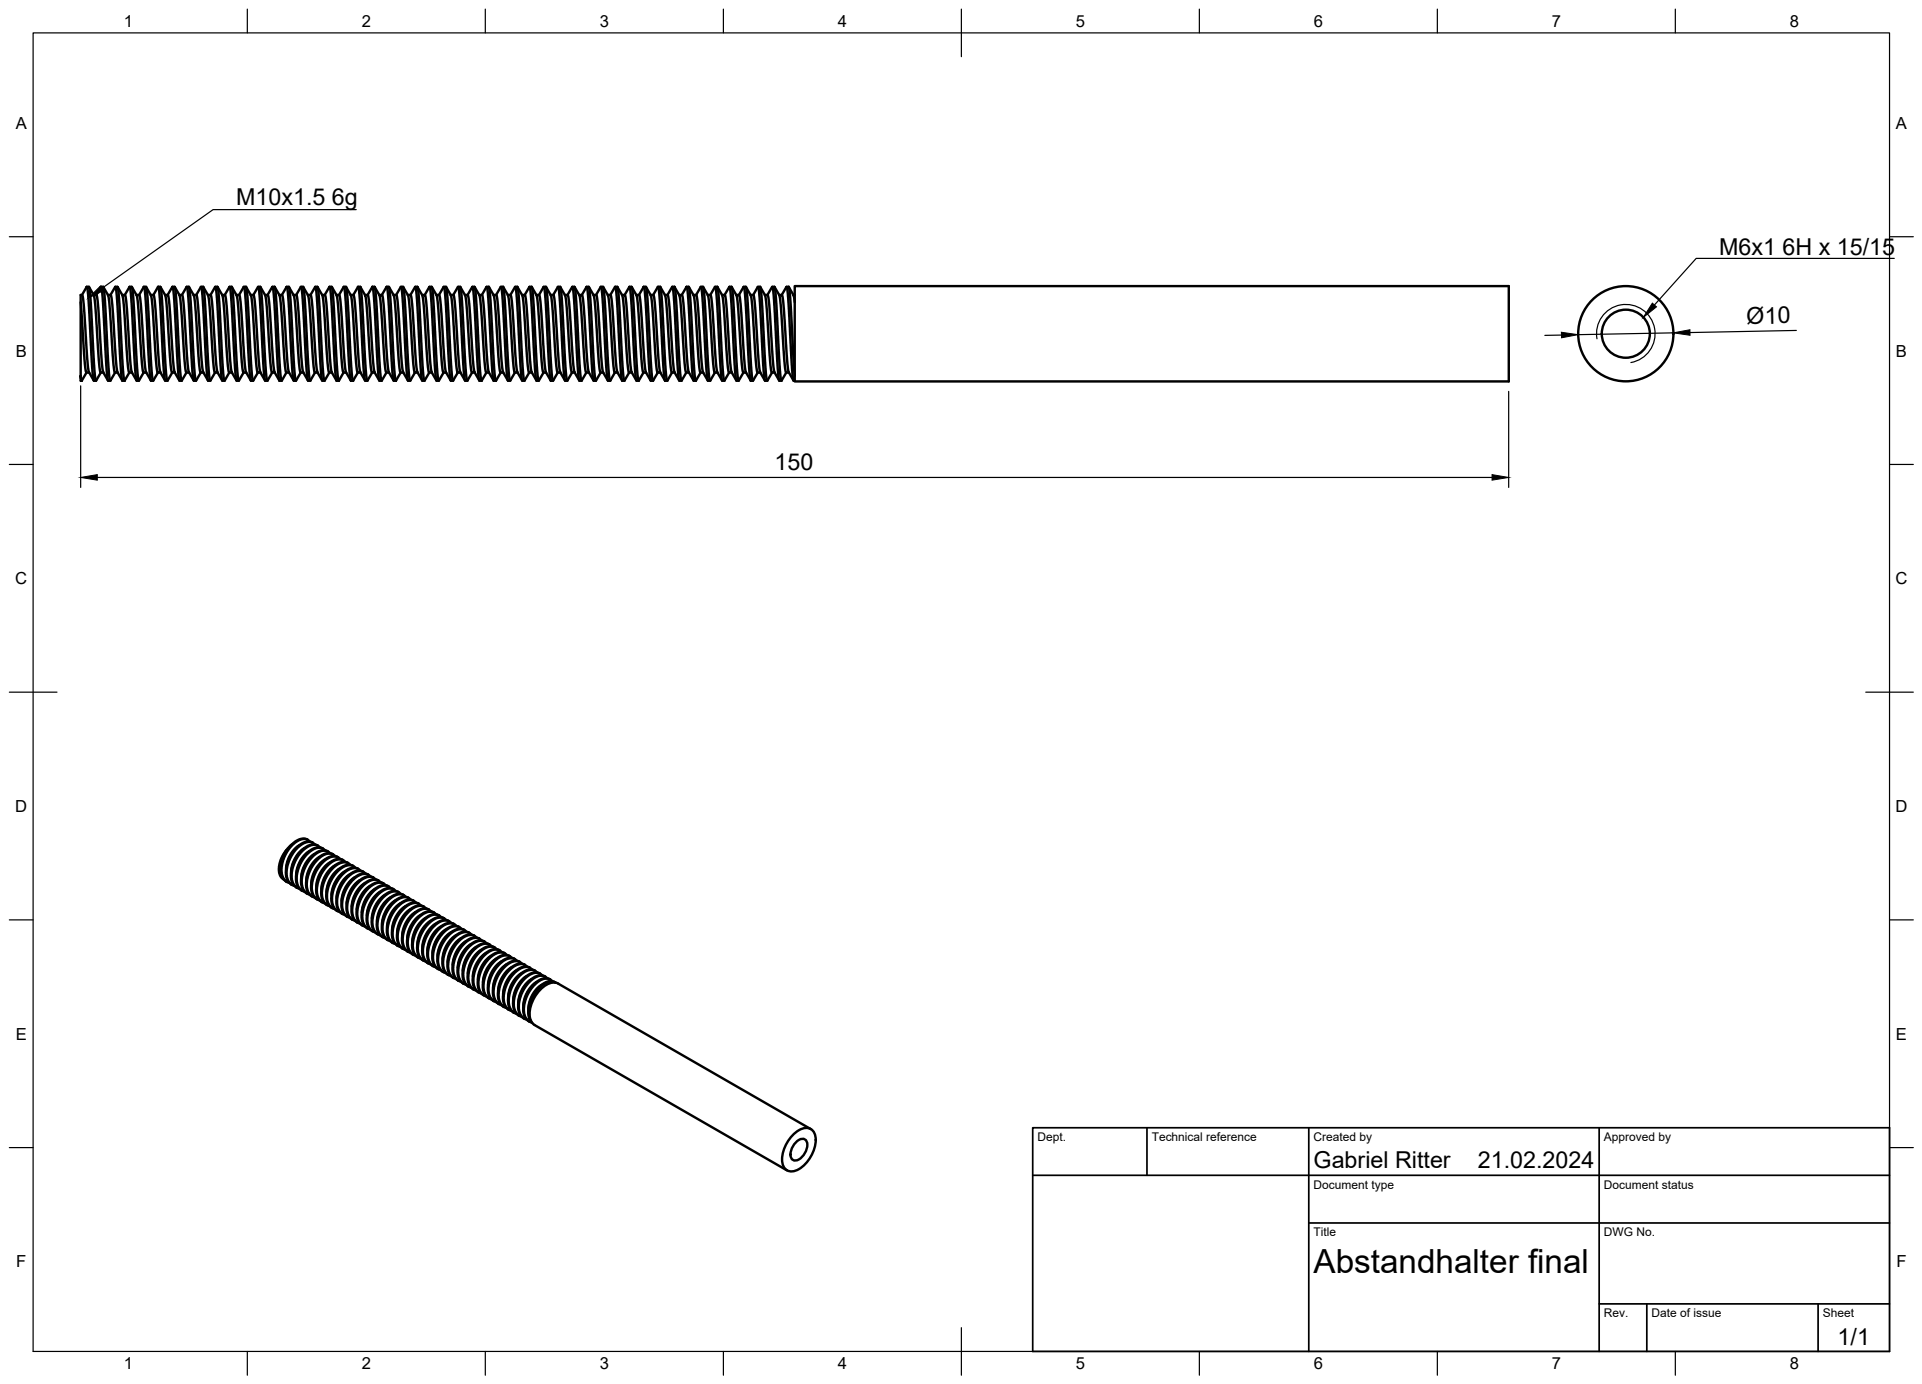
[picture p217: page 1]
Title; DWG No.; Rev.; Date of issue; Sheet; Abstandhalter final

Dept. | Technical reference | Created by Gabriel Ritter 21.02.2024 | Approved by

Document type | Document status
