Skh4rf/satNOGS/doc/ref/Isolierplatte.pdf

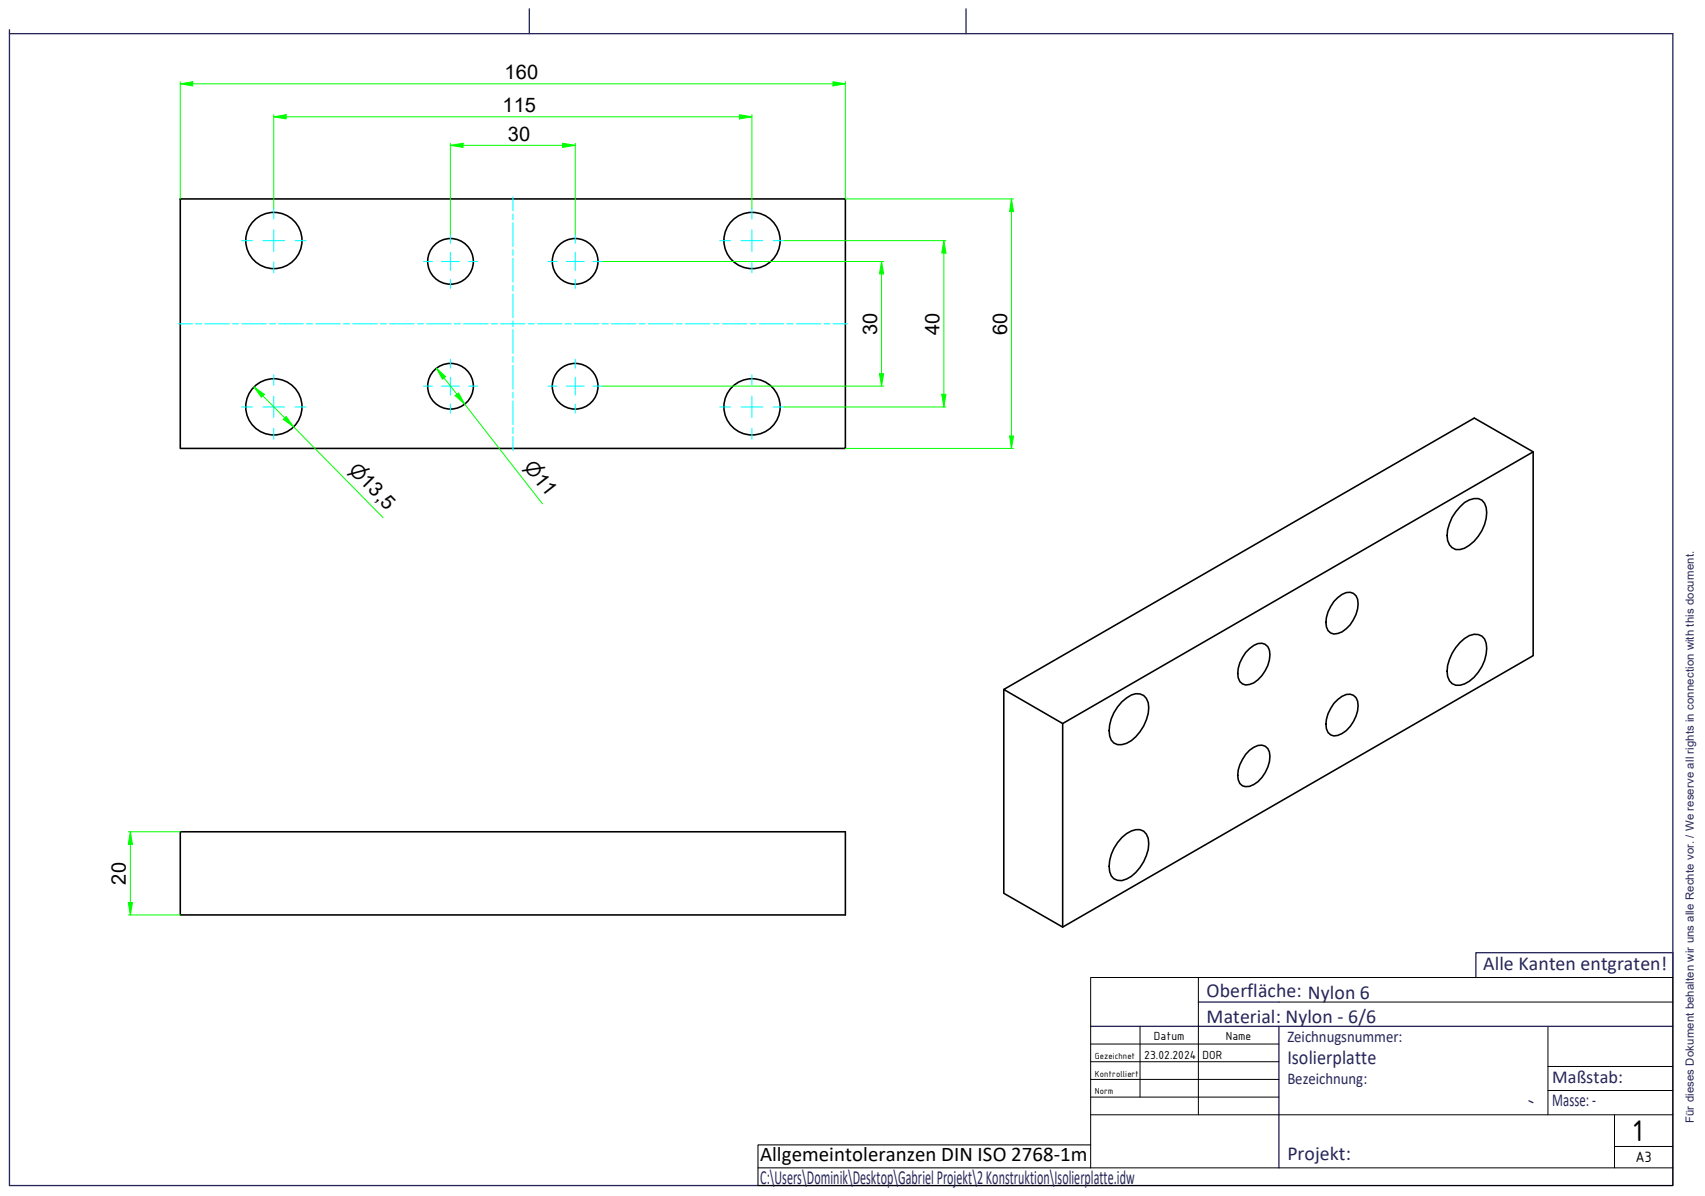
[picture p218: page 1]
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

K o n t r o l lie r t | | | r: Isolierplatte Bezeichnung: Allgemeintoleranzen DIN ISO 2768-1m

D a t u m | N a m e | Z eic h n u g s n u m m e

G e z eic h n e t | 2 3.0 2.2 0 2 4 | D O R

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
