Skh4rf/satNOGS/doc/ref/0000-Gesamtbaugruppe_Rahmen.pdf

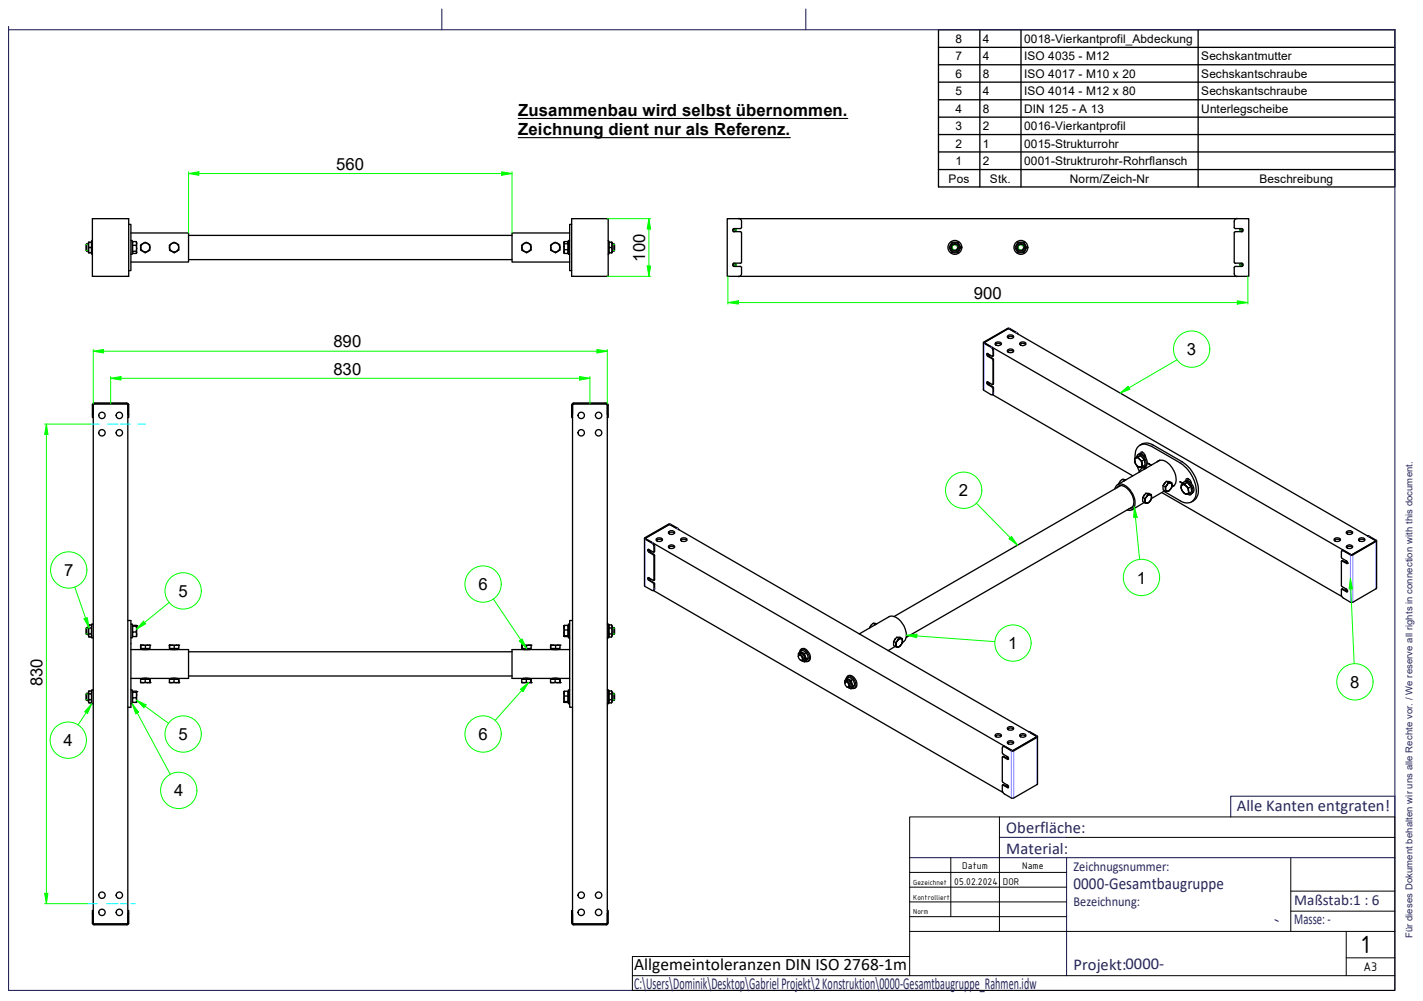
[picture p219: page 1]
Maßstab:1 : 6 Masse: -

8 | 4 | 0018-Vierkantprofil_Abdeckung
7 | 4 | ISO 4035 - M12 | Sechskantmutter
6 | 8 | ISO 4017 - M10 x 20 | Sechskantschraube
5 | 4 | ISO 4014 - M12 x 80 | Sechskantschraube
4 | 8 | DIN 125 - A 13 | Unterlegscheibe
3 | 2 | 0016-Vierkantprofil
2 | 1 | 0015-Strukturrohr
1 | 2 | 0001-Struktrurohr-Rohrflansch
Pos | Stk. | Norm/Zeich-Nr | Beschreibung

Zusammenbau wird selbst übernommen.
Zeichnung dient nur als Referenz.

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

Alle Kanten entgraten!

Datum | Name | Zeichnugsnummer: 0000-Gesamtbaugruppe Bezeichnung:

Gezeichnet | 05.02.2024 | DOR

Kontrolliert

Norm

Projekt:0000- | 1

Allgemeintoleranzen DIN ISO 2768-1m | | | A3
C:\Users\Dominik\Desktop\Gabriel Projekt\2 Konstruktion\0000-Gesamtbaugruppe_Rahmen.idw
