Skh4rf/satNOGS/doc/ref/0002-Antenne-Rohrflansch.pdf

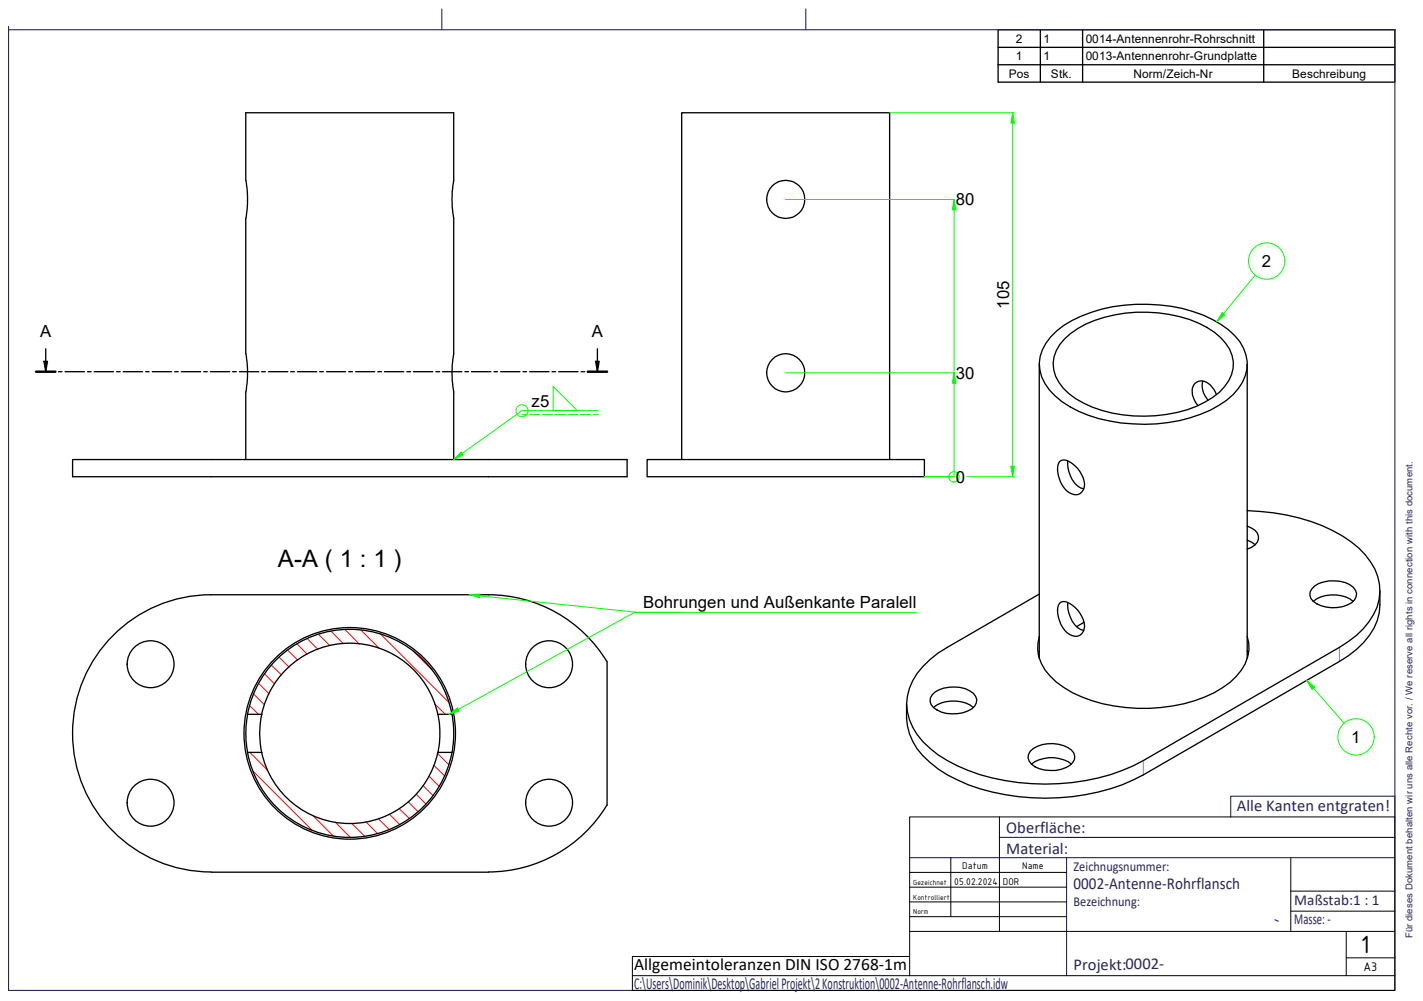
[picture p221: page 1]
Maßstab:1 : 1 Masse: -

2 | 1 | 0014-Antennenrohr-Rohrschnitt
1 | 1 | 0013-Antennenrohr-Grundplatte
Pos | Stk. | Norm/Zeich-Nr | Beschreibung

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

Bohrungen und Außenkante Paralell

Alle Kanten entgraten!

Datum | Name | Zeichnugsnummer: 0002-Antenne-Rohrflansch Bezeichnung:

Gezeichnet | 05.02.2024 | DOR

Kontrolliert

Norm

Projekt:0002- | 1

Allgemeintoleranzen DIN ISO 2768-1m | | | A3
C:\Users\Dominik\Desktop\Gabriel Projekt\2 Konstruktion\0002-Antenne-Rohrflansch.idw
