Skh4rf/satNOGS/doc/ref/0015-Strukturrohr.pdf

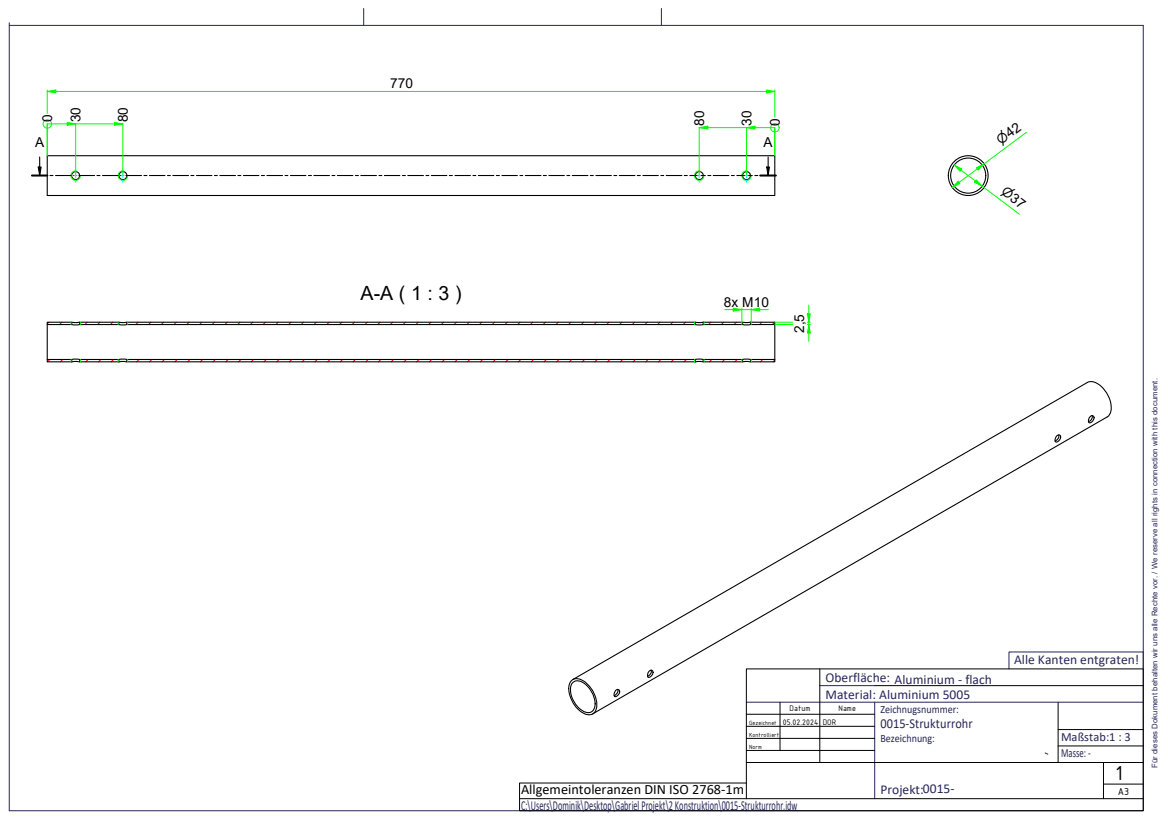
[picture p222: page 1]
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

G e z eic h n e t | 0 5.0 2.2 0 2 4 | D O R

g: Allgemeintoleranzen DIN ISO 2768-1m

K o n t r o l lie r t

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
