Skh4rf/satNOGS/(commit log)

2023-10-15 Doku Update + Papier über QFH
    Ein Papier über QFH (Abstrahlcharakteristiken, etc...) hinzugefügt sowie ein paar kleine Probleme bei der Dokumentation behoben
2023-12-18 Rotor-Abdeckung + Doku Update
    [Abdeckung+Rotor+Steuerung.stl, Dokumentation-wöchentlich.xlsx]
2024-02-16 Zeichnungen DA
    [0000-Gesamtbaugruppe.dxf, 0000-Gesamtbaugruppe.stp, 0000-Gesamtbaugruppe_Rahmen.dxf, 0001-Struktrurohr-Rohrflansch.dxf, 0001-Struktrurohr-Rohrflansch.stl, 0002-Antenne-Rohrflansch.dxf, 0002-Antenne-Rohrflansch.stl, 0003-Spiral-Antenne.dxf]
2024-02-18 Doku update (helix theorie)
    [Quellen.xlsx]
2024-02-19 Referenzen repariert
    [Quellen.xlsx]
2024-02-21 Helix-antenna theorie
2024-02-28 Adding azimut and elevation schematic
2024-02-28 Reworking Rotor-Chapter
2024-02-29 Adding Source for Rotor
2024-03-03 Updating Rotor Description
2024-03-05 Updating Rotor Documentation (Calibration)
2024-03-05 zusätzliche Dateien hinzugefügt
    [G-5500DC v4.step]
2024-03-12 Update Rotor
2024-03-13 Documentation for helix-antenna
2024-03-13 Updating Rotor
2024-03-14 Additions to helical antenna doc
2024-03-15 Updating Rotor and Mechanics
2024-03-18 Updating qfh-antenna
