Skh4rf/satNOGS/doc/ref/Befestigung-Querelement.jpg

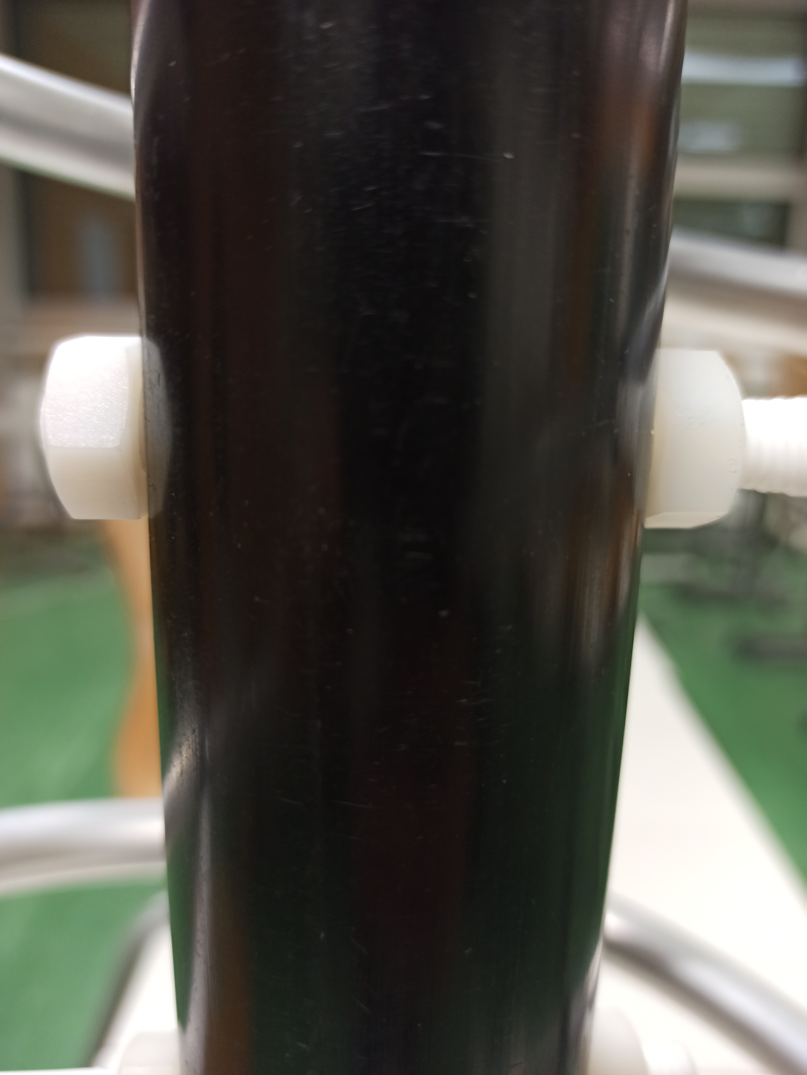
[picture p47: doc/ref/Befestigung-Querelement.jpg]
doc/ref/Befestigung-Querelement.jpg
