Skh4rf/satNOGS/doc/ref/Anschluss-unten.jpg

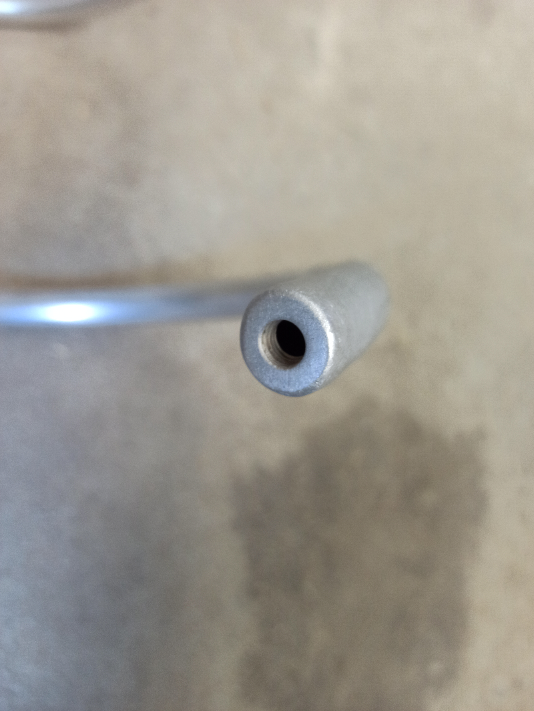
[picture p50: doc/ref/Anschluss-unten.jpg]
doc/ref/Anschluss-unten.jpg
