Skh4rf/satNOGS/doc/ref/Befestigung-Innenleiter.jpg

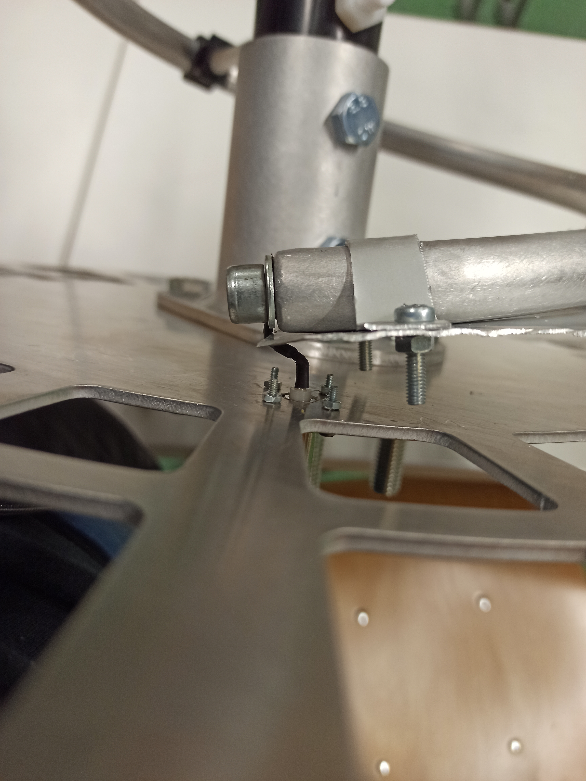
[picture p53: doc/ref/Befestigung-Innenleiter.jpg]
doc/ref/Befestigung-Innenleiter.jpg
